bespoke-silicon-group/bsg_motherboards/t_rex/README.md

This is the new T-Rex PCI-E attached ASIC motherboard. It uses a Kintex Ultrascale+ FPGA as host and uses the UW BGA Package.

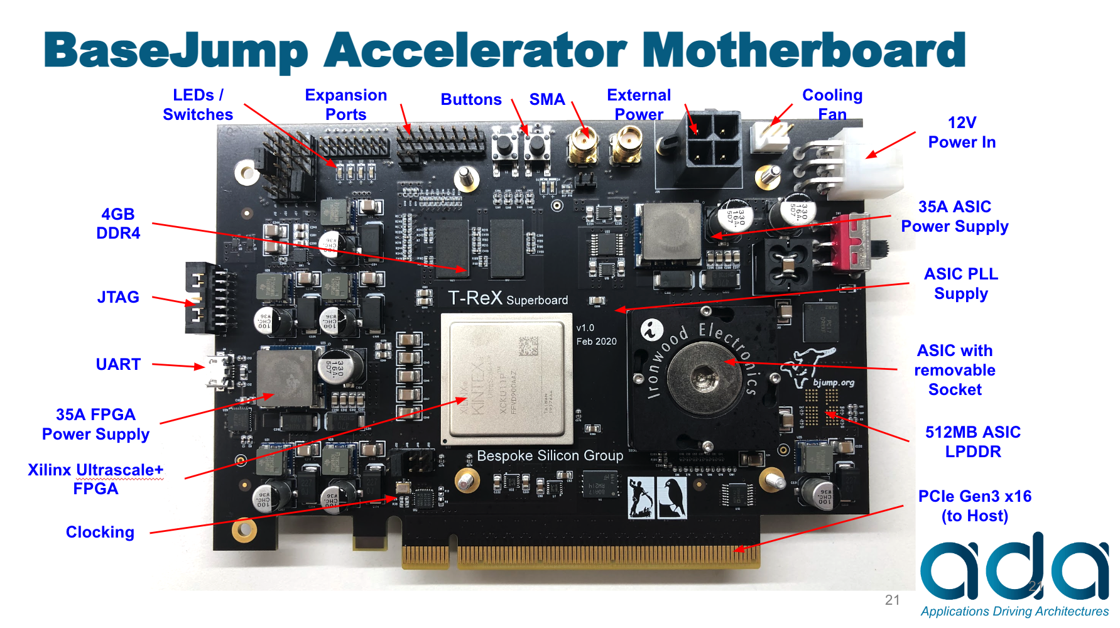
[picture p1: t_rex/t_rex_board.png]
T-Rex Board


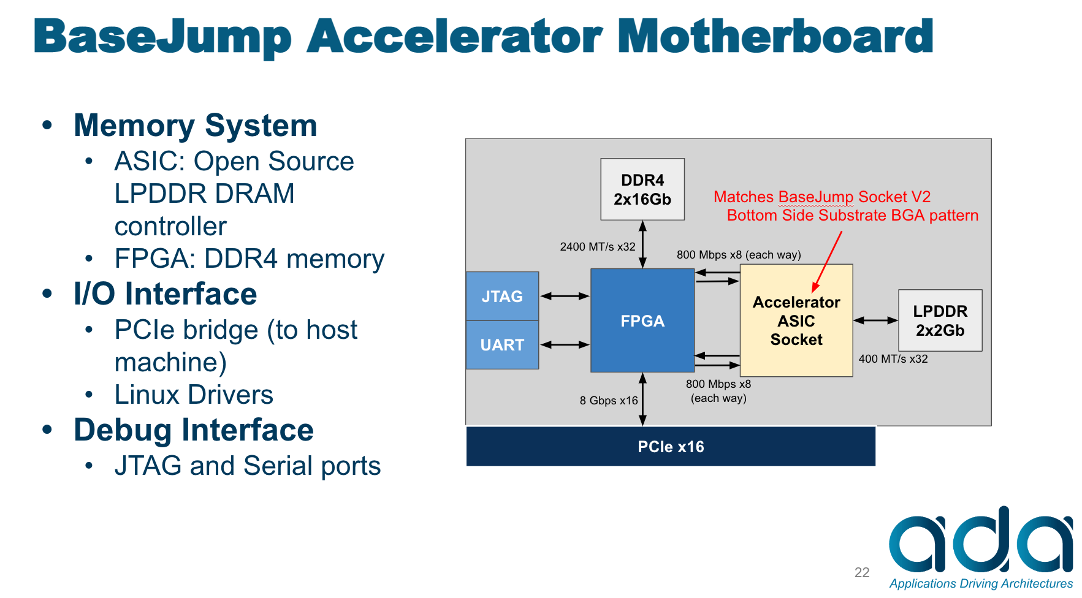
[picture p2: t_rex/t_rex_block_diagram.png]
T-Rex Block Diagram
