bespoke-silicon-group/bsg_motherboards/bsg_trouble/double_trouble/README.md

DoubleTrouble is a dual FPGA board, that allows you to emulate the RealTrouble FPGA board, which has an ASIC and Gateway FPGA, which was useful for debugging the I/O logic.

See [this link](https://docs.google.com/document/d/1EbtDtNUZuRYwq27lyGmmfNojYJZf2jZowkG6wCDKnSc/edit) for the DoubleTrouble design document.

See [this link](https://docs.google.com/spreadsheets/d/1v_qp4qbDF0bKDqPtvAs_vNdXaMVtJgvdCSDbODfMDFM/edit#gid=1929442910) for the DoubleTrouble Spartan-6 ballouts.

See [this link](https://docs.google.com/document/d/1Ep6X8bA8dowjrU25qXct05PboRLQDkasHA3pl3u8kH0/edit#heading=h.3fah60838dlg) for notes on firmware design.

See [this link](https://docs.google.com/document/d/1RrP9torYVqvp9zgF8nX2fYvYWnBSqGglMHzzH0_2e-s/edit#heading=h.7lagbxxd2hqg) for notes on bootstrapping the first board.

Two versions of the DoubleTrouble board were done. The first version used a 10-layer PCB and had some power integrity based limits on performance. The second version used a 14-layer PCB and optimized capacitor placement and had an improved stackup.

See [this link](https://github.com/bespoke-silicon-group/basejump_stl/issues/430) for some recent user's observations of making this board.
