bespoke-silicon-group/bsg_motherboards/bsg_trouble/super_trouble/pics/README.md

This is a picture of SuperTrouble V1, which implements Socket 352 that is mapped onto the DARPA CRAFT 600+ pin FC-BGA (flip chip BGA) package.
SuperTrouble V2 is a revision of V1, with a 30A power supply.
