bespoke-silicon-group/bsg_motherboards/t_rex/v1/misc_docs/README

1. The solder ball size information in PDF file is outdated, please refer to "New Ball Size.PNG" for the most up-to-date info. (Different IC-Frame is needed for new solder ball size)
2. The torque information in PDF file is outdated, please refer to "New Torque.png" for updated torque info.
