bespoke-silicon-group/bsg_motherboards/bsg_trouble/real_trouble/misc_docs/352_bga_pins_top_down_flat_Paul_Gao_updated.pdf

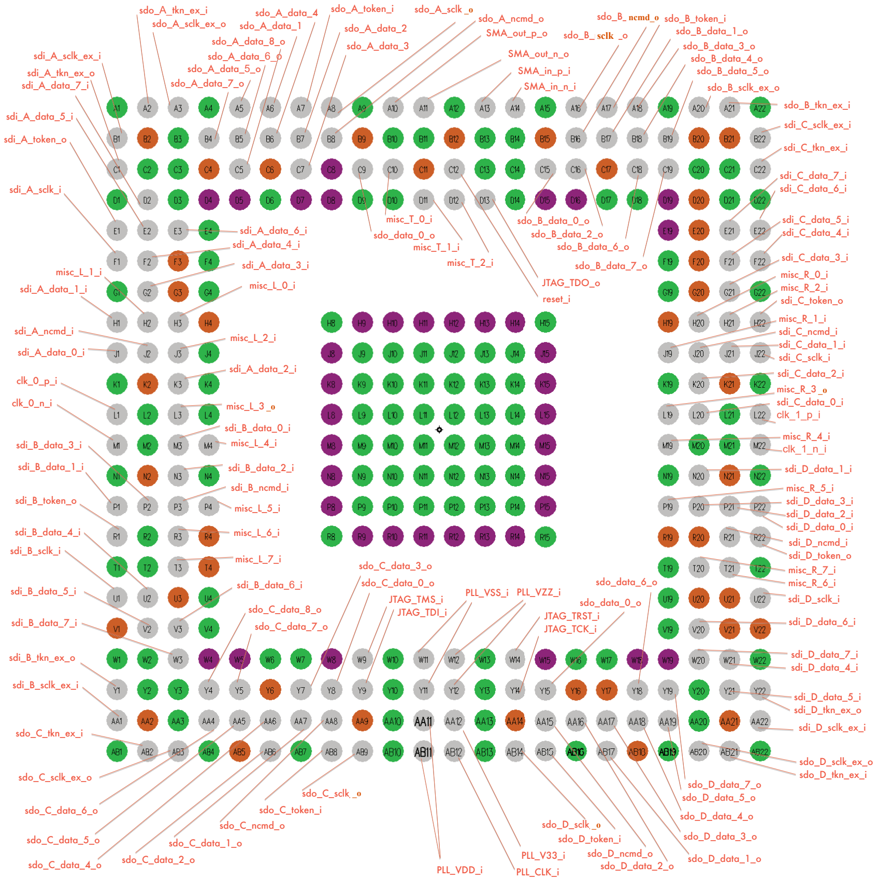
[picture p3: page 1]

sdo_B_tkn_ex_i
sdi_C_sclk_ex_i

sdi_C_tkn_ex_i

sdi_C_data_7_i
sdi_C_data_6_i

sdi_C_data_5_i
sdi_C_data_4_i

sdi_C_data_3_i
misc_R_0_i
misc_R_2_i
sdi_C_token_o
misc_R_1_i
sdi_C_ncmd_i
sdi_C_data_1_i
sdi_C_sclk_i
sdi_C_data_2_i
misc_R_3_i
sdi_C_data_0_i
clk_1_p_i

misc_R_4_i
clk_1_n_i
sdi_D_data_1_i
misc_R_5_i
sdi_D_data_3_i
sdi_D_data_2_i
sdi_D_data_0_i
sdi_D_ncmd_i
sdi_D_token_o
misc_R_7_i
misc_R_6_i
sdi_D_sclk_i

sdi_D_data_6_i

sdi_D_data_7_i
sdi_D_data_4_i

sdi_D_data_5_i
sdi_D_tkn_ex_o
sdi_D_sclk_ex_i

sdo_D_sclk_ex_o
sdo_D_tkn_ex_i

sdo_C_data_7_o

sdo_C_data_8_o

sdo_data_6_o
sdo_data_0_o
JTAG_TRST_i
JTAG_TCK_i

PLL_VSS_i PLL_VZZ_i JTAG_TMS_i JTAG_TDI_i

sdo_C_data_0_o

sdo_C_data_3_o

sdo_D_data_7_o
sdo_D_data_5_o

sdo_B_data_7_o

sdo_B_data_6_o

sdo_B_data_2_o

sdo_B_data_0_o

sdo_B_sclk_ex_o

sdo_B_data_3_o

sdo_B_data_5_o

sdo_B_data_4_o

sdo_B_data_1_o

sdo_B_token_i
sdo_B_ncmd_o

sdo_B_sclk_i

SMA_in_n_i

SMA_in_p_i

SMA_out_n_o

SMA_out_p_o

sdo_A_sclk_i
sdo_A_ncmd_o

sdo_A_token_i
sdo_A_data_2
sdo_A_data_3

sdo_A_data_4
sdo_A_data_1

sdo_A_data_6_o

sdo_A_data_8_o

sdo_A_data_5_o
sdo_A_data_7_o

sdo_A_sclk_ex_o

sdo_A_tkn_ex_i

JTAG_TDO_o
reset_i

misc_T_2_i

misc_T_1_i

misc_T_0_i
sdo_data_0_o

sdi_A_sclk_ex_i
sdi_A_tkn_ex_o
sdi_A_data_7_i

sdi_A_data_5_i

sdi_A_token_o

sdi_A_data_6_i
sdi_A_data_4_i

sdi_A_sclk_i

sdi_A_data_3_i

sdi_A_data_1_i

misc_L_1_i
misc_L_0_i

misc_L_2_i sdi_A_ncmd_i
sdi_A_data_0_i
sdi_A_data_2_i
clk_0_p_i
clk_0_n_i | misc_L_3_i
| misc_L_4_i

sdi_B_data_0_i

sdi_B_data_2_i

sdi_B_data_3_i

sdi_B_data_1_i
sdi_B_ncmd_i
misc_L_5_i sdi_B_token_o

misc_L_6_i
misc_L_7_i sdi_B_sclk_i

sdi_B_data_4_i

sdi_B_data_5_i | sdi_B_data_6_i

sdi_B_data_7_i

sdi_B_tkn_ex_o

sdi_B_sclk_ex_i

sdo_C_tkn_ex_i

sdo_C_sclk_ex_o

sdo_C_data_6_o

sdo_C_data_5_o
sdo_C_data_4_o sdo_C_data_2_o sdo_C_data_1_o

sdo_C_ncmd_o

sdo_C_token_i

sdo_C_sclk_i

sdo_D_data_4_o
sdo_D_data_3_o

sdo_D_data_1_o sdo_D_data_2_o

sdo_D_ncmd_o

sdo_D_token_i

sdo_D_sclk_i

PLL_CLK_i

PLL_V33_i
PLL_VDD_i
