bespoke-silicon-group/bsg_motherboards/bsg_trouble/double_trouble/pics/DoubleTroubleV1.2_crop.jpg

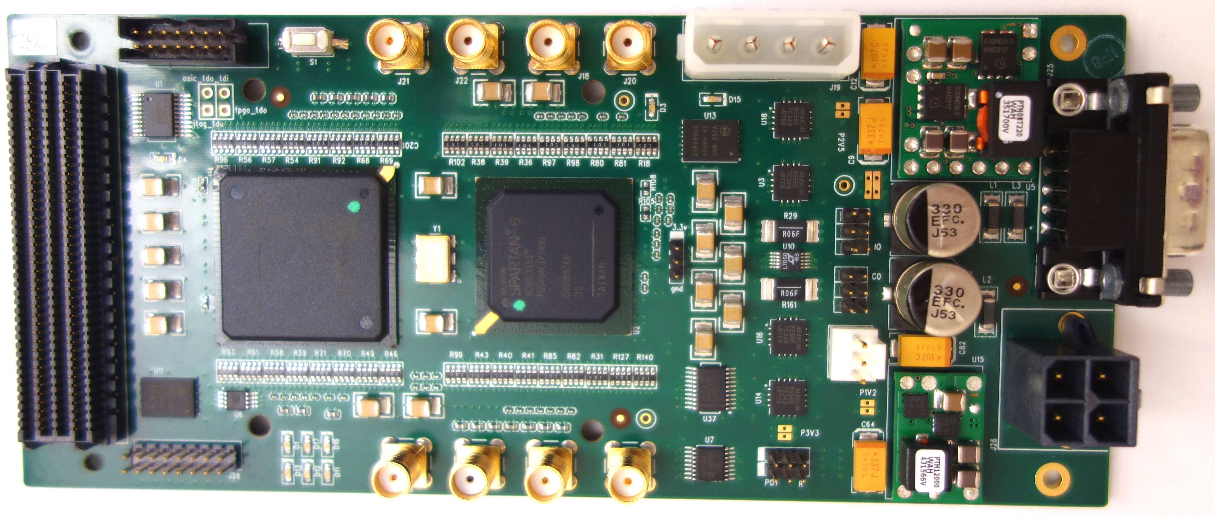
bsg_trouble/double_trouble/pics/DoubleTroubleV1.2_crop.jpg
