bespoke-silicon-group/bsg_motherboards/bsg_trouble/double_trouble/pics/IMG_20151016_153808970_HDR.jpg

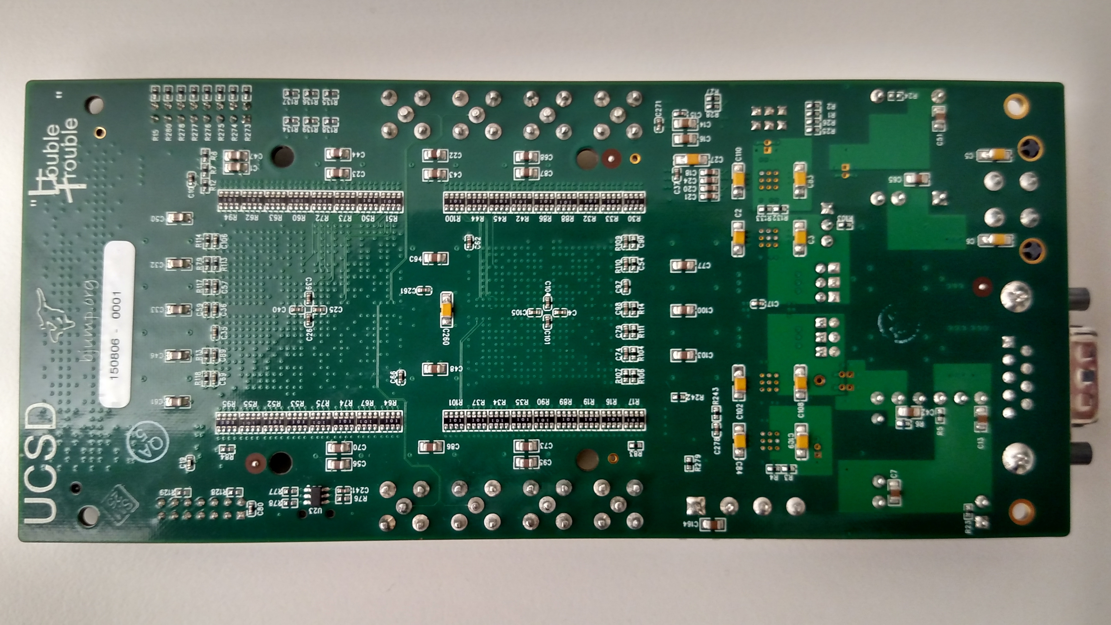
bsg_trouble/double_trouble/pics/IMG_20151016_153808970_HDR.jpg
