bespoke-silicon-group/bsg_motherboards/bsg_trouble/real_trouble/pics/real_trouble_board.jpg

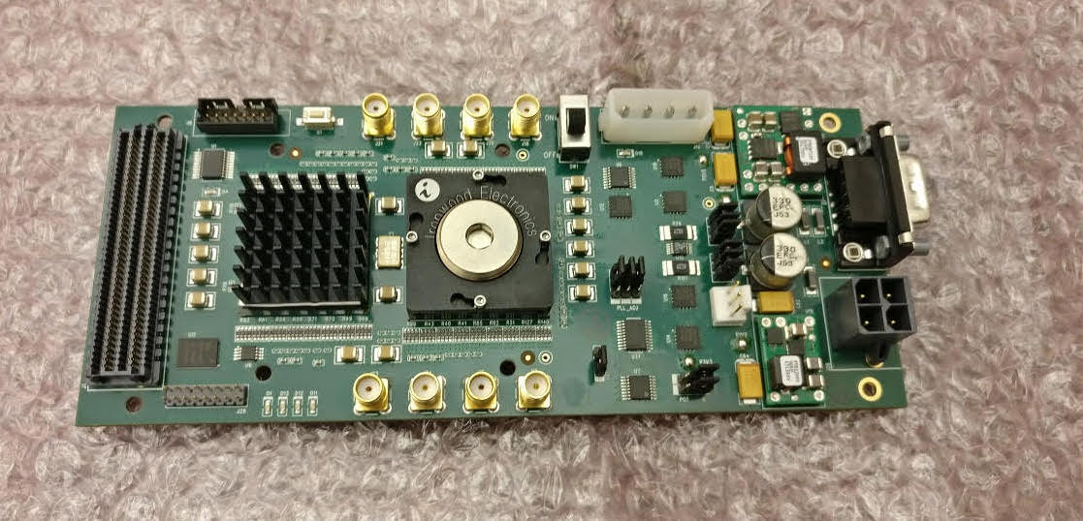
bsg_trouble/real_trouble/pics/real_trouble_board.jpg
