bespoke-silicon-group/bsg_motherboards/bsg_trouble/super_trouble/pics/IMG_20180105_175012.jpg

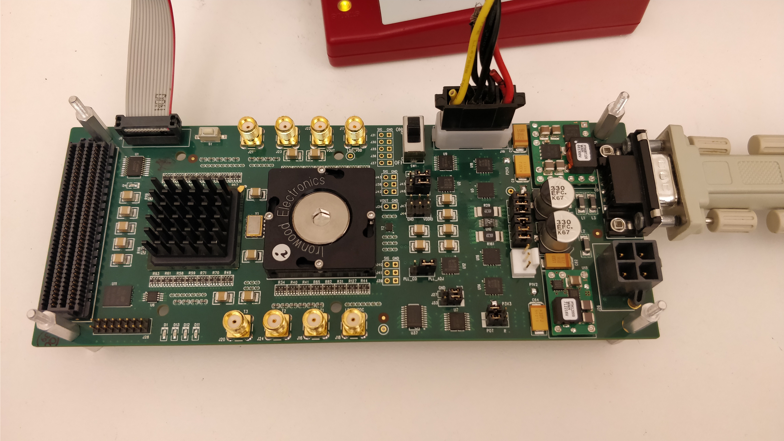
bsg_trouble/super_trouble/pics/IMG_20180105_175012.jpg
