bespoke-silicon-group/bsg_motherboards/t_rex/v1/misc_docs/New Ball Size.PNG

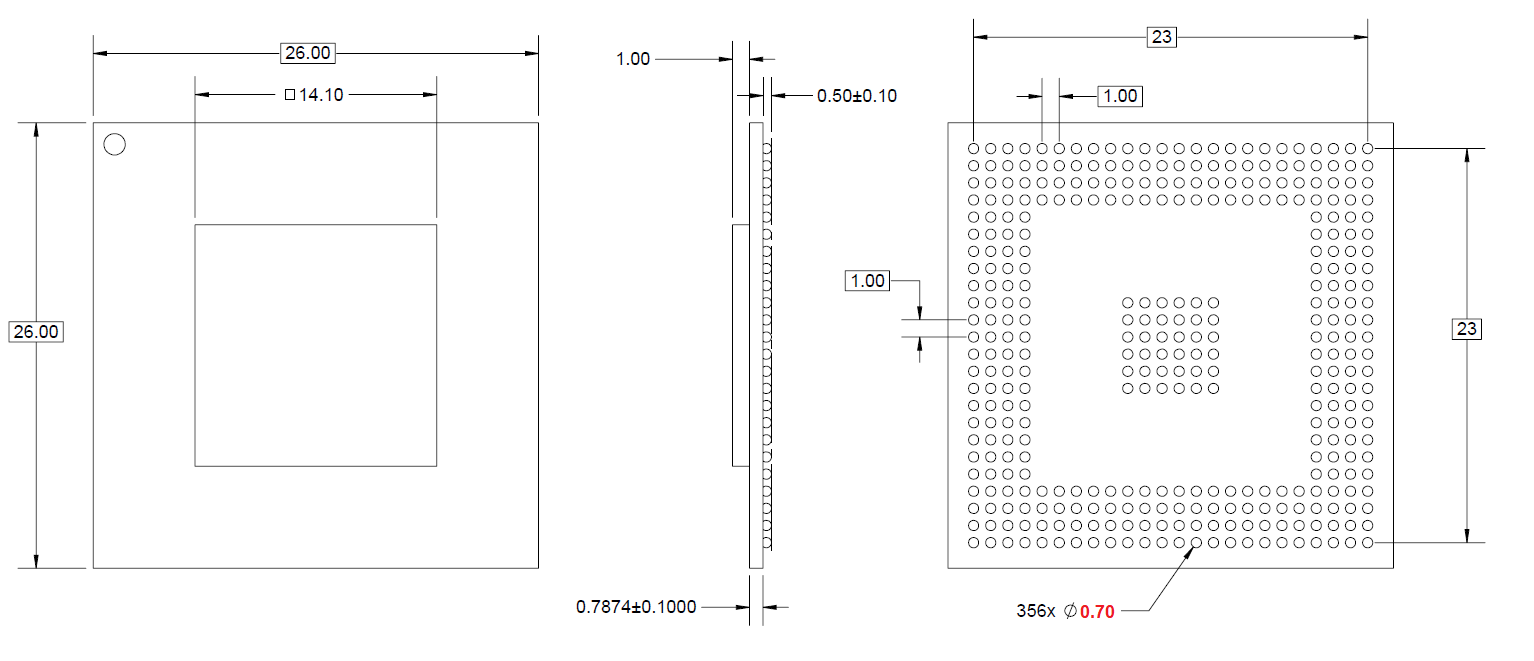
t_rex/v1/misc_docs/New Ball Size.PNG
