bespoke-silicon-group/bsg_motherboards/t_rex/v1/misc_docs/New Torque.png

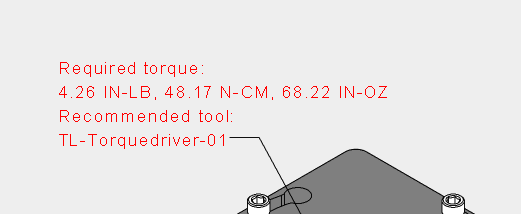
t_rex/v1/misc_docs/New Torque.png
