bespoke-silicon-group/bsg_motherboards/t_rex/v1/pcb_development/pcb_fabrication/pcie finger mechanical.PNG

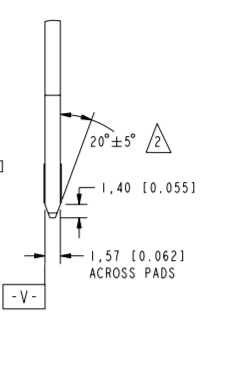
t_rex/v1/pcb_development/pcb_fabrication/pcie finger mechanical.PNG
