bespoke-silicon-group/bsg_motherboards/t_rex/v1/pcb_development/pcb_fabrication/IMPEDANCE.xlsx

Layer Name | Ref Layer Name | Diff or single-ended | Trace Width (mil) | Number of Single Traces | Number of Diff Pairs | Target Value (ohm +-10%) | Single-ended clearance (mil) | Diff Spacing (mil)
Layer 1 (top) | Layer 2 (GND) | diff (Gold Finger) | 4.94 |  | 16 | 85 |  | 7
Layer 3 | Layer 2 and Layer 4 (GND and GND) | single | 3.97 | 44 |  | 50 | 6
 |  |  | 5.97 | 25 |  | 39 | 8
 |  |  | 6.47 | 8 |  | 36 | 9
 |  | diff | 3.94 |  | 17 | 86 |  | 4
 |  |  | 4.94 |  | 17 | 85 |  | 7
 |  |  | 5.94 |  | 0 | 76 |  | 6
Layer 5 | Layer 4 and Layer 6 (GND and GND) | single | 3.97 | 46 |  | 50 | 6
 |  |  | 5.97 | 16 |  | 39 | 8
 |  |  | 6.47 | 7 |  | 36 | 9
 |  | diff | 3.94 |  | 2 | 100 |  | 6
 |  |  | 3.94 |  | 0 | 86 |  | 4
 |  |  | 4.94 |  | 0 | 85 |  | 7
 |  |  | 5.94 |  | 1 | 76 |  | 6
Layer 10 | Layer 9 and Layer 11 (GND and GND) | single | 3.97 | 59 |  | 50 | 6
 |  |  | 5.97 | 16 |  | 39 | 8
 |  |  | 6.47 | 7 |  | 36 | 9
 |  | diff | 3.94 |  | 21 | 86 |  | 4
 |  |  | 4.94 |  | 16 | 85 |  | 7
 |  |  | 5.94 |  | 2 | 76 |  | 6
Layer 12 | Layer 11 and Layer 13 (GND and GND) | single | 3.97 | 44 |  | 50 | 6
 |  |  | 5.97 | 5 |  | 39 | 8
 |  |  | 6.47 | 6 |  | 36 | 9
 |  | diff | 3.94 |  | 1 | 100 |  | 6
 |  |  | 3.94 |  | 2 | 86 |  | 4
 |  |  | 4.94 |  | 0 | 85 |  | 7
 |  |  | 5.94 |  | 3 | 76 |  | 6
Layer 14 (bot) | Layer 13 (GND) | diff (Gold Finger) | 4.94 |  | 17 | 85 |  | 7
Single Ended Traces |  |  | Total Single | 283
3.97 mil | 50 ohm +-10% |  | Total 50 ohm | 193
5.97 mil | 39 ohm +-10% |  | Total 39 ohm | 62
6.47 mil | 36 ohm +-10% |  | Total 36 ohm | 28
Differential Pairs |  |  | Total Diff Pairs |  | 115
3.94/6/3.94 | 100 ohm +-10% |  | Total 100 ohm |  | 3
3.94/4/3.94 | 86 ohm +-10% |  | Total 86 ohm |  | 40
4.94 mil | 85 ohm +-10% |  | Total 85 ohm |  | 66
5.94 mil | 76 ohm +-10% |  | Total 76 ohm |  | 6
