bespoke-silicon-group/bsg_motherboards/(threads)

Thread 1 (2021-07-12):

Logic/Schematics files for Altium

yunusdawji, 2021-07-12:
Hi,

I am trying to import the schematics for double trouble. I was able to import ASC file in altium but I cannot import the schematic. Would you be able to share the schematic file form mentor pads with us?

Thanks

gaozihou, 2021-07-12:
Does this work for Altium import? https://github.com/bespoke-silicon-group/bsg_motherboards/blob/master/bsg_trouble/double_trouble/pcb_development/pcb_design/DaughterBoards_2016.sch

yunusdawji, 2021-07-12:
Hi Paul,

Thanks for reply. I am trying to import it to Altium and it only accepts .txt logic file for mentor pads. Is there a different way to export logical files in Mentor graphics pads?

Yunus

gaozihou, 2021-07-13:
Thanks Yunus! Interesting that Altium only accepts txt format..

I added the txt here: https://github.com/bespoke-silicon-group/bsg_motherboards/blob/master/bsg_trouble/double_trouble/pcb_development/pcb_design/DaughterBoards_2016.txt

Closed 2021-07-13.

Thread 2 (2021-08-06):

RealTrouble U8 not listed in BOM (Ironwood Socket for ASIC), flash chip, and C27 Q.

cmcjames, 2021-08-06:
Hello,

**Question 1-**
We are basing our design on RealTrouble and while socket U8 is shown in the schematic page 2 of 18, bottom right, I do not see it in the Bill of Materials.  Our die and package is based on BSG_332.

What is the Ironwood part number for the socket?
Do we need any special permission from BaseJump to have Ironwood manufacture the socket for us?

**I see this picture for the ASIC pins, a 22x22 array**:
_https://github.com/bespoke-silicon-group/bsg_packaging/blob/master/ucsd_bga_332/pcb/352_bga_pins_top_down_flat.pdf_
and I can’t find the Ironwood socket to match. **I only see this Ironwood SG-BGA676 socket, which is 26x26pins**.
_https://raw.githubusercontent.com/bespoke-silicon-group/bsg_motherboards/master/bsg_trouble/super_trouble_v2/misc_docs/C17099%20Dwg.pdf_

I assume the 26x26 pin socket is not for the 22x22 pin ASIC array.

Question 2-
We need to substitute the flash chip. The original chip is: M25P128-VME6TGB and thank you for recommending to my colleague for the DT board MT25QL128ABA1EW9-0SIT.  The first is obsolete and the second is now out of stock. I’ve asked Micron, but they haven’t returned my request for a replacement part number.
Assuming I require the following characteristics: _NOR-Flash, 128Mb as 16Mx8, SPI interface, 2.7-3.6V, surface mount, in-stock, ROHS, (original F=54MHz, original write cycle time: 15ms, 5ms)_, it seems there aren’t any Micron parts. There are parts from  _Macronix_, I do not know if their parts are fully compatible. We can handle a footprint change at this time, but we are hoping we won’t need to change the gateway FPGA code. The Macronix parts in stock that fit the bill are: MX25L12835FM2I-10G, MX25L12835FMI-10G, MX25L12835FZNI-10G and links to each of those come up in [this digikey search](https://www.digikey.ca/en/products/filter/memory/774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). _Would you recommend any one of those?_

Question 3 (out of curiosity)-
C27 is a 10UF tantalum capacitor in parallel with C37 a 0.1UF capacitor by the serial port’s MAX322EEUP. The MAX322 datasheet requires the 0.1UF capacitor and nothing more.  What is the reason the team decided to include a large tantalum capacitor as well?

Question 4: What is the proper way to acknowledge the BSG group?  (sorry, I don't see a group for this topic!)

taylor-bsg, 2021-08-07:
Ironwood:

https://github.com/bespoke-silicon-group/bsg_packaging/tree/master/ucsd_bga_332/pcb/for_socket_maker_ironwood
part number is C16459

taylor-bsg, 2021-08-07:
@gaozihou may be able to answer #2 and #3

#4: "Our system employs the BaseJump Socket 332, BaseJump RealTrouble motherboard, and firmware, designed by the UW Bespoke Silicon Group, available at http://bjump.org."

gaozihou, 2021-08-08:
Hi @cmcjames,

Q1. More information can be found here: https://github.com/bespoke-silicon-group/bsg_motherboards/blob/master/bsg_trouble/real_trouble/misc_docs/C16459_PCB%20Layout.PDF

Q2. The real question is "which NOR flash devices can be indirectly programmed by the iMPACT tool through a Spartan-6 device". You could refer to the Xilinx Q&A: https://www.xilinx.com/support/answers/70681.html (also mentioned here: https://github.com/bespoke-silicon-group/basejump_stl/issues/430). From my understanding, Macronix would work but it does not have as much software support (iMPACT tool) as Micron devices. In general I would suggest continue using Micron chips to make flash programming process simpler.

I understand it is hard to find chips in stock due to the global chip shortage.. I found this on digikey which should be a proper replacement: https://www.digikey.com/en/products/detail/micron-technology-inc/N25Q128A13EF840E/13167381

Q3. I guess it is just a conservative design to ensure VDD is clean.

cmcjames, 2021-08-09:
Thank you very much everyone for your timely response!  It's much appreciated!
I'll have to place our Ironwood and Digikey orders soon.
Regarding Q2: Macronix got back to me with some replacement parts. They do mention challenges with respect to programming with the Xilinx iMPACT tools and they have provided some suggestions to make things work.  The link provided didn't work for me, but a search on a subset of the part number did, it seems a Digikey marketplace reseller, _Flip Electronics_, has that particular replacement in stock so thank you very much!

Closed 2021-08-09.

Thread 5 (2022-02-22):

Real Trouble Through-Hole Plating

abeyene, 2022-02-22:
Hi,

I've received a query from my PCB manufacturer about whether a particular through-hole on Real Trouble is plated or not. A copper pad exists in the copper layer but a table description for the symbol describes the hole as non-plated (see the below photo). Which is correct? Thanks.

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

taylor-bsg, 2022-02-23:
@gaozihou

gaozihou, 2022-02-23:
@abeyene Thanks for your question!
This should be a **plated** through hole (PTH), so the **table is incorrect**..
Sorry for the inconvenience caused!

cmcjames, 2022-02-23:
Paul-

  Isn’t that the FMC connector’s keying hole?

    The SAMTEC datasheet’s recommended PCB layout section for an FMC connector shows the keying hole as 50 [1.27] NPTH.
    In the VITA 57.1 standard “Rule 3.25: All keying holes shall remain electrically isolated from the mezzanine module’s circuit ground.”

  I assume it doesn’t matter as the key is likely some kind of plastic.

  What is the reasoning for it being a PTH?  Am I missing something?

-james

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

gaozihou, 2022-02-23:
Thanks @cmcjames!

Yes you are right, Samtec datasheet suggests 1.27 NPTH for those keying holes, so it is totally fine to go with NPTH.

I suggested PTH because

gaozihou, 2022-02-23:
Thanks @cmcjames!

Yes you are right, Samtec datasheet suggests 1.27 NPTH for those keying holes, so it is totally fine to go with NPTH.

I suggested PTH because
- We used PTH in last fabrication and it worked..
- It matches the plated keying hole on the other side of the FMC..
- For most manufactures the 1.27 diameter is finished size, so the FMC key will fit in the plated hole

Again sorry for the confusions caused!

cmcjames, 2022-02-23:
Thank you.  No worries!

-james.

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

abeyene, 2022-02-24:
Thanks for the clarification @gaozihou @taylor-bsg

Closed 2023-02-21.

Thread 7 (2022-03-03):

Real Trouble Connector J1

abeyene, 2022-03-03:
Hi @gaozihou @taylor-bsg,

I received an inquiry from Sierra today about connector J1. It seems like there are
two parts listed for it in the BOM:

i) Under description you list ASP-134488-01 (400 positions)
ii) Under Part Number and Digikey Part Number you list ASP-134604-01 (160 positions)

There are 400 pads in the gerber so I assume the first (ASP-134488-01) is the correct part. But
after looking at the [picture](https://github.com/bespoke-silicon-group/bsg_motherboards/blob/master/bsg_trouble/real_trouble/pics/real_trouble_board.jpg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) that's posted, I'm not 100% sure.

Could you clarify?

Thanks,

Abel

gaozihou, 2022-03-03:
@abeyene,

Both ASP-134488-01 and ASP-134604-01 will function the same. The [schematic](https://github.com/bespoke-silicon-group/bsg_motherboards/blob/master/bsg_trouble/real_trouble/pcb_development/pcb_design/RealTrouble_2016_BW.pdf) shows that only LPC pins are used, all HPC pins are floating.

Normally we would install the LPC part to lower the cost. There is no harm to install the HPC one.

abeyene, 2022-03-03:
I see. O.k.

Thanks for the quick response.

Closed 2022-03-03.

Thread 8 (2022-04-02):

Real Trouble Firmware for 3.3 V

yunusdawji, 2022-04-02:
Hi Prof Taylor,

We have received our real trouble and packaged chips. I was wondering which firmware do I have to load for 3.3V I/Os for real trouble? We are using BGA 332 package.

Yunus

taylor-bsg, 2022-04-03:
@gaozihou

gaozihou, 2022-04-03:
Hi @yunusdawji,

Thanks for your question. Indeed I/O and CORE voltages are programmed by software, voltage values can be stored in NVMs on board so that you only need to program once. Here is the link to the example software: https://github.com/bespoke-silicon-group/bsg_motherboards/tree/master/bsg_trouble/real_trouble/software/trouble_master

I'd suggest programming the voltages without packaged chip installed, in case the output voltages are higher than expected.

yunusdawji, 2022-04-03:
Hi Paul,

Thanks for the reply. I want firmware for 3.3 V version gateway. Currently the fdc under firmware for realtrouble folder has LVCMOS18.

I want something like this firmware for gateway but that was configured to provide io and core clock from gateway.

https://bitbucket.org/taylor-bsg/bsg_fpga/src/Real_Trouble_Working/

We tried to use the firmware under https://github.com/bespoke-silicon-group/bsg_motherboards/tree/master/bsg_trouble/real_trouble/firmware/common/bsg_gateway_outerspace with this fdc https://bitbucket.org/taylor-bsg/bsg_fpga/src/Real_Trouble_Working/ip/bsg_gateway/bsg_two_real_trouble_gateway/fdc/bsg_gateway.fdc.
We did this as the firmware in github repo provides clock from gateway to asic.

But so far we have had no luck with running helloworld on our ASIC

Anytips on how we can debug? Currently our chip is consuming about 2mA for core and 350mA for IO.

Yunus

gaozihou, 2022-04-04:
Hi @yunusdawji, thanks for your detailed explanation!

Some debug tips:
1. Your core consumption is 2mA, which means the core clock not oscillating or the ASIC is not configured to use the external clock. (most likely the latter reason)
2. Your IO consumption is 350mA, which is lower than normal. There are about 88 termination resistors on board, each of them has 100+100=200 ohm. Currently each one consume 350/88=3.977mA, by Ohm's law the IO voltage is 795mV. I'd suggest double check the IO voltage (maybe also core voltage) before proceeding to the FPGA firmware.

gaozihou, 2022-04-04:
@yunusdawji In terms of the FPGA firmware:

1. In general, we need FPGA firmware that is compatible with the specific ASIC, not only LVCMOS33, but also the internal logic. For example, bsg_gateway_outerspace firmware enables 1x comm-link channels, while the fdc file you grabbed from Bitbucket assumes 4x comm-link channels, so I think it will not work. I guess the high-level question is, what kind of IO communication channels do you have on the ASIC? Did you use bsg_tag on-chip? Which version (commit) of basejump_stl library did you use on the ASIC?
2. After figuring out what we are communicating with, we could modify one of the current firmware to be compatible with the ASIC. We could slow down the IO/Core clock speed, reconfigure the IO interface, setting up bsg_tag... I guess bsg_gateway_outerspace may or may not be a good baseline, depending on the actual ASIC design.
3. If you have on-ASIC clock generator(s), the clocks are configured by the [trace file](https://github.com/bespoke-silicon-group/bsg_motherboards/blob/master/bsg_trouble/real_trouble/firmware/common/bsg_gateway_outerspace/trace/bsg_gateway_trace.txt). We could also configure it to bypass the on-chip clock and use the external clock (from gateway FPGA).
4. After all the modifications we could update the FDC constraints accordingly.

Let me know if you have more questions!

yunusdawji, 2022-04-06:
Hi Gao,

Sorry for late reply. I have been tied with my internship

Question: Your core consumption is 2mA, which means the core clock is not oscillating or the ASIC is not configured to use the external clock. (most likely the latter reason)

Answer: To give you some background, we have implement bsg bison with our bioinformatics accelerator. The clock is external only. So far from the FDC it looks like its configured properly on gateway. I think this 2mA because the reset to the core is not asserted until the bsg comm link is not calibrated. We were using the SERDES version of firmware which might not be matching the bsg comm link on chip. What do you think of this?

Question: Your IO consumption is 350mA, which is lower than normal. There are about 128 termination resistors on board, each of them has 100+100=200 ohm. Currently each one consume 350/128=2.734mA, by Ohm's law the IO voltage is 546mV. I'd suggest double check the IO voltage output (maybe also core voltage) before proceeding to the FPGA firmware.

Answer: This was the measurement from the troublemaster. The actual power consumption is about 12W (1A from 12V power supply). This is very similar to what we see in doubletrouble.

Question: In general, we need FPGA firmware that is compatible with the specific ASIC, not only LVCMOS33, but also the internal logic. For example, bsg_gateway_outerspace firmware enables 1x comm-link channels, while the fdc file you grabbed from Bitbucket assumes 4x comm-link channels, so I think it will not work. I guess the high-level question is, what kind of IO communication channels do you have on the ASIC? Did you use bsg_tag on-chip? Which version (commit) of basejump_stl library did you use on the ASIC? After figuring out what we are communicating with, we could modify one of the current firmware to be compatible with the ASIC. We could slow down the IO/Core clock speed, reconfigure the IO interface, setting up bsg_tag... I guess bsg_gateway_outerspace may or may not be a good baseline, depending on the actual ASIC design.

Answer: We have use this version of bsg_chip. I dont think it has bsg_tag but the chip is using external clock. As u can see the reset to most of the core logic comes from core_calib_done_r_lo
https://bitbucket.org/taylor-bsg/bsg_designs/src/master/toplevels/bsg_two_bison_accum/v/bsg_chip.v

Also in bsg_chip this is flipped ACBD, do you know why? Will I have to make the corresponding changes to bsg_comm_link on gateway side?
assign sdi_data_i_int_packed = {sdi_D_data_i_int, sdi_B_data_i_int, sdi_C_data_i_int, sdi_A_data_i_int};

I think bsg_two_gateway ip here will be a good match for our ASIC. Do you think it can work with bsg_bison?
https://bitbucket.org/taylor-bsg/bsg_fpga/src/Real_Trouble_Working/ip/bsg_gateway/bsg_two_gateway/

Thanks for all your help

Yunus

yunusdawji, 2022-04-16:
Hi

@gaozihou @taylor-bsg Thanks a lot for the help through out the process. Our chip works, I had to change the firmware somewhat to get it to work. Here are the pics of board and the chip
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

taylor-bsg, 2022-10-11:
Wow!!!!!! Nice job Yunus! Congratulations :-) 🎉🎊🍾

On Fri, Apr 15, 2022 at 7:29 PM Yunus Dawji ***@***.***>
wrote:

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
