bespoke-silicon-group/bsg_motherboards/t_rex/v1/pcb_development/pcb_design/bot.pdf

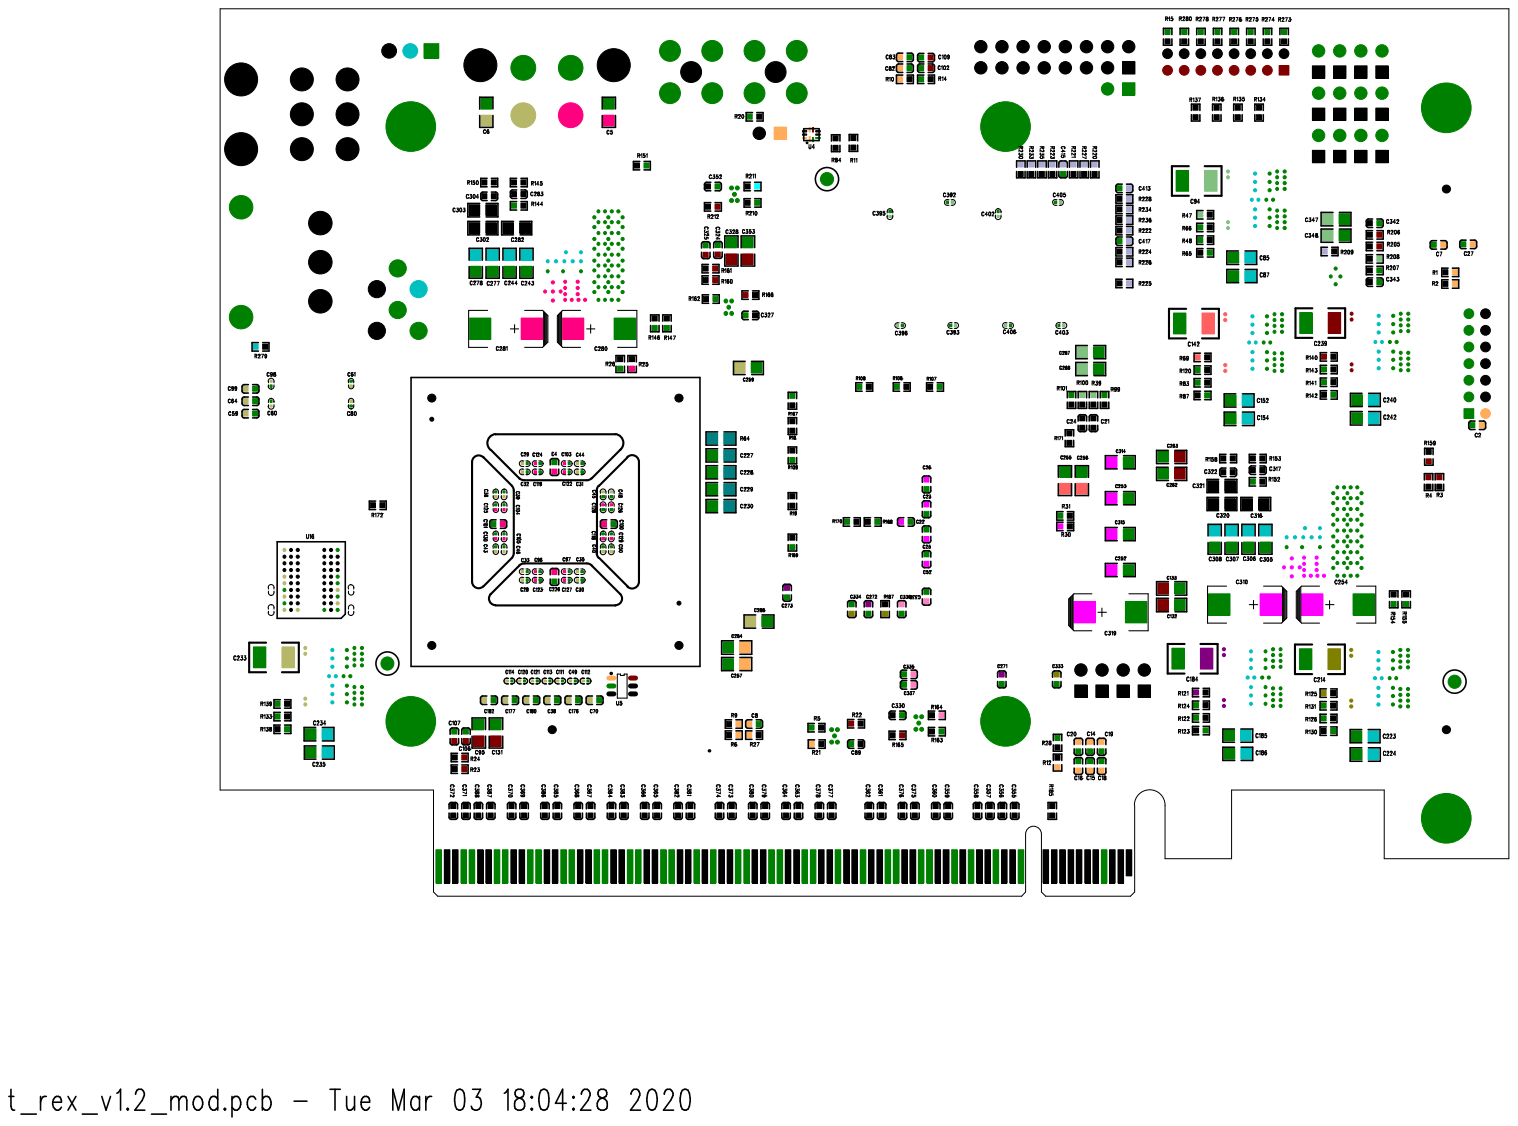
[picture p12: page 1]
