bespoke-silicon-group/bsg_motherboards/t_rex/v1/pcb_development/pcb_design/schematic_20200224.pdf

8 | 6 | 5 | 4 | 3 | 2 | 1

D

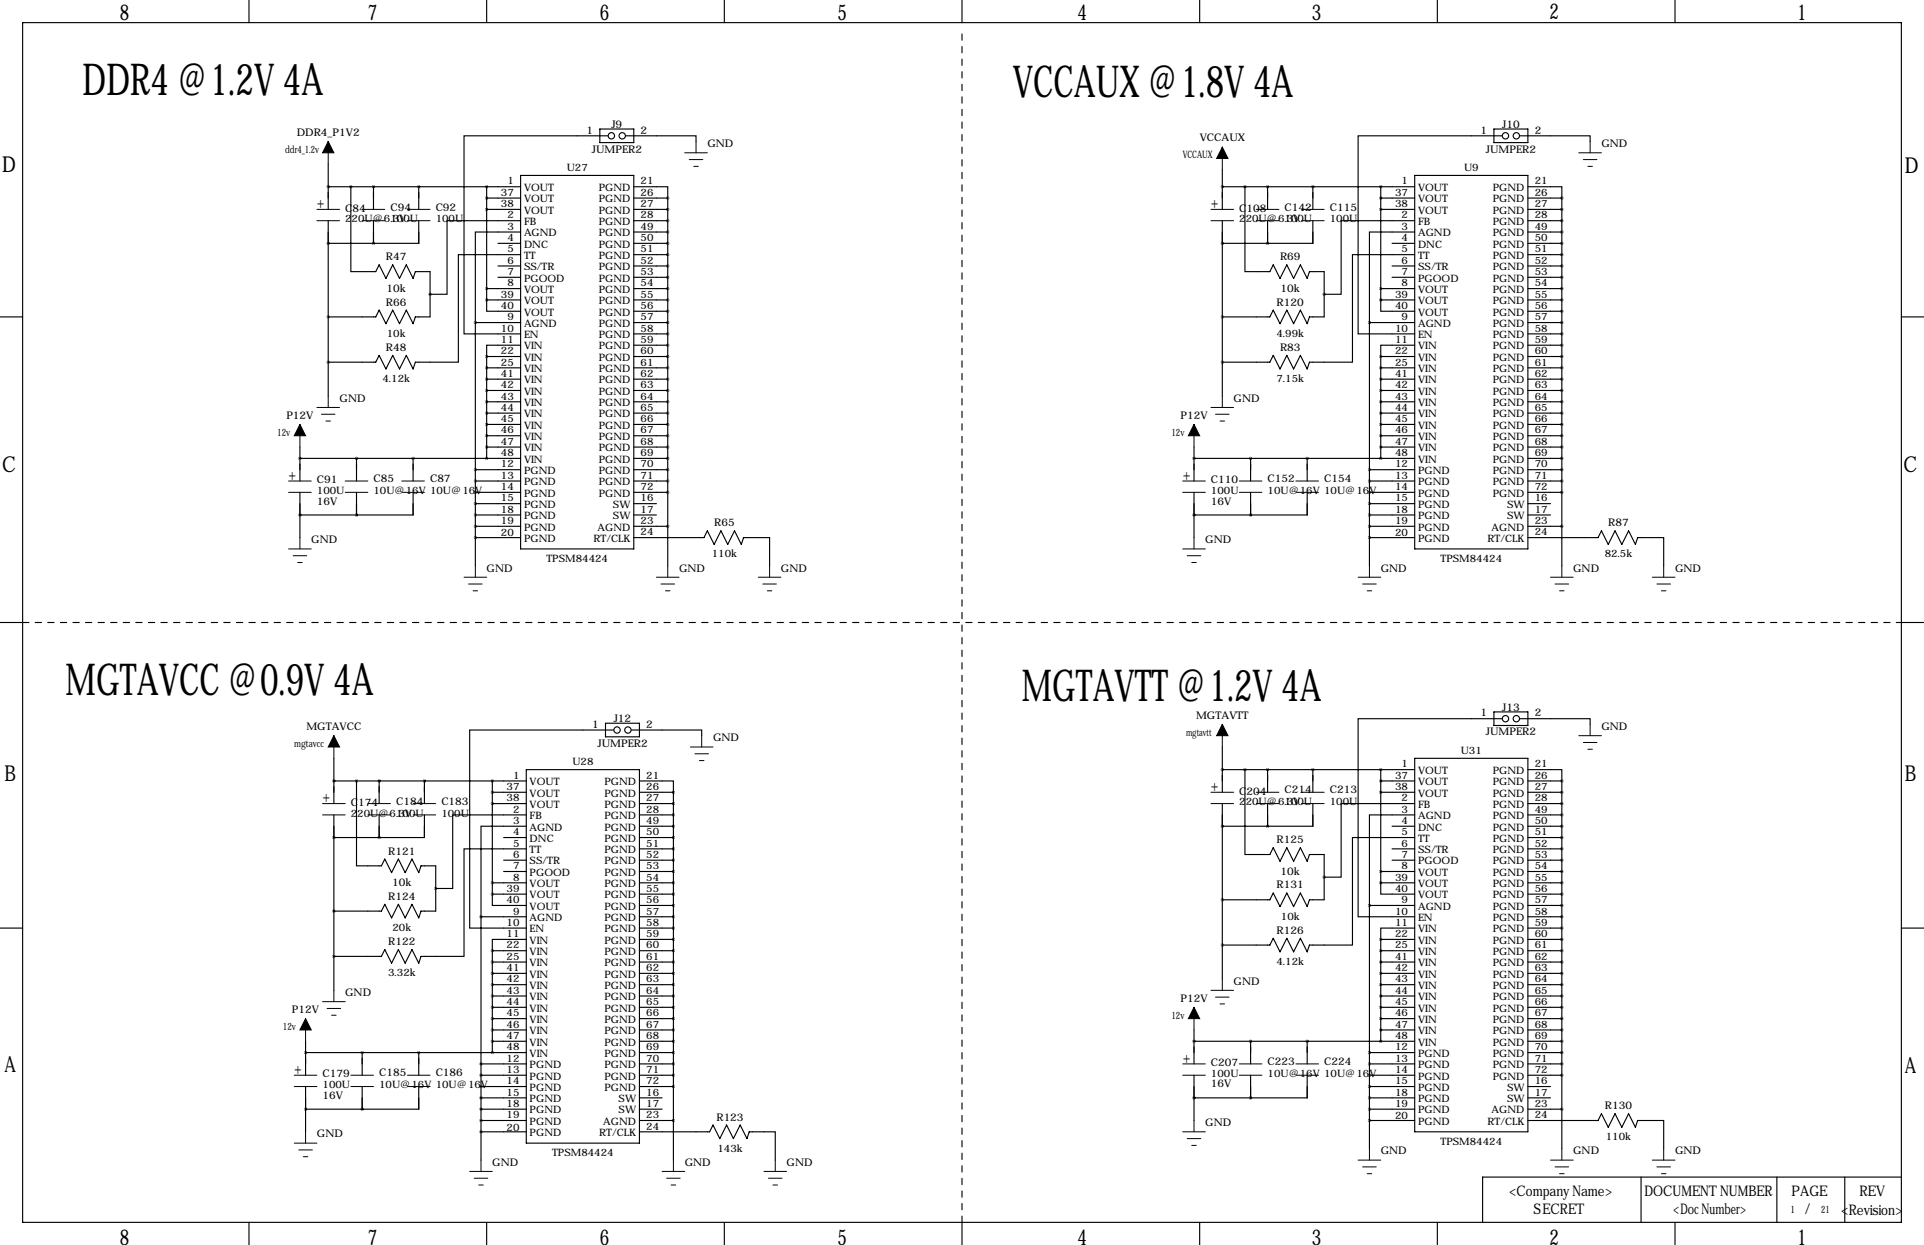
[picture p13: page 1]

D
D

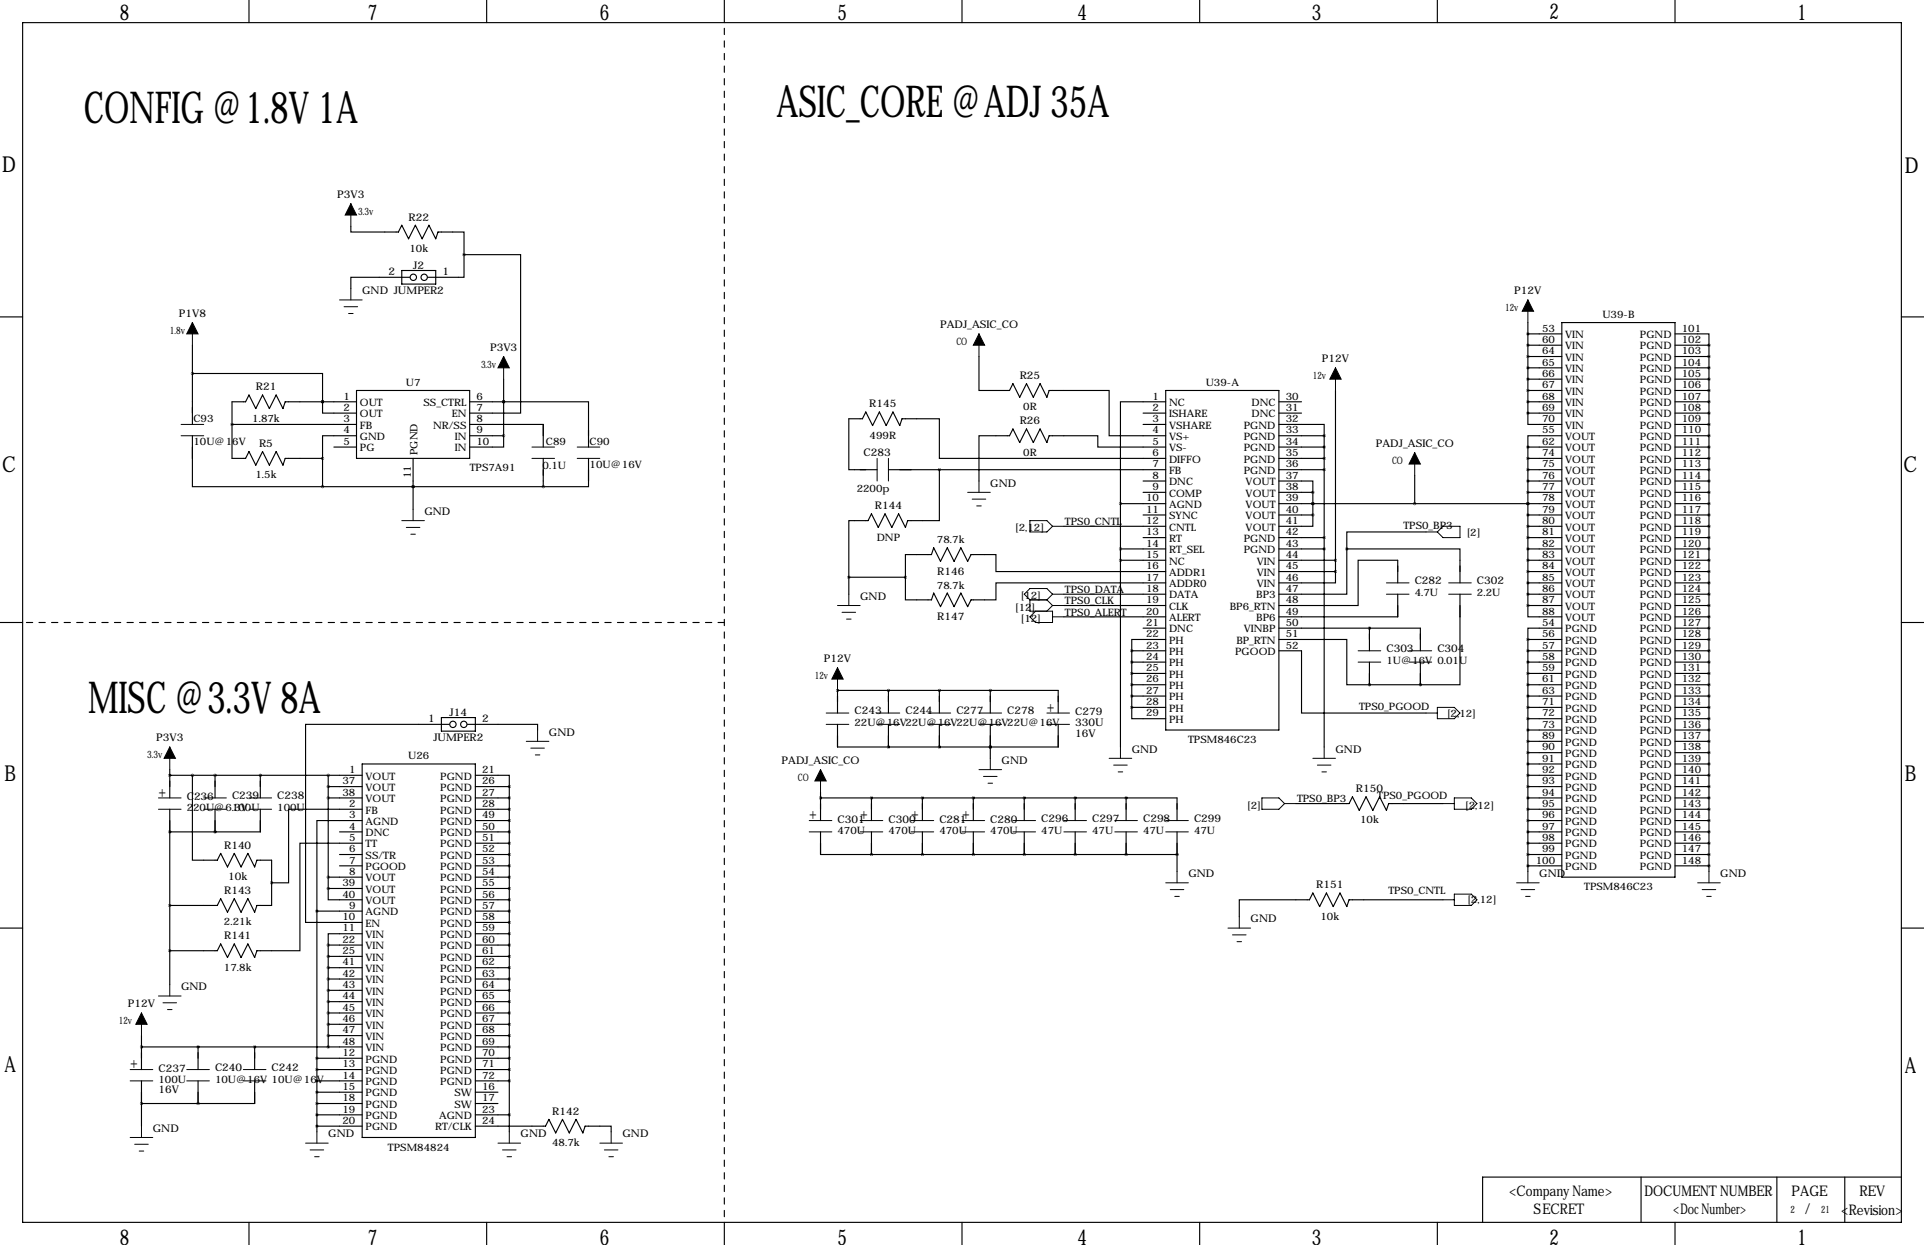
[picture p14: page 2]

D
D

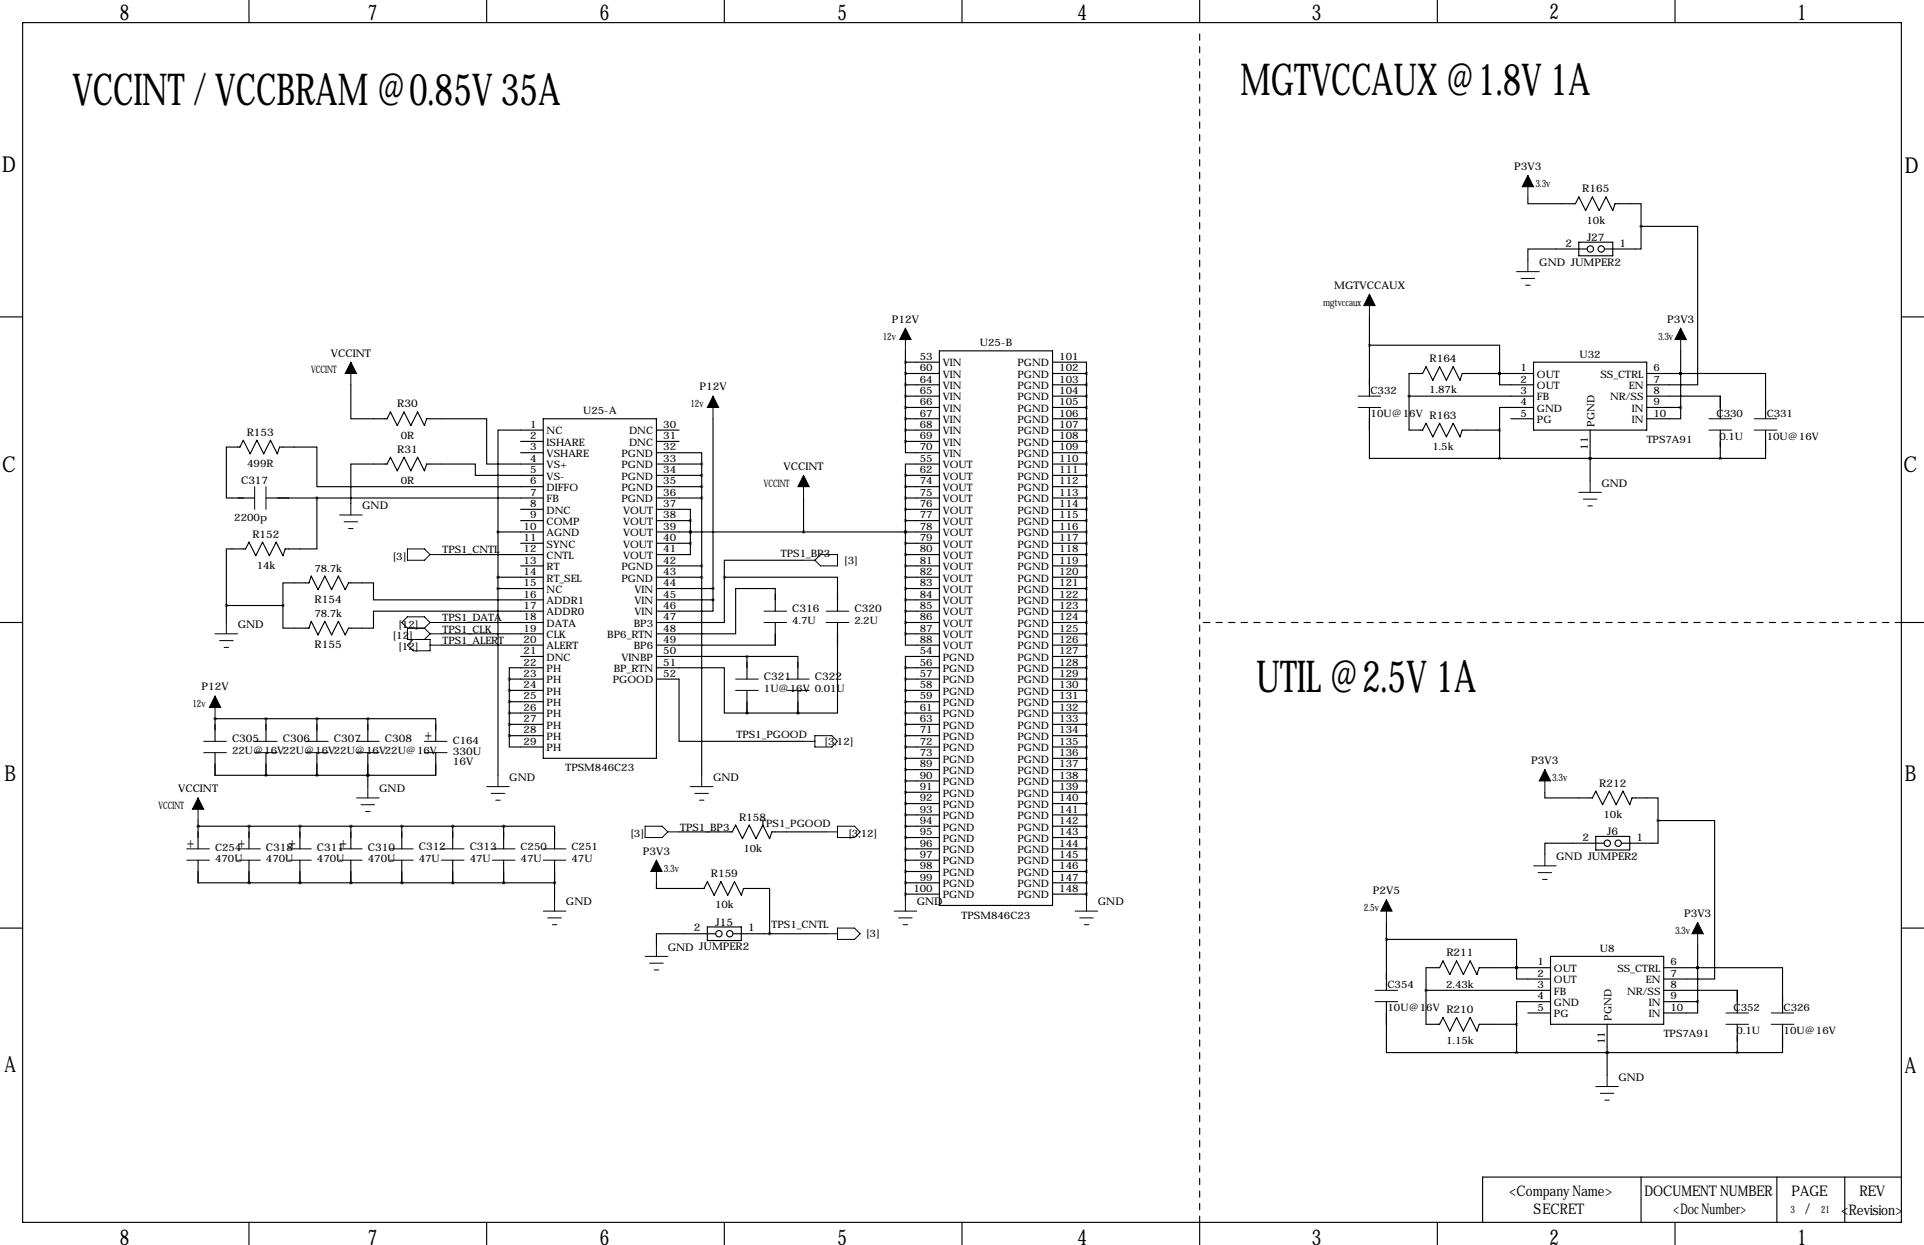
[picture p15: page 3]

D

D

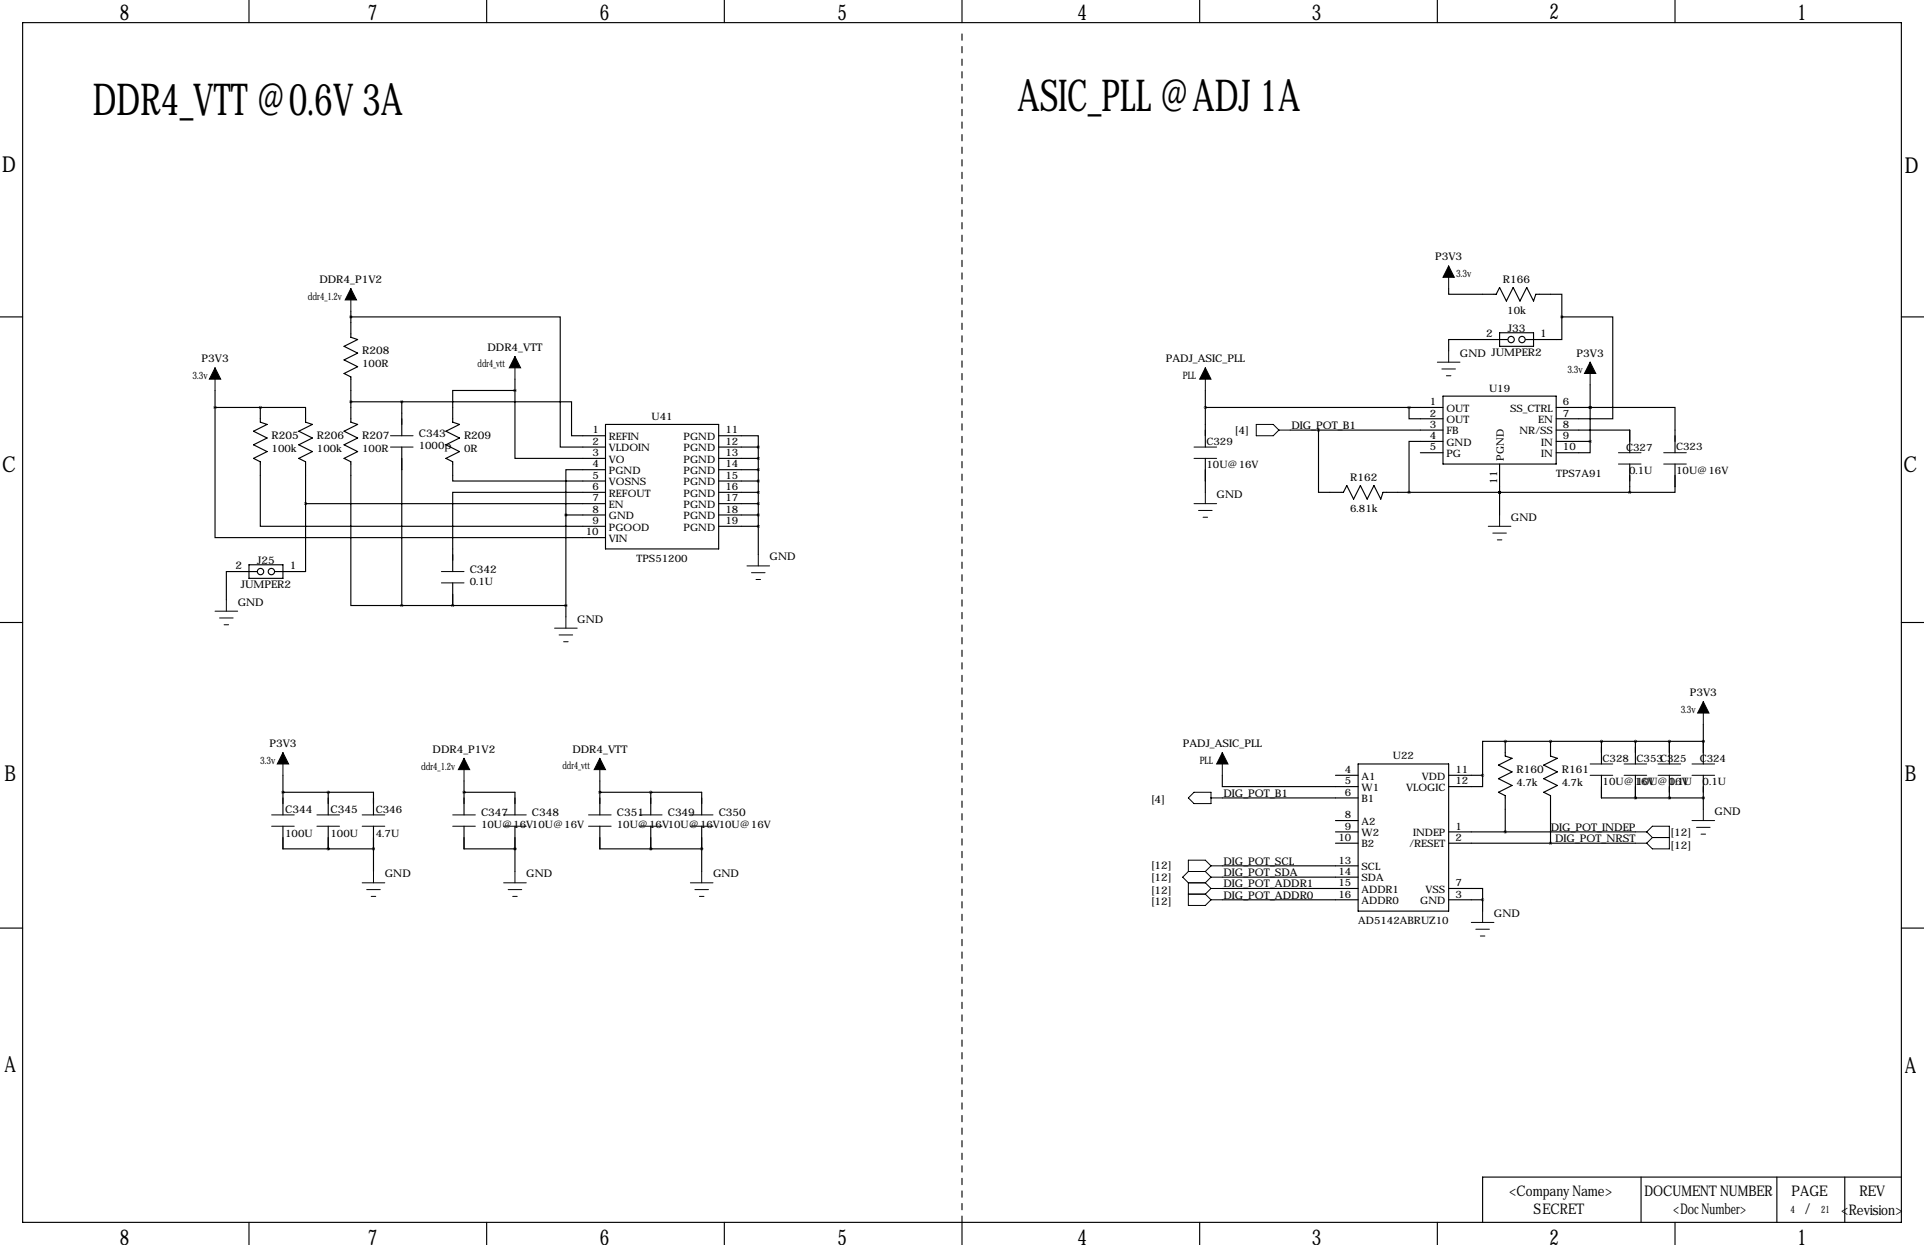
[picture p16: page 4]

REFOUT 7
EN 8

### DCBA

## ABCD

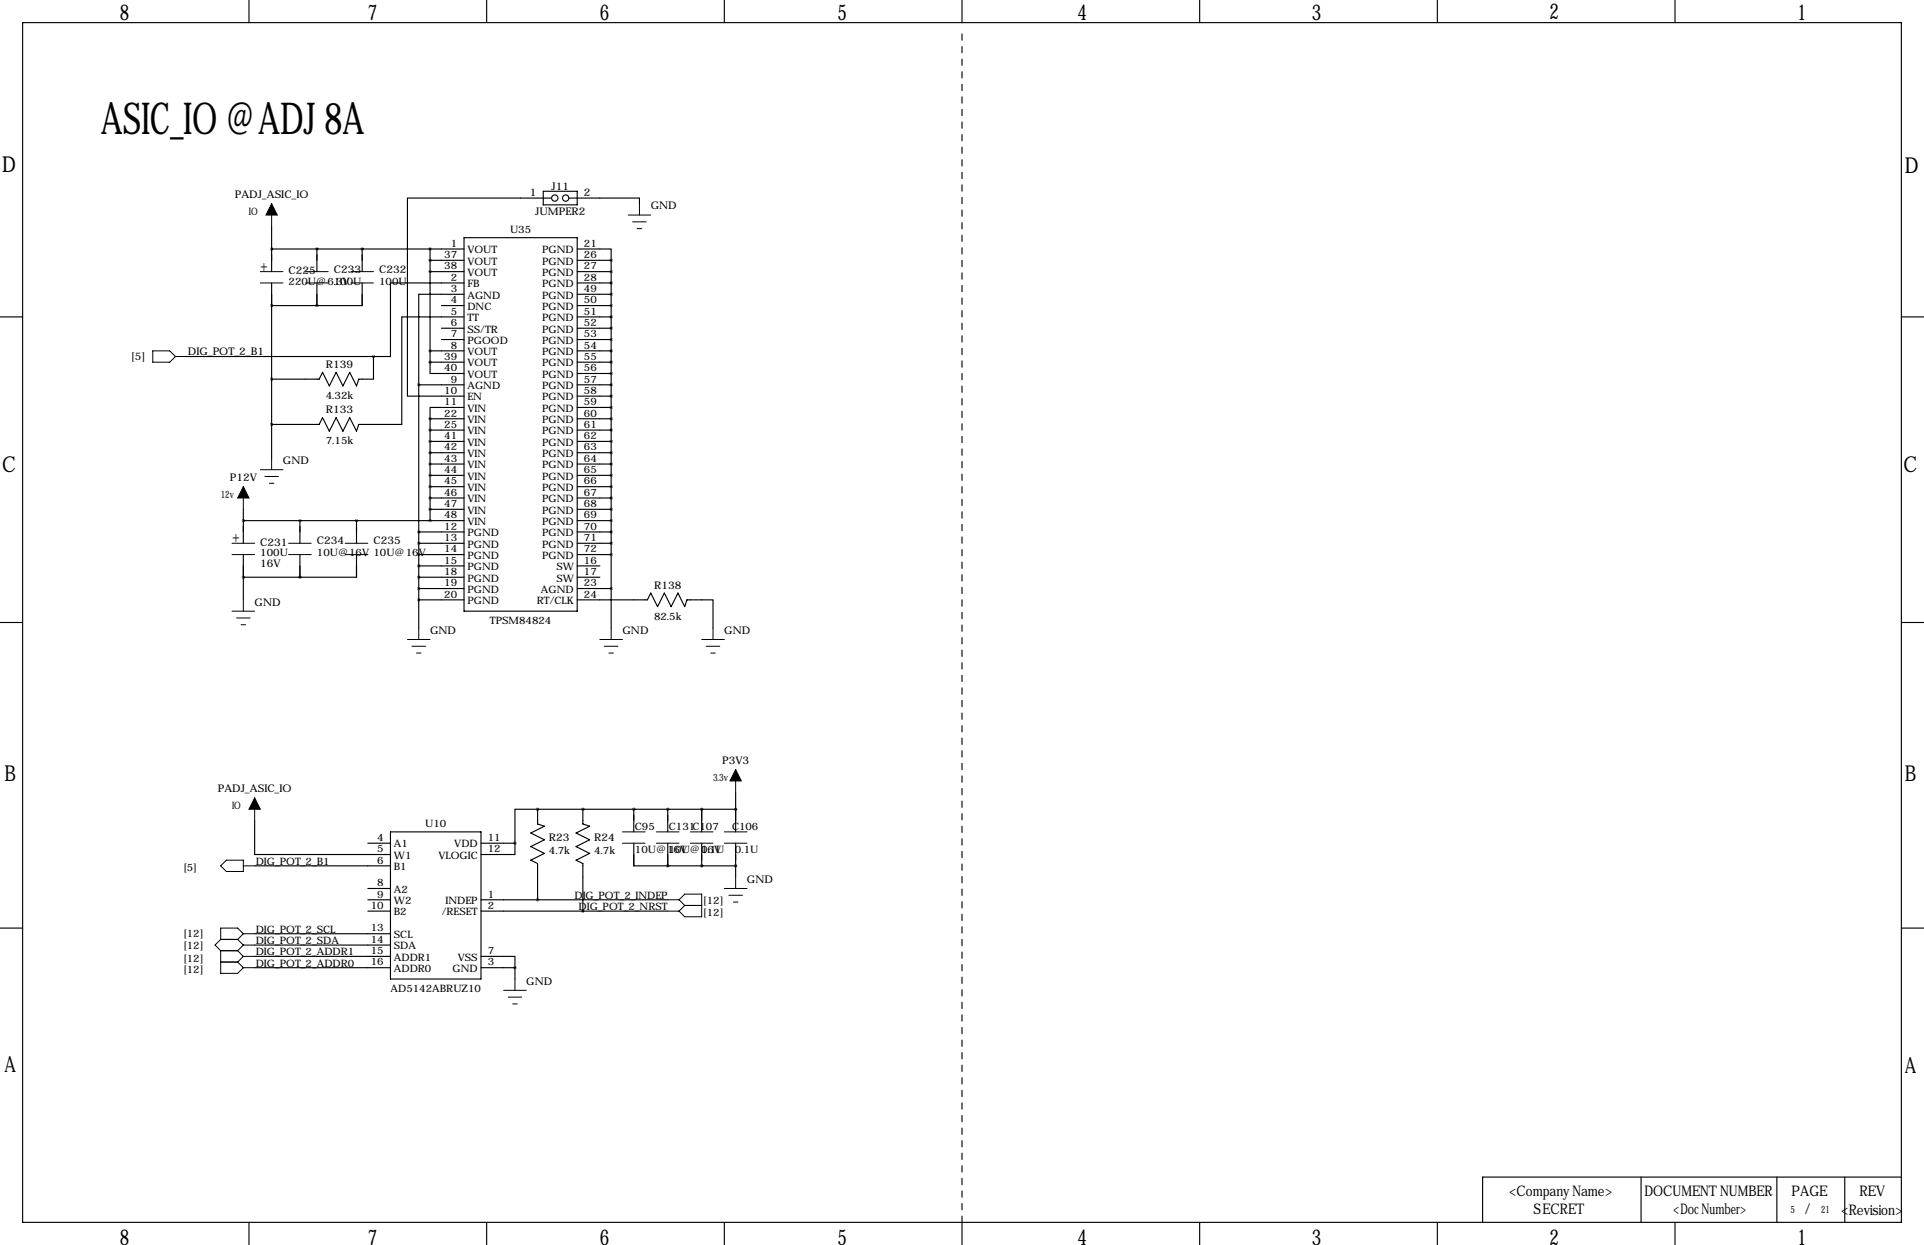
[picture p17: page 5]

VOUT 39 VOUT 40 VOUT 9 | 21 PGND 26 PGND 27 PGND 28 PGND 49 PGND 50 PGND 51 PGND 52 PGND 53 PGND 54 PGND 55 PGND 56 PGND 57 PGND 58 PGND 59 PGND 60 PGND 61 PGND 62 PGND 63 PGND 64 PGND 65 PGND 66 PGND 67 PGND 68 PGND 69 PGND 70 PGND 71 PGND 72 PGND 16 SW 17 SW 23 AGND 24 RT/CLK

4 5

D
D

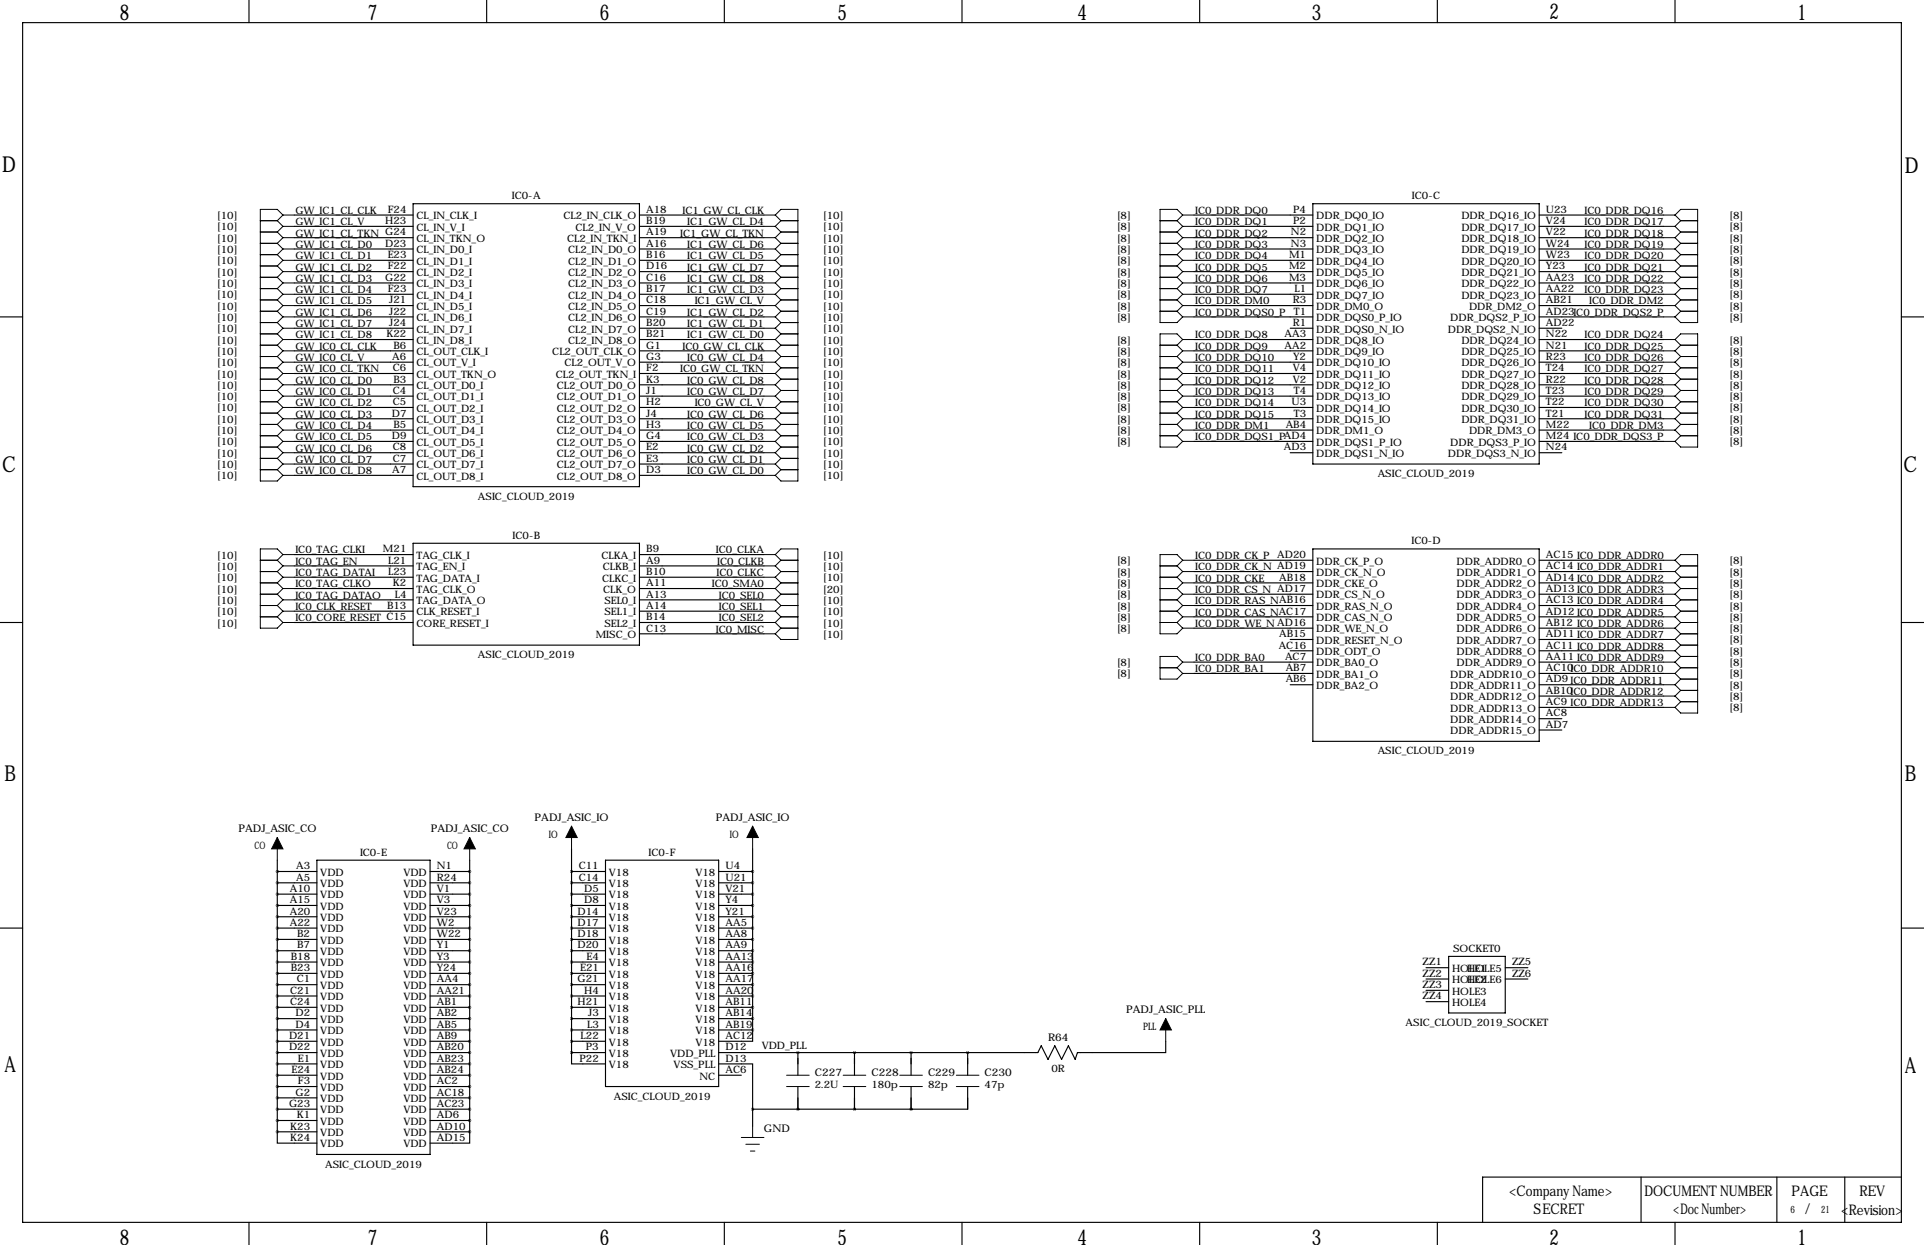
[picture p18: page 6]

D

D

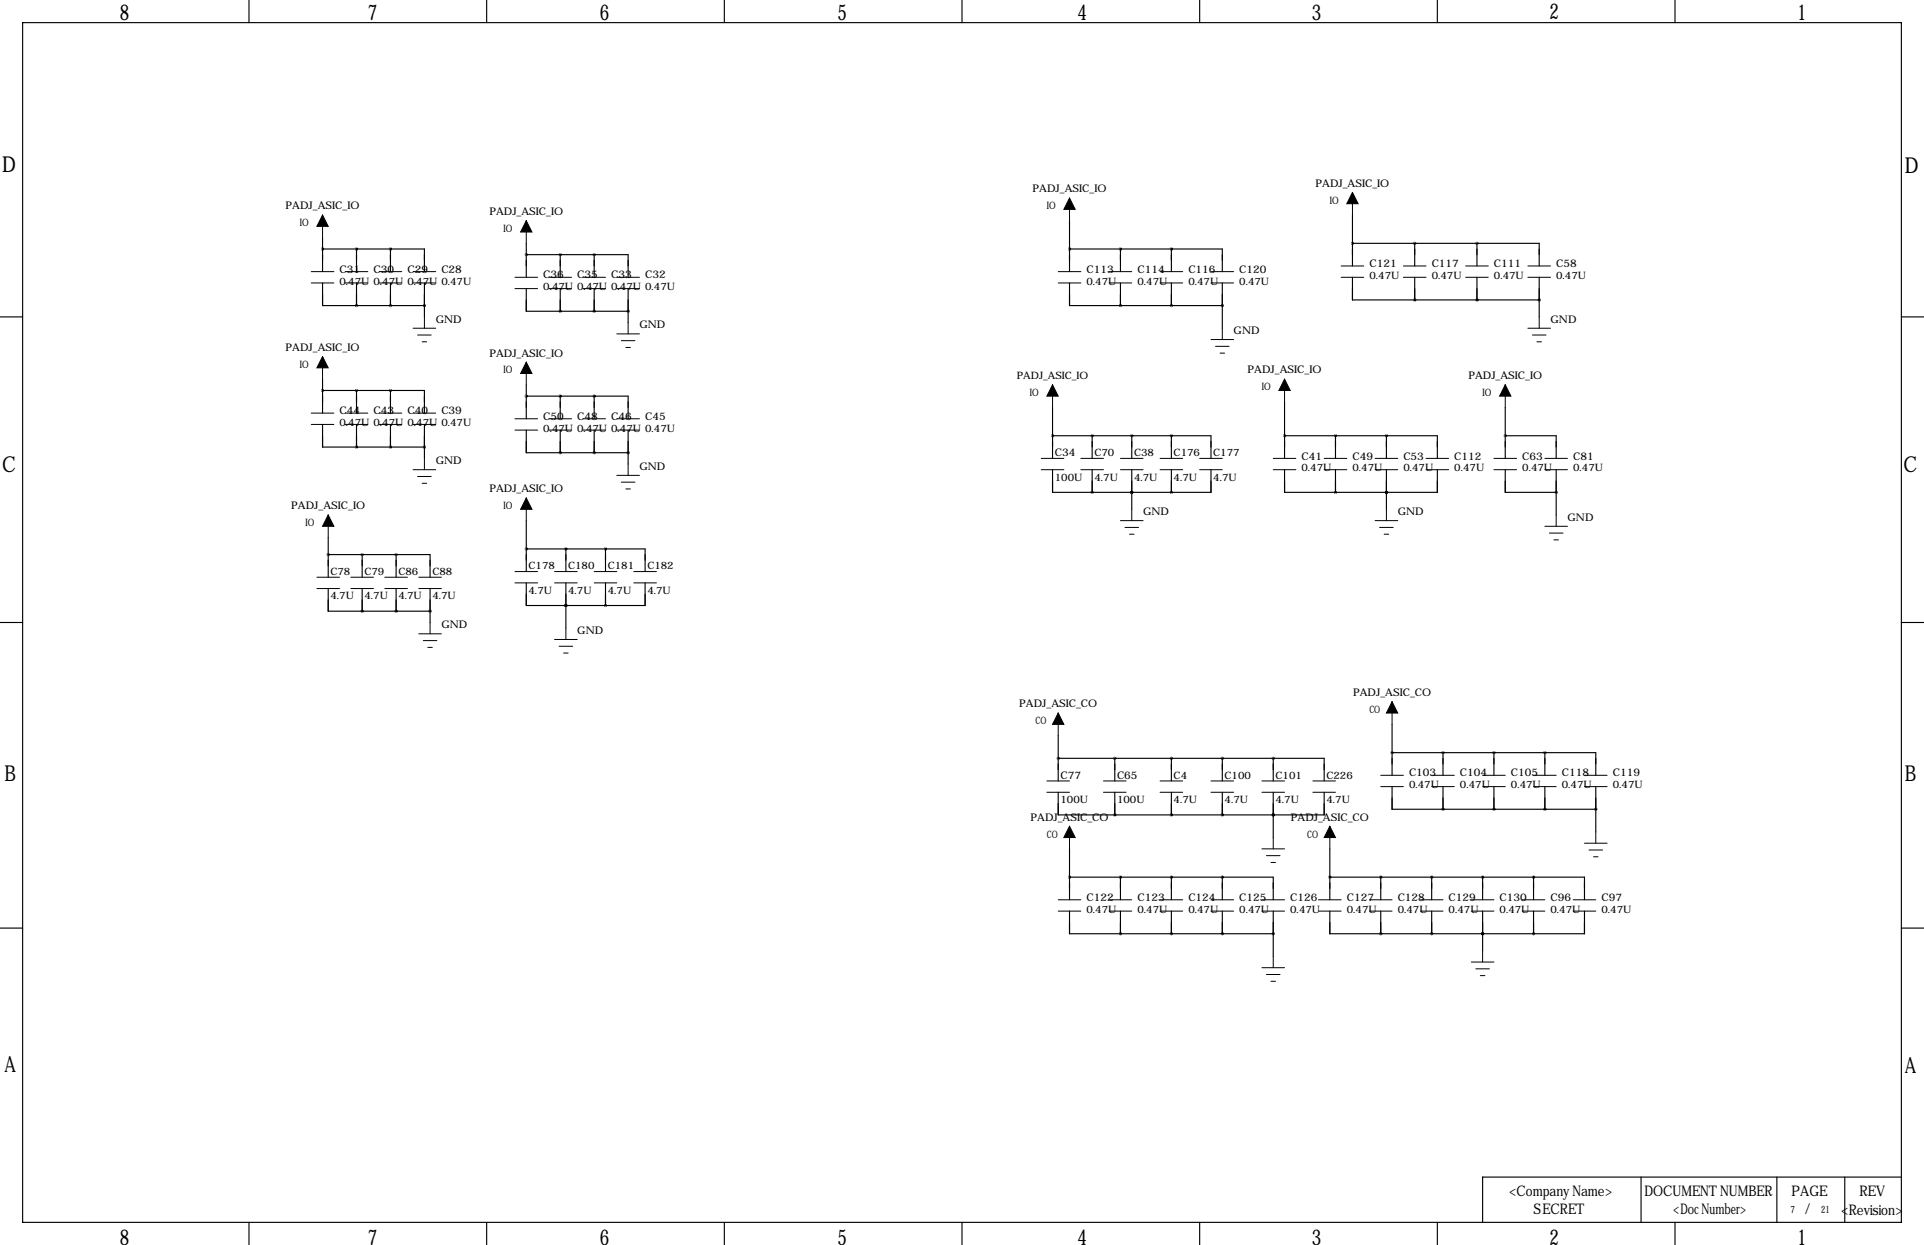
[picture p19: page 7]

D
D

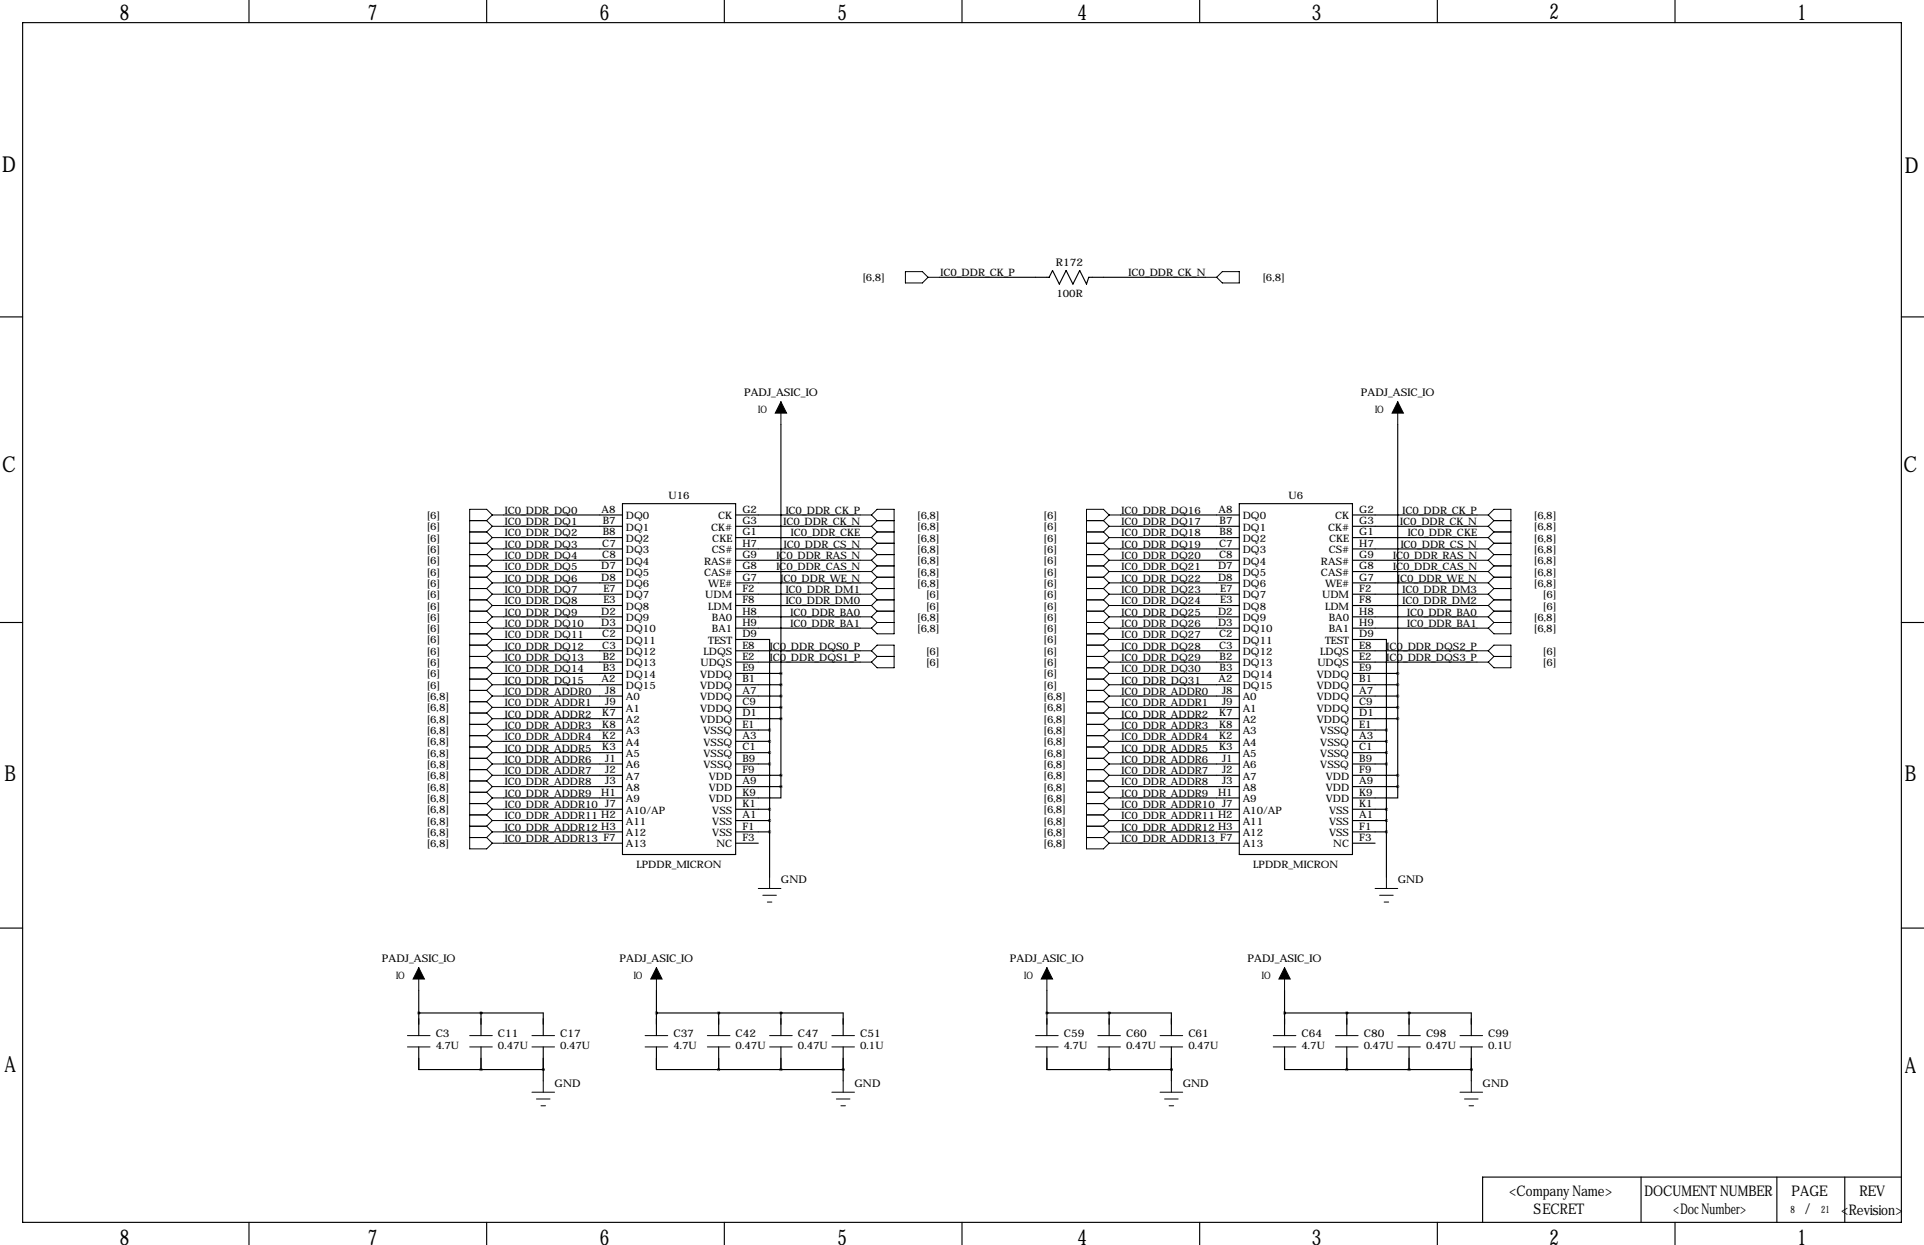
[picture p20: page 8]

# DCB

# BCD

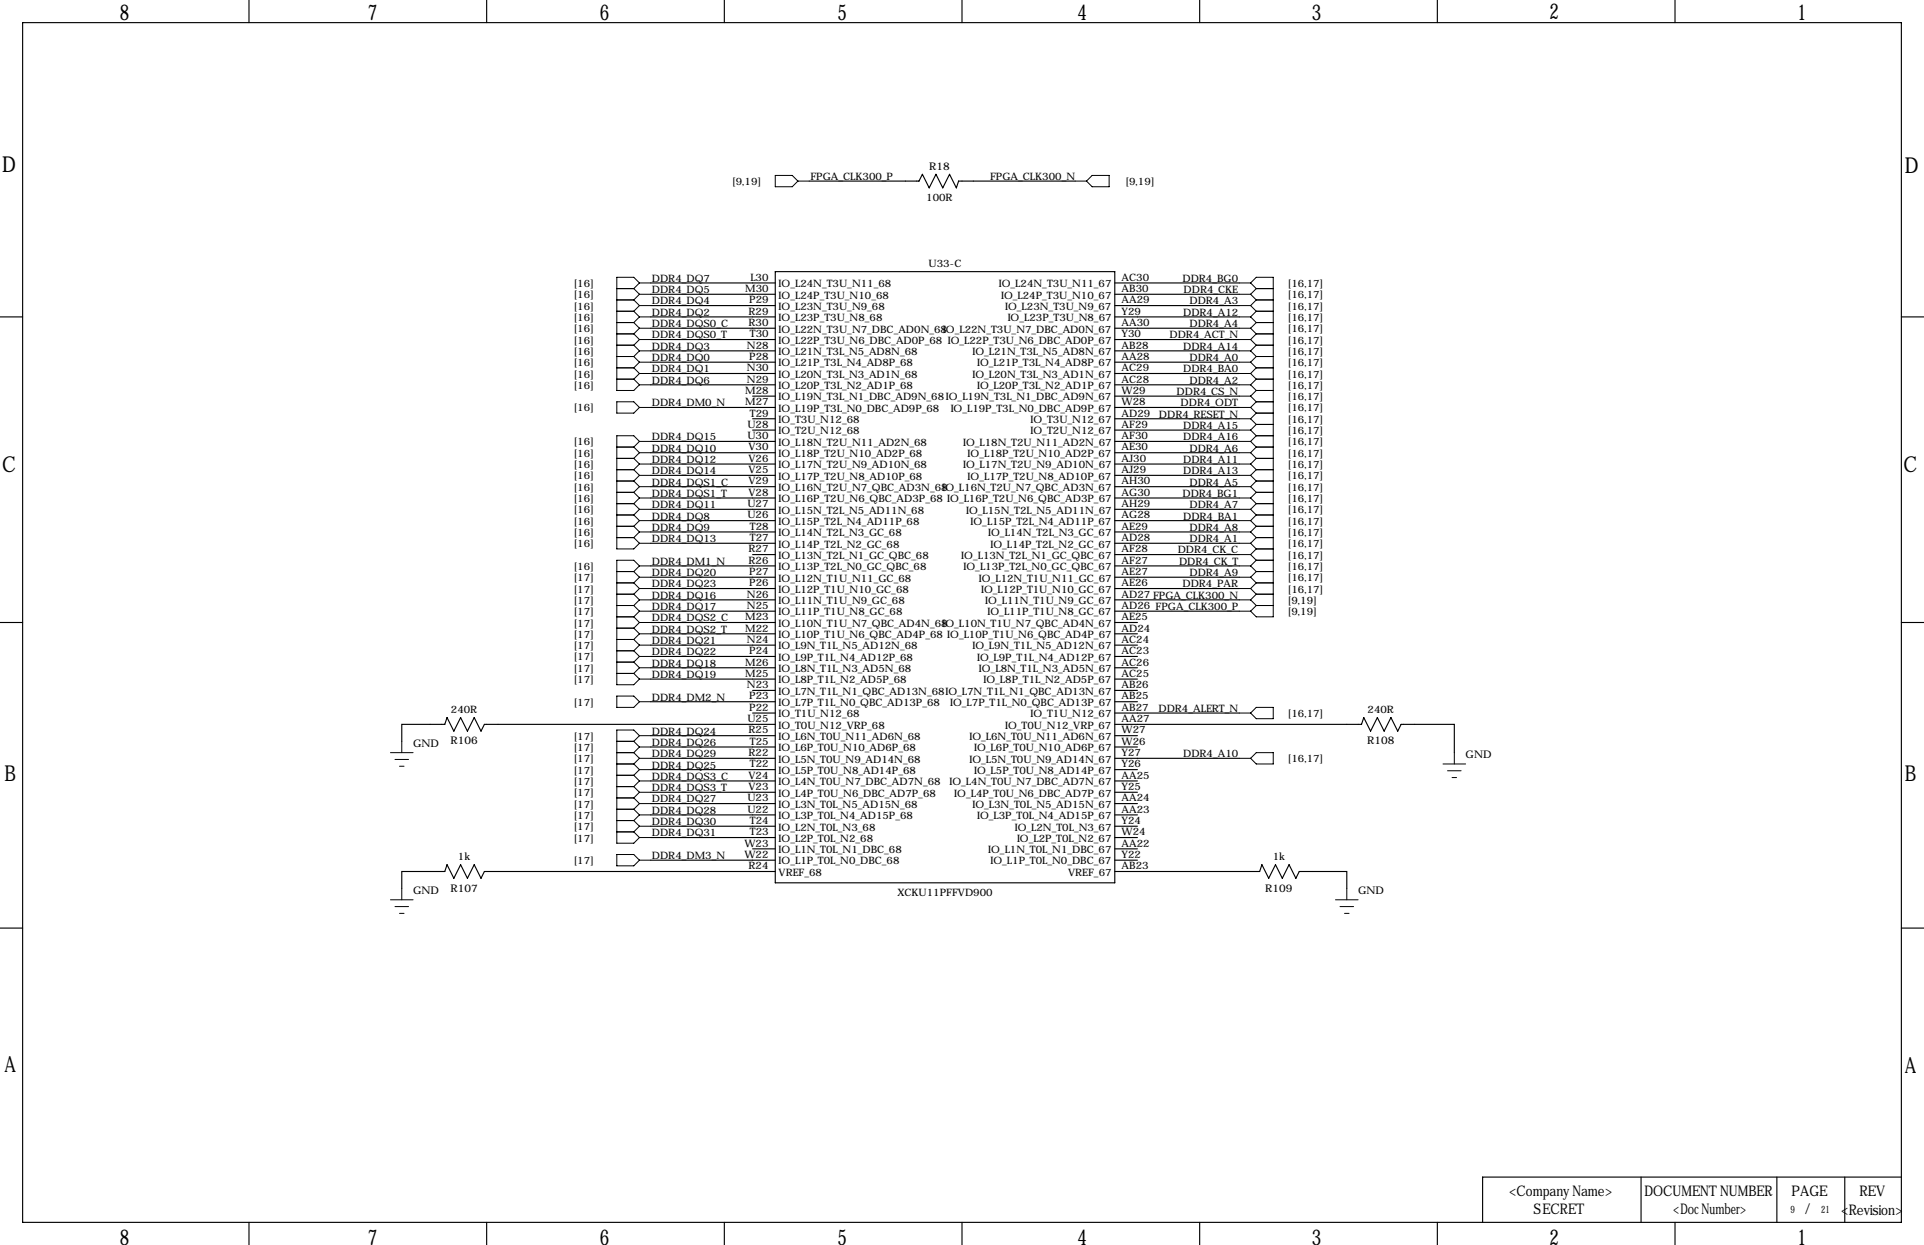
[picture p21: page 9]

D
D

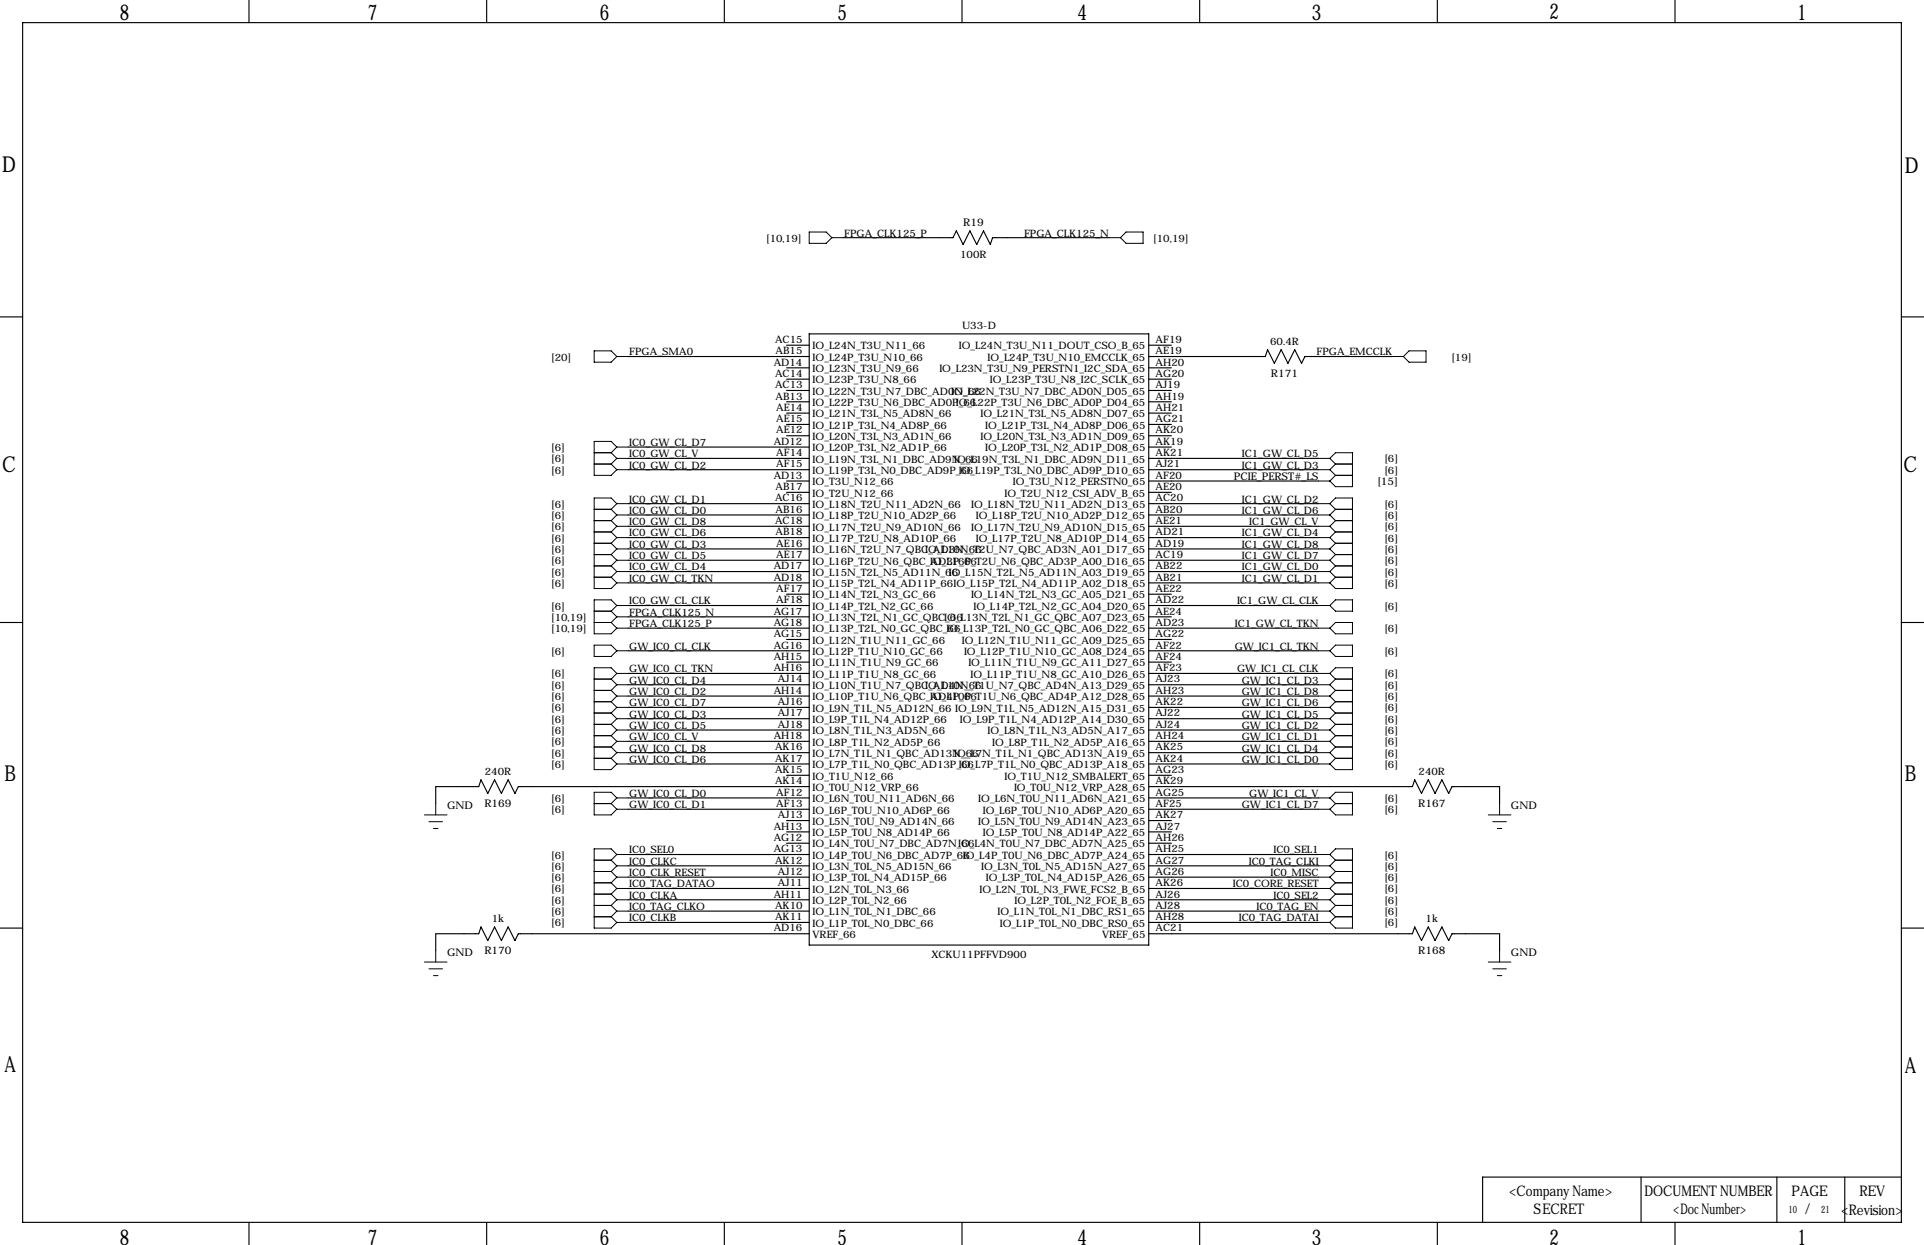
[picture p22: page 10]
IO_L22N_T3U_N7_DBC_AD0N_66 AB13; IO_L22P_T3U_N6_DBC_AD0P_66 AE14; IO_L19N_T3L_N1_DBC_AD9N_66 AF15; IO_L19P_T3L_N0_DBC_AD9P_66 AD13; IO_L16N_T2U_N7_QBC_AD3N_66 AE17; IO_L16P_T2U_N6_QBC_AD3P_66 AD17; IO_L13N_T2L_N1_GC_QBC_66 AG18; IO_L13P_T2L_N0_GC_QBC_66 AG15; IO_L10N_T1U_N7_QBC_AD4N_66 AH14; IO_L10P_T1U_N6_QBC_AD4P_66 AJ16; IO_L7N_T1L_N1_QBC_AD13N_66 AK17; IO_L7P_T1L_N0_QBC_AD13P_66 AK15; IO_T0U_N12_VRP_66 AF12; IO_L4N_T0U_N7_DBC_AD7N_66 AG13; IO_L4P_T0U_N6_DBC_AD7P_66 AK12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

D

D

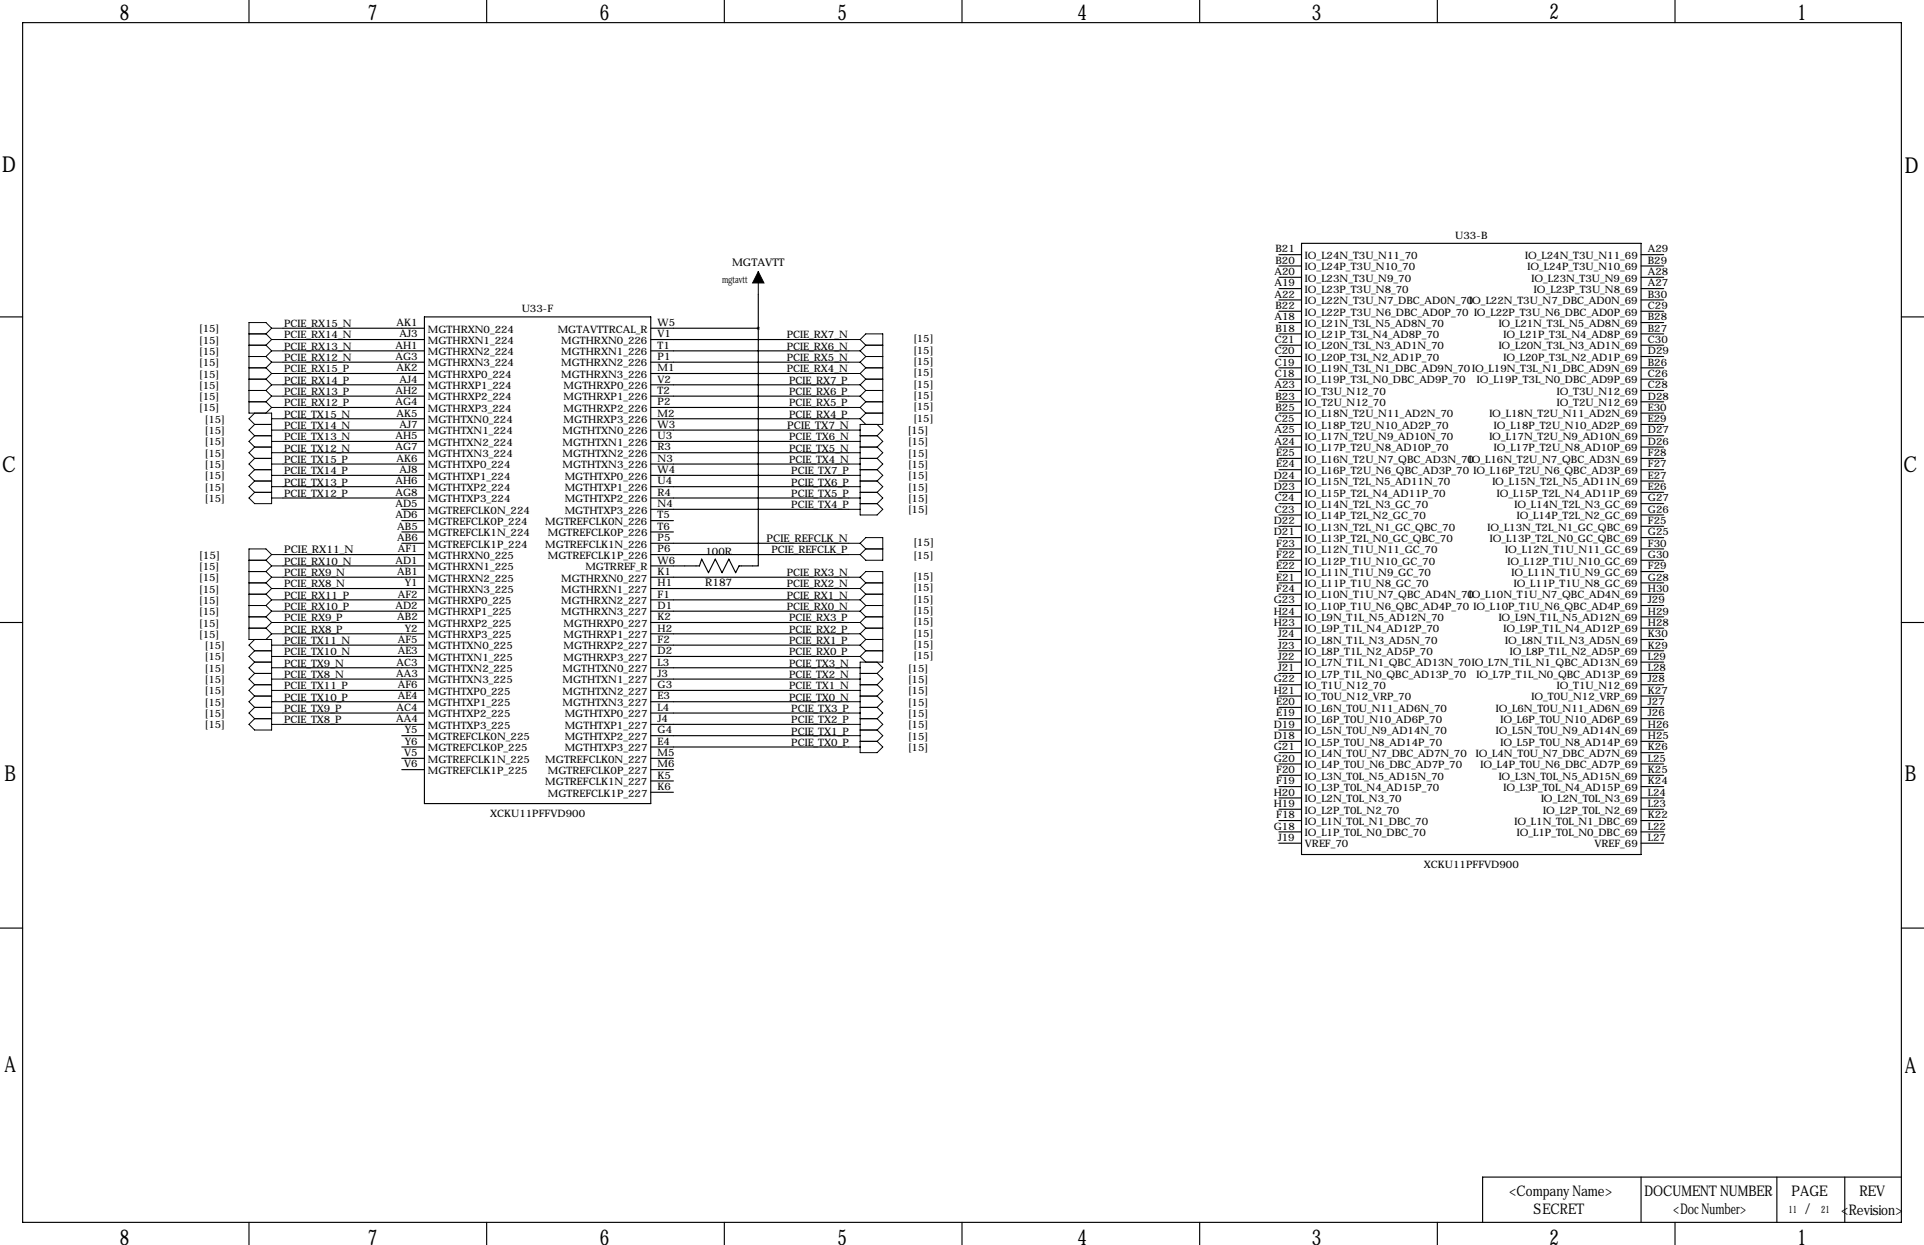
[picture p23: page 11]

D
D

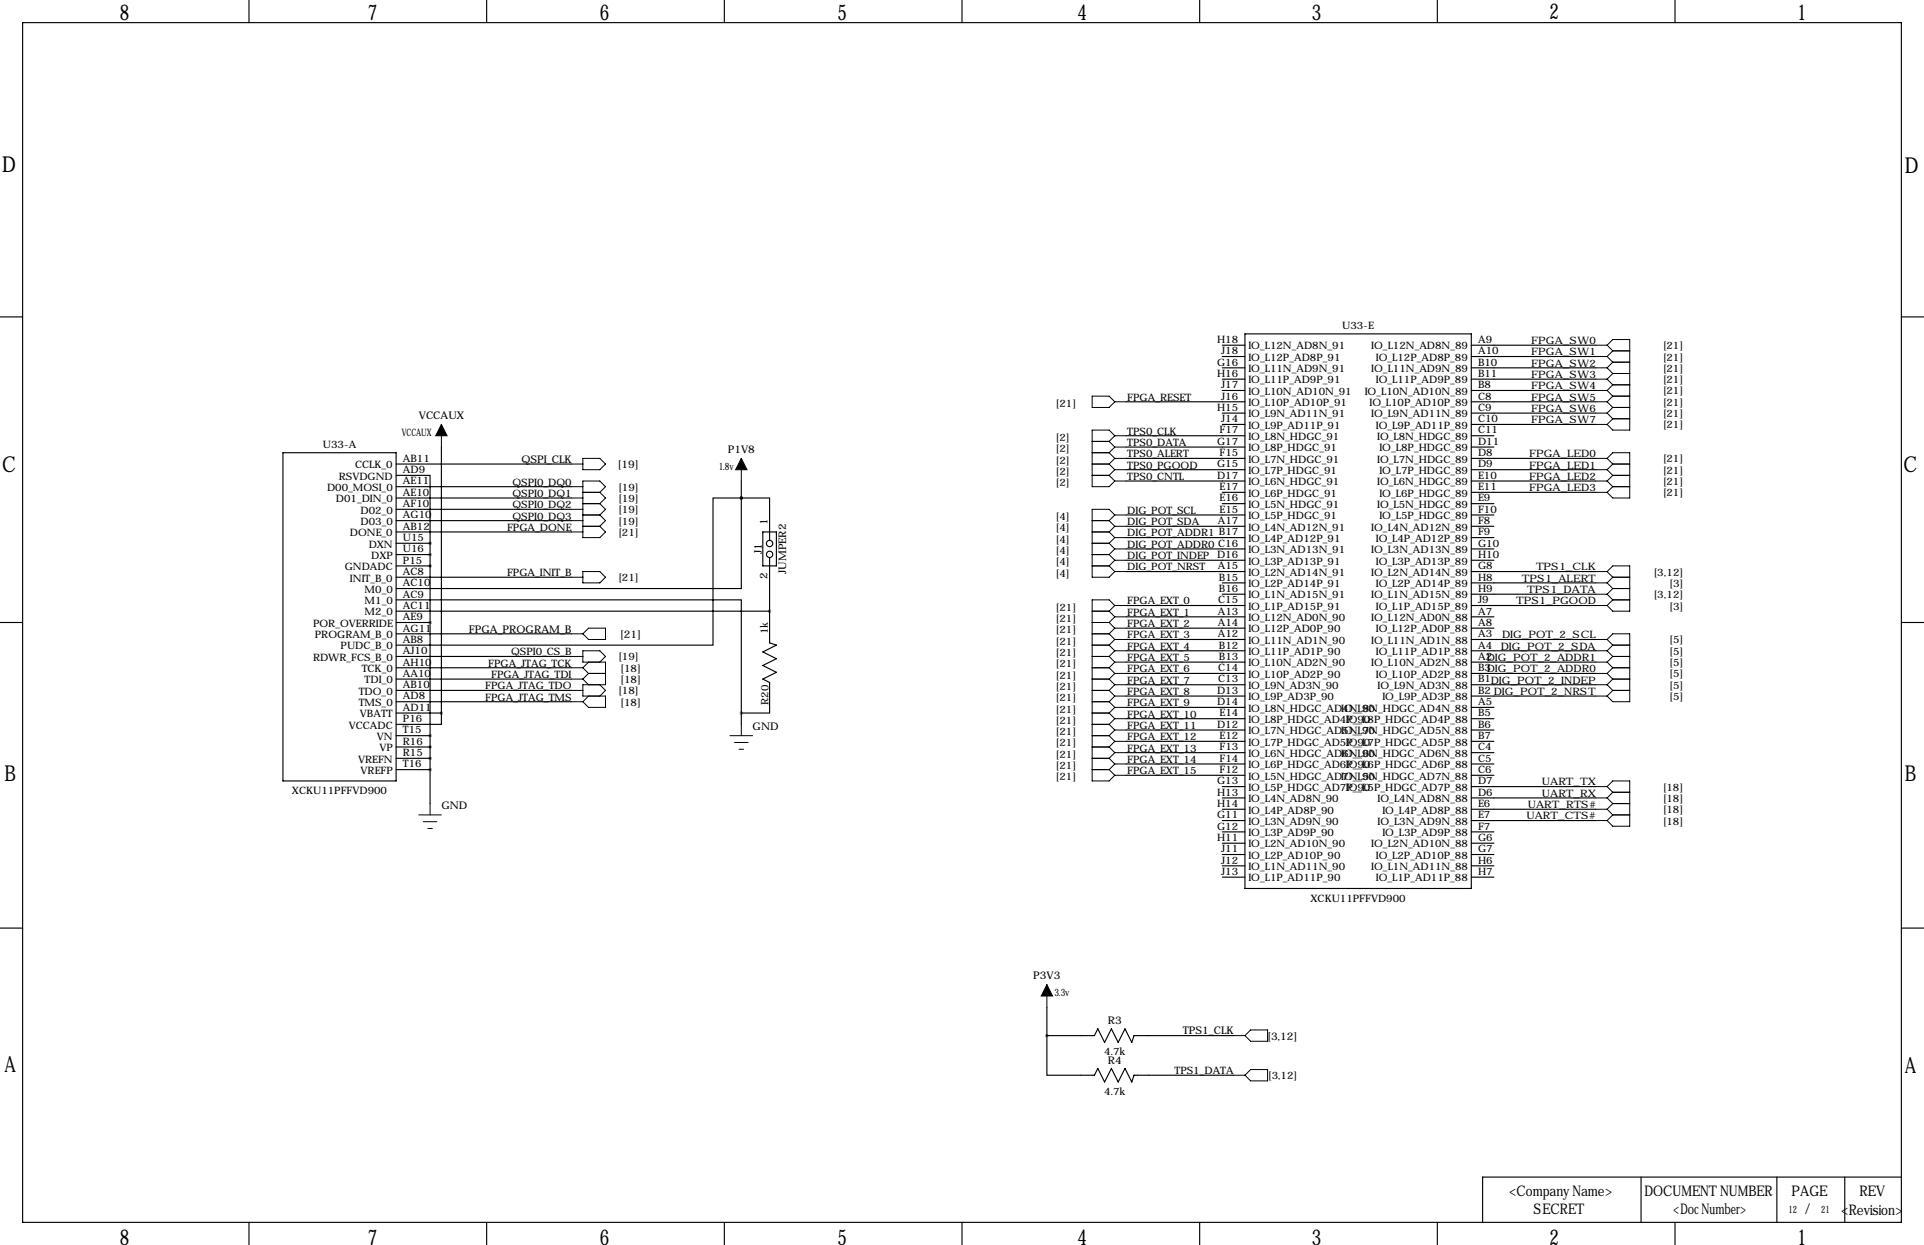
[picture p24: page 12]

### DCBA

## ABCD

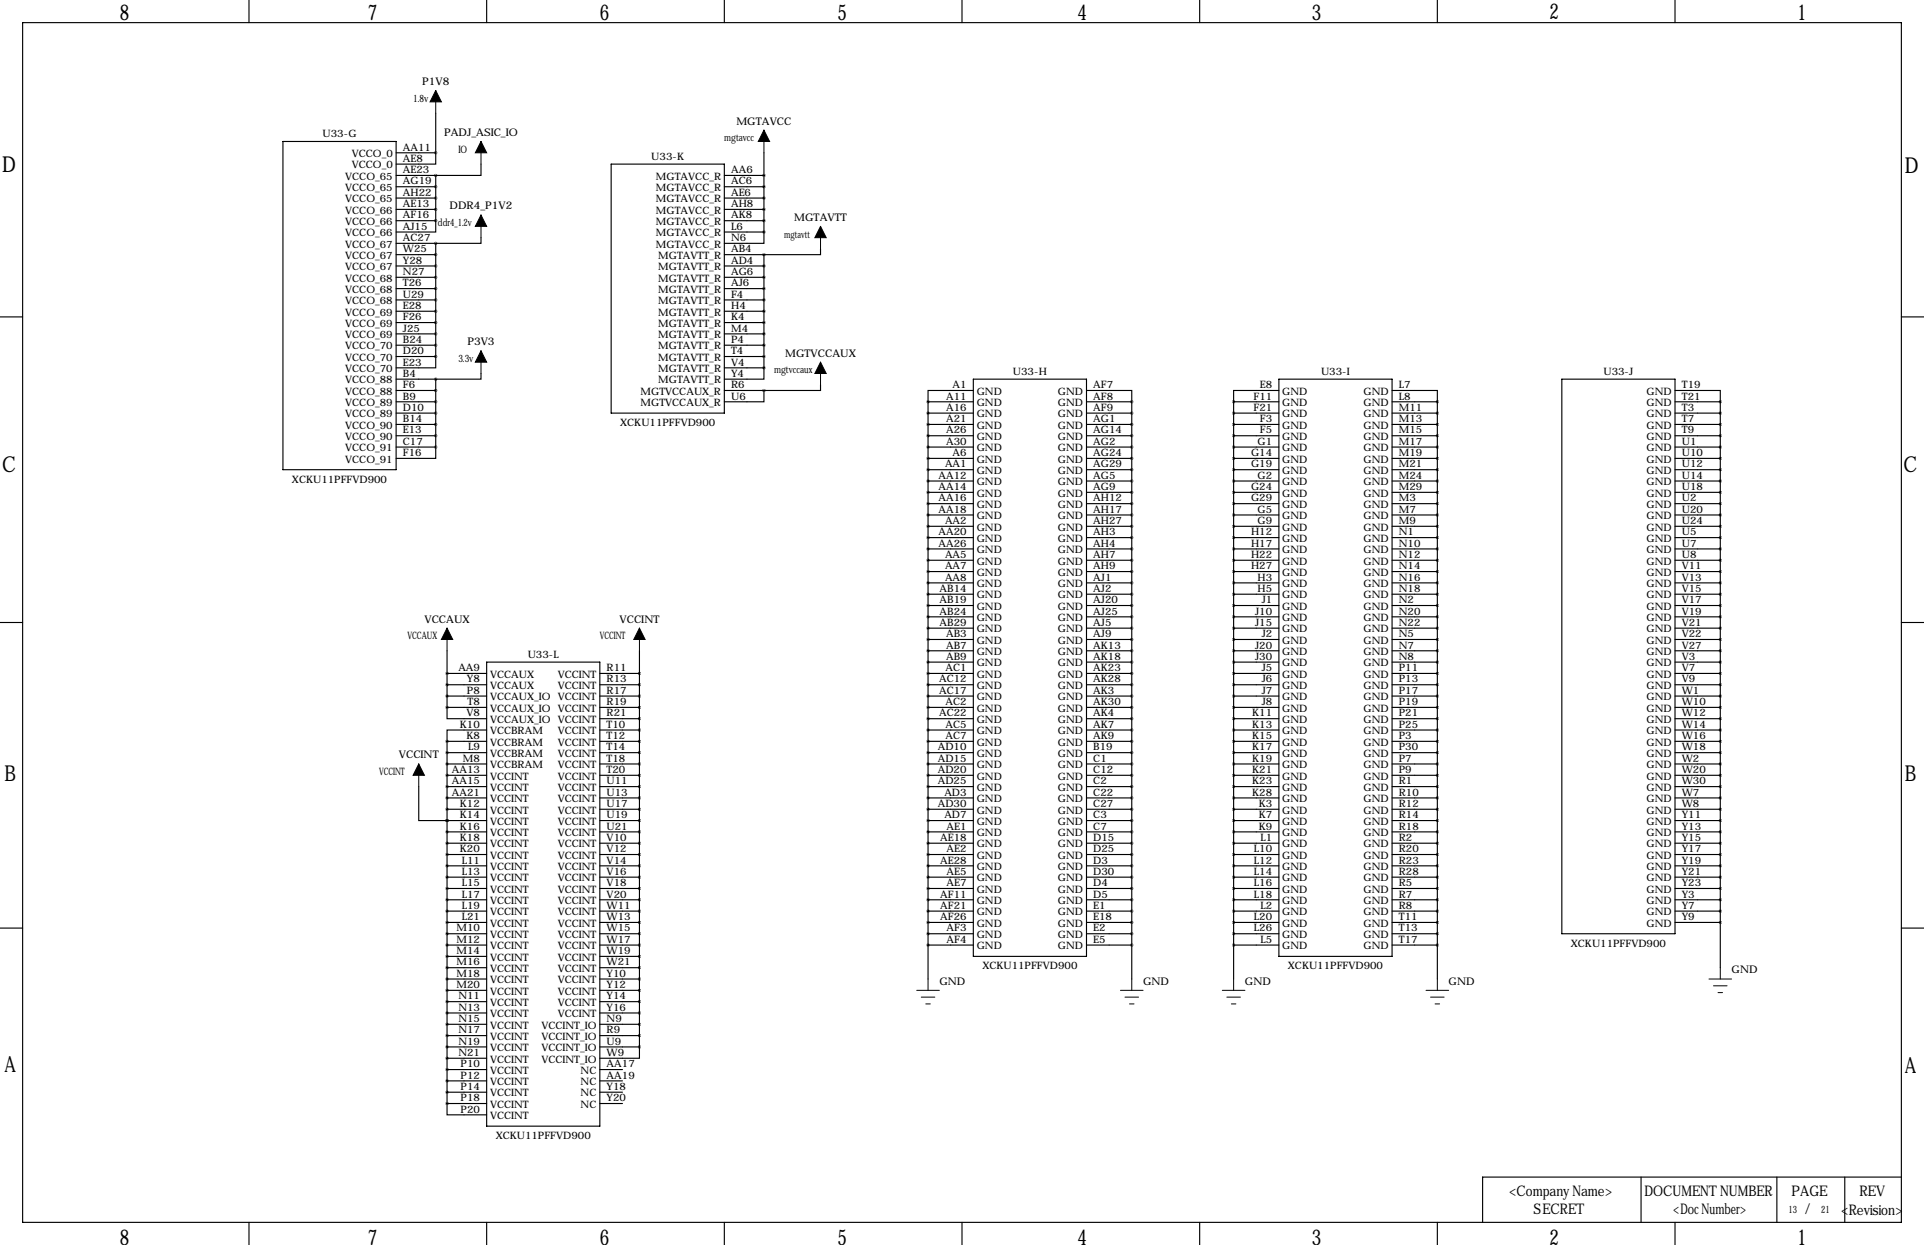
[picture p25: page 13]

D
D

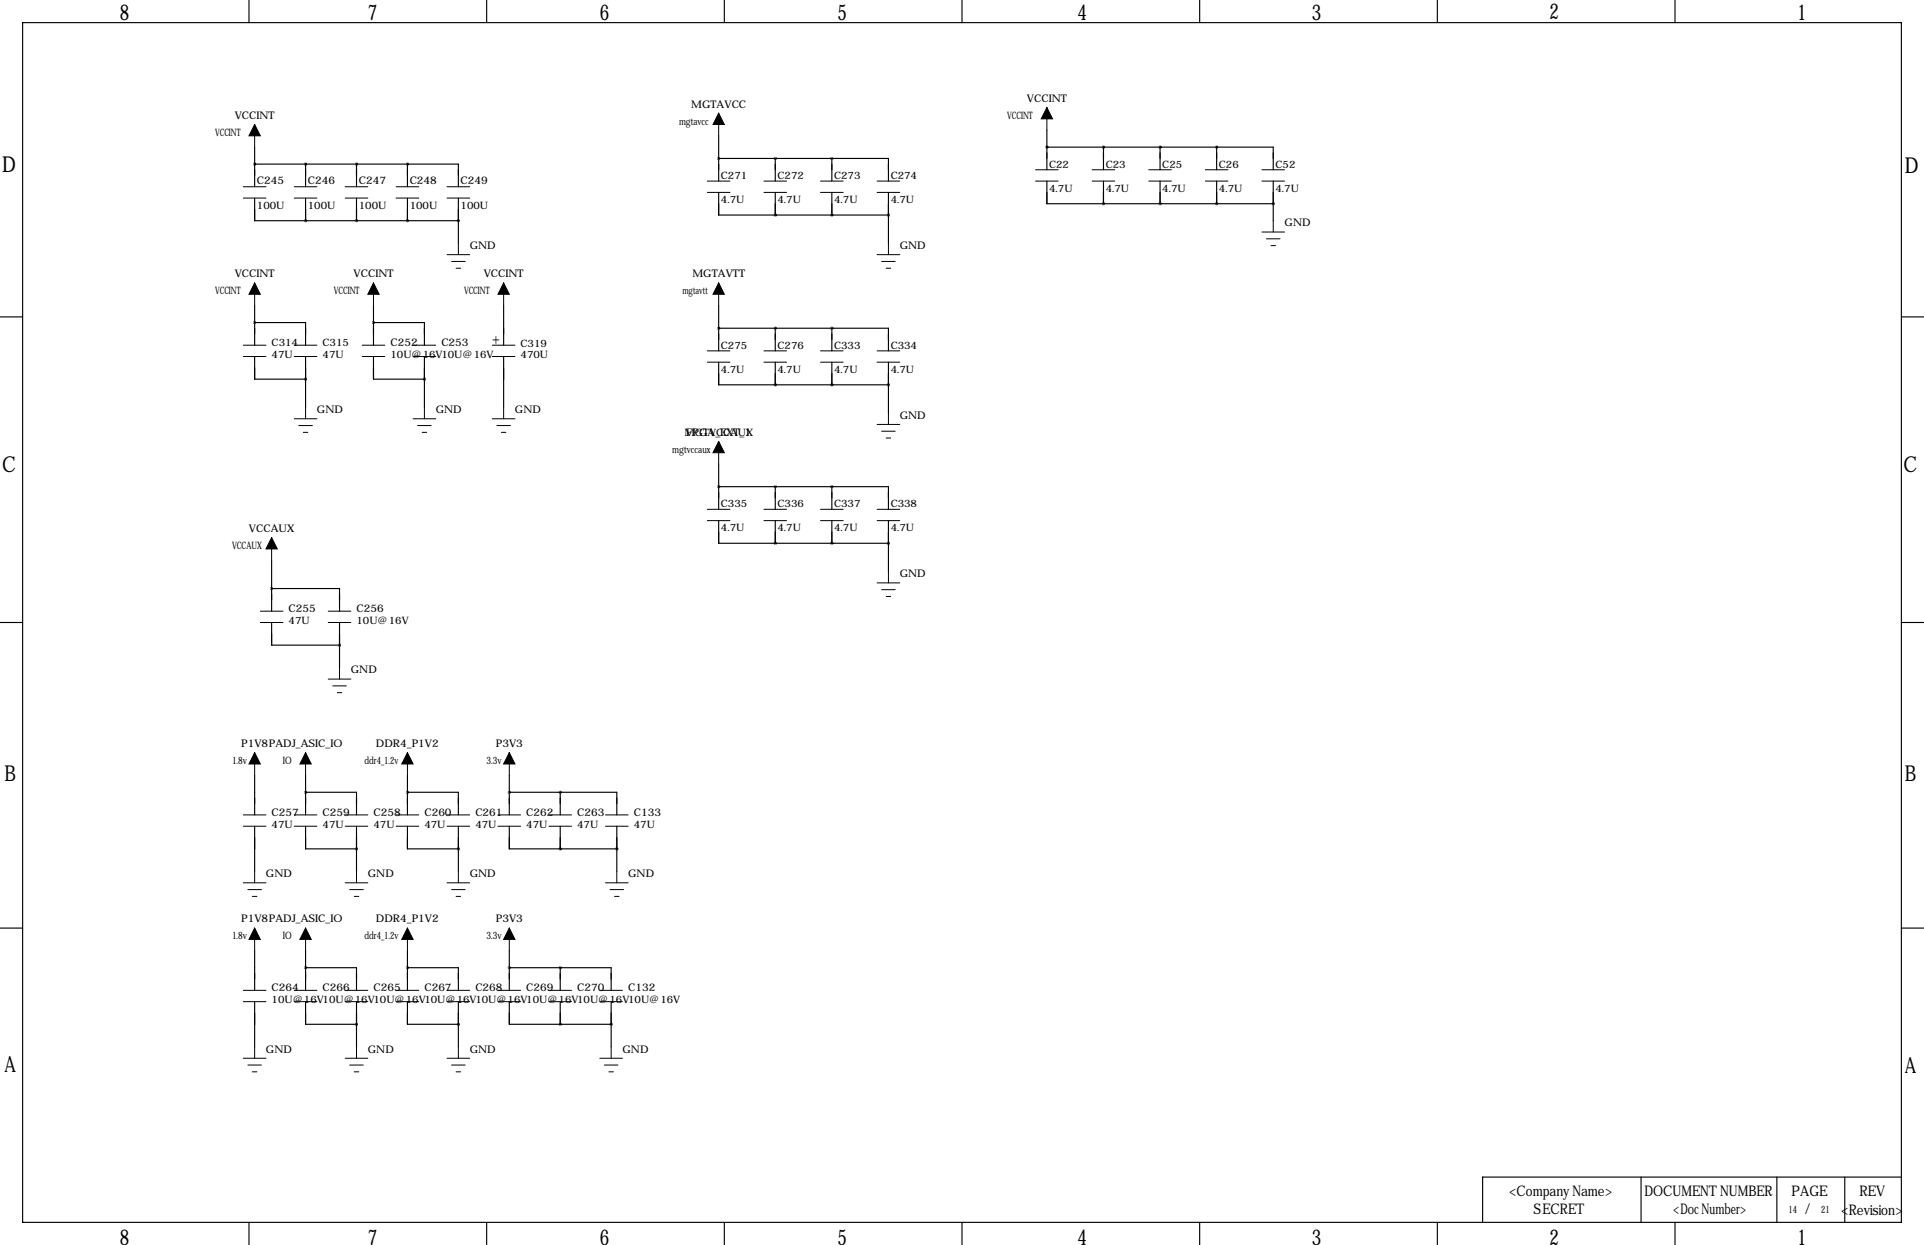
[picture p26: page 14]

### DCBA

## ABCD

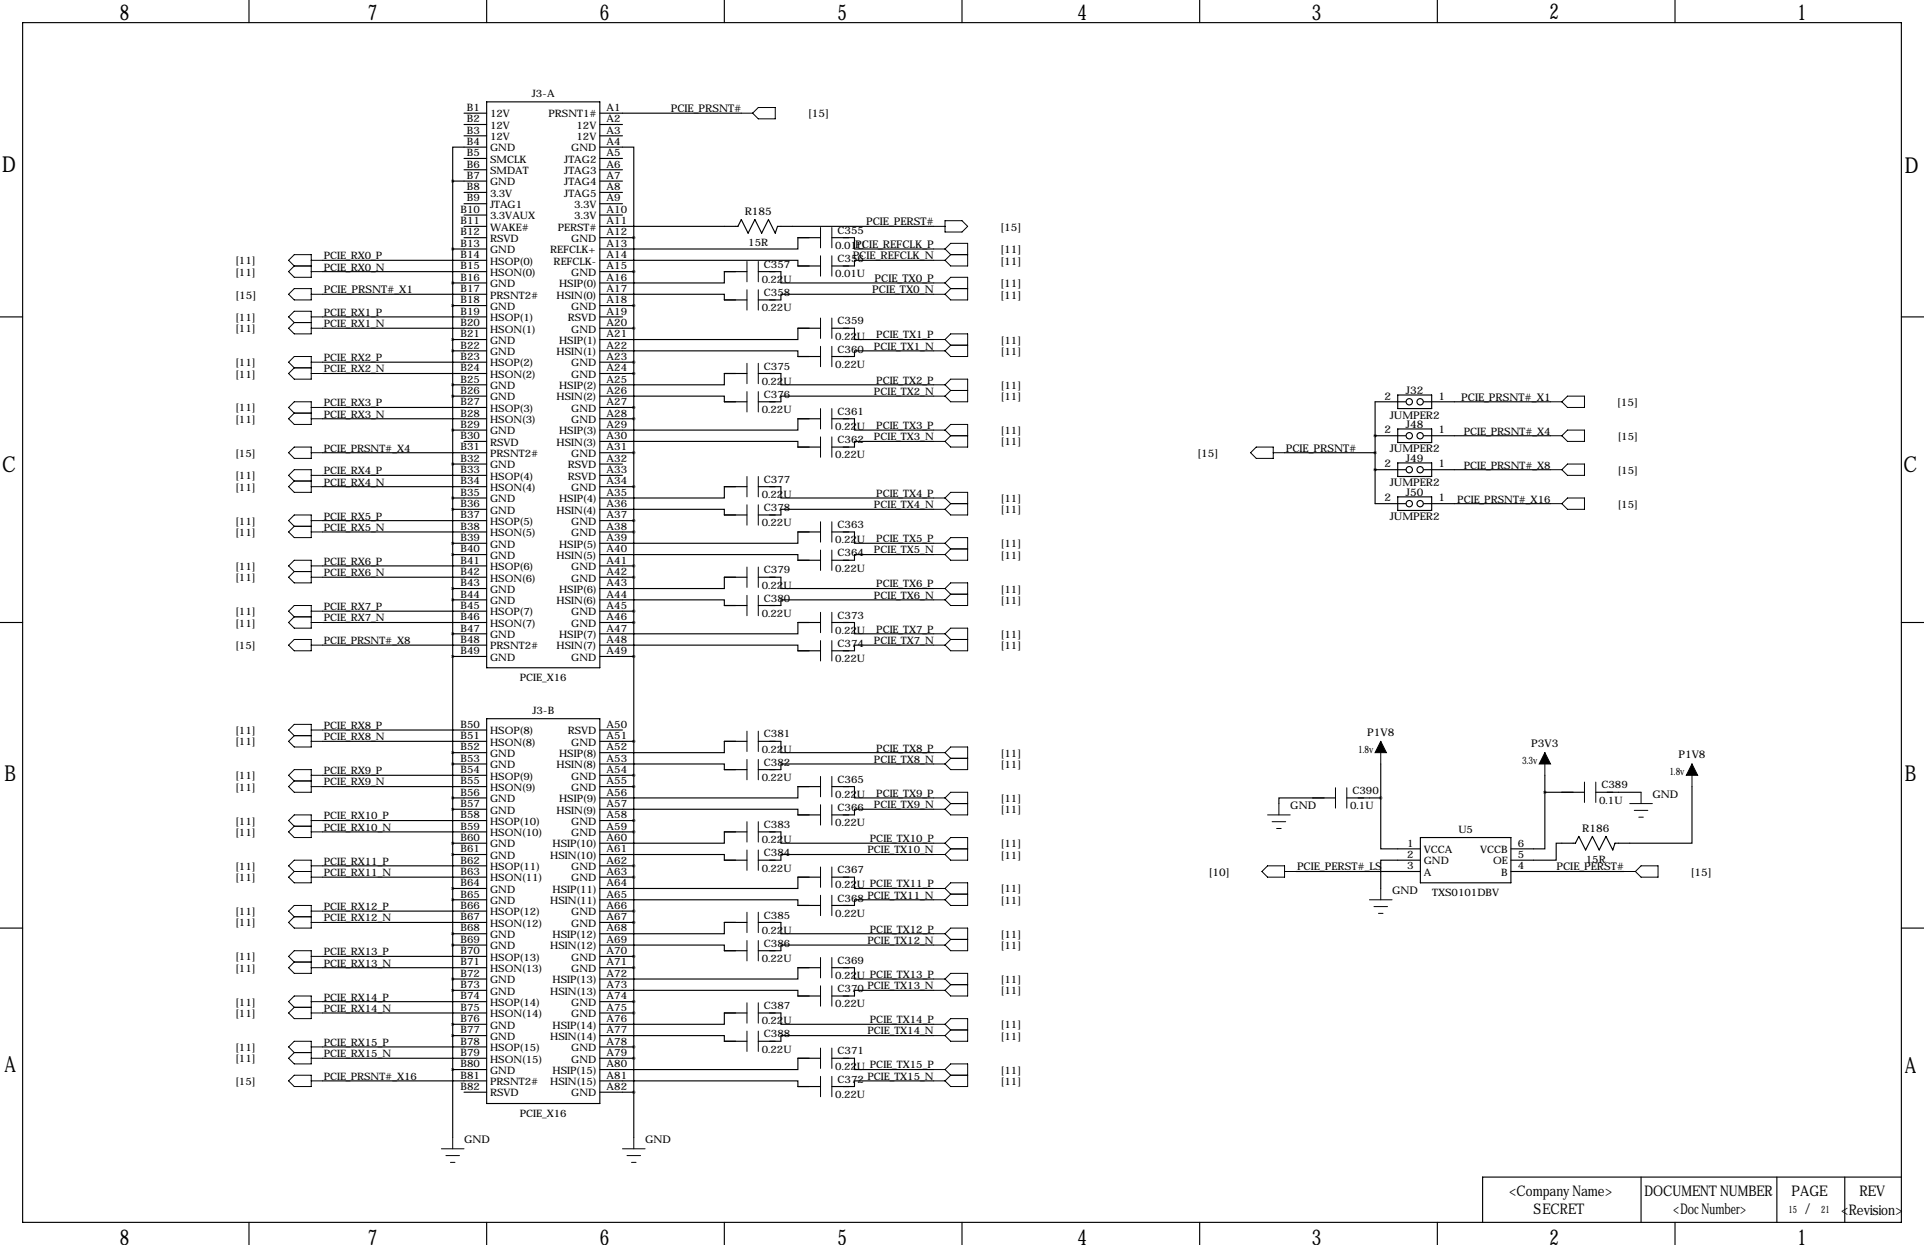
[picture p27: page 15]

D
D

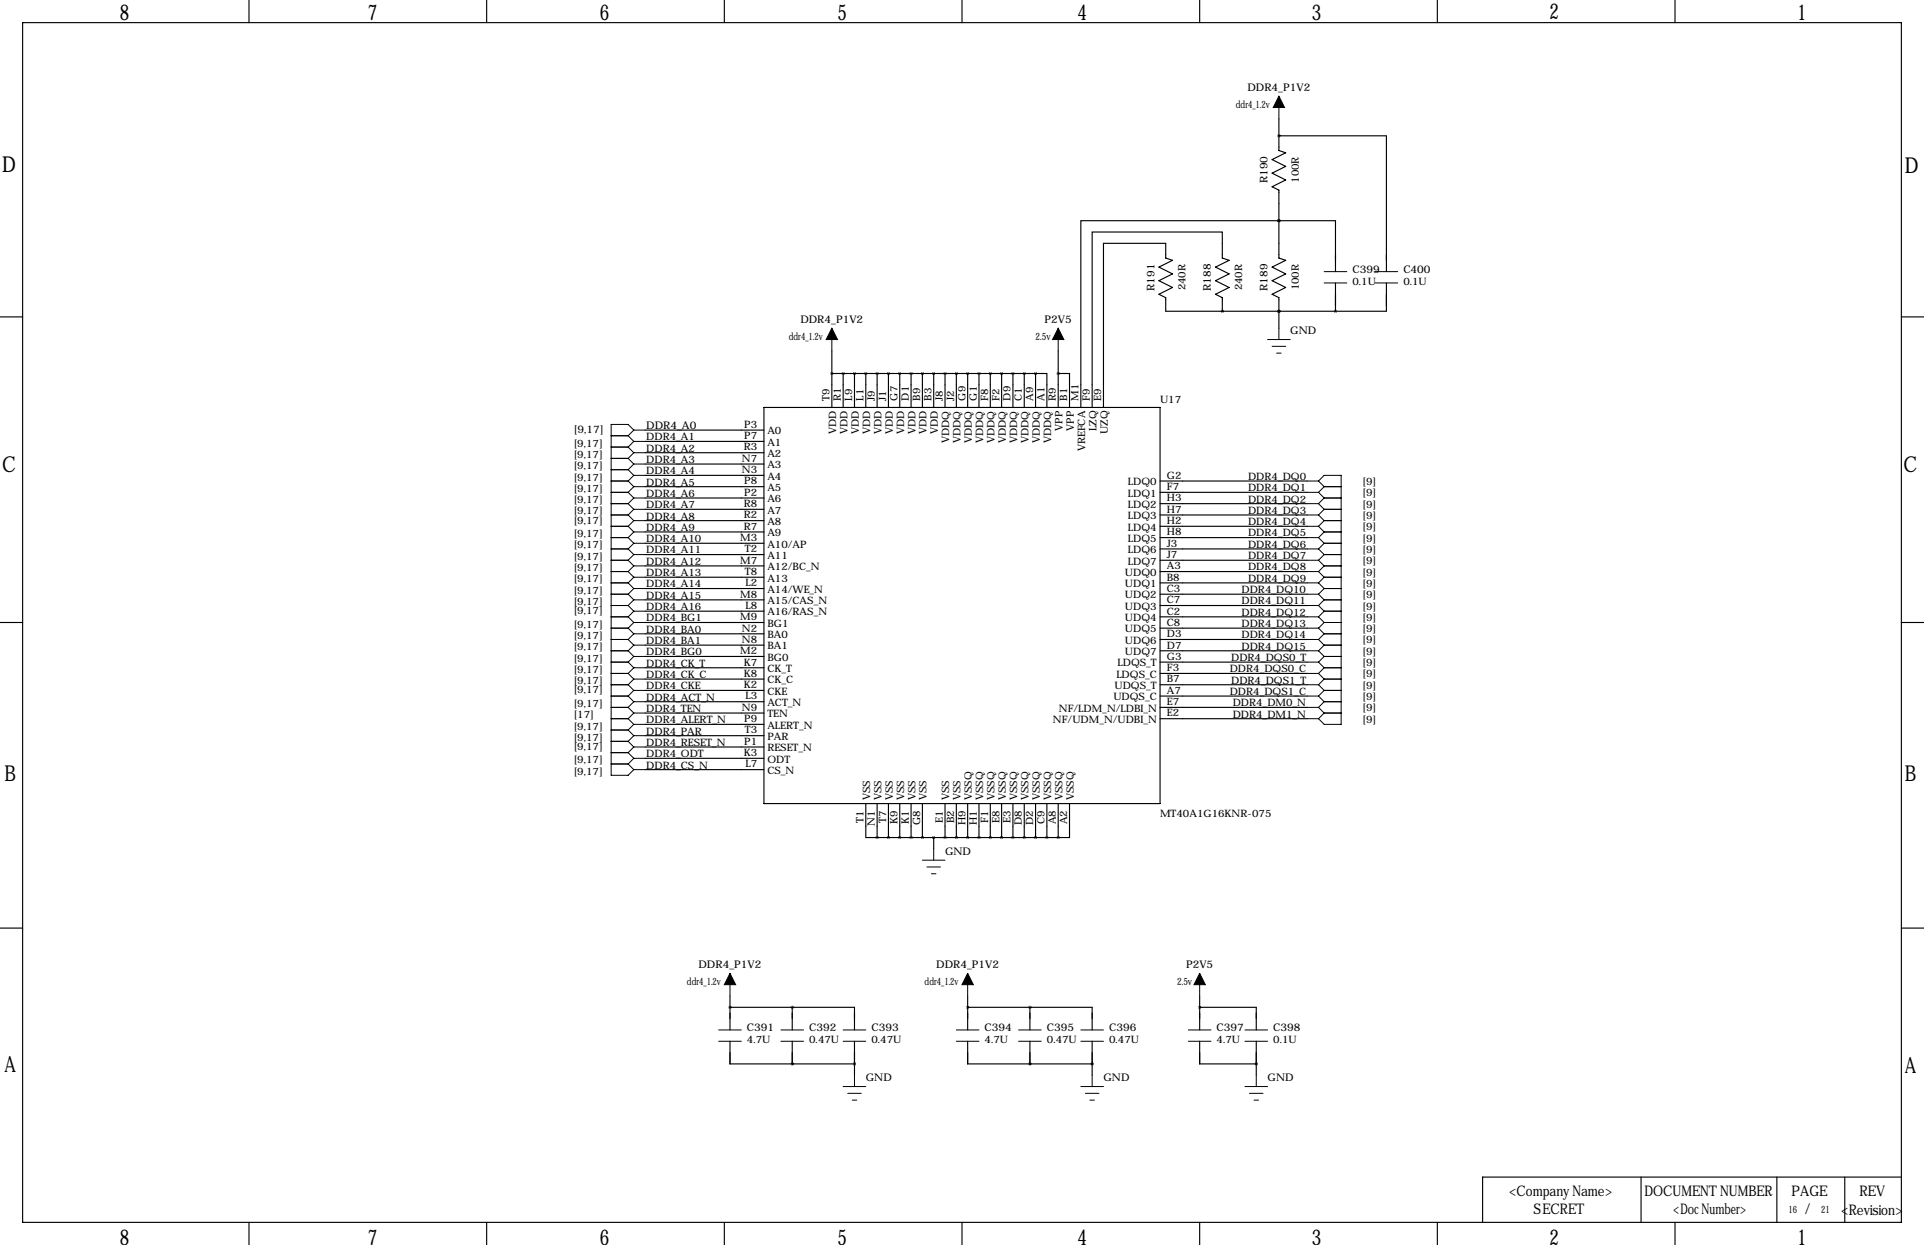
[picture p28: page 16]

D

D

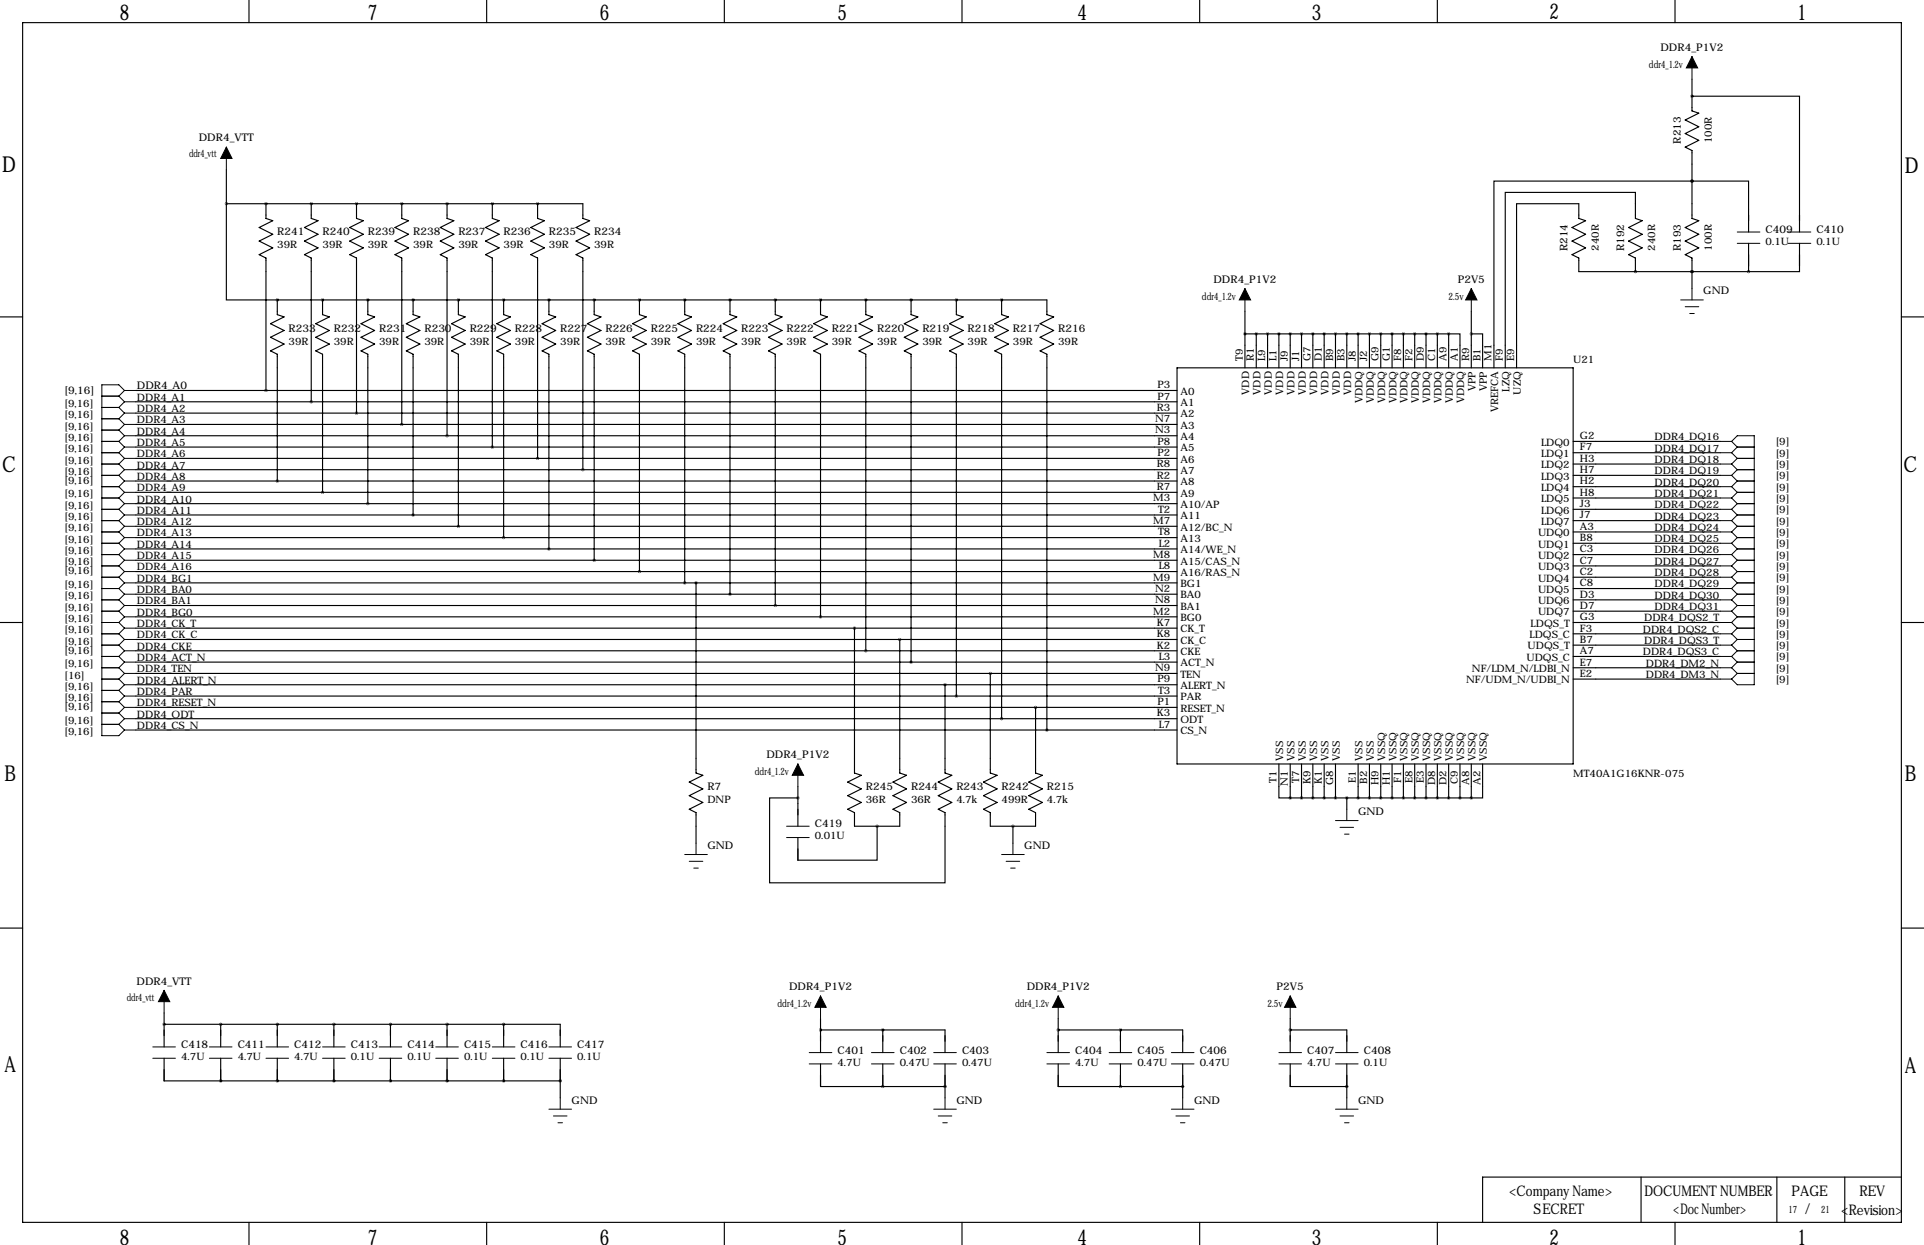
[picture p29: page 17]

D
D

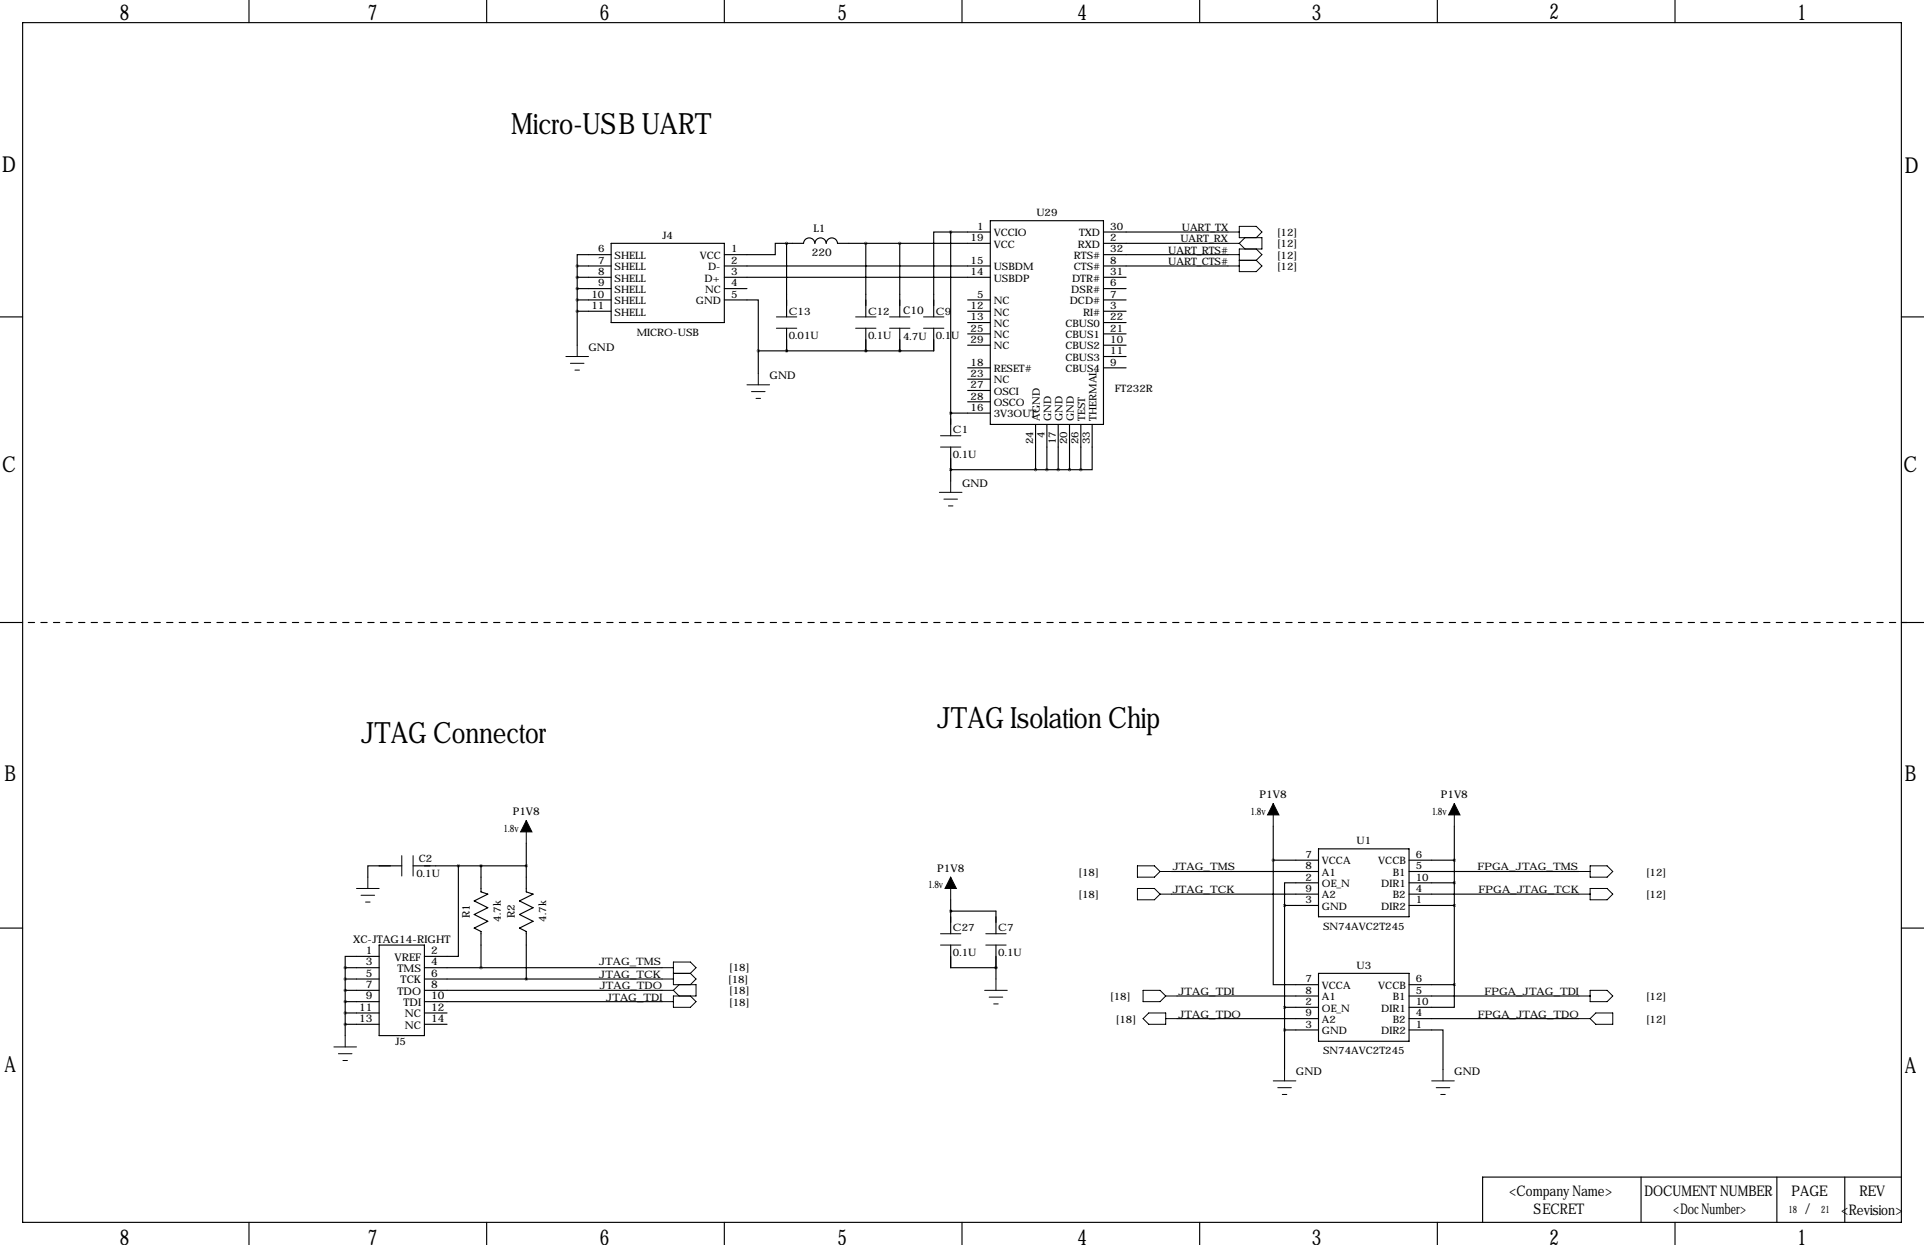
[picture p30: page 18]

D
D

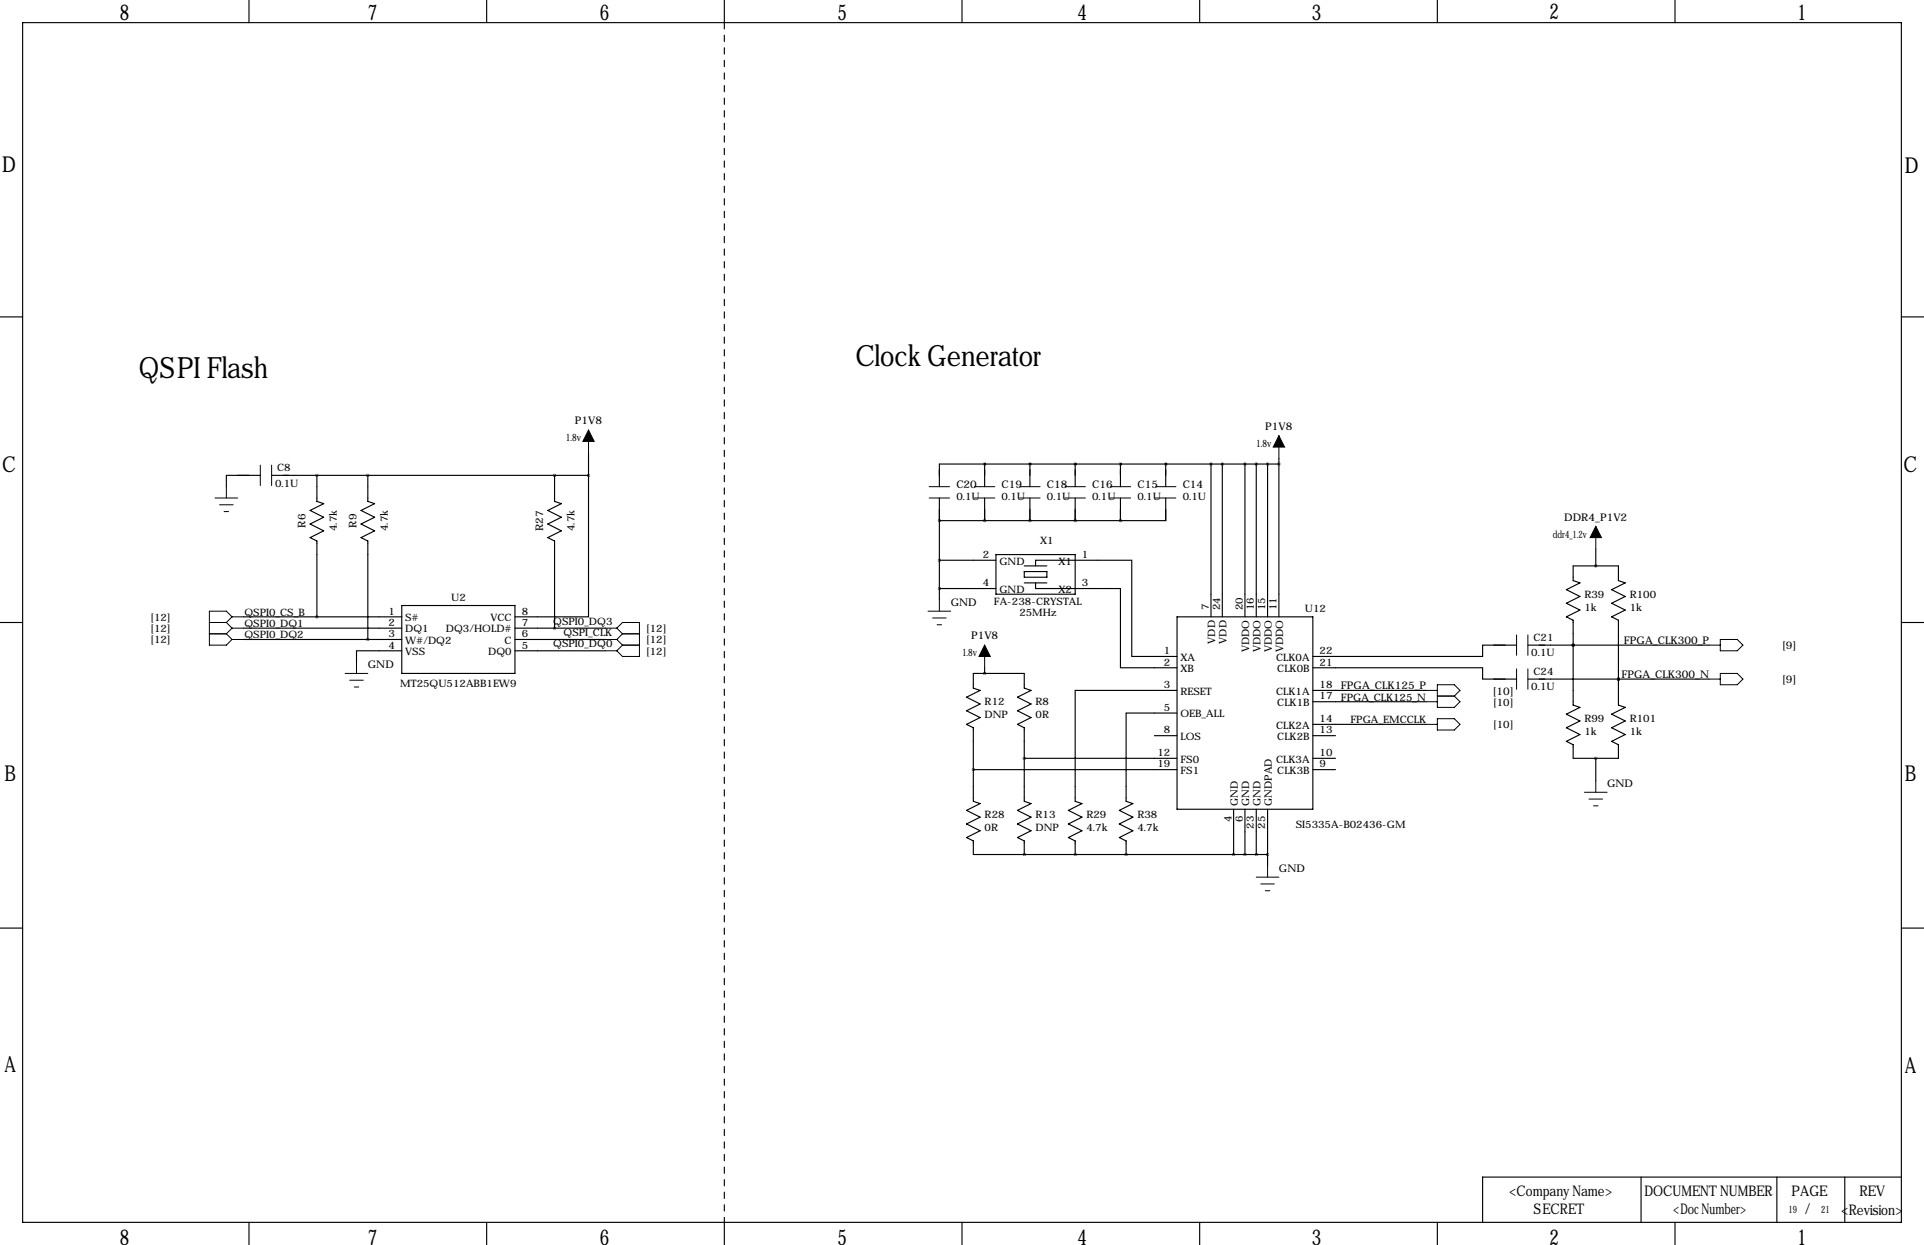
[picture p31: page 19]

Clock Generator QSPI Flash

D
D

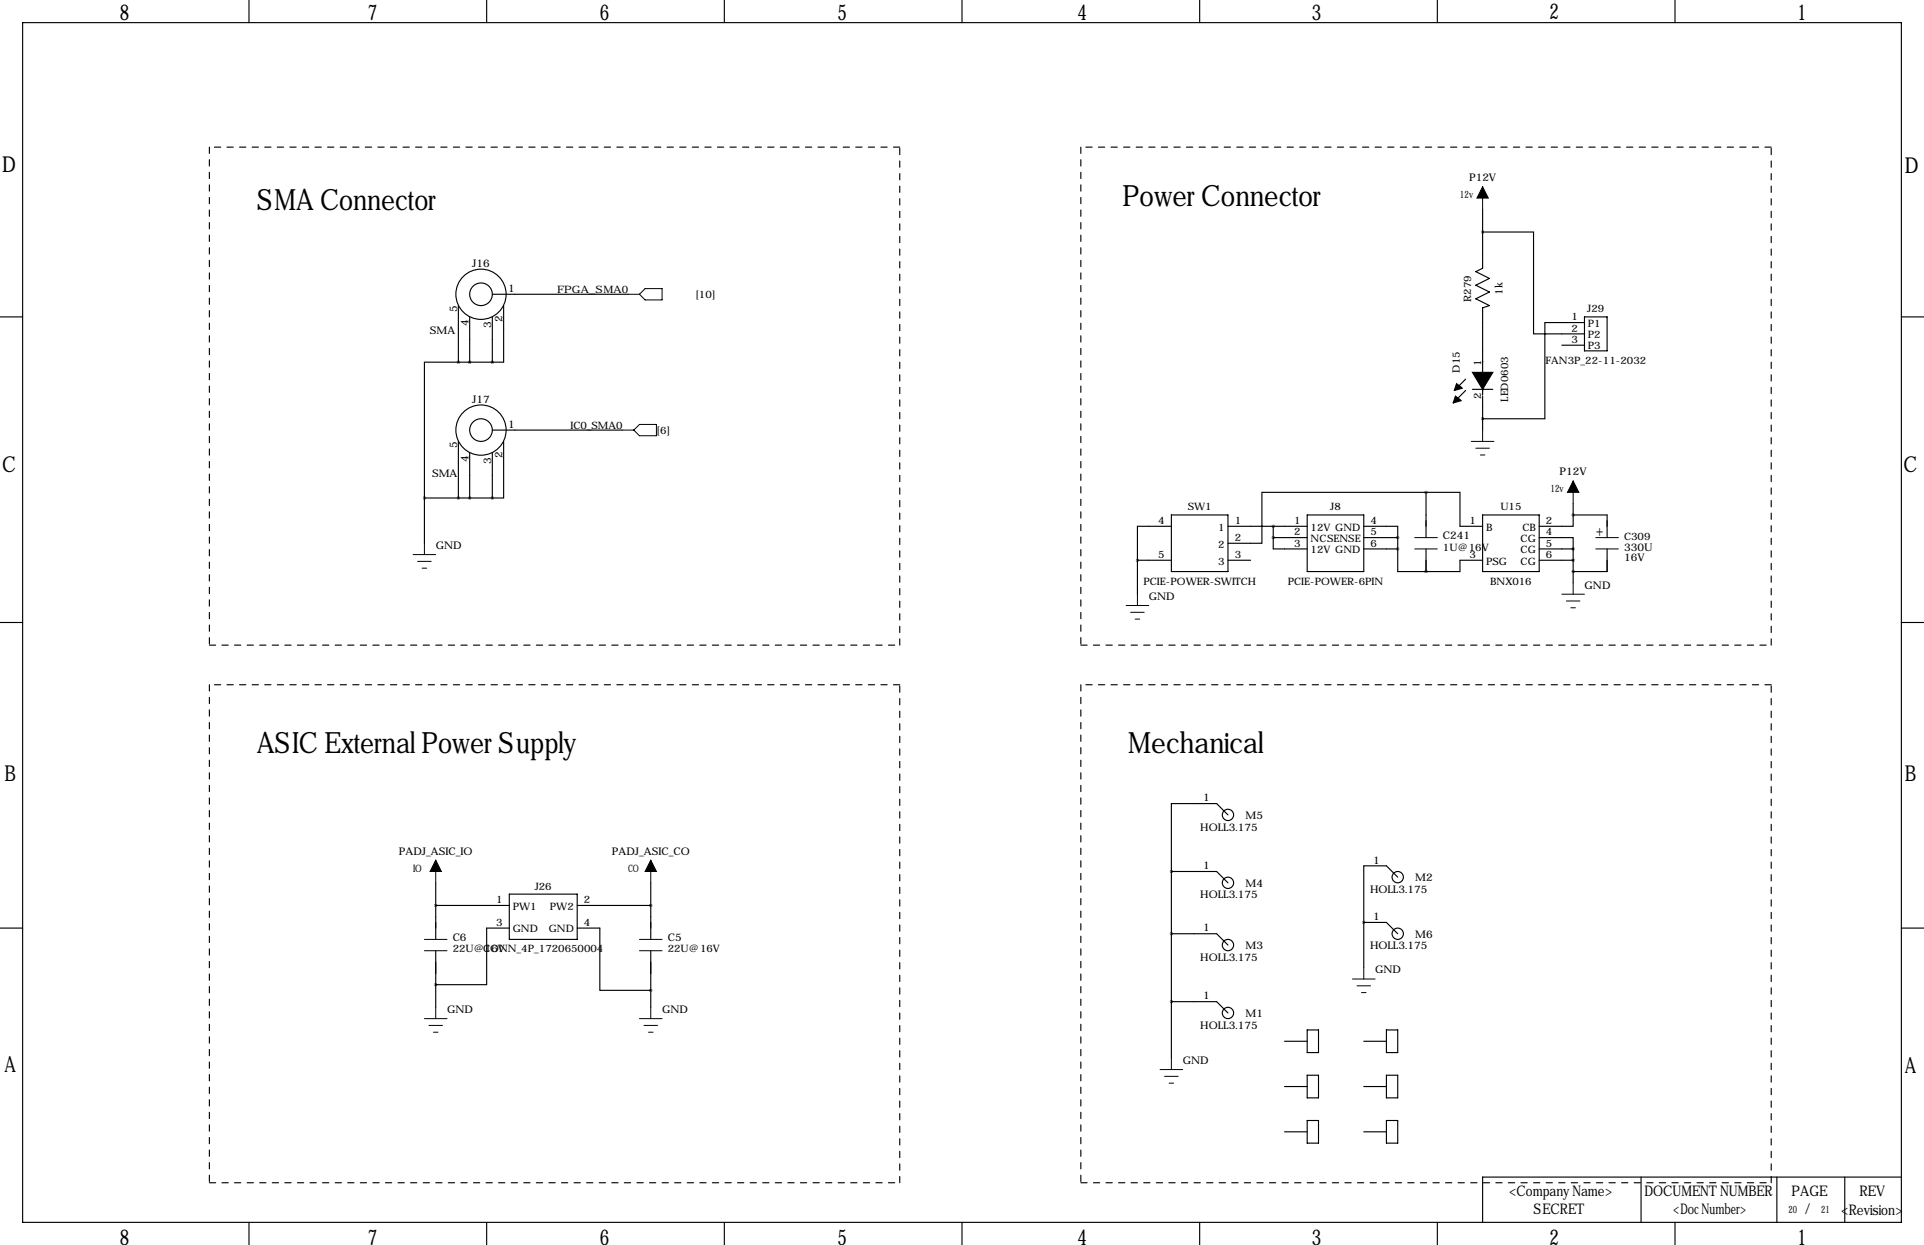
[picture p32: page 20]

ASIC External Power Supply

D
D

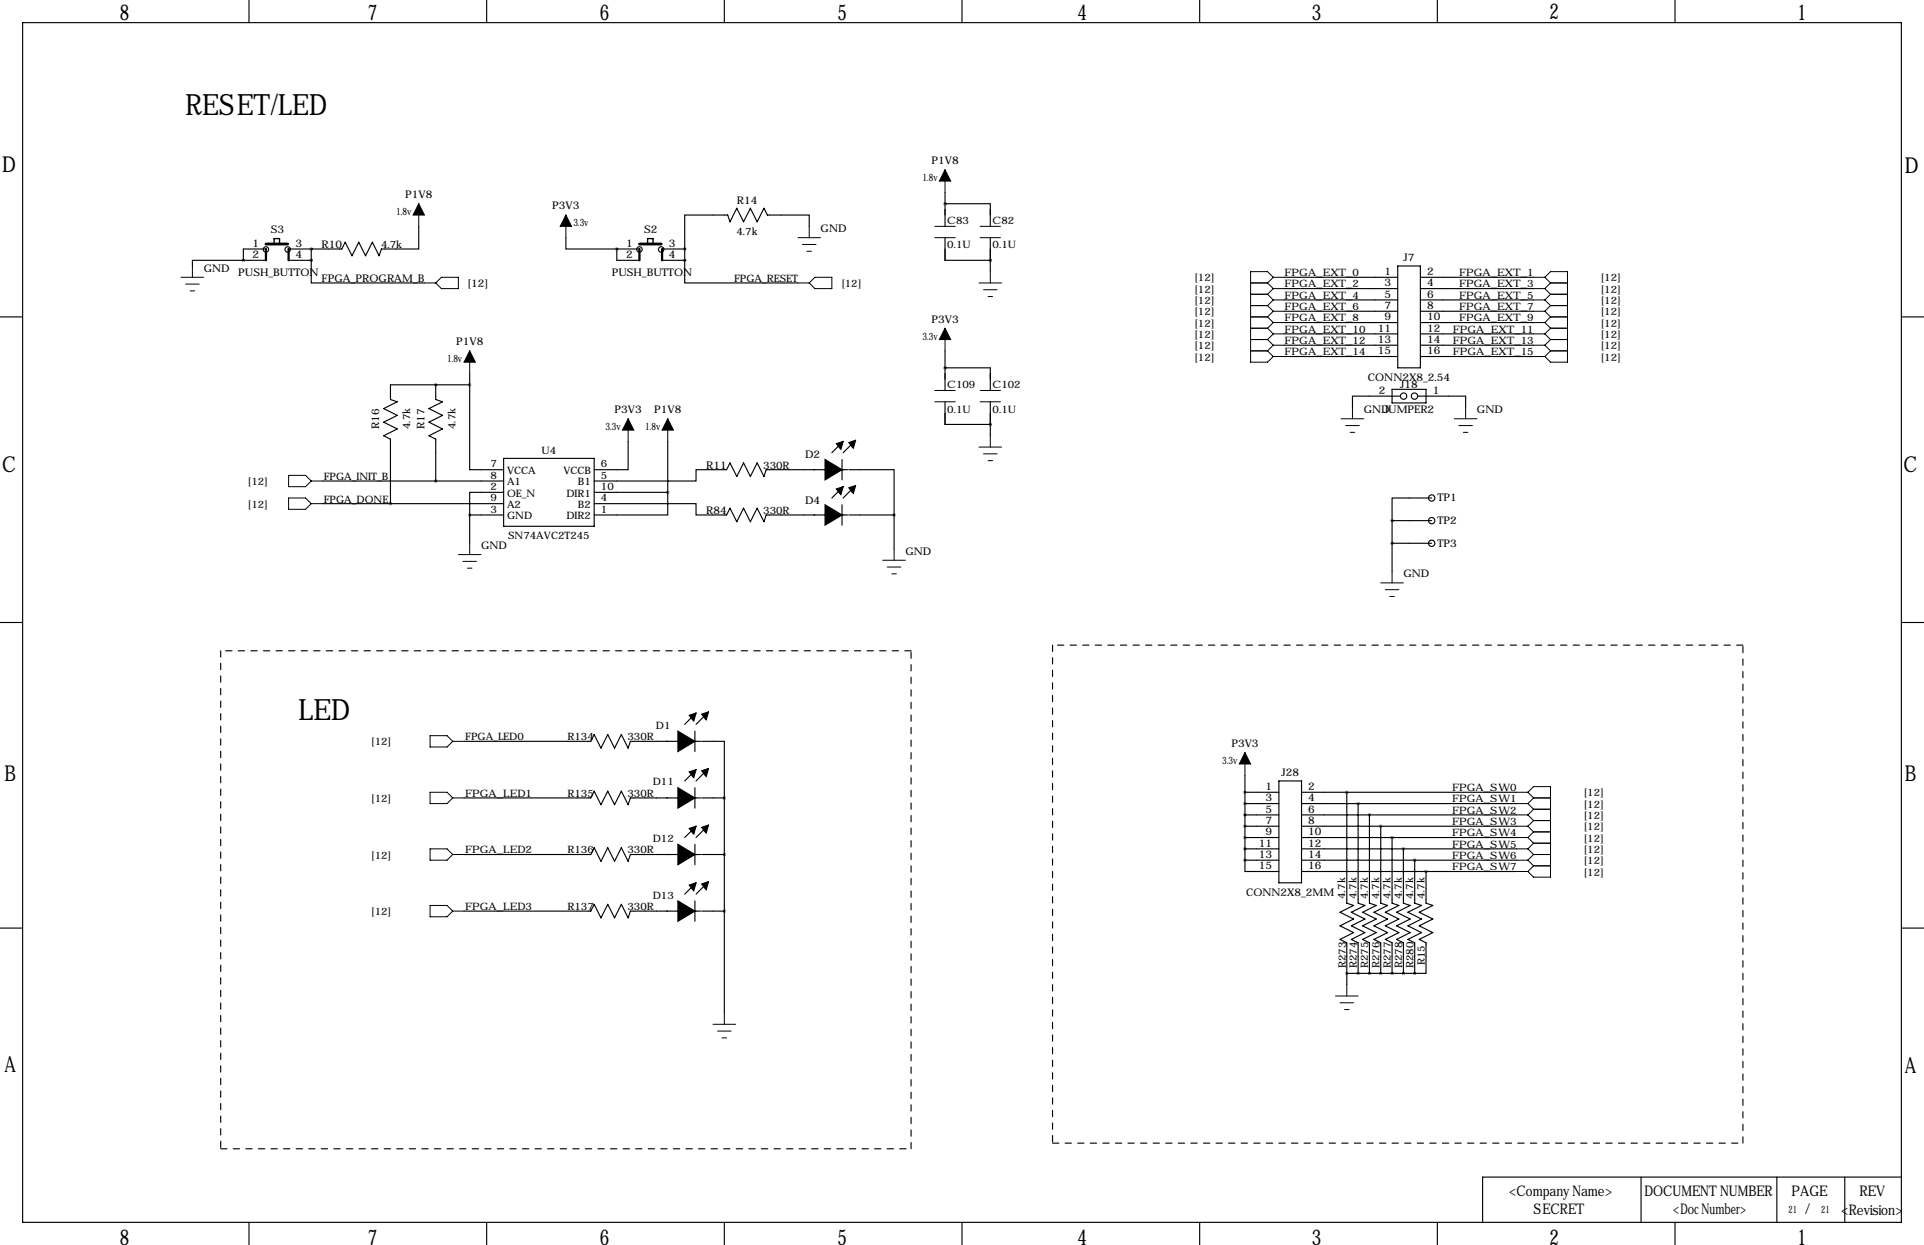
[picture p33: page 21]
