bespoke-silicon-group/bsg_motherboards/t_rex/v1/pcb_development/pcb_design/top.pdf

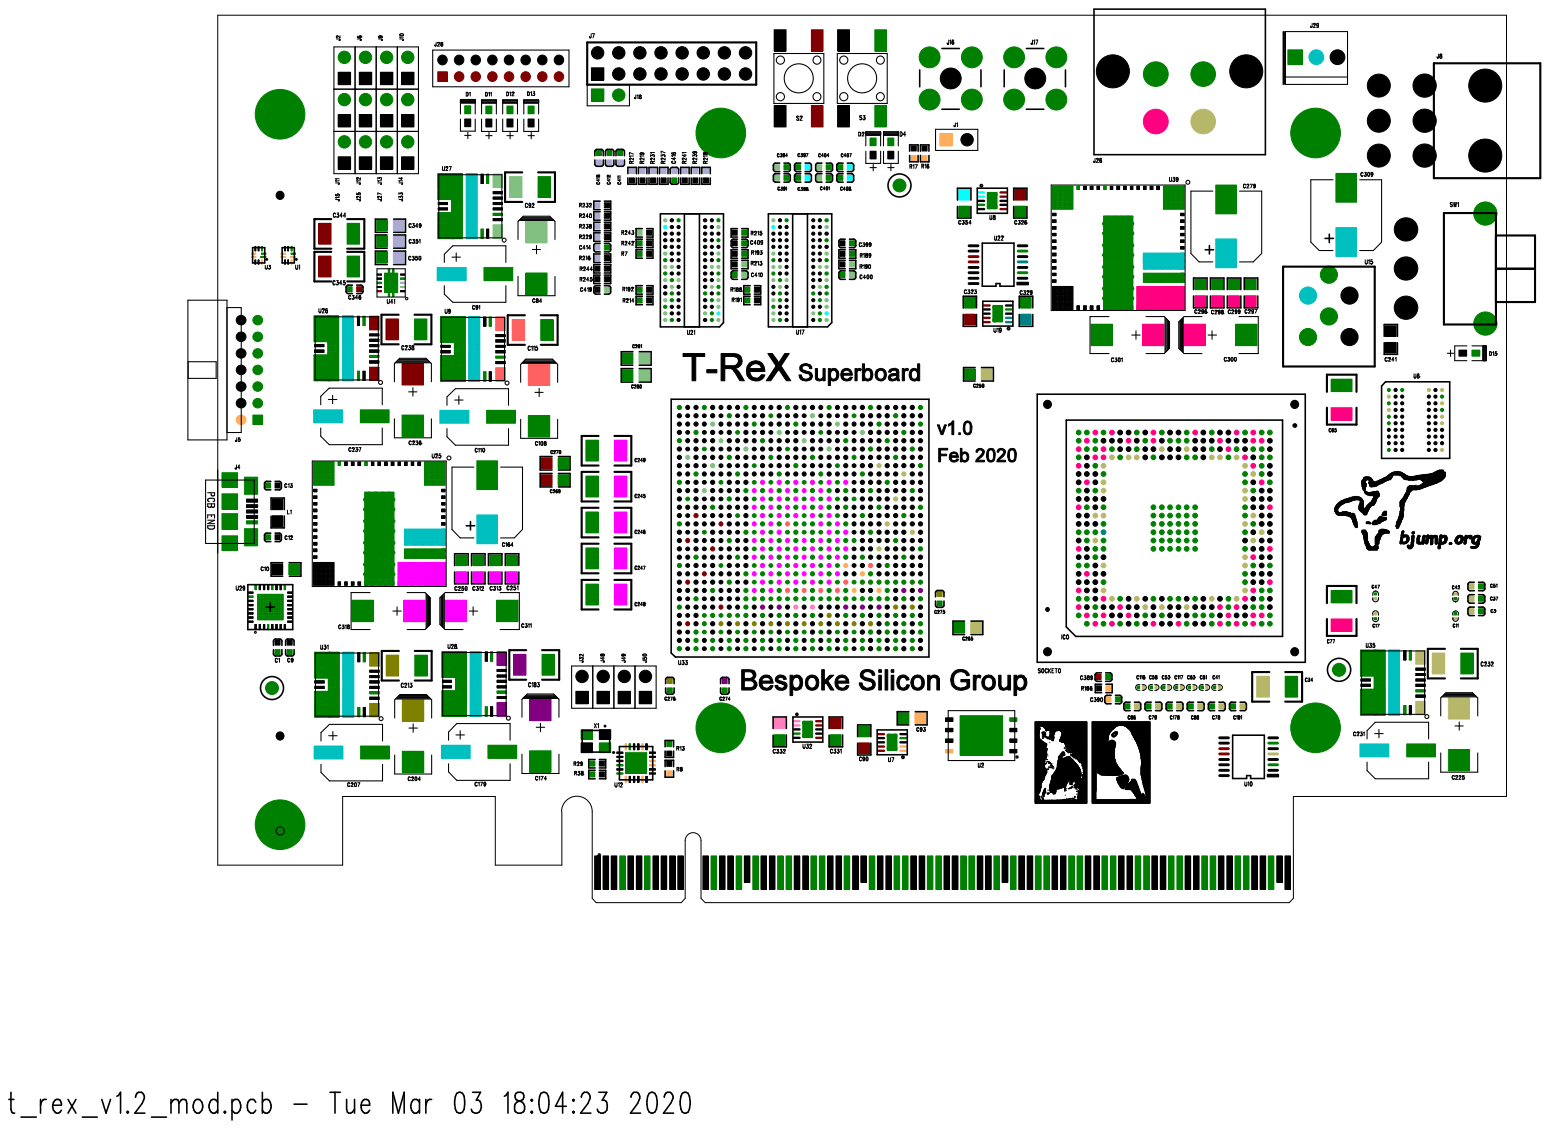
[picture p34: page 1]
