bespoke-silicon-group/bsg_motherboards/bsg_trouble/double_trouble/pcb_development/pcb_design/1.pdf

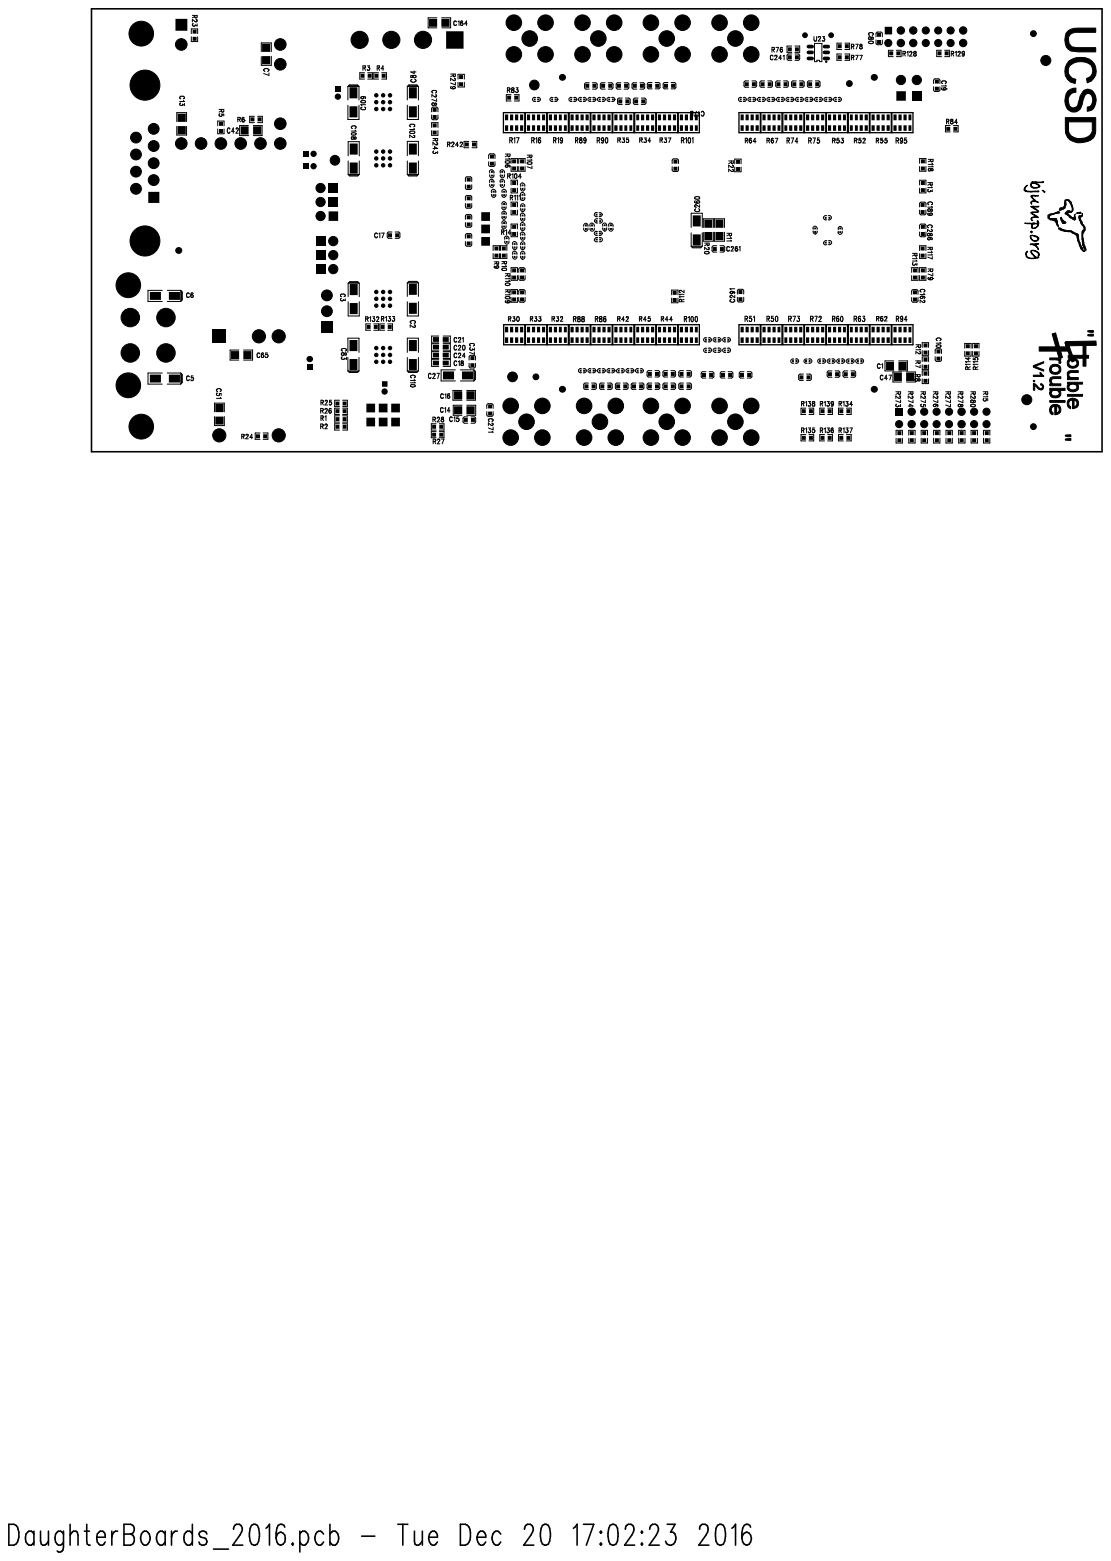
[picture p35: page 1]
