bespoke-silicon-group/bsg_motherboards/bsg_trouble/double_trouble/pcb_development/pcb_design/2.pdf

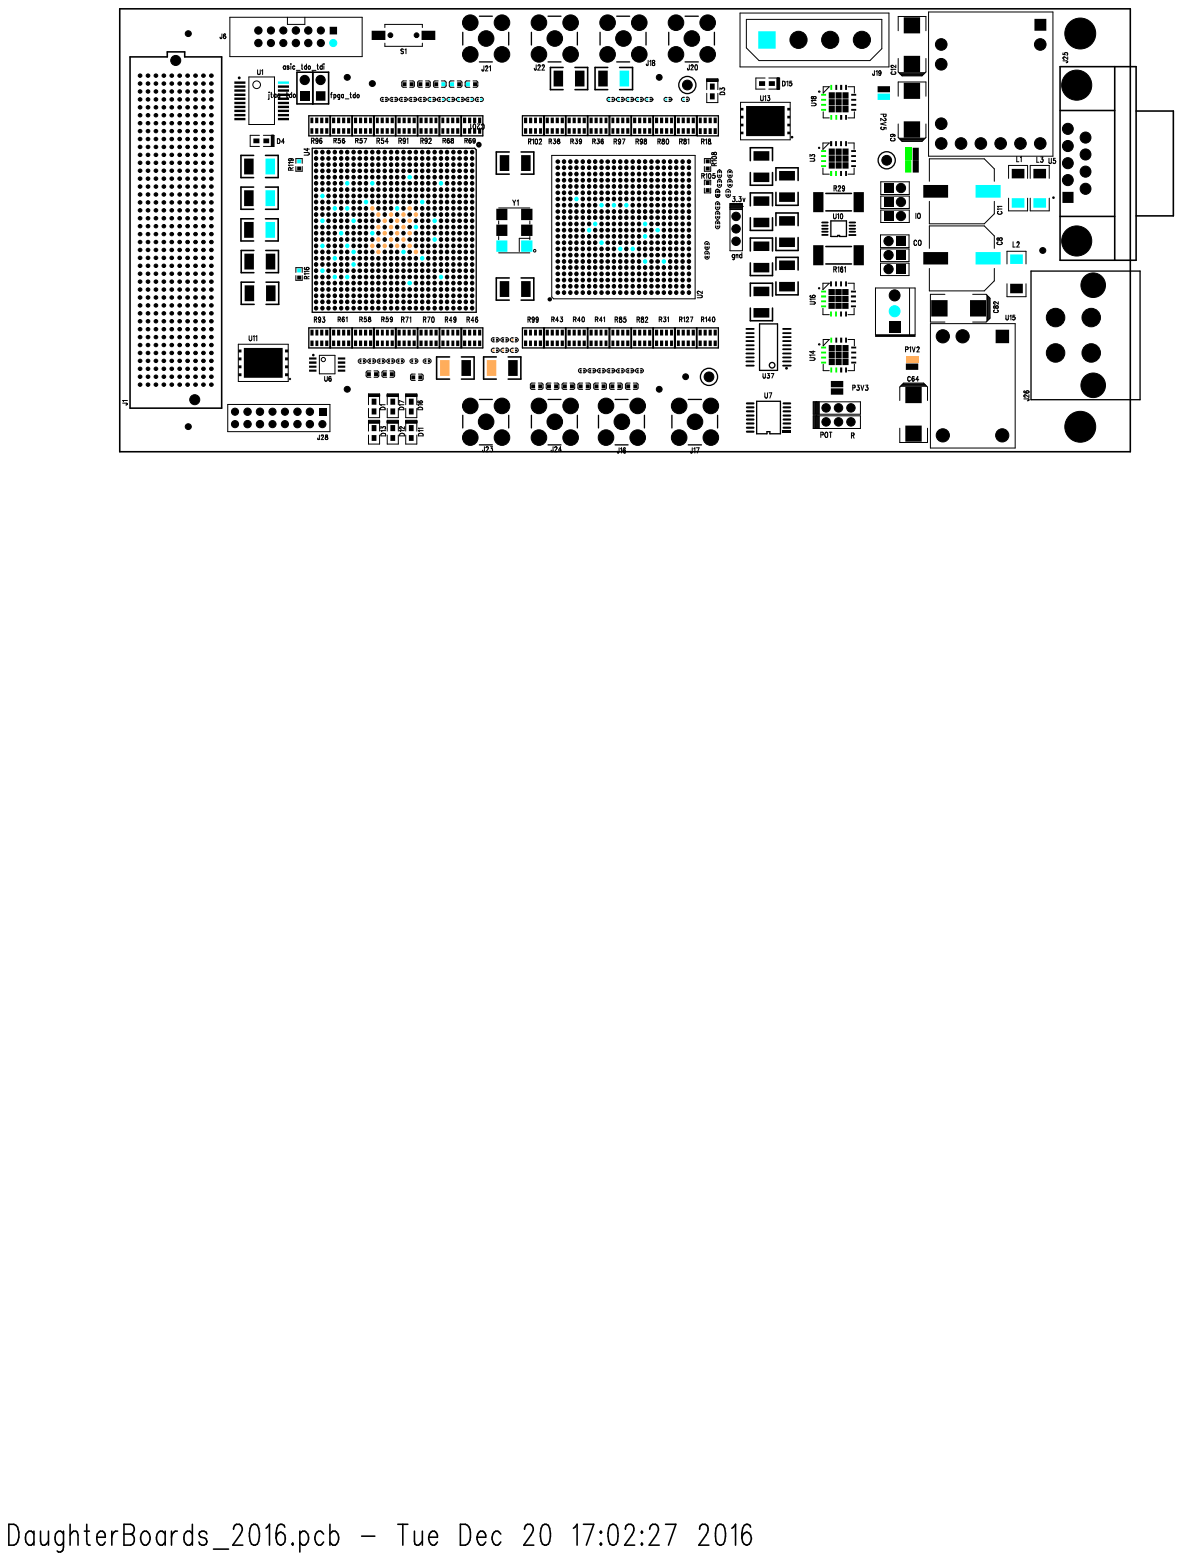
[picture p36: page 1]
