bespoke-silicon-group/bsg_motherboards/bsg_trouble/double_trouble/pcb_development/pcb_design/DaughterBoards_2016.pdf

D
D

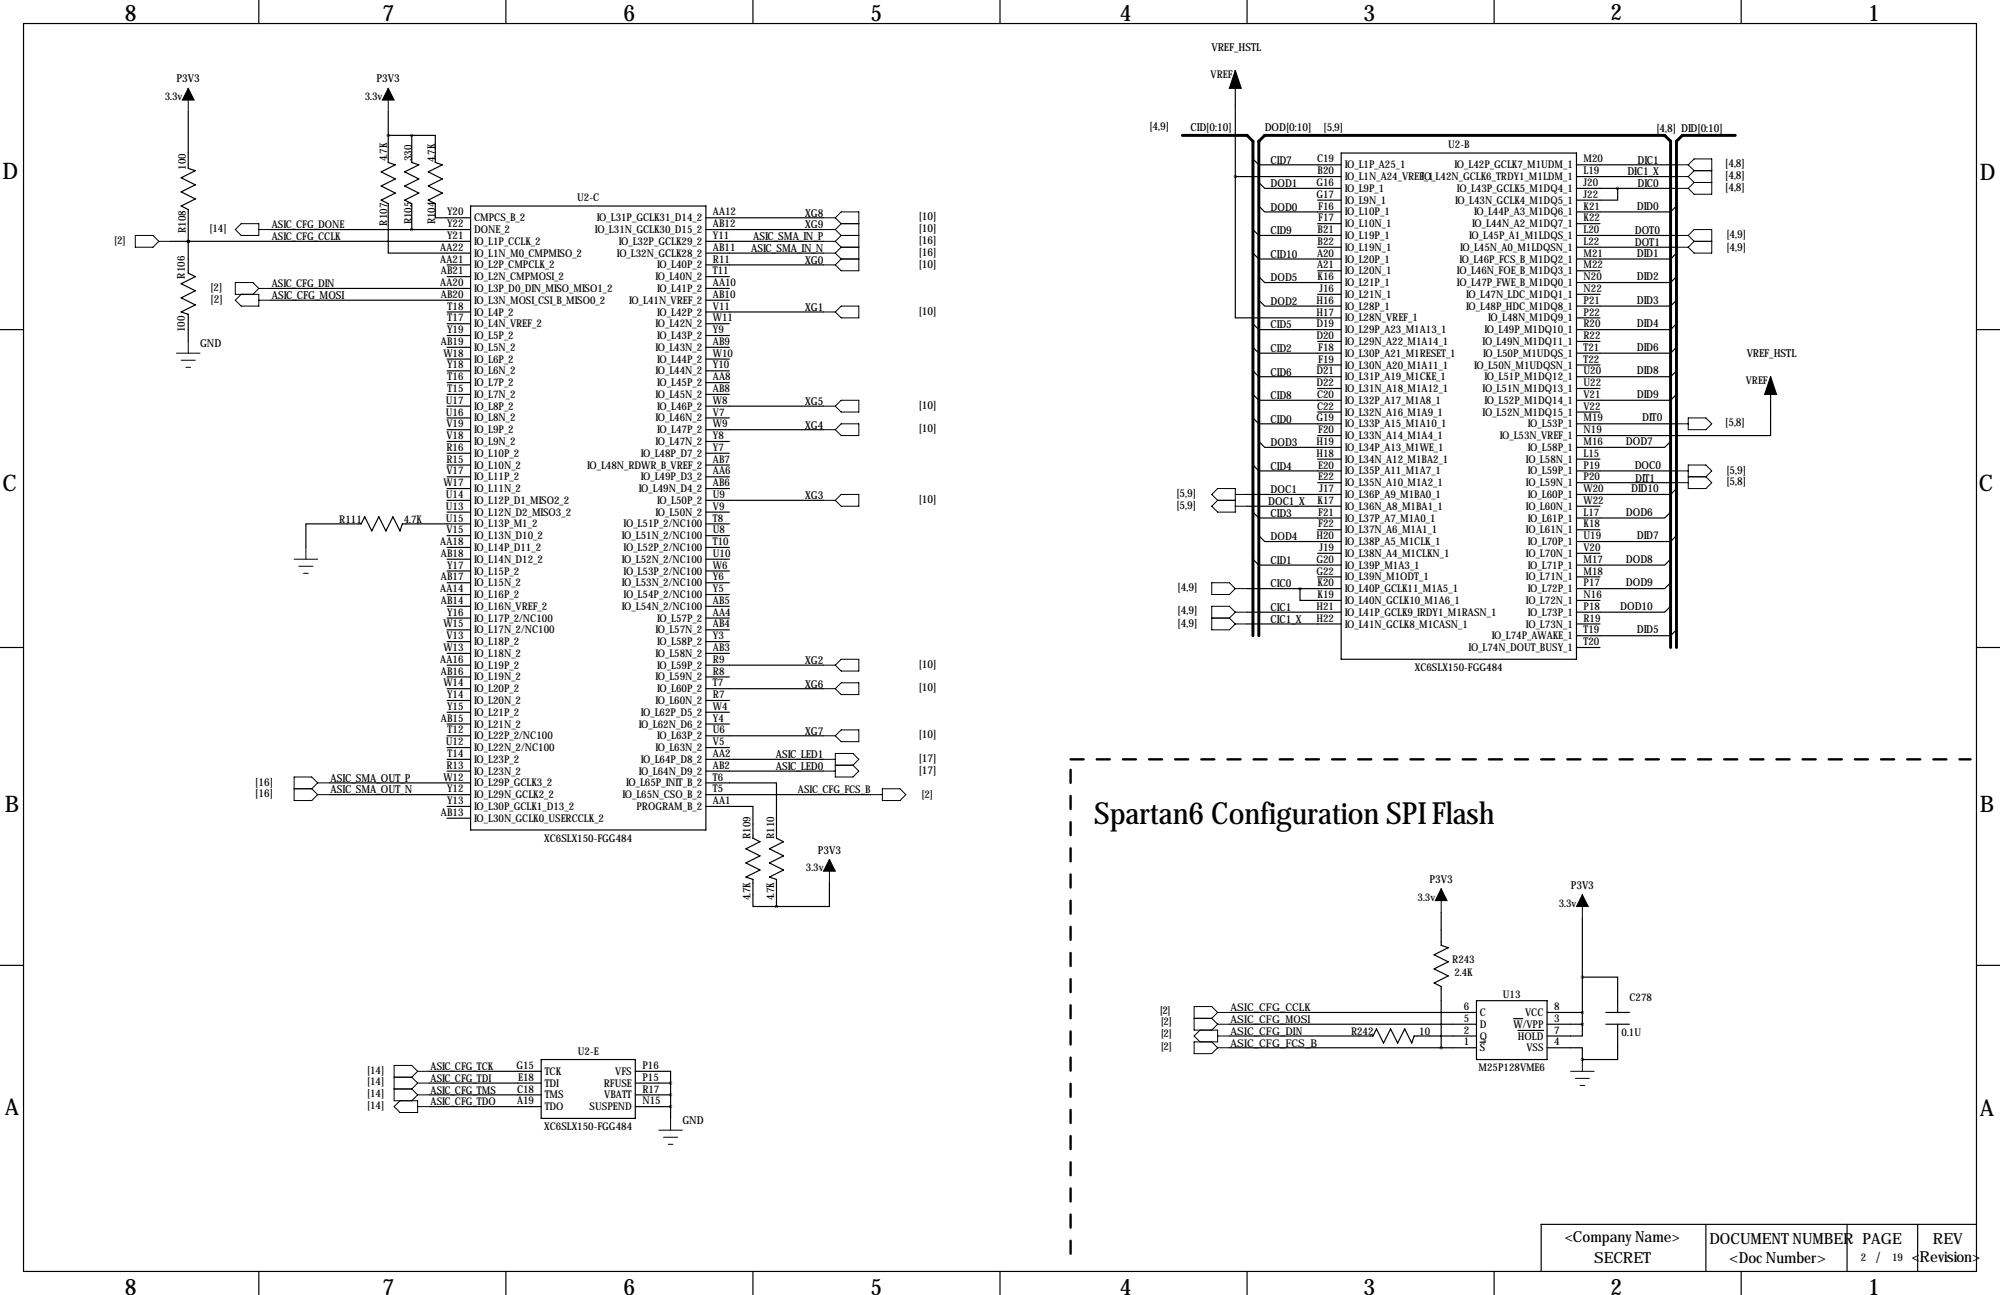
[picture p37: page 1]

# DCBA

# ABCD

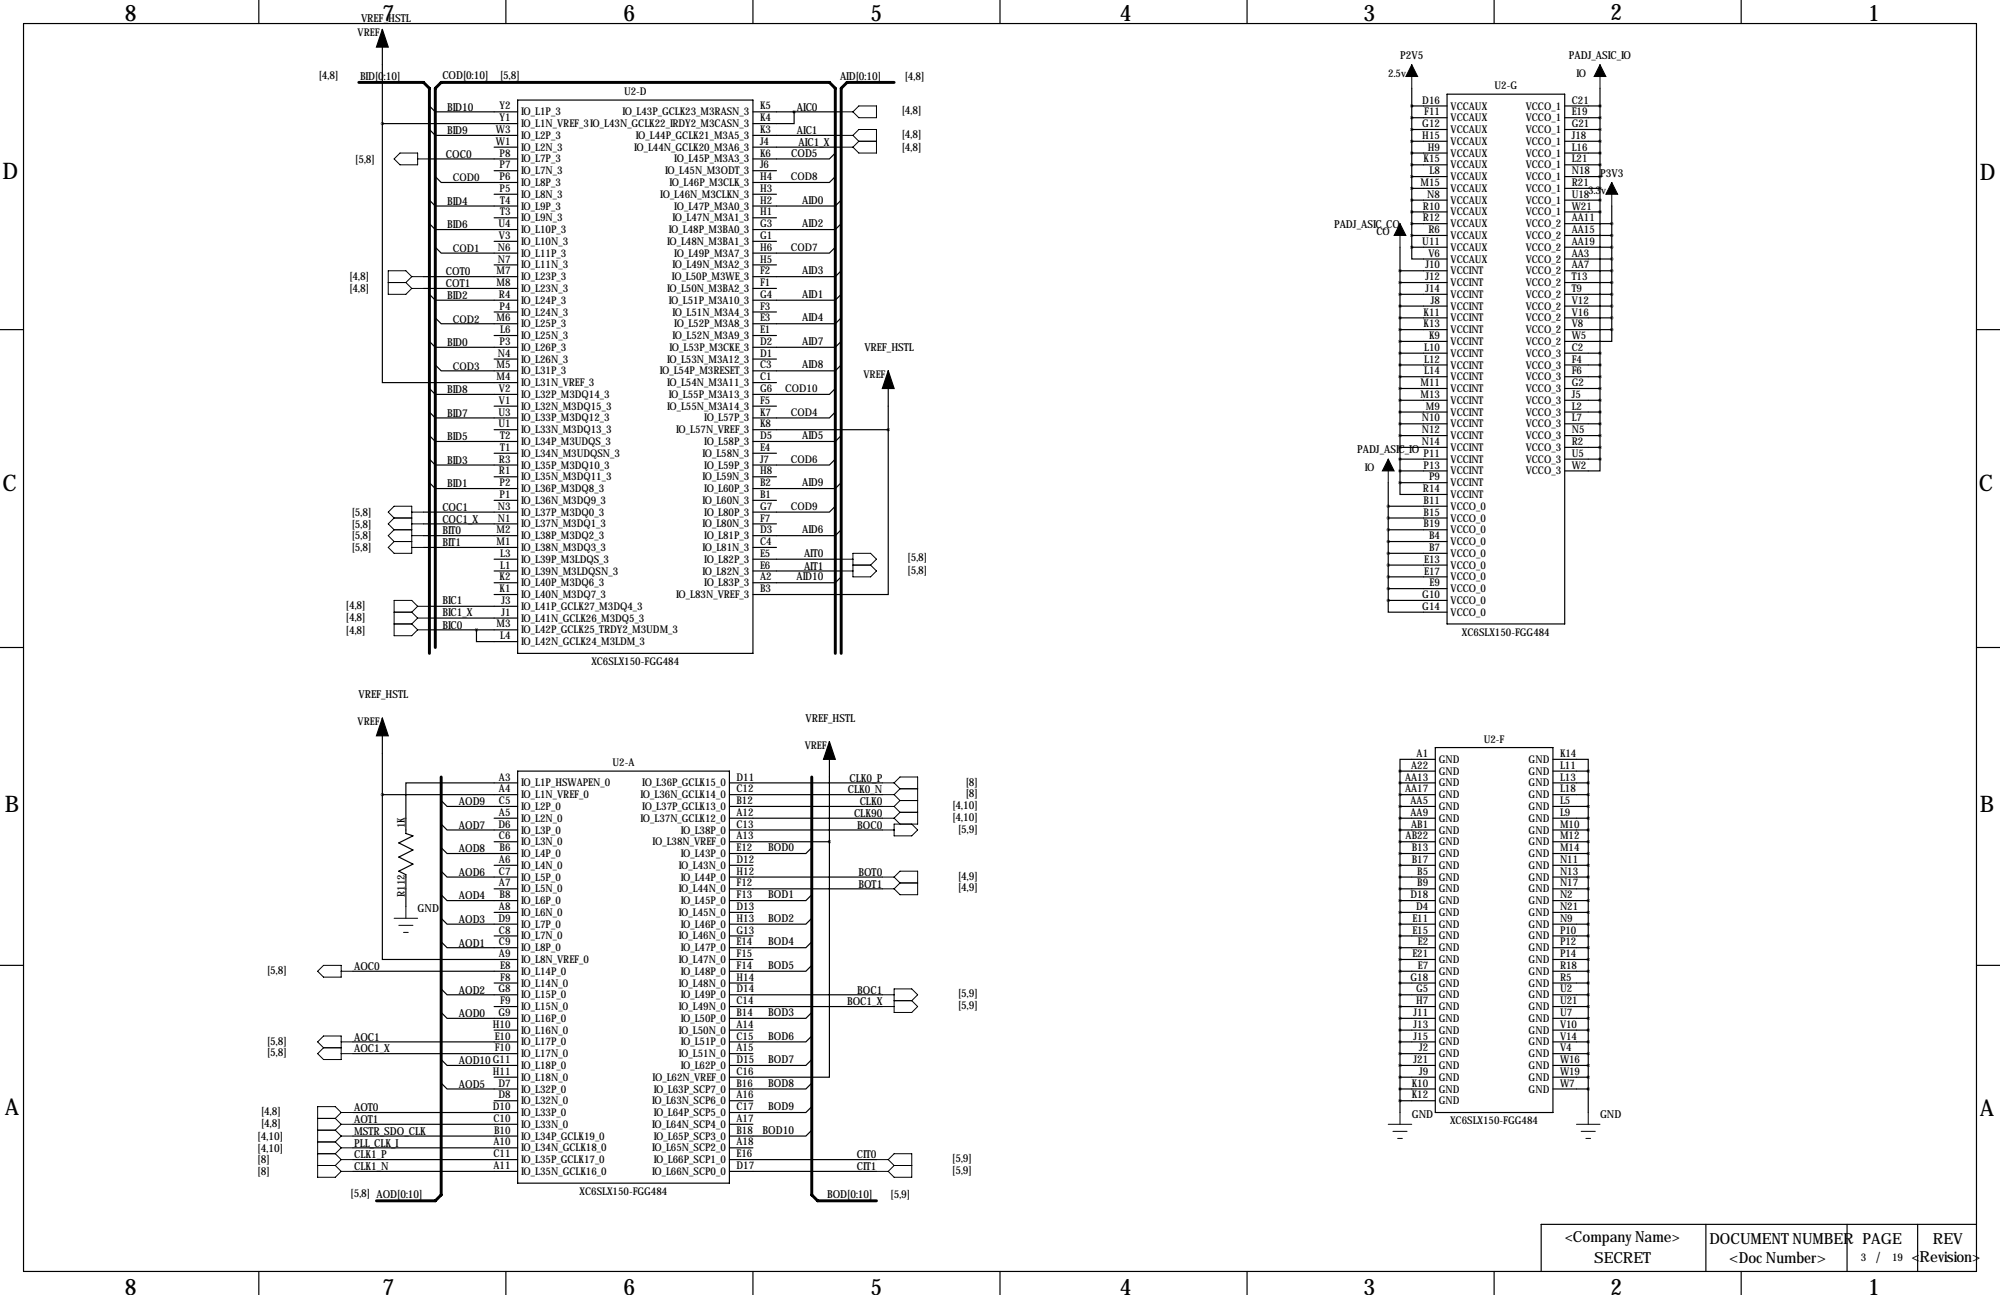
[picture p38: page 2]

D
D

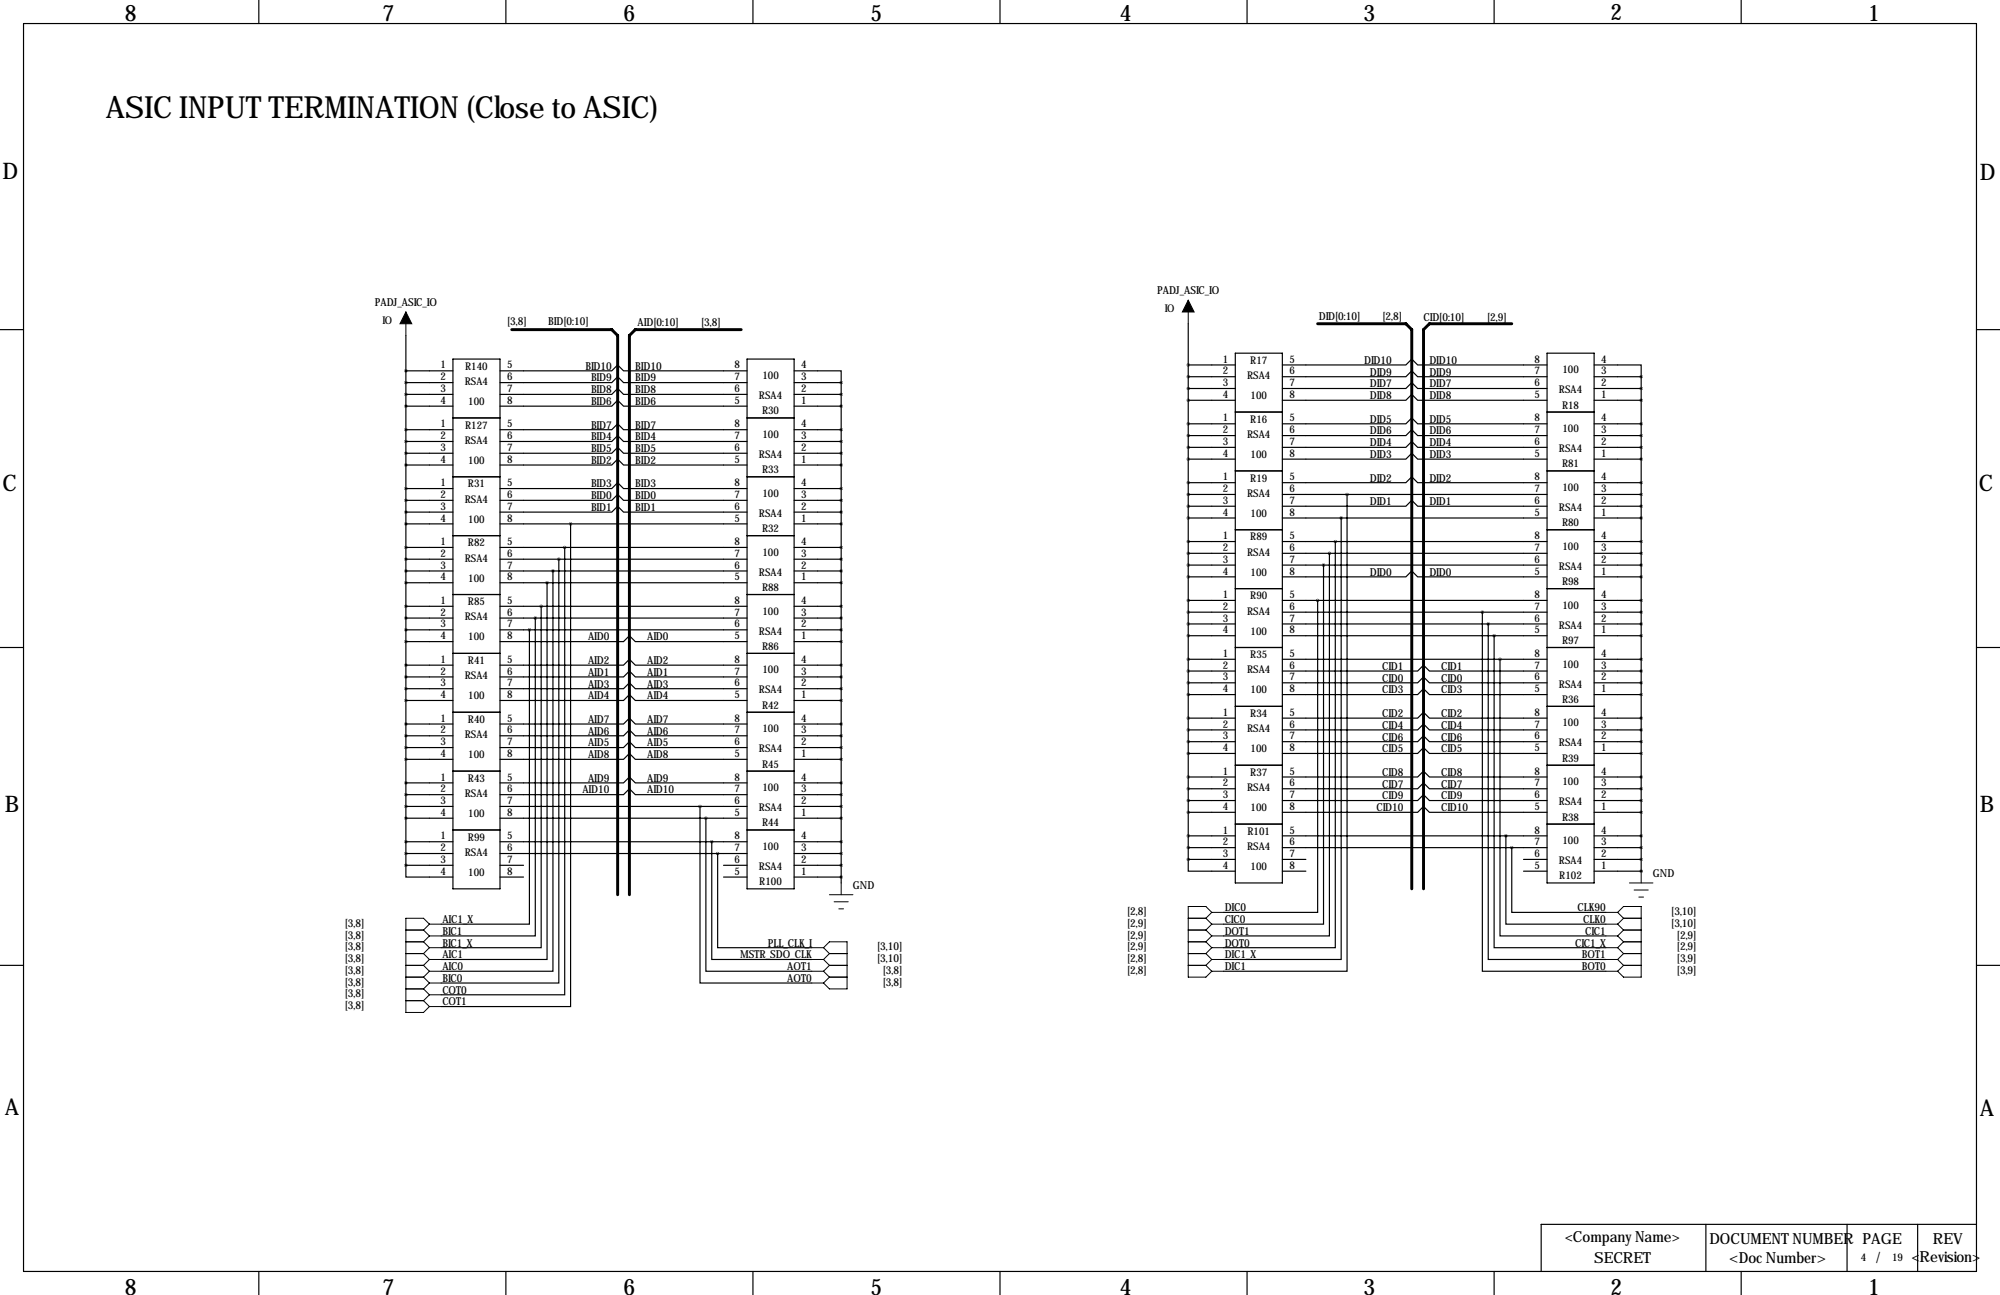
[picture p39: page 3]

ASIC INPUT TERMINATION (Close to ASIC)

D
D

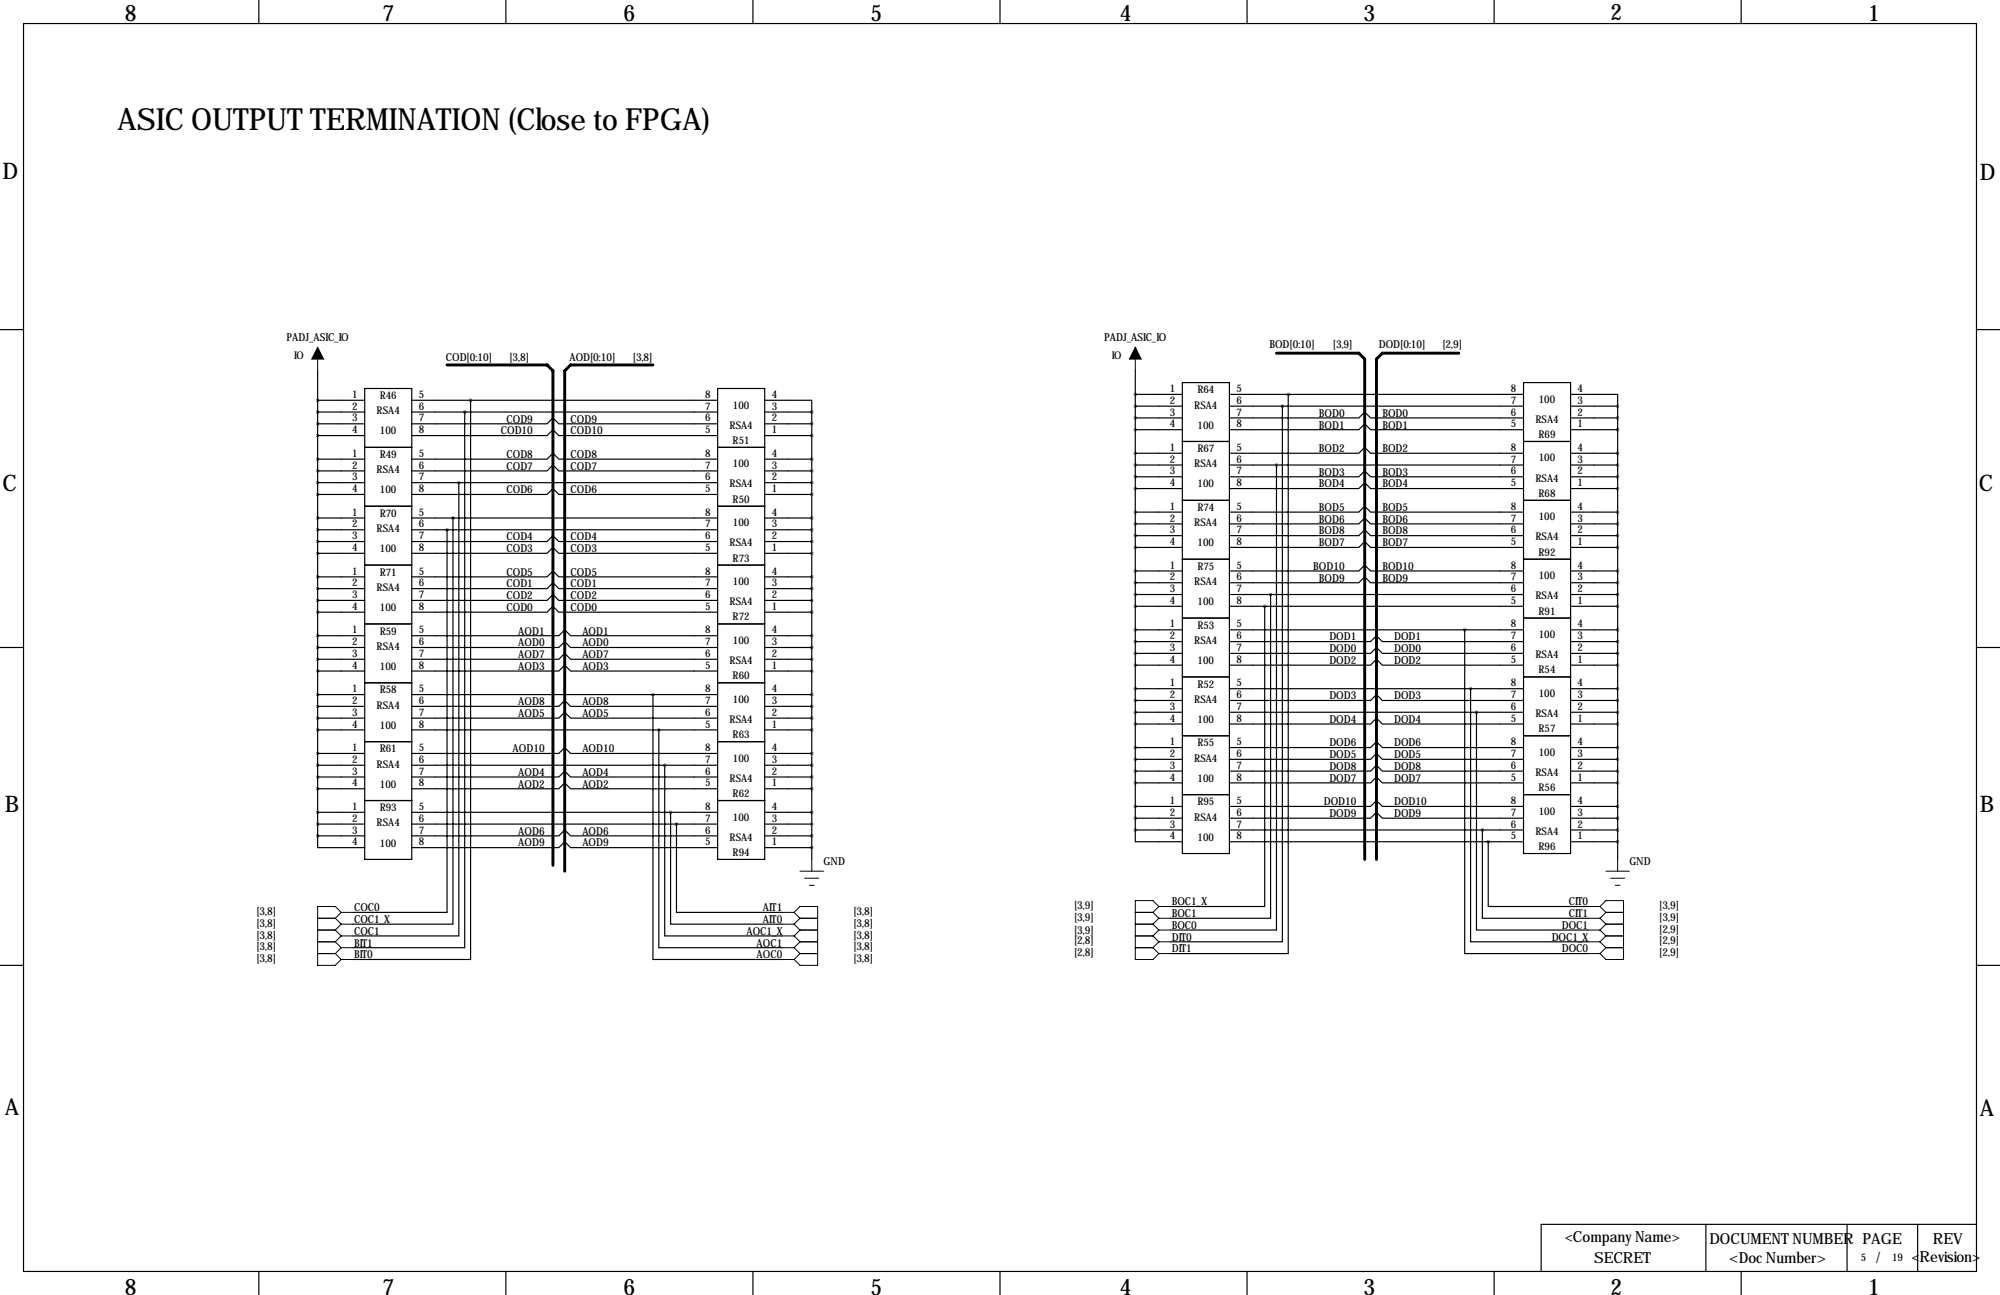
[picture p40: page 4]

ASIC OUTPUT TERMINATION (Close to FPGA)

D
D

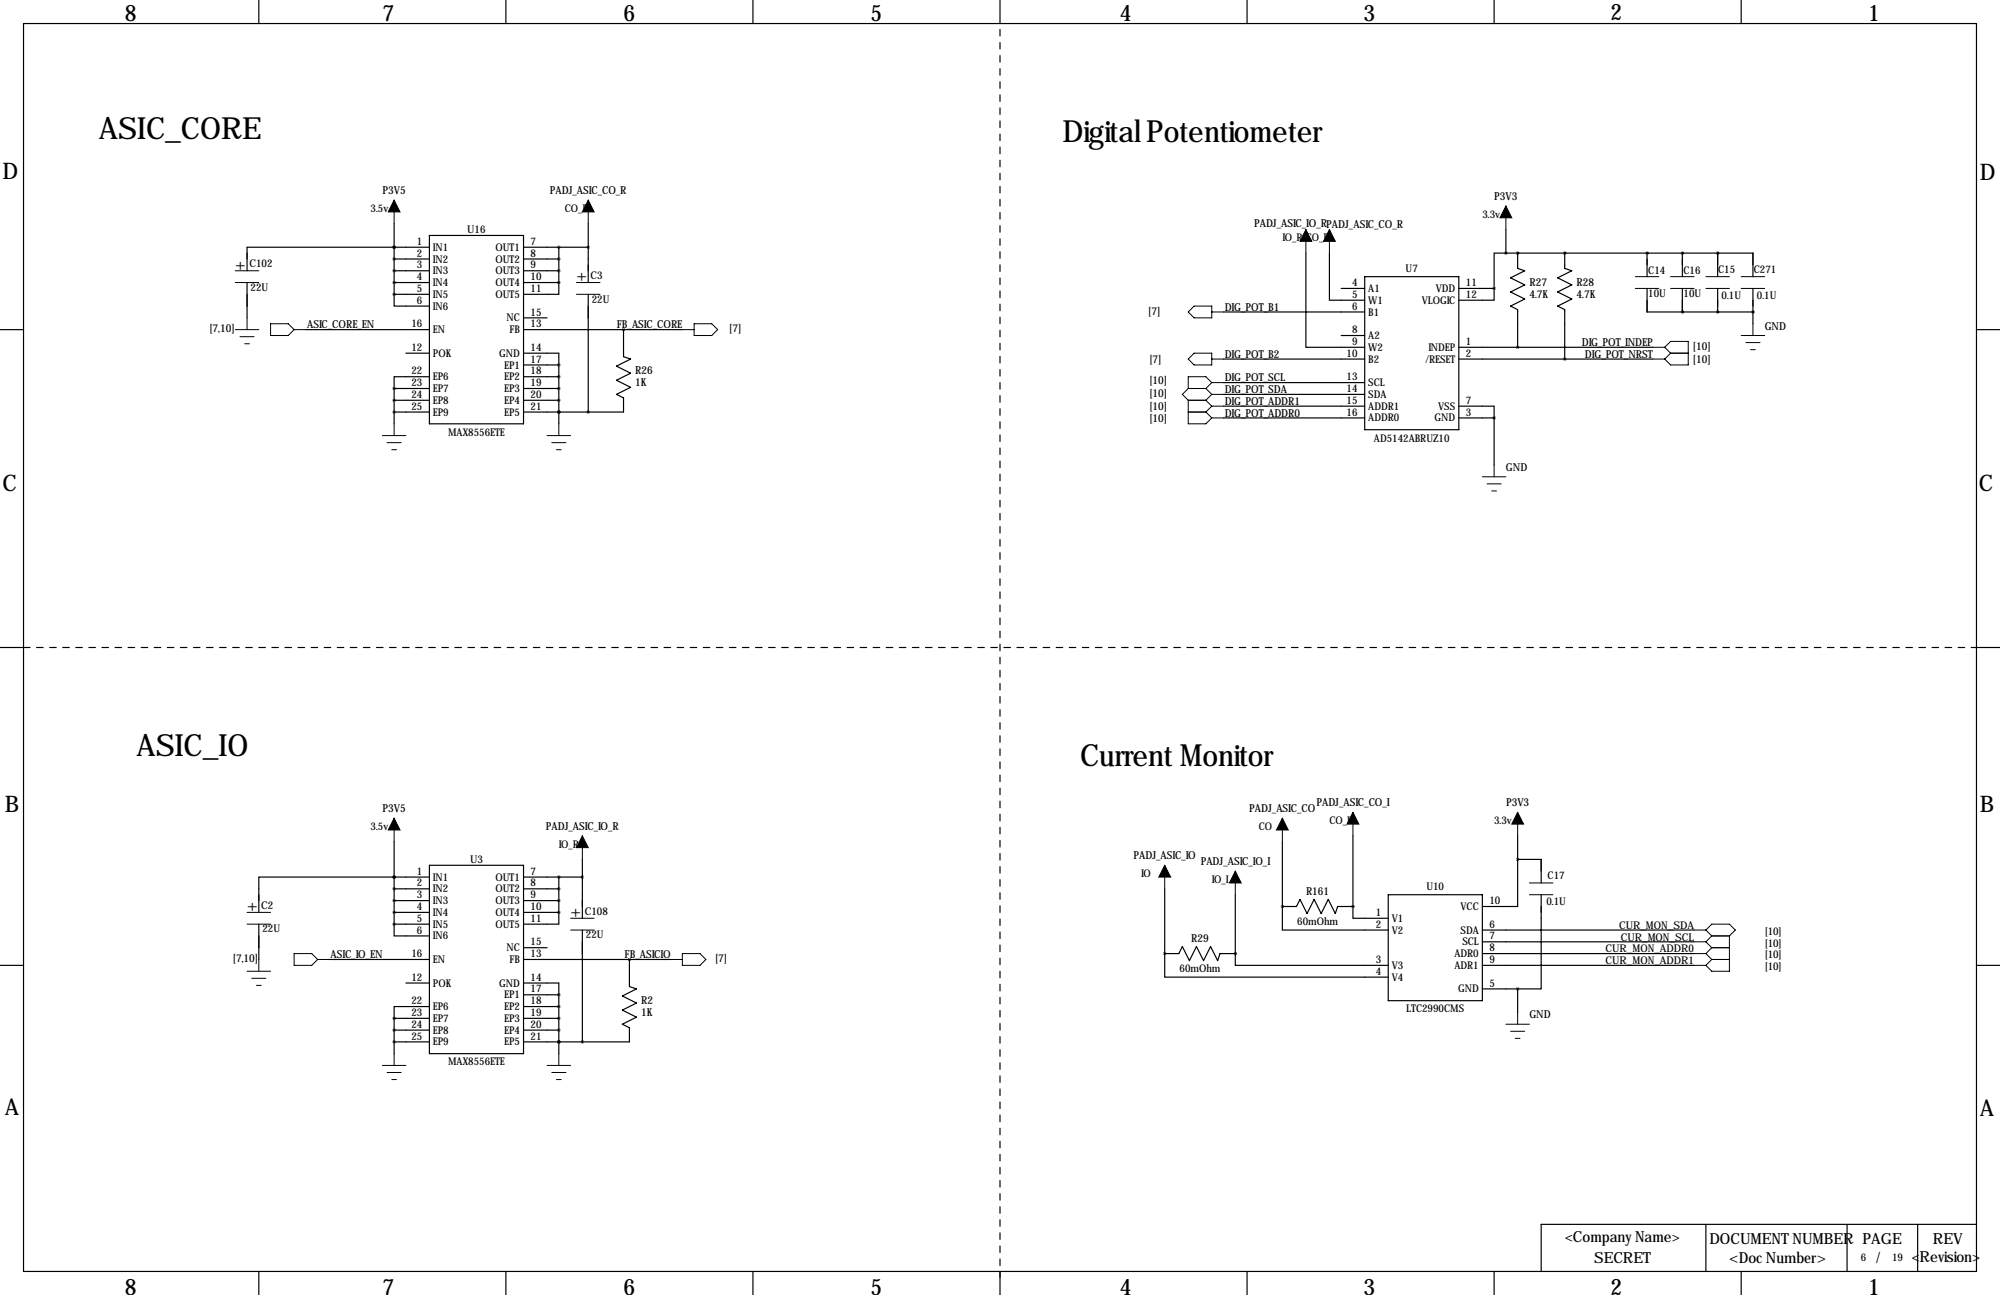
[picture p41: page 5]

D
D

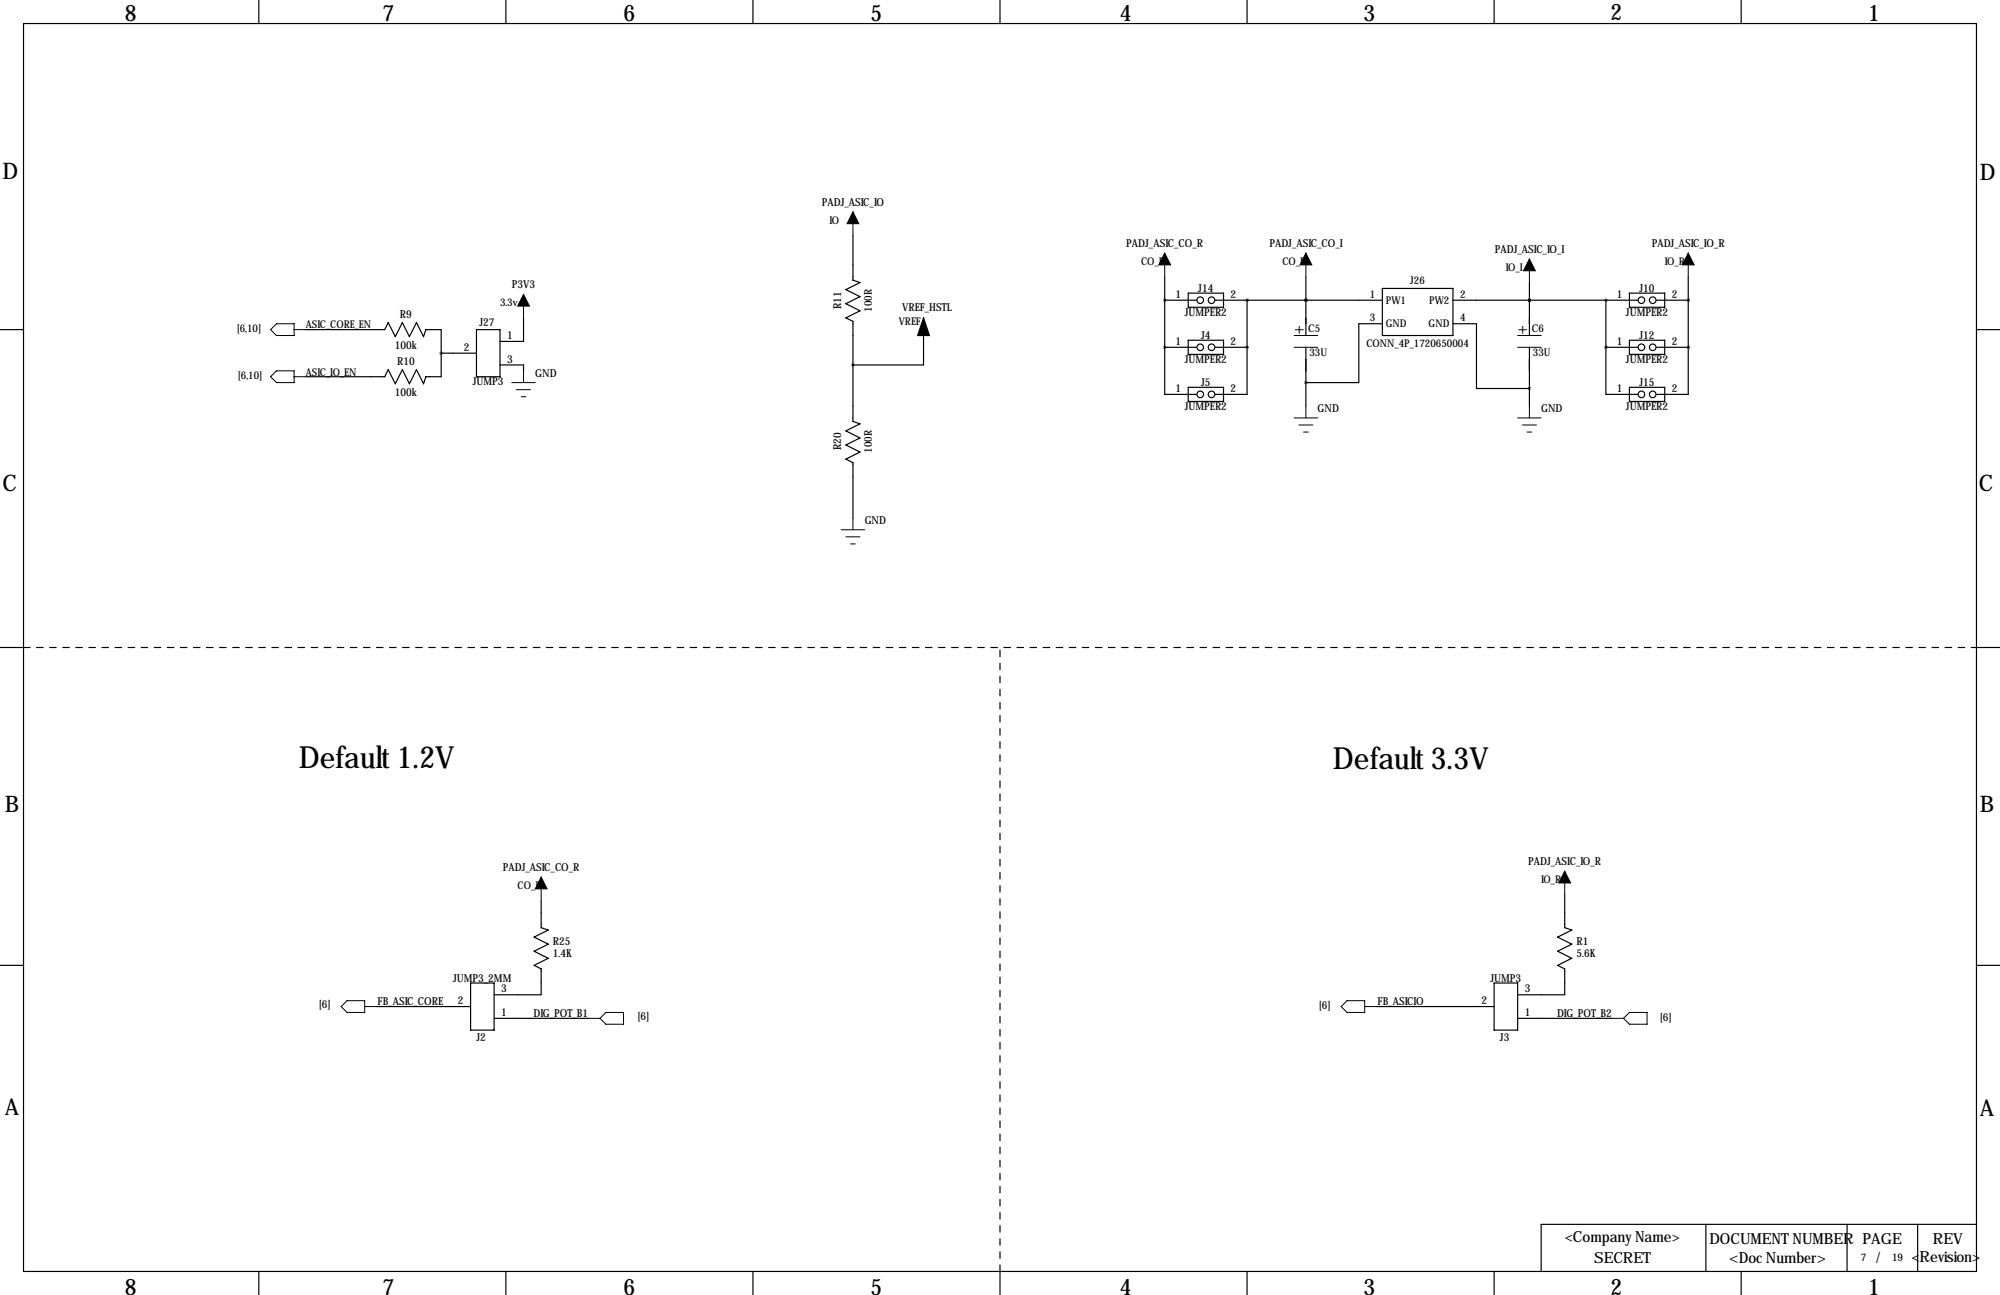
[picture p42: page 6]

D
D

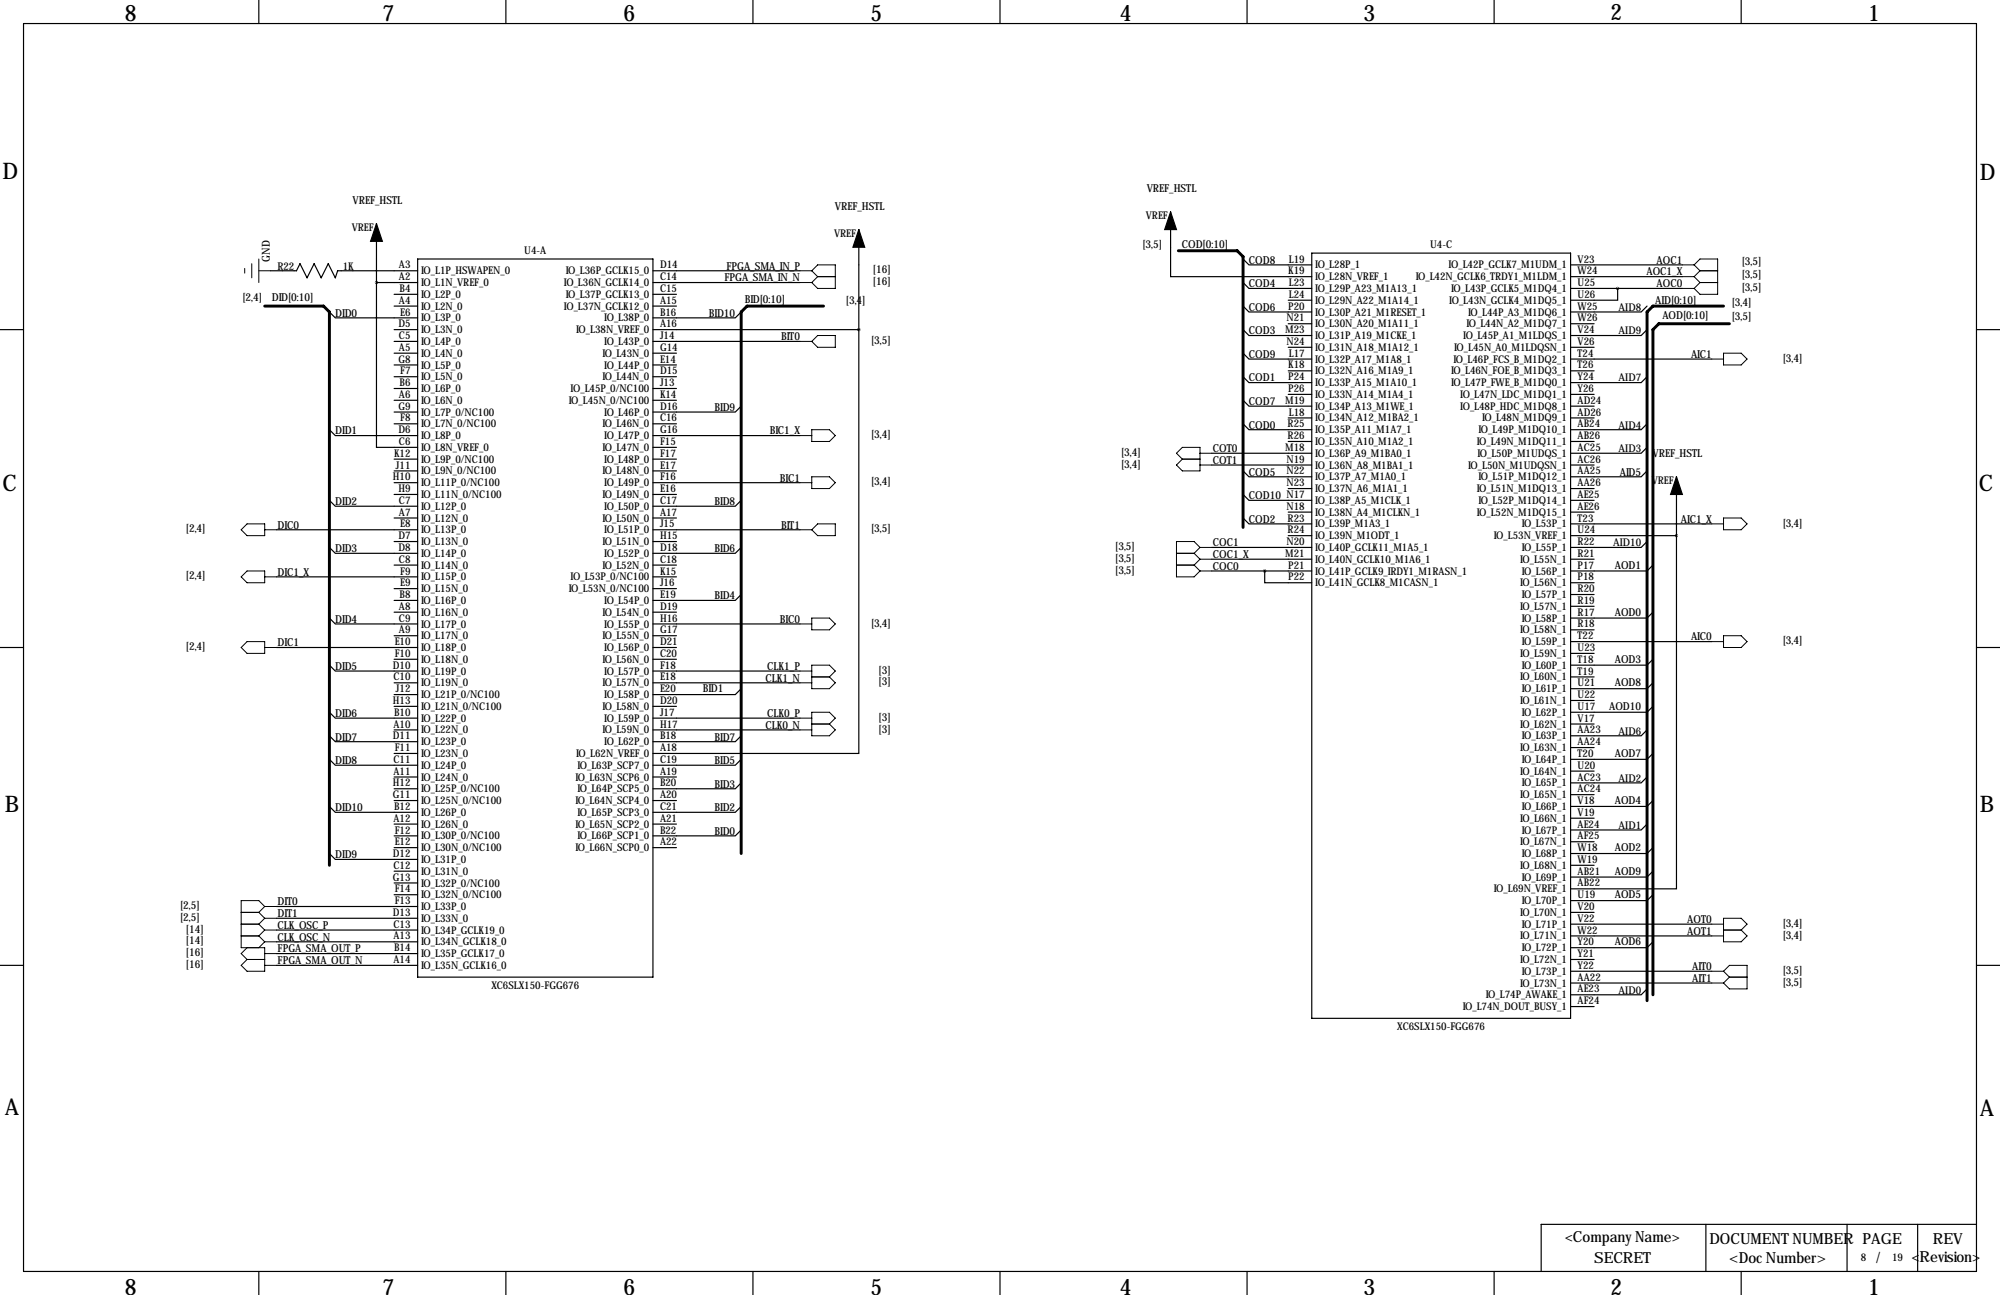
[picture p43: page 7]

D
D

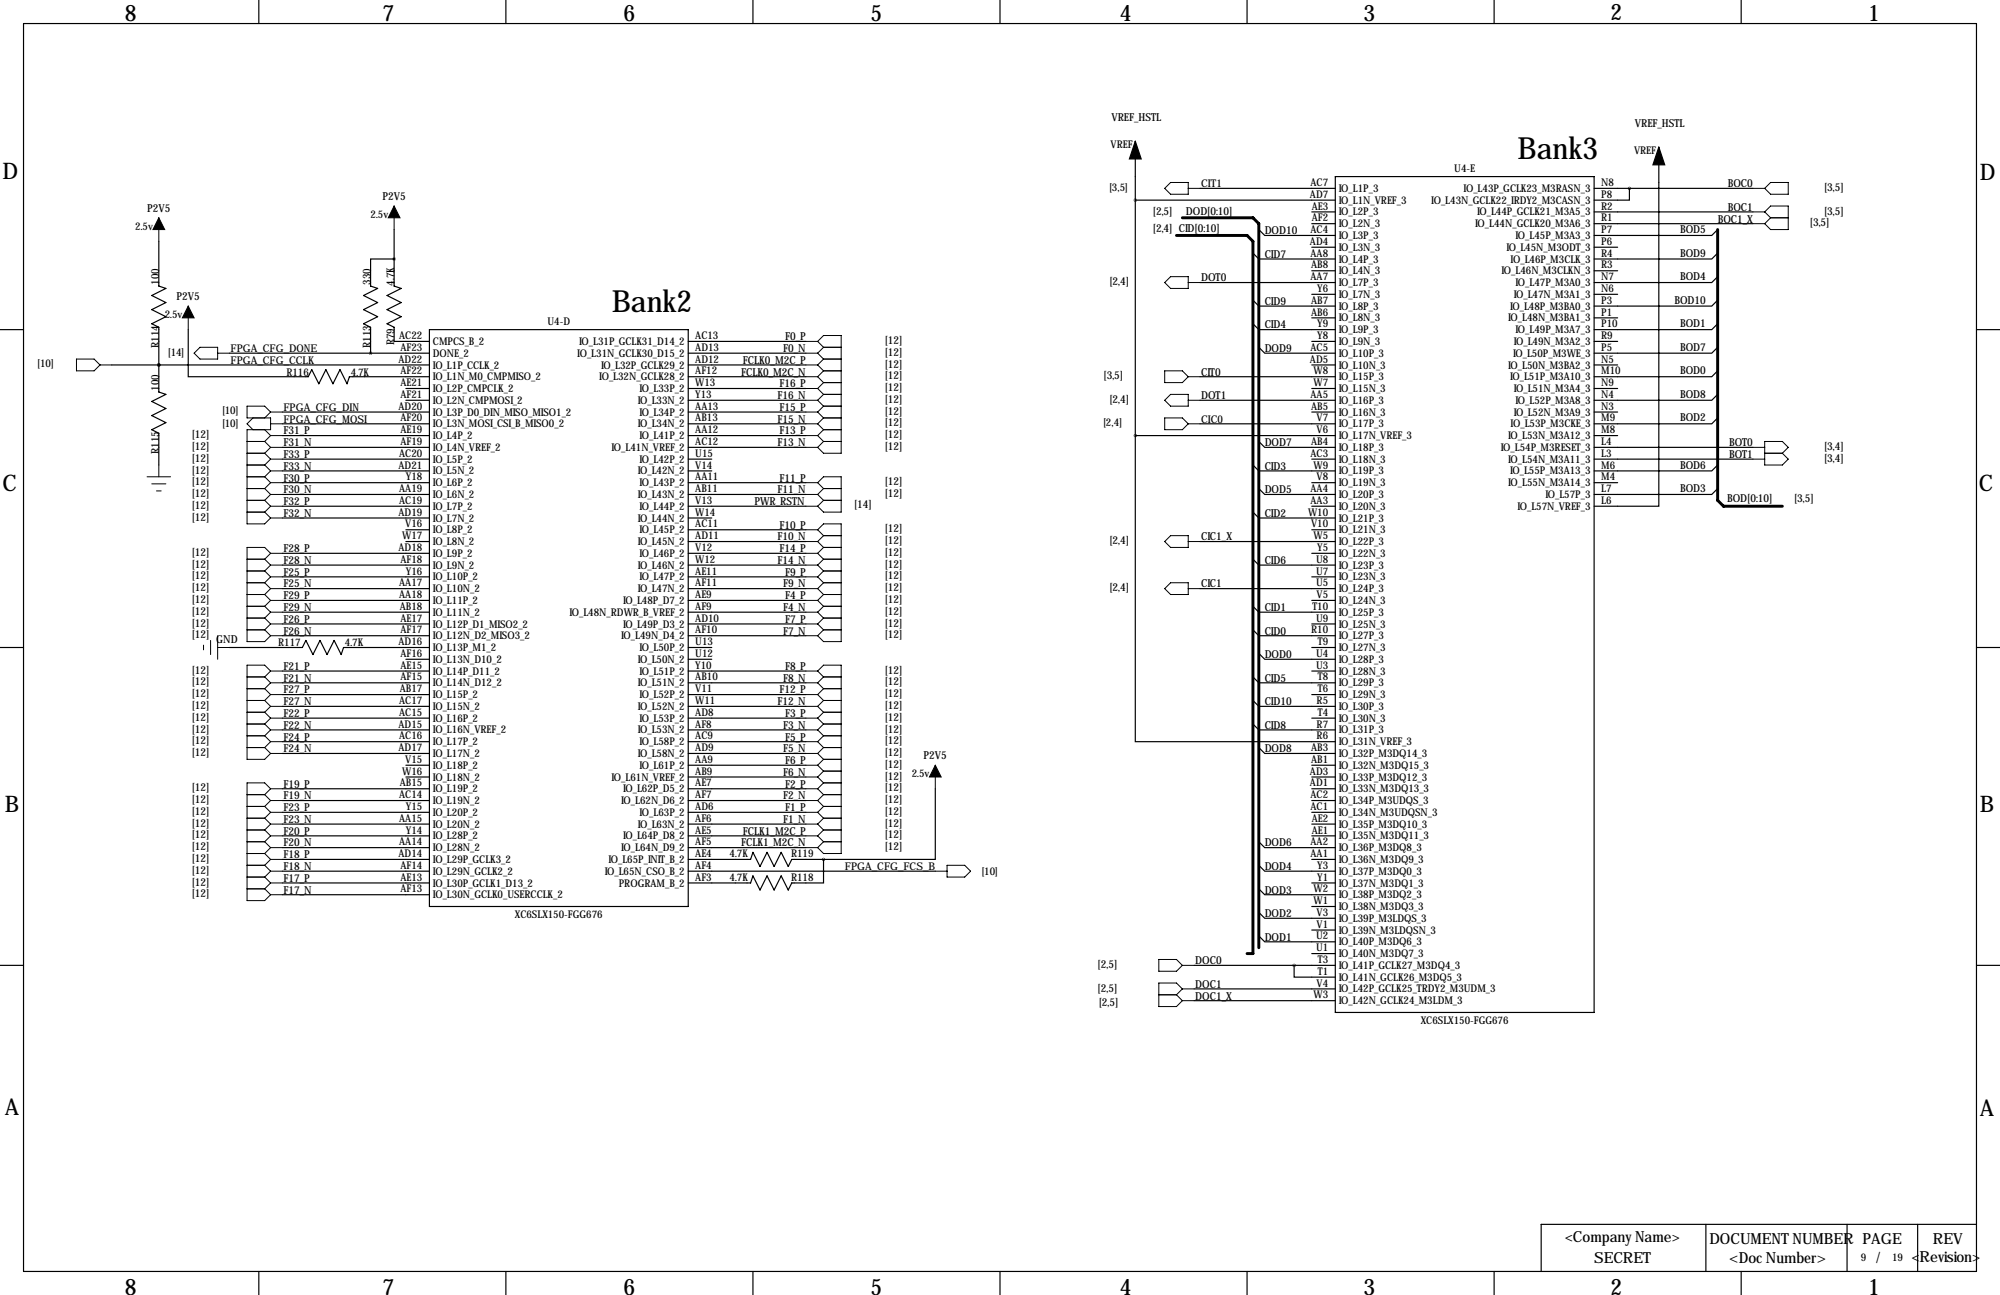
[picture p44: page 8]

# DCBA

# ABCD

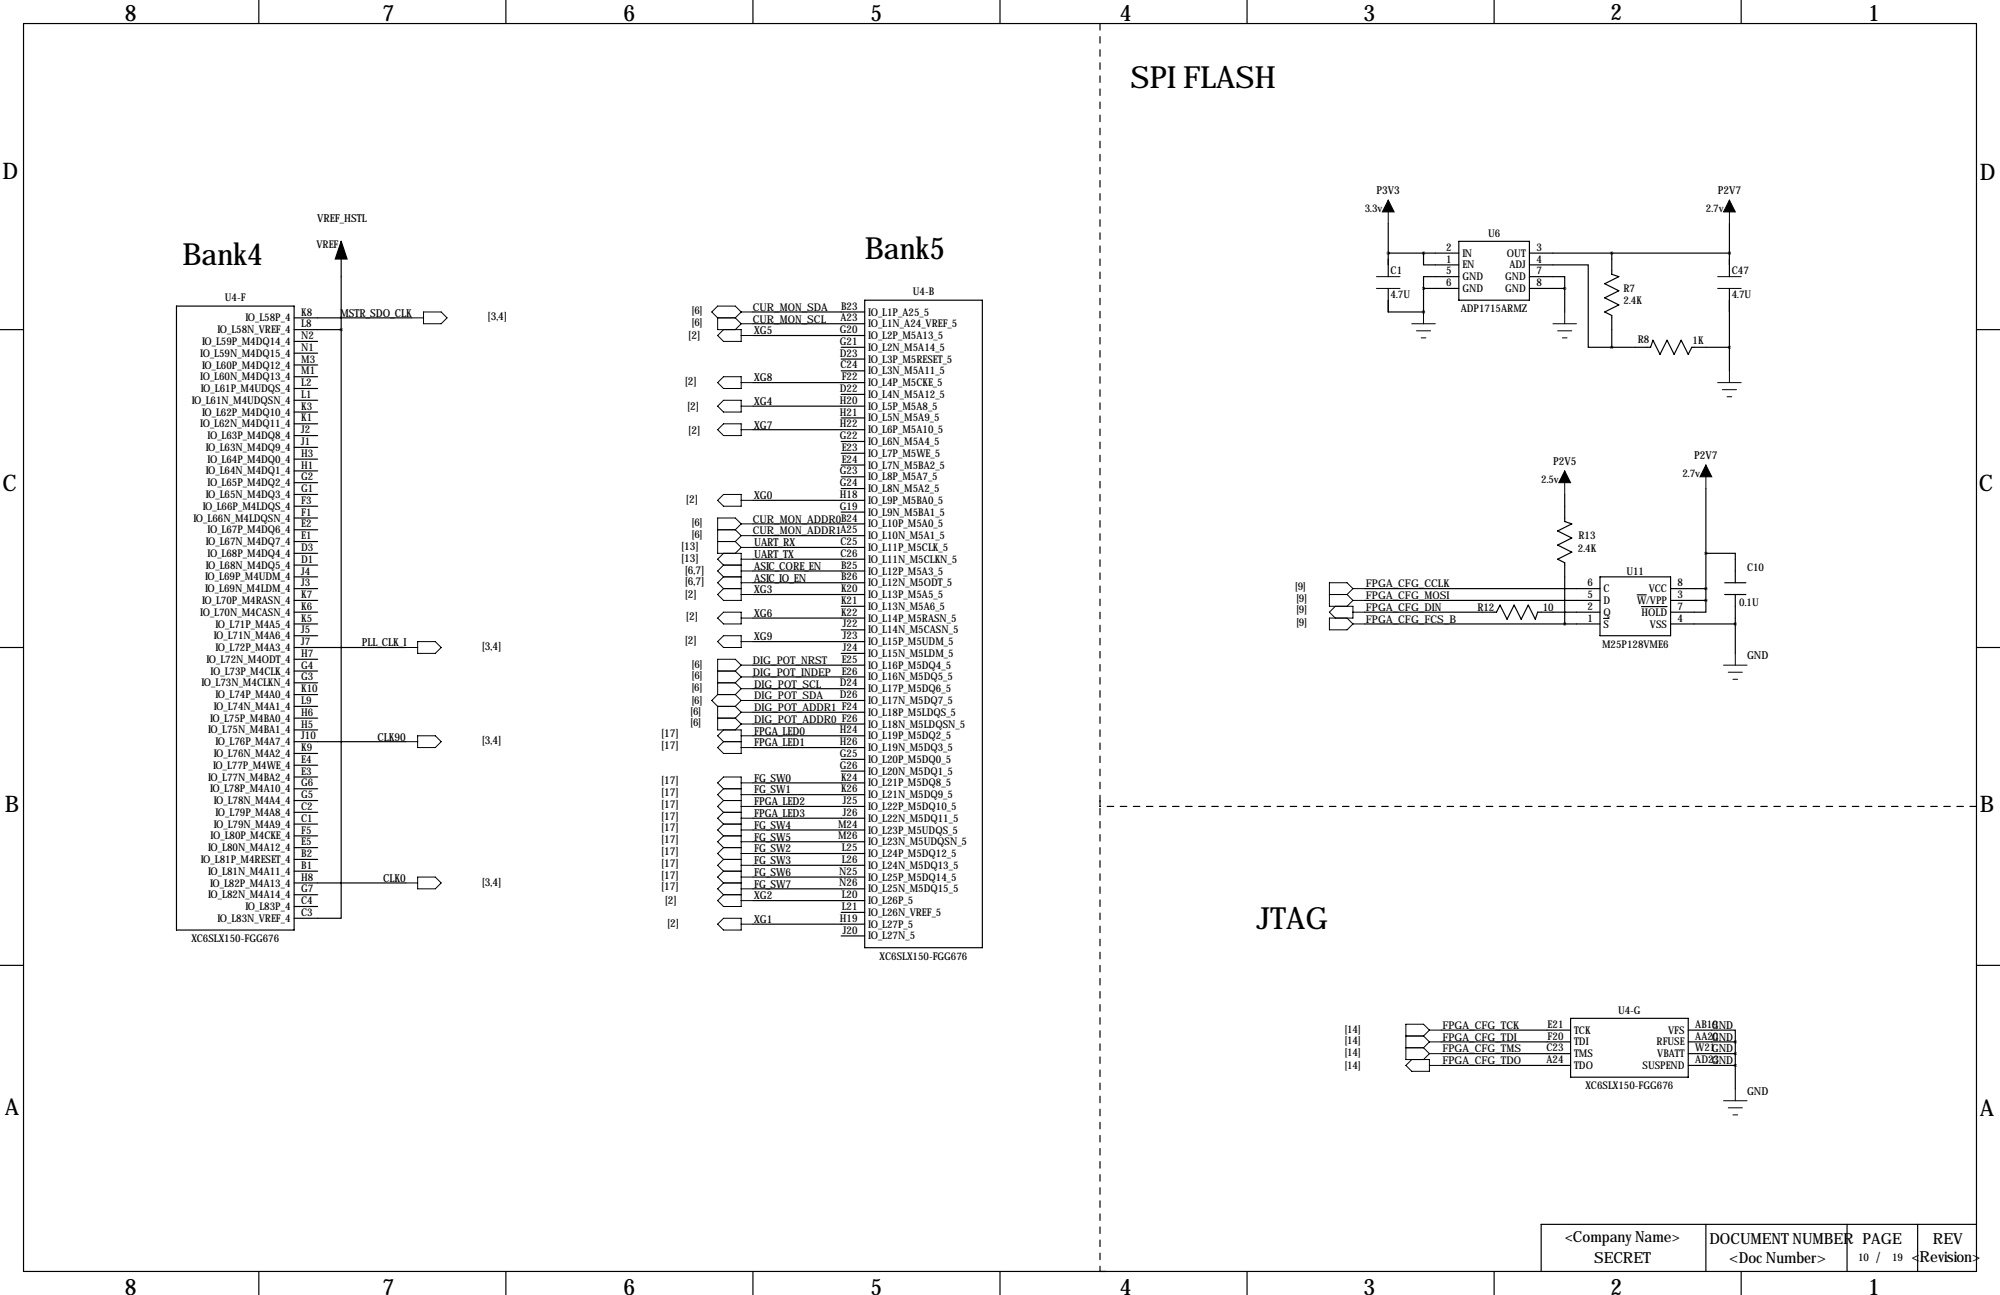
[picture p45: page 9]

# DCBA

# ABCD

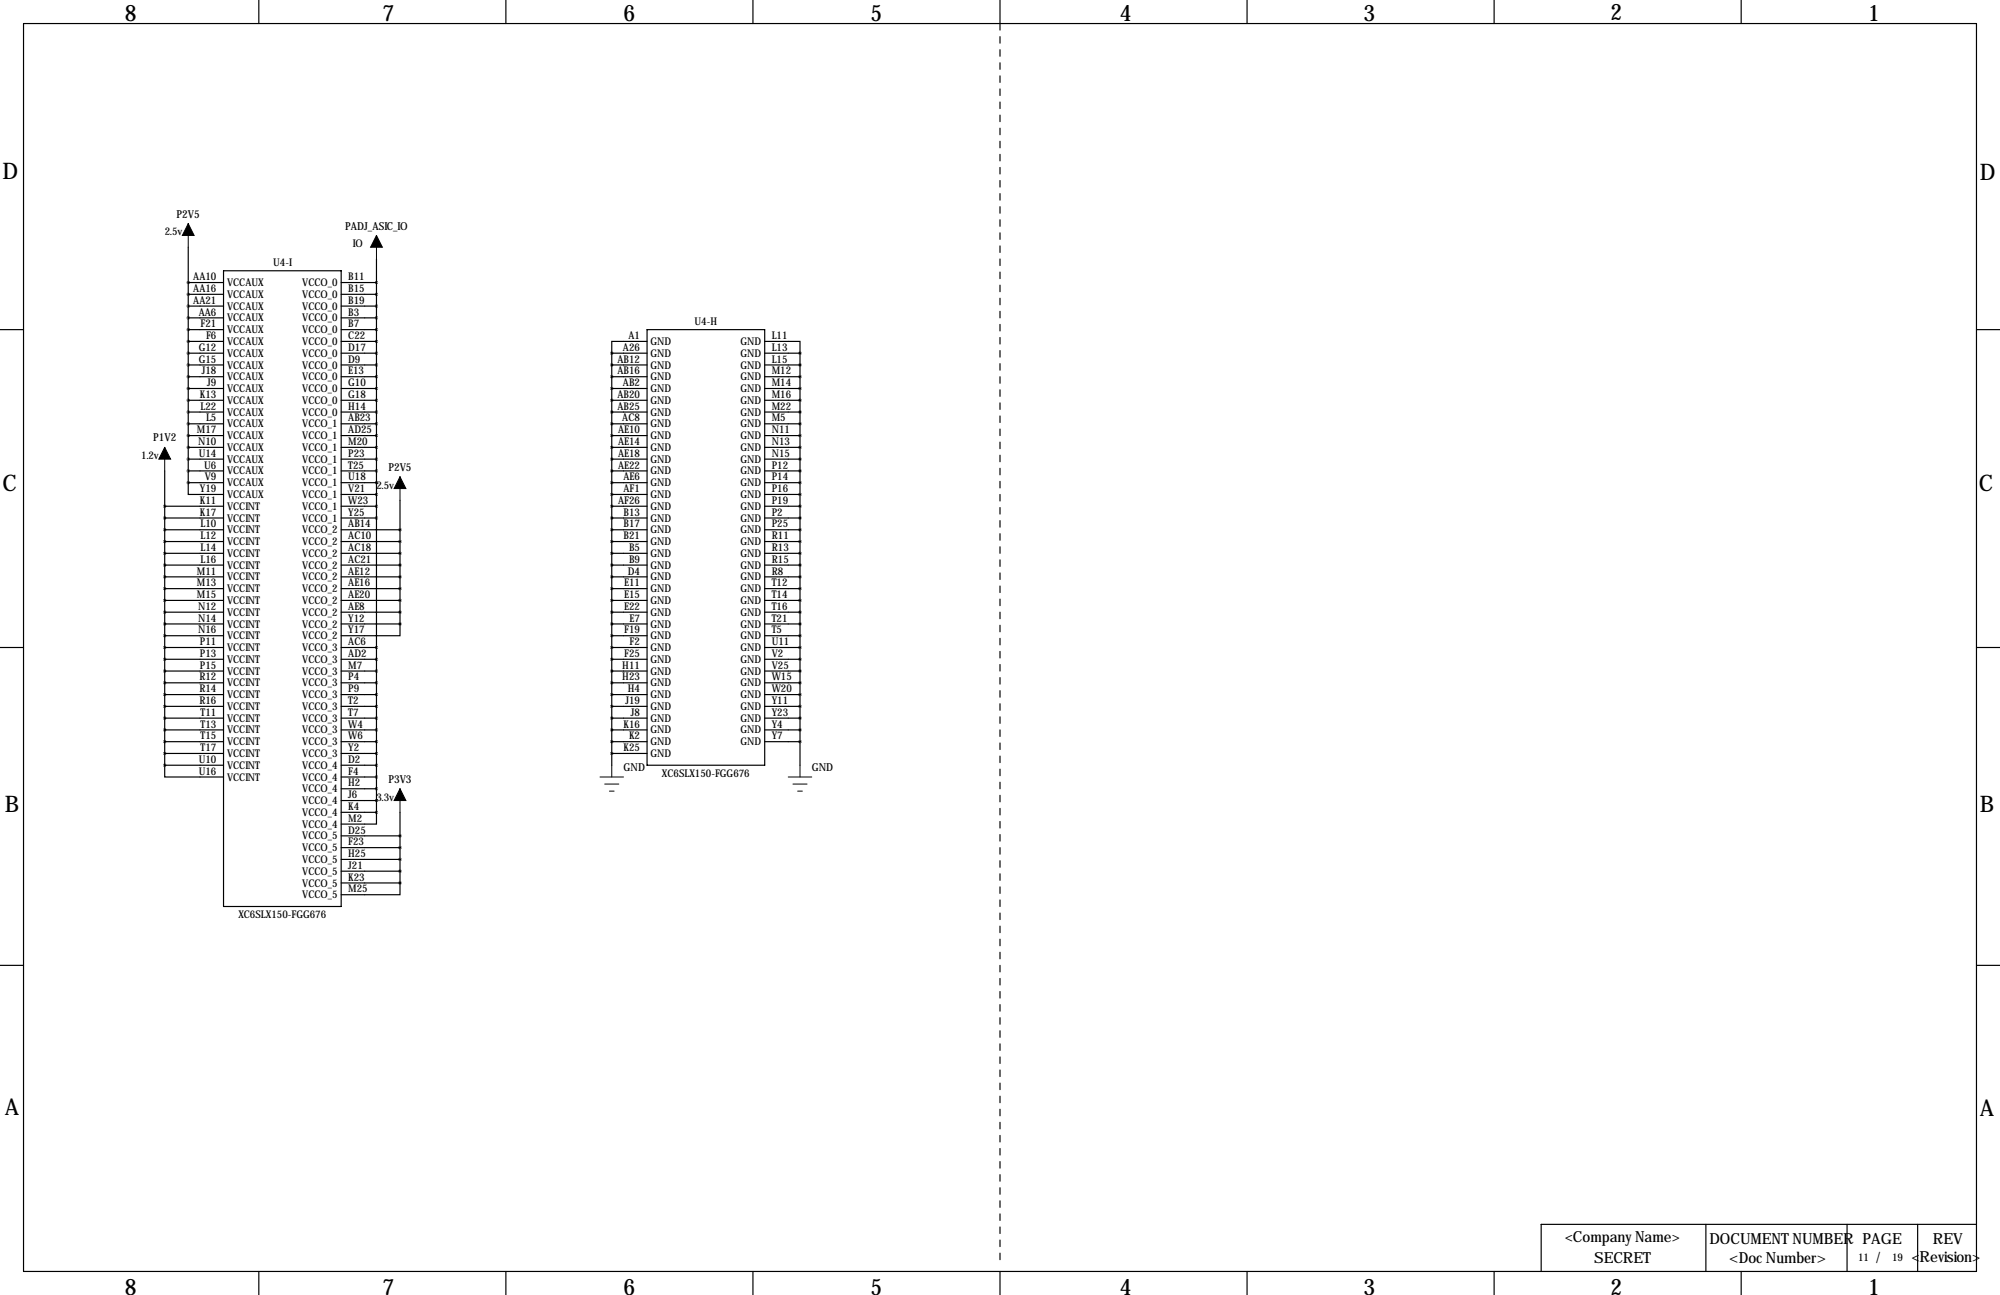
[picture p46: page 10]

# DCBA

# ABCD

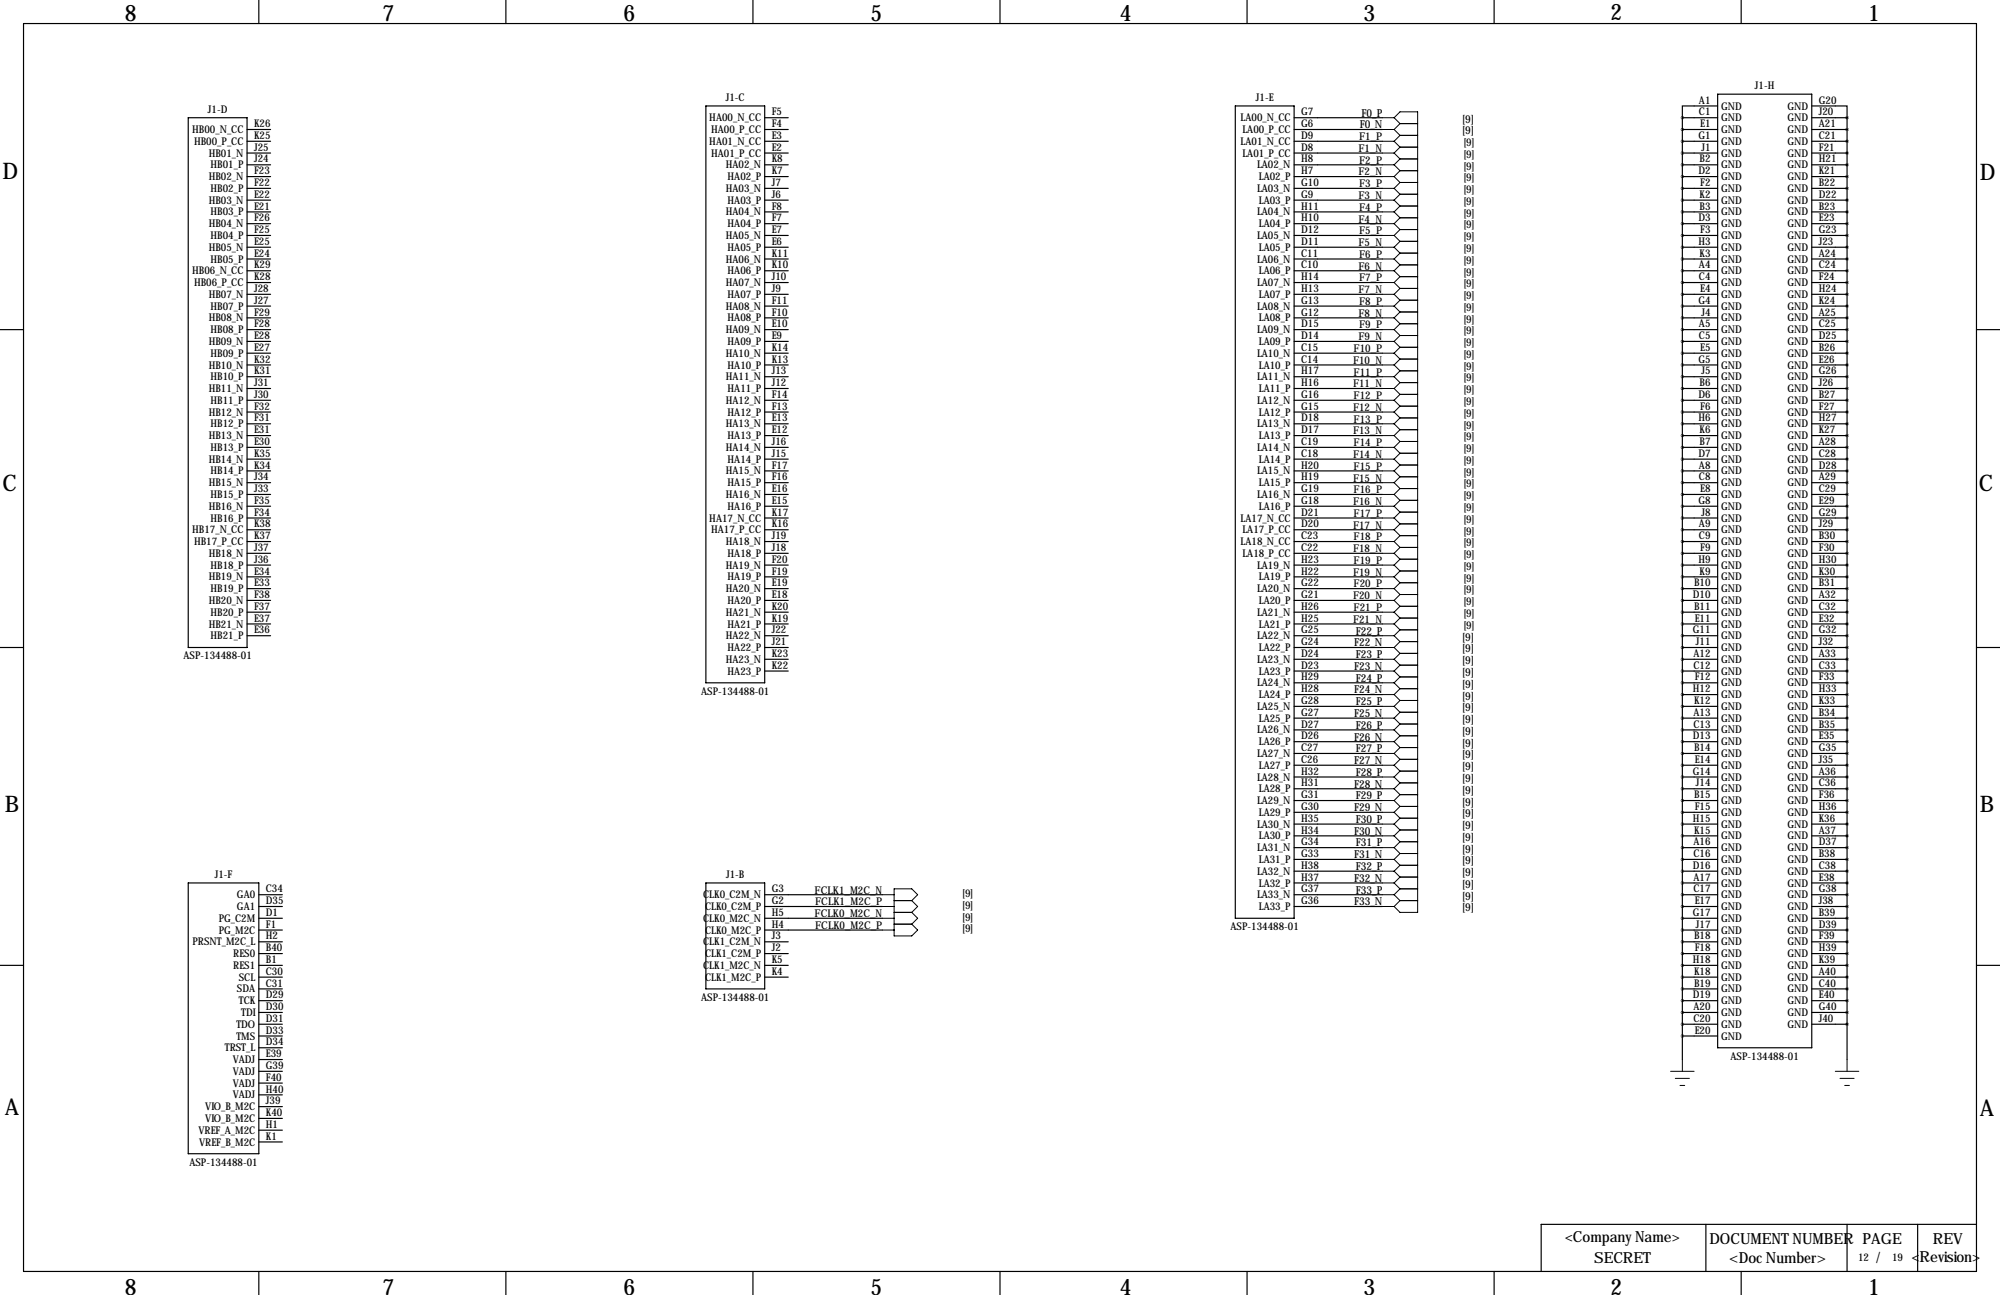
[picture p47: page 11]

D
D

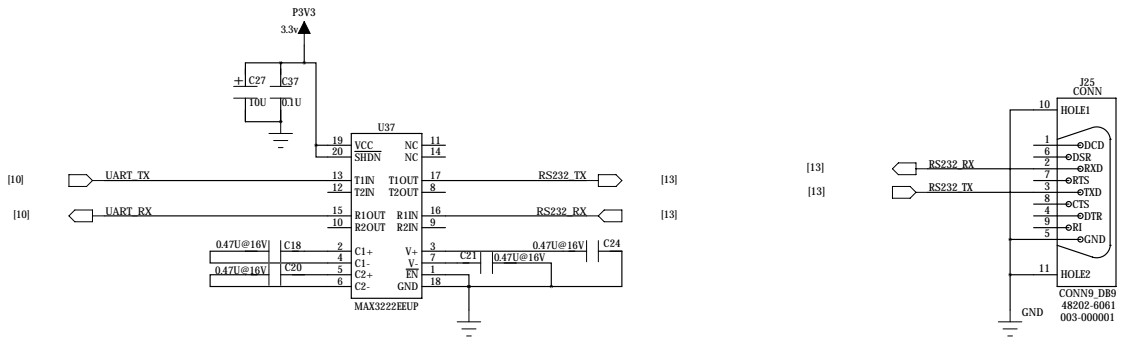
[picture p48: page 12]

D
D

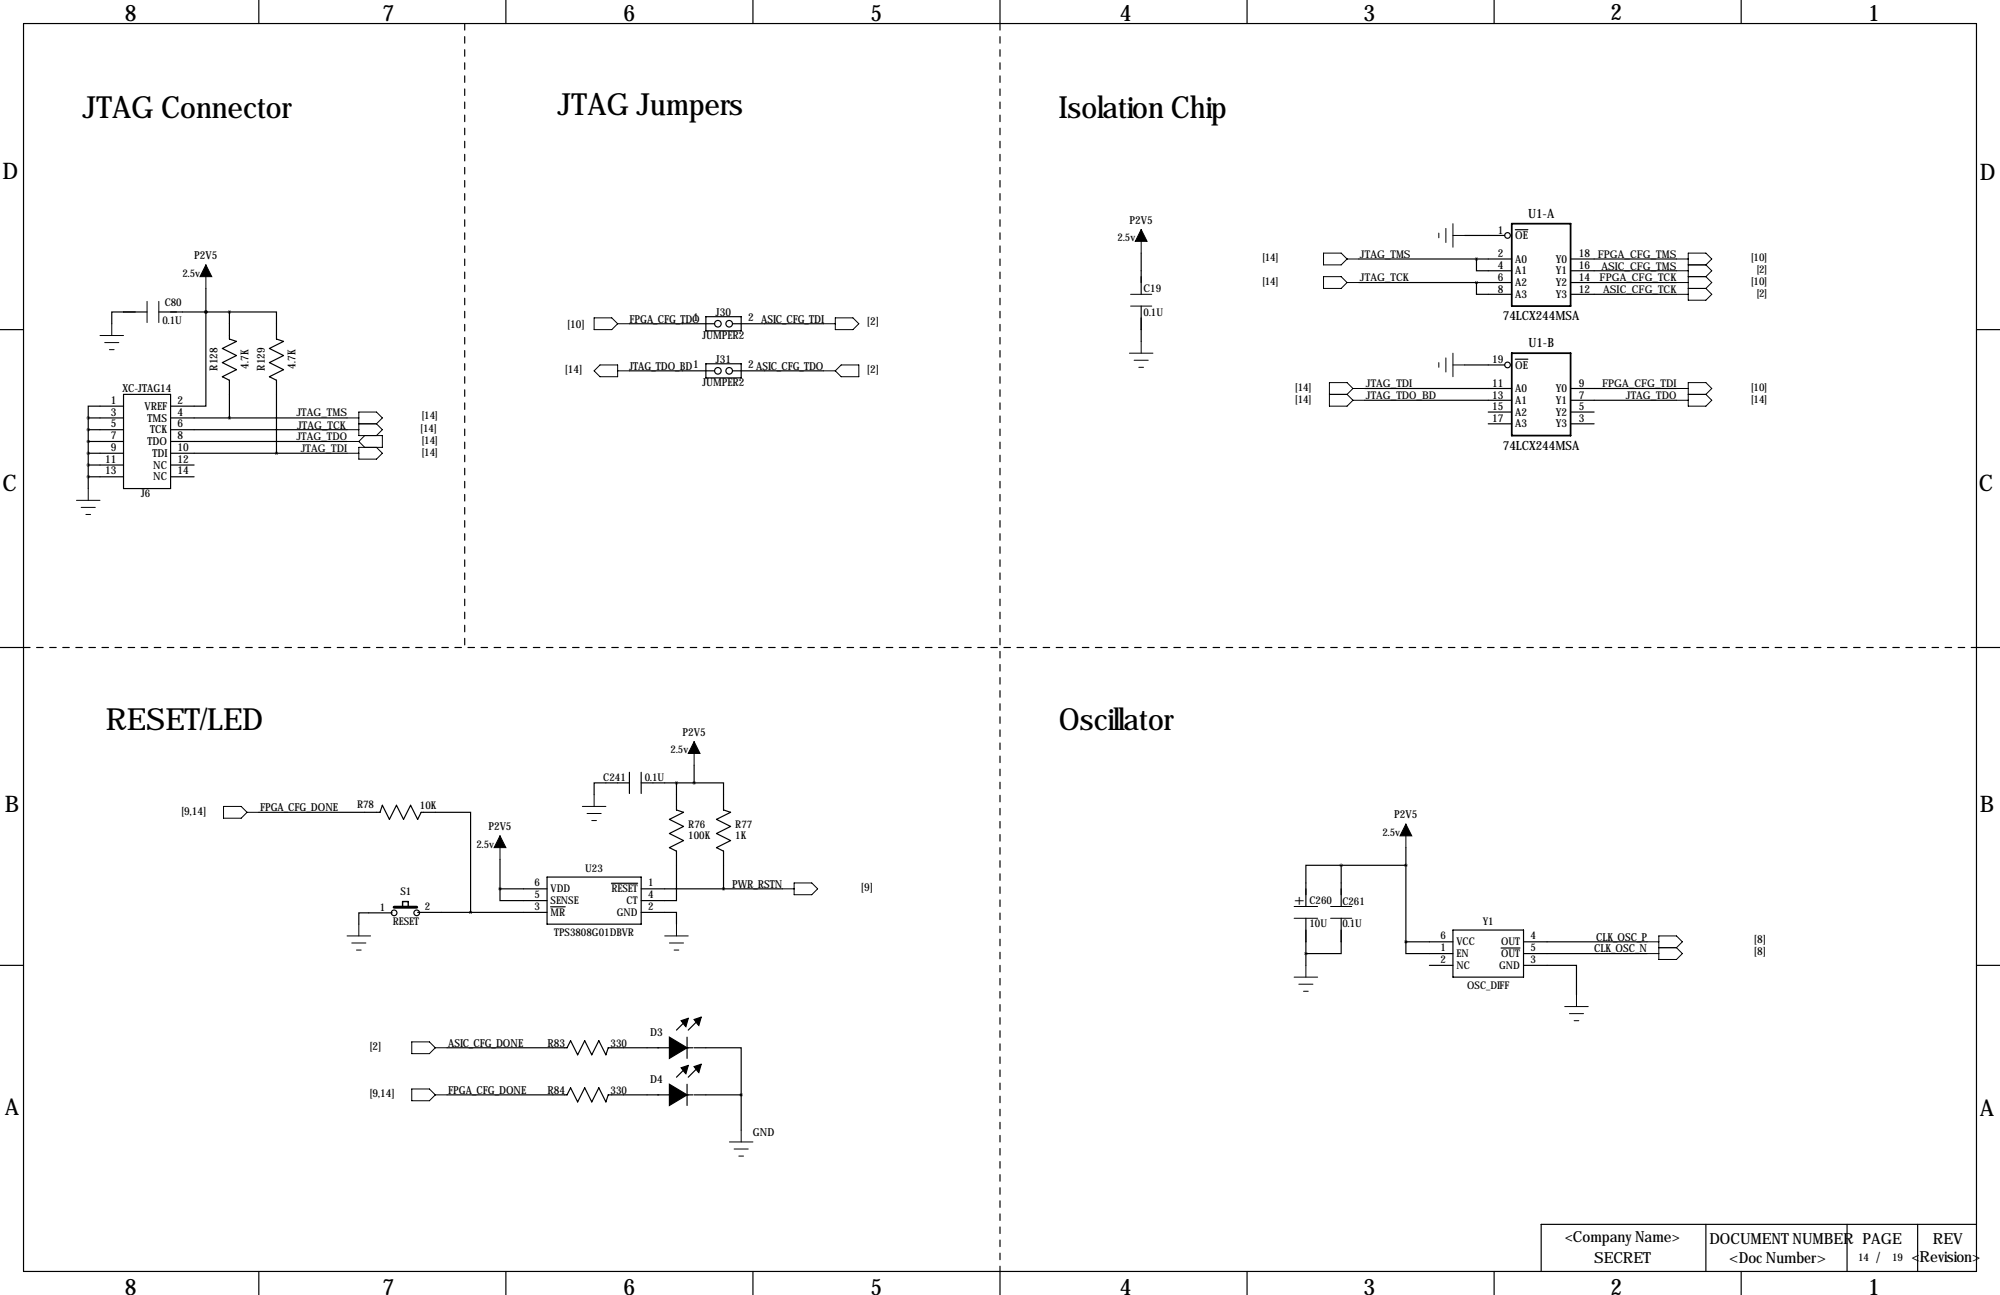
[picture p49: page 13]

D
D

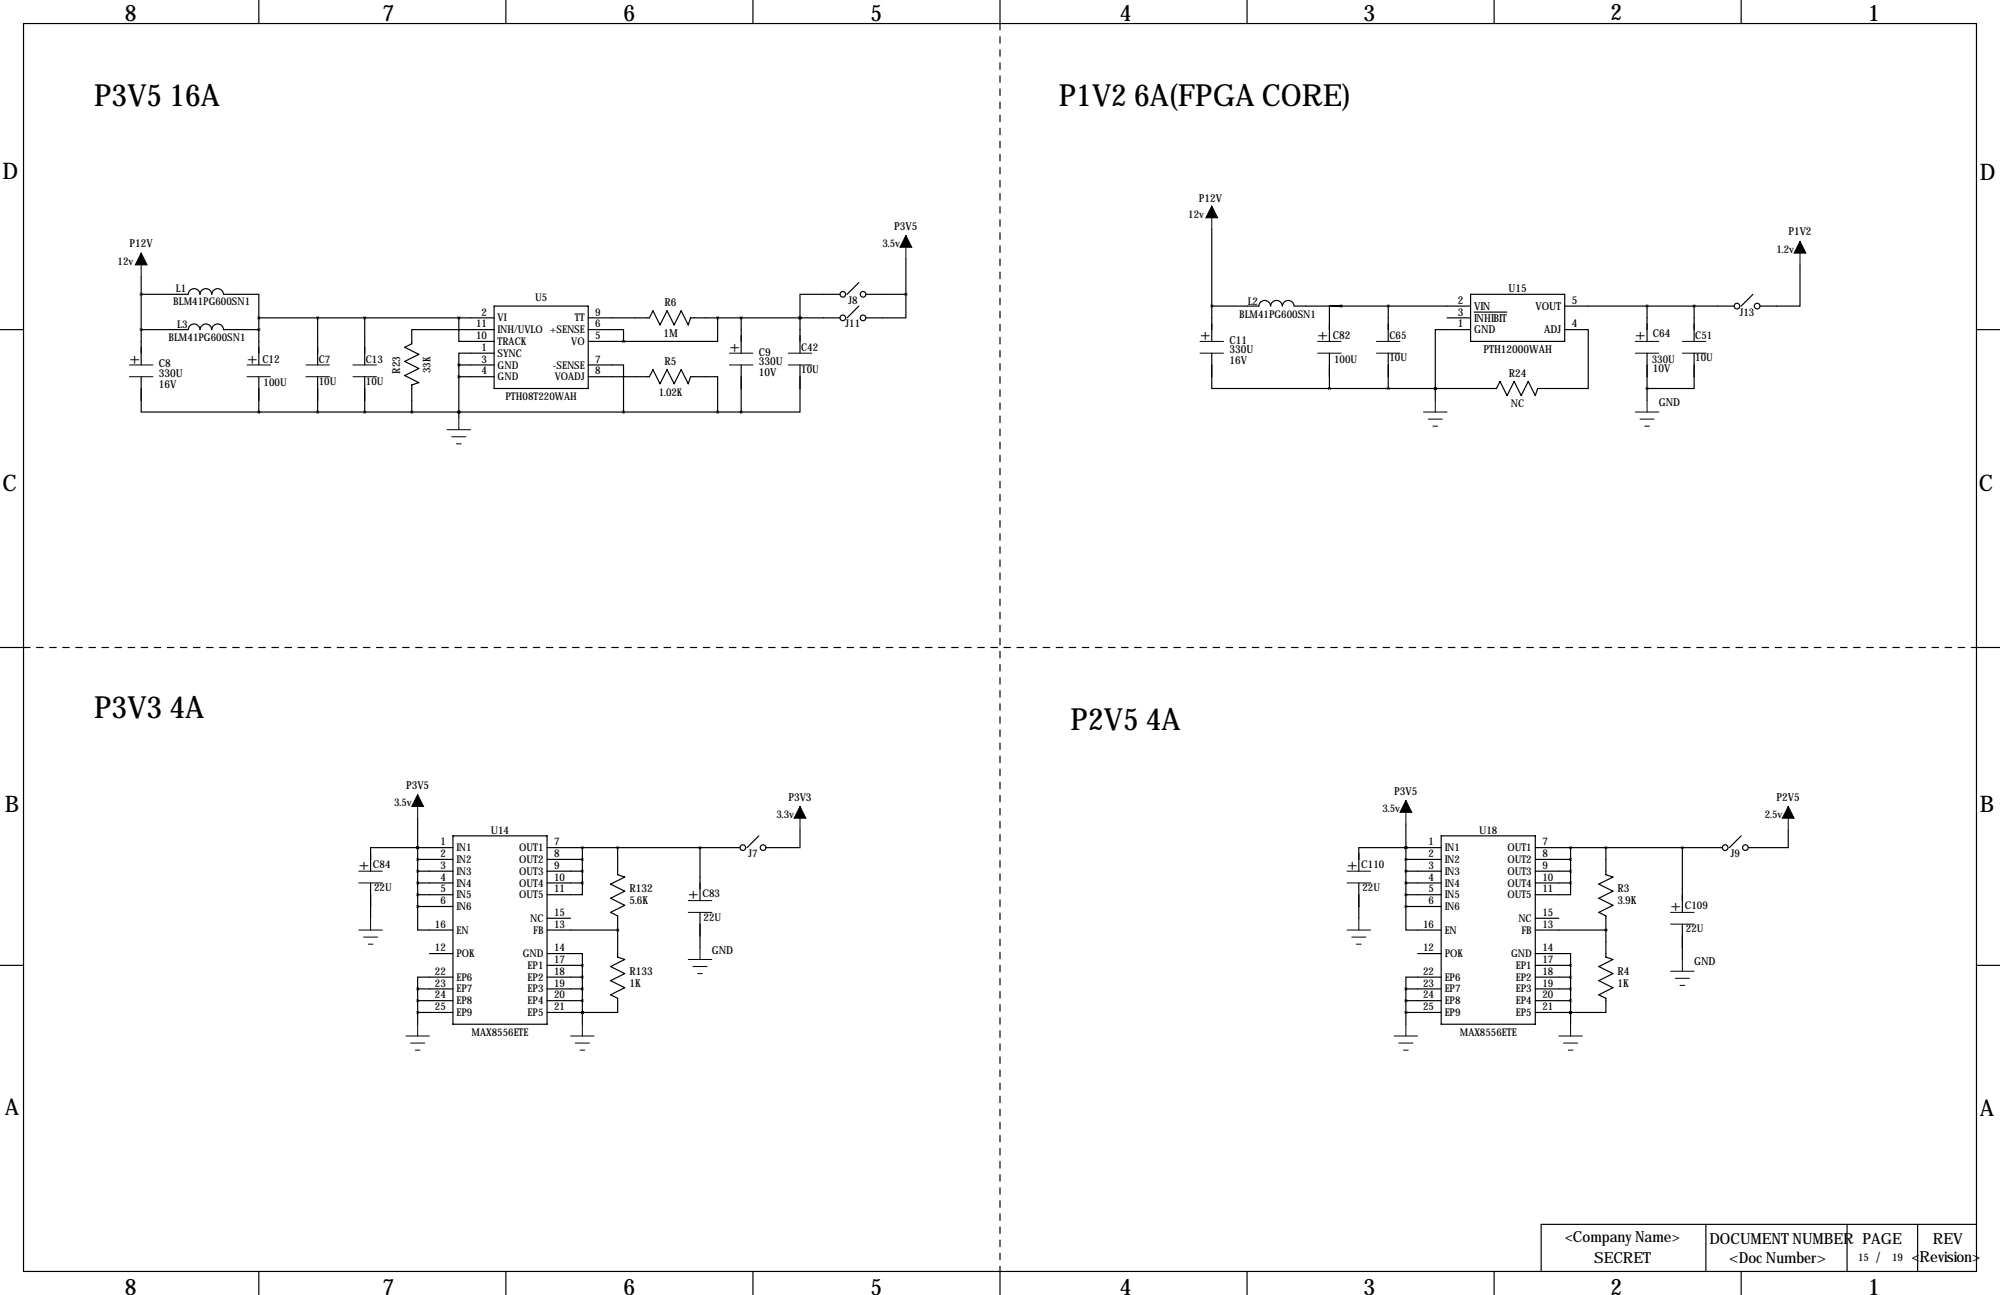
[picture p50: page 14]

D
D

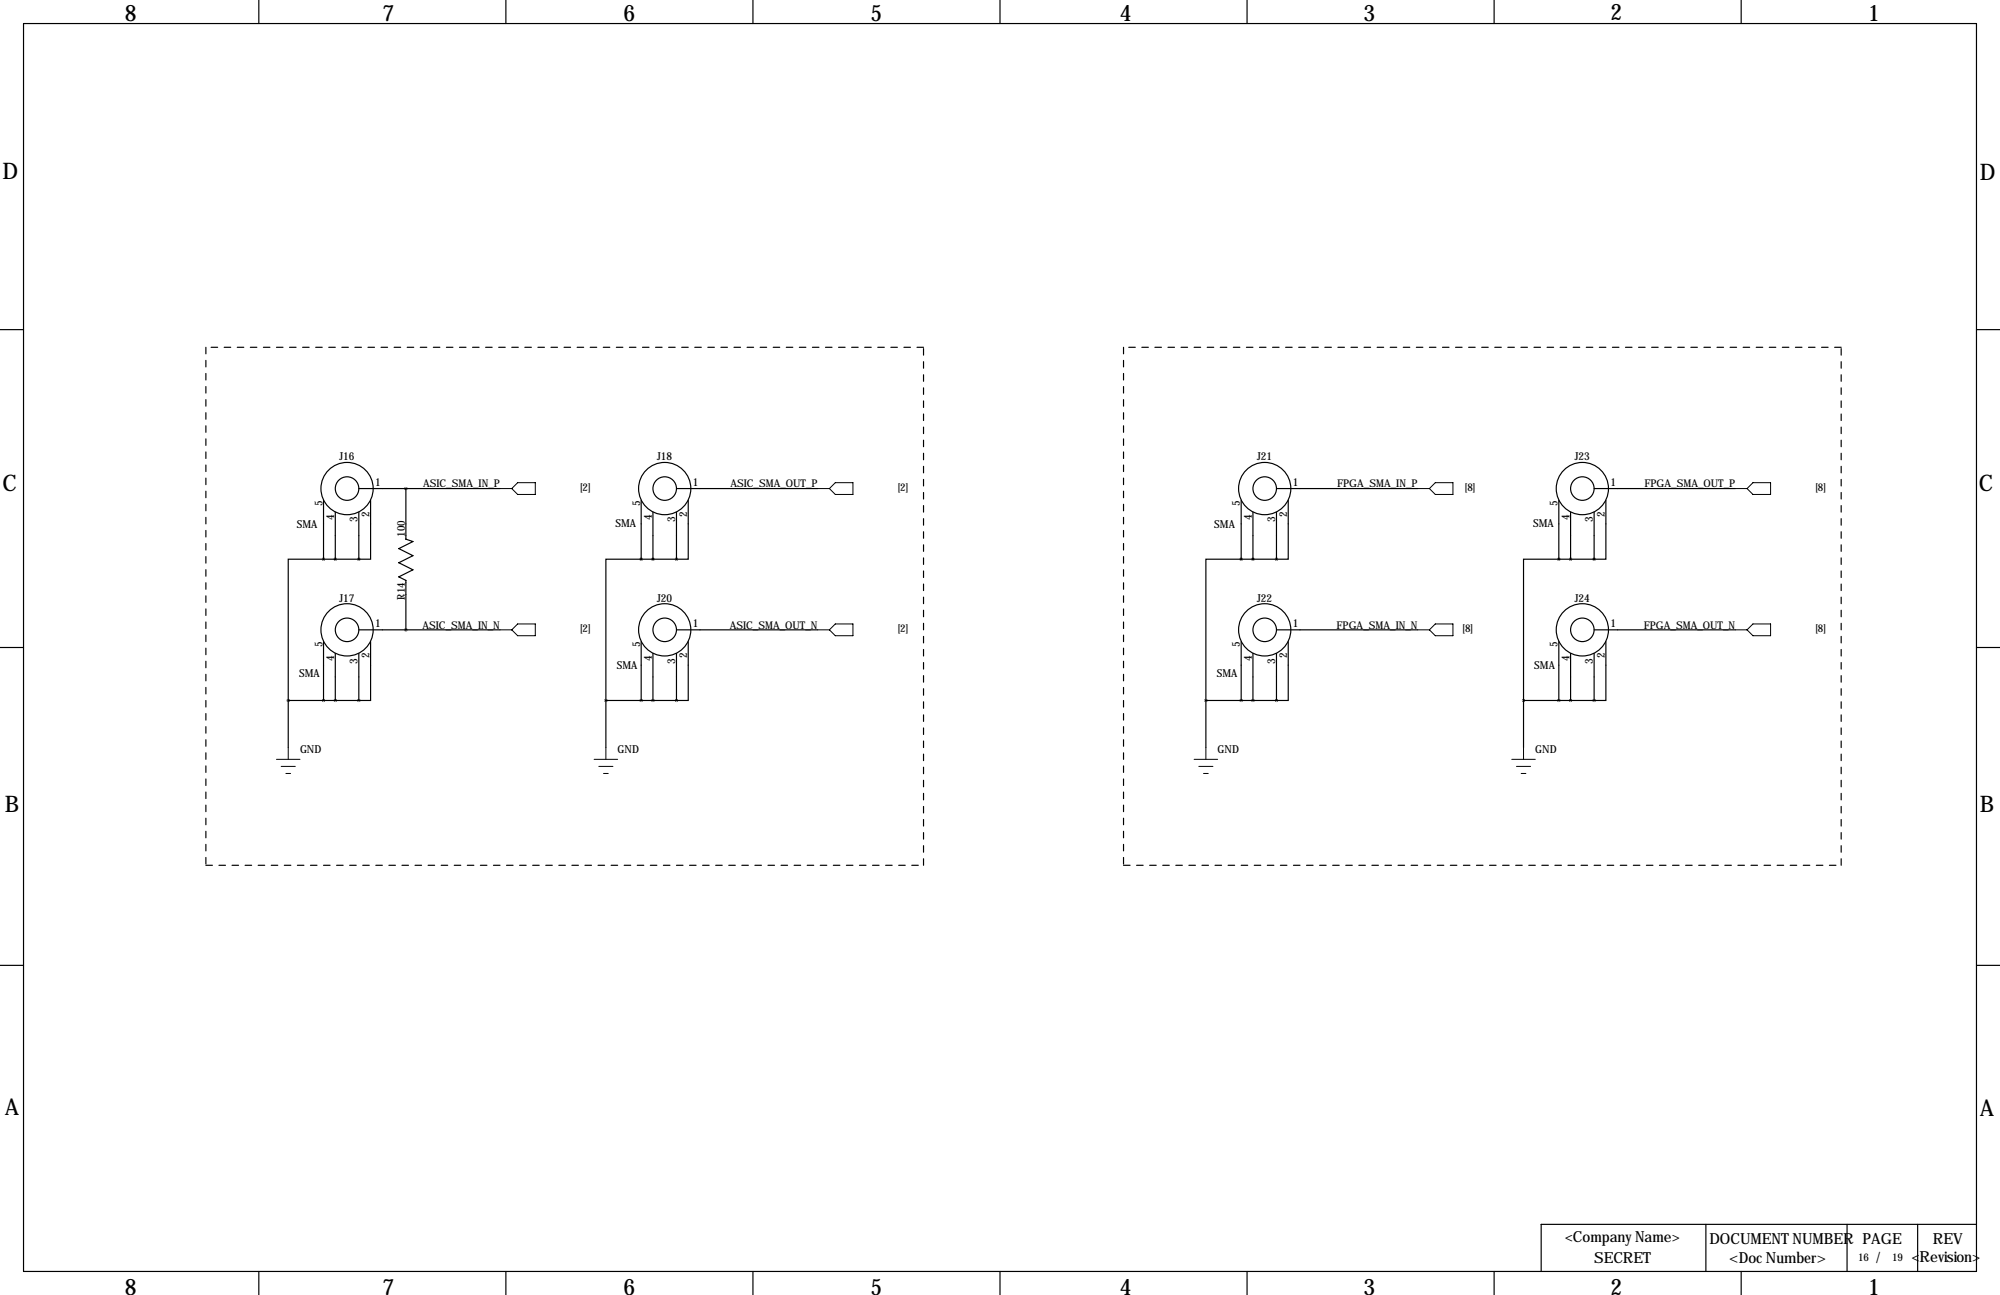
[picture p51: page 15]

D
D

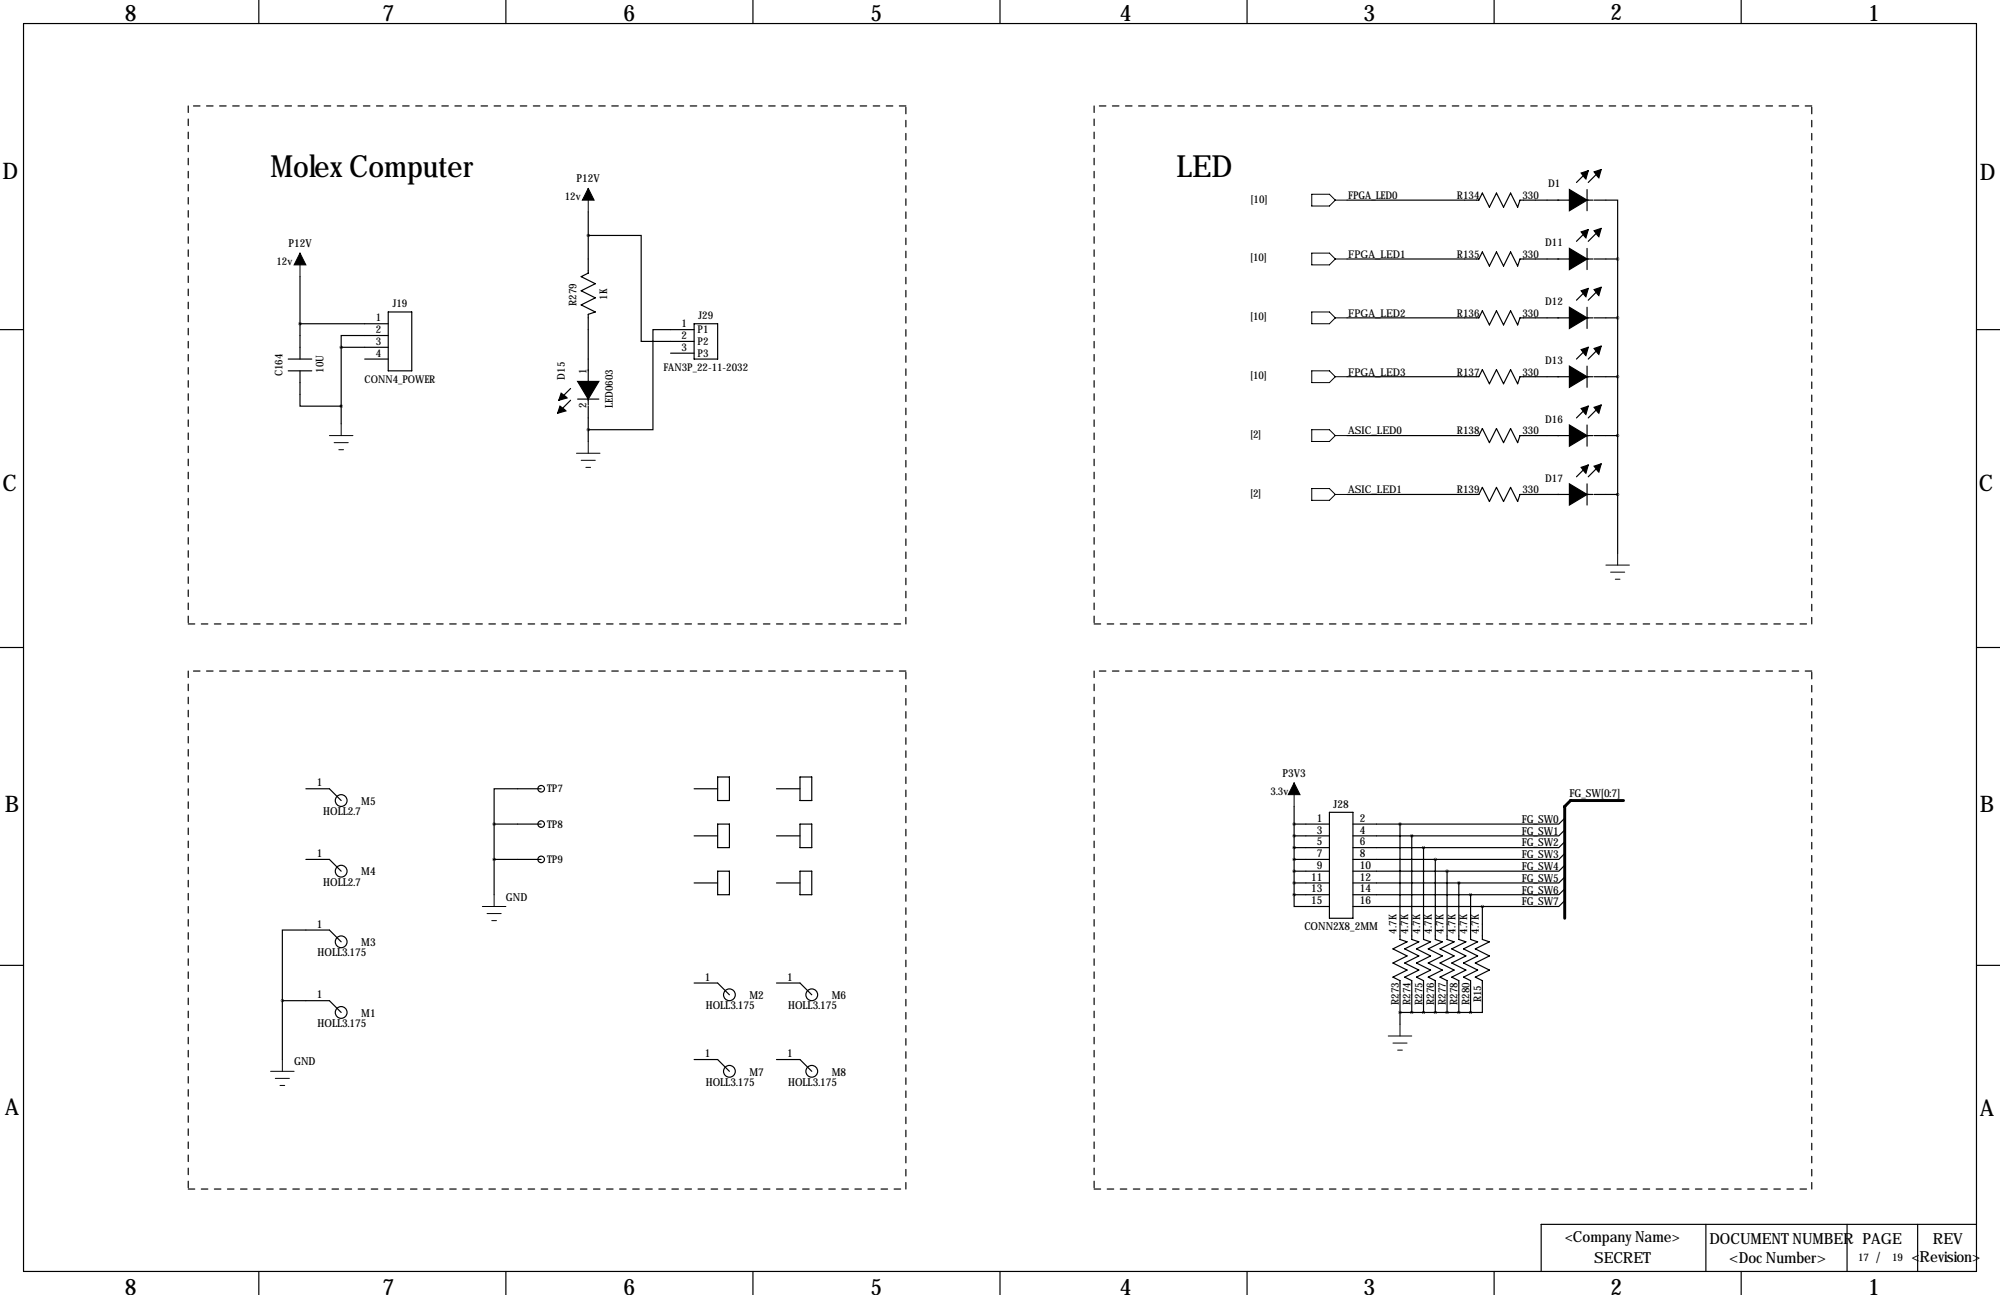
[picture p52: page 16]

D

D

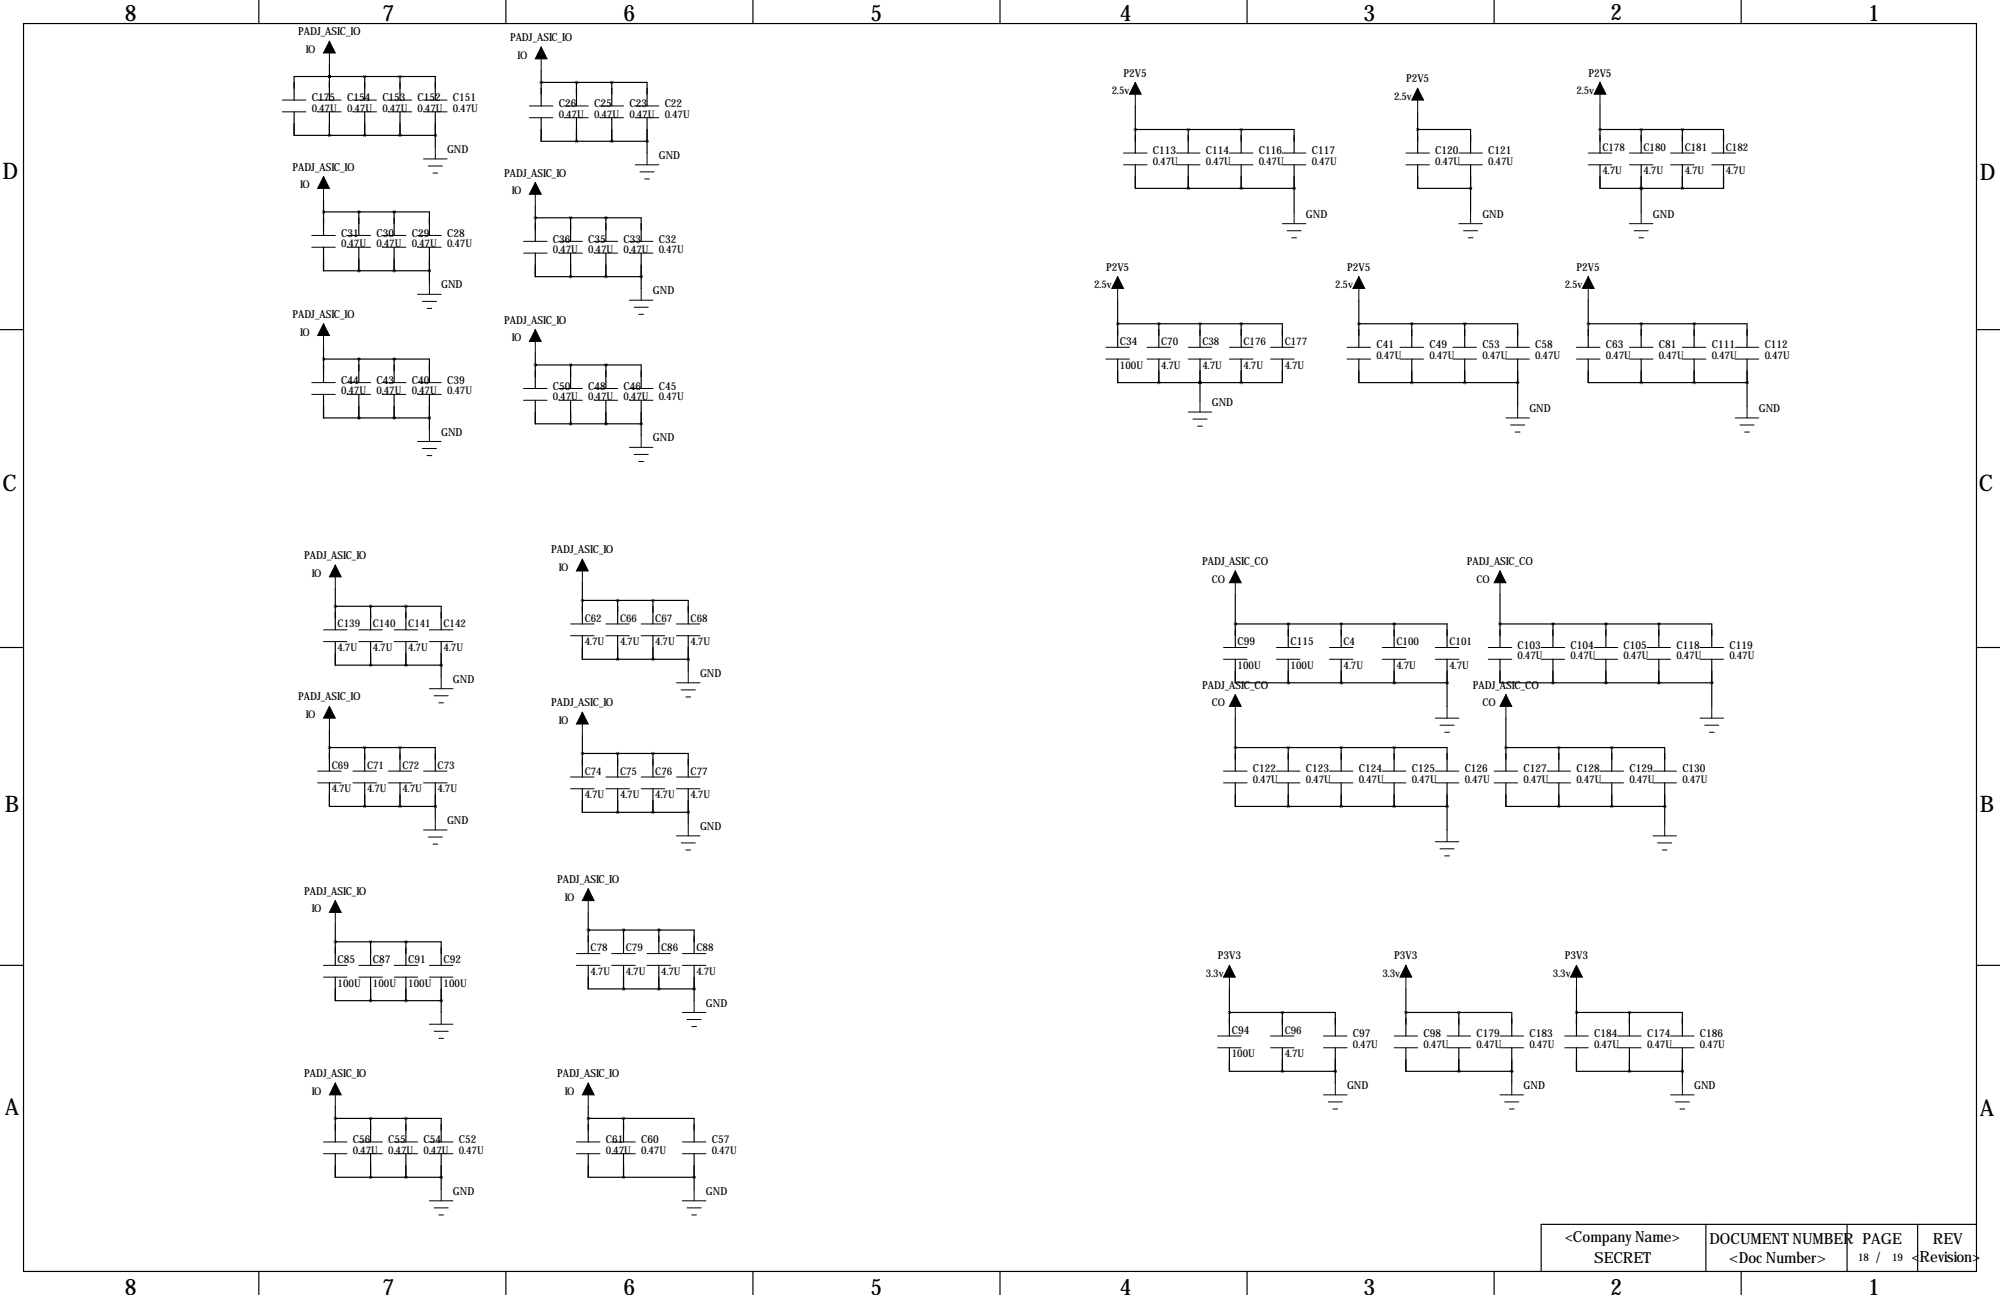
[picture p53: page 17]

D
D

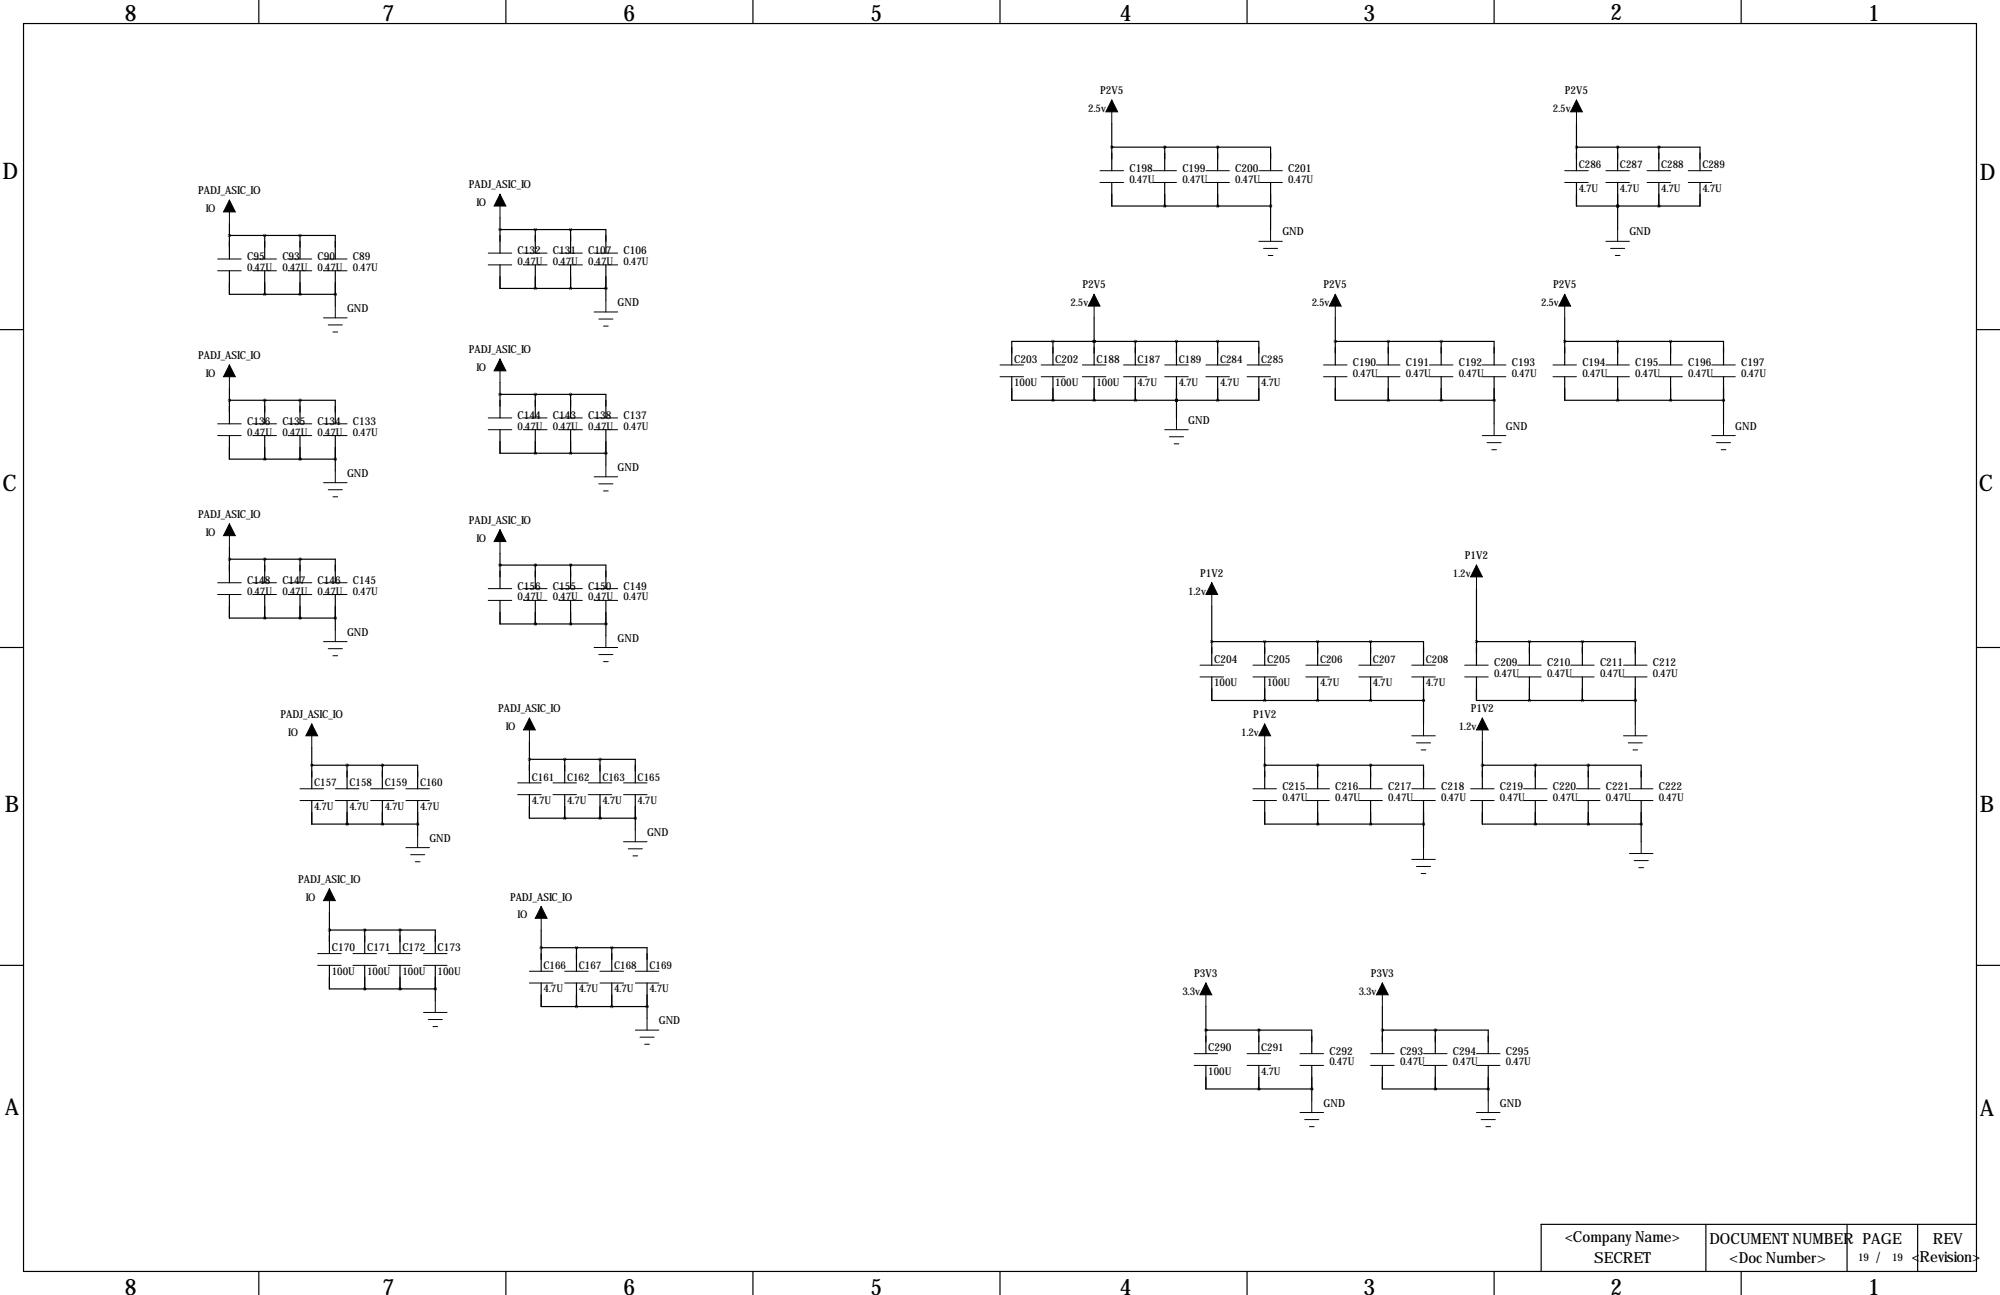
[picture p54: page 18]
