bespoke-silicon-group/bsg_motherboards/bsg_trouble/real_trouble/pcb_development/pcb_design/bottom.pdf

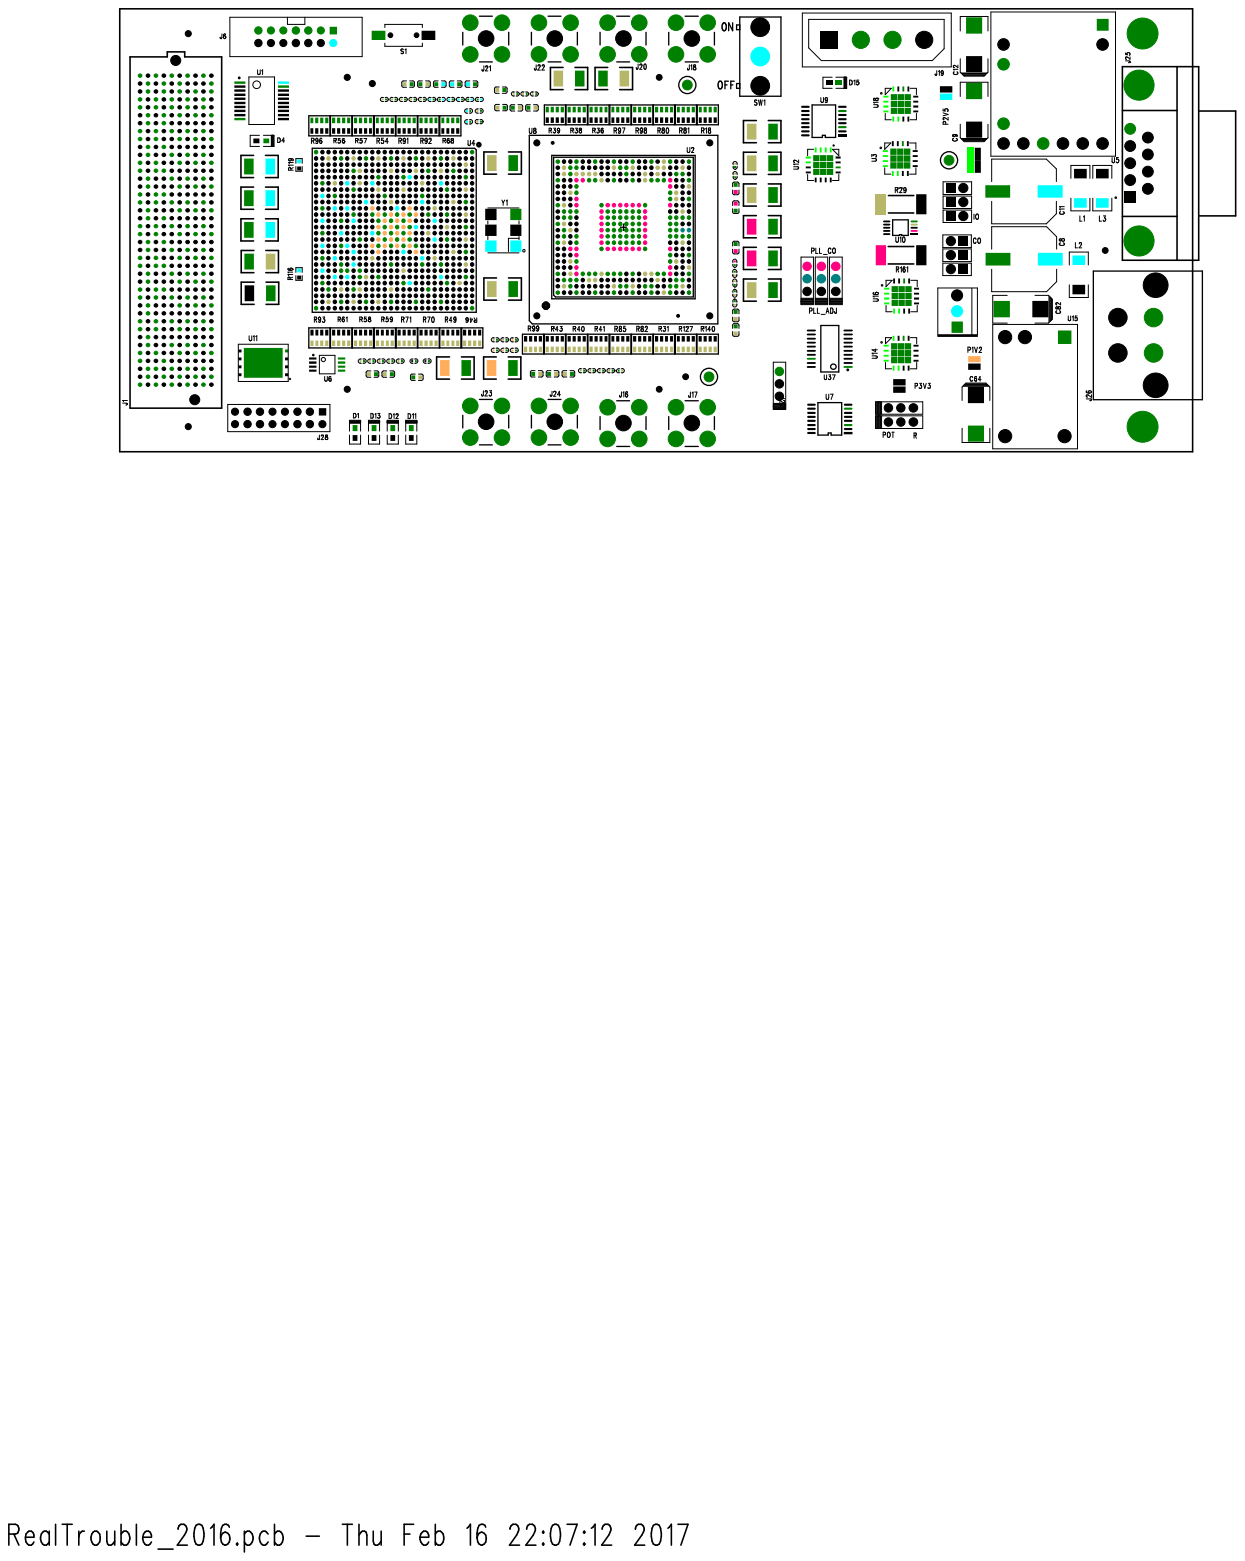
[picture p55: page 1]
