bespoke-silicon-group/bsg_motherboards/bsg_trouble/real_trouble/pcb_development/pcb_design/RealTrouble_2016_BW.pdf

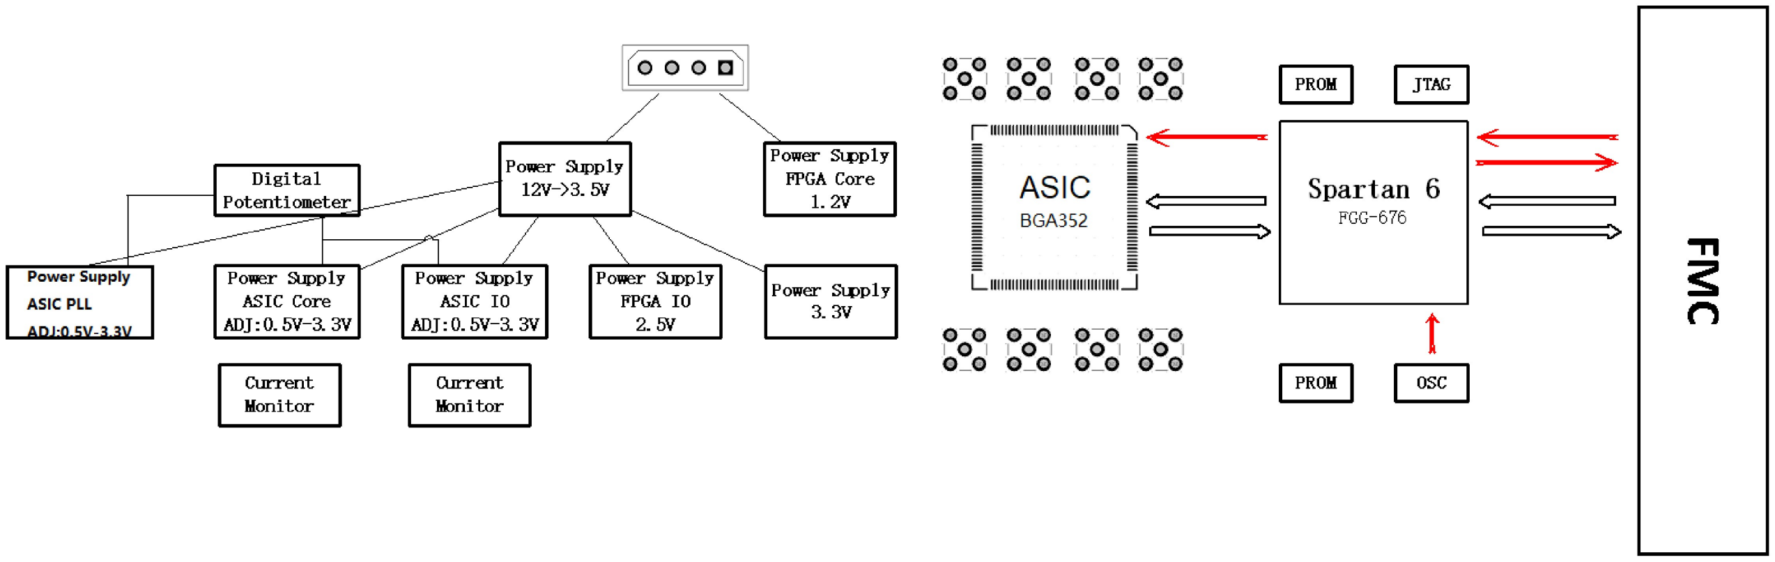
[picture p56: figure]

## 1 18 <Revision>

## <Company Name>

D

C

B

A | A

B

C

D

8 | 6 | 5 | 4 | 3 | 2 | 1
8 | 7 | 6 | 5 | 4 | 3 | 2 | 1
| | | | | | SECRET
DOCUMENT NUMBER PAGE | REV
<Doc Number> | /

# DCBA

# ABCD

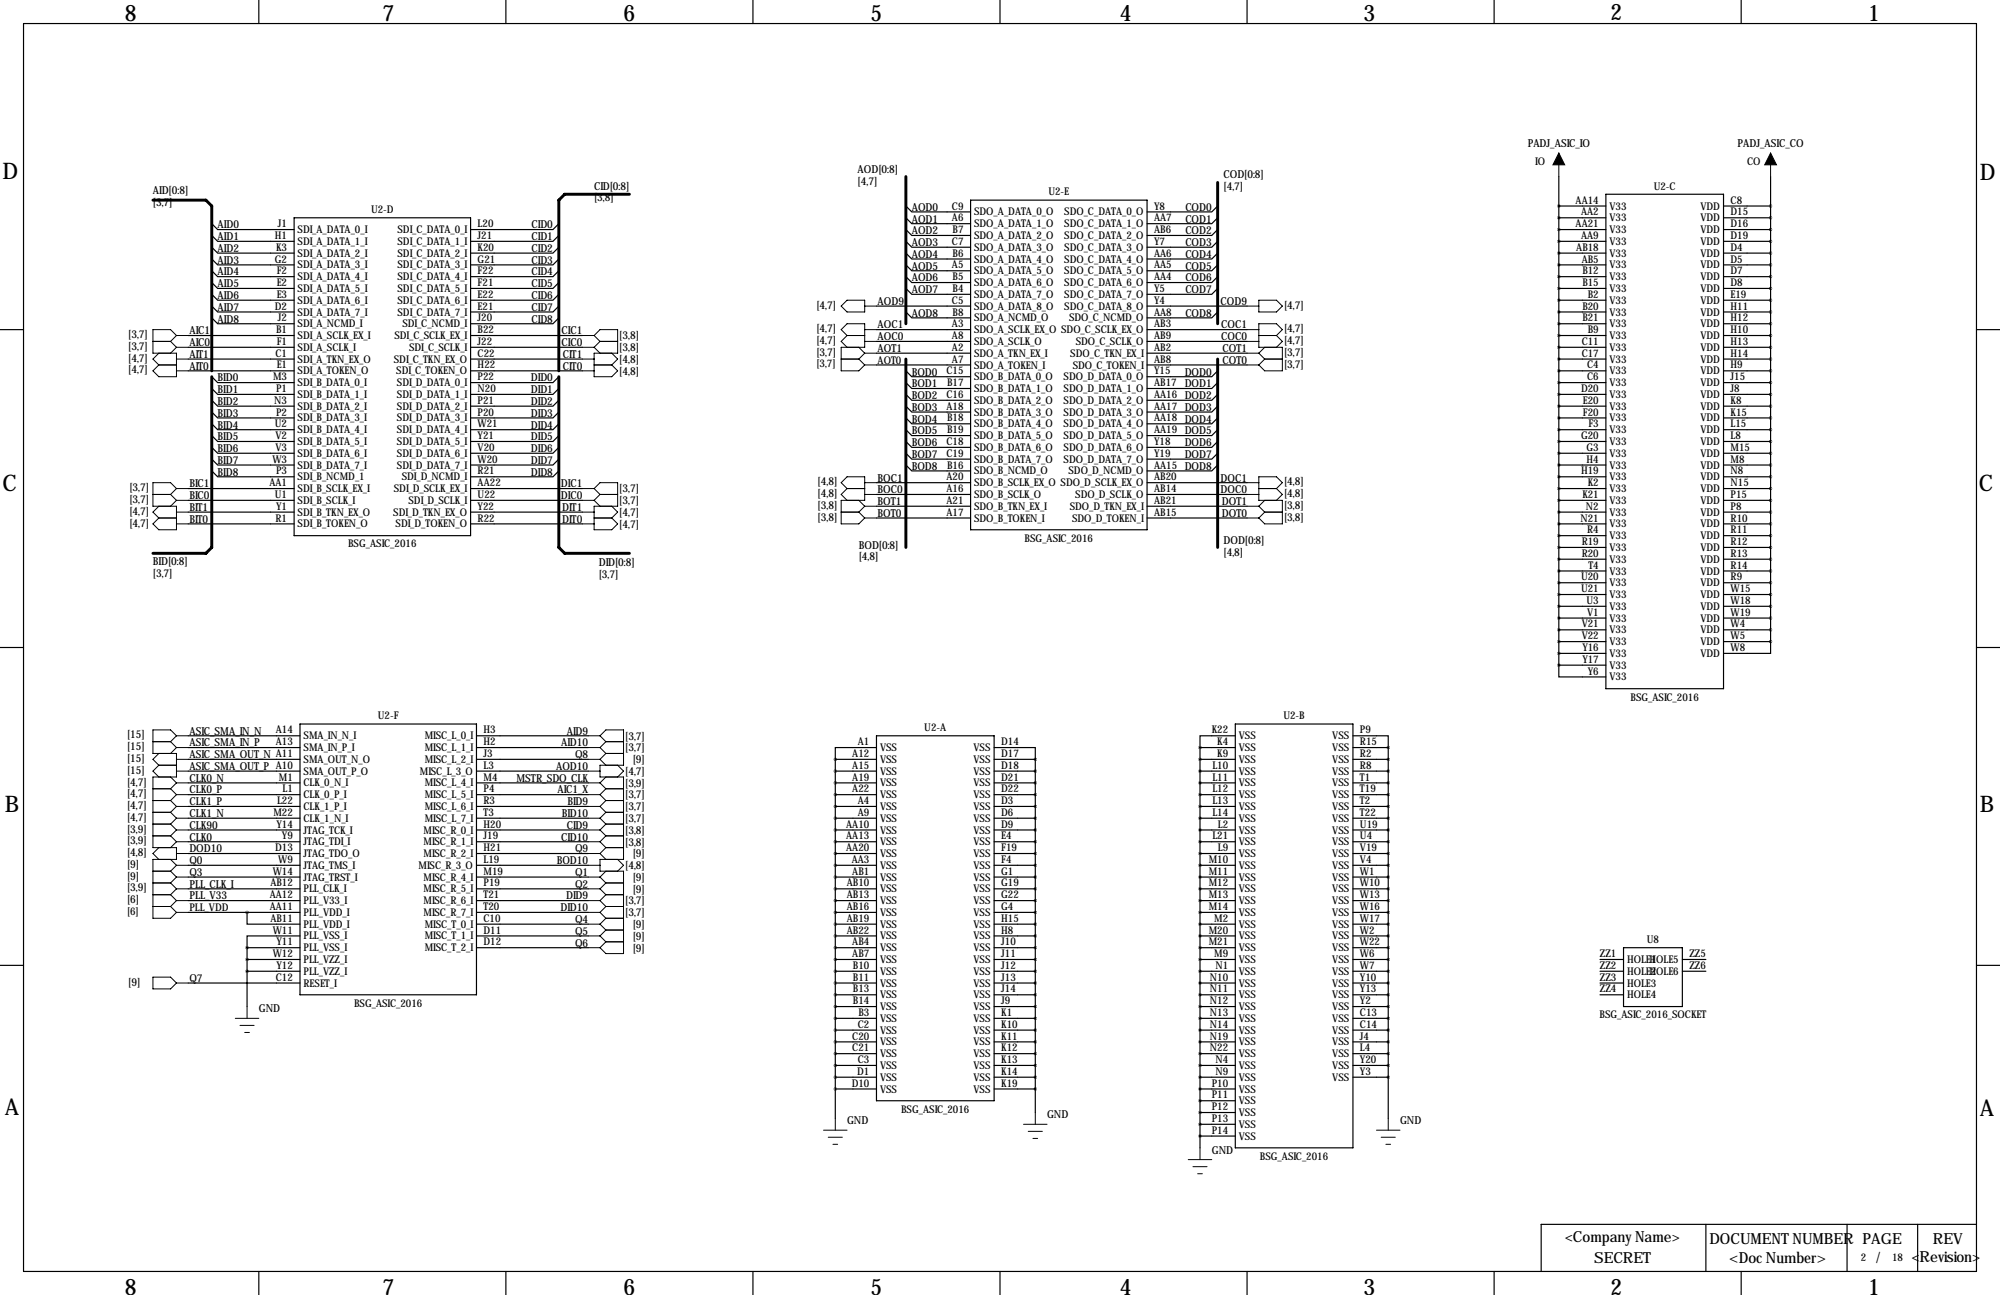
[picture p57: page 2]

D
D

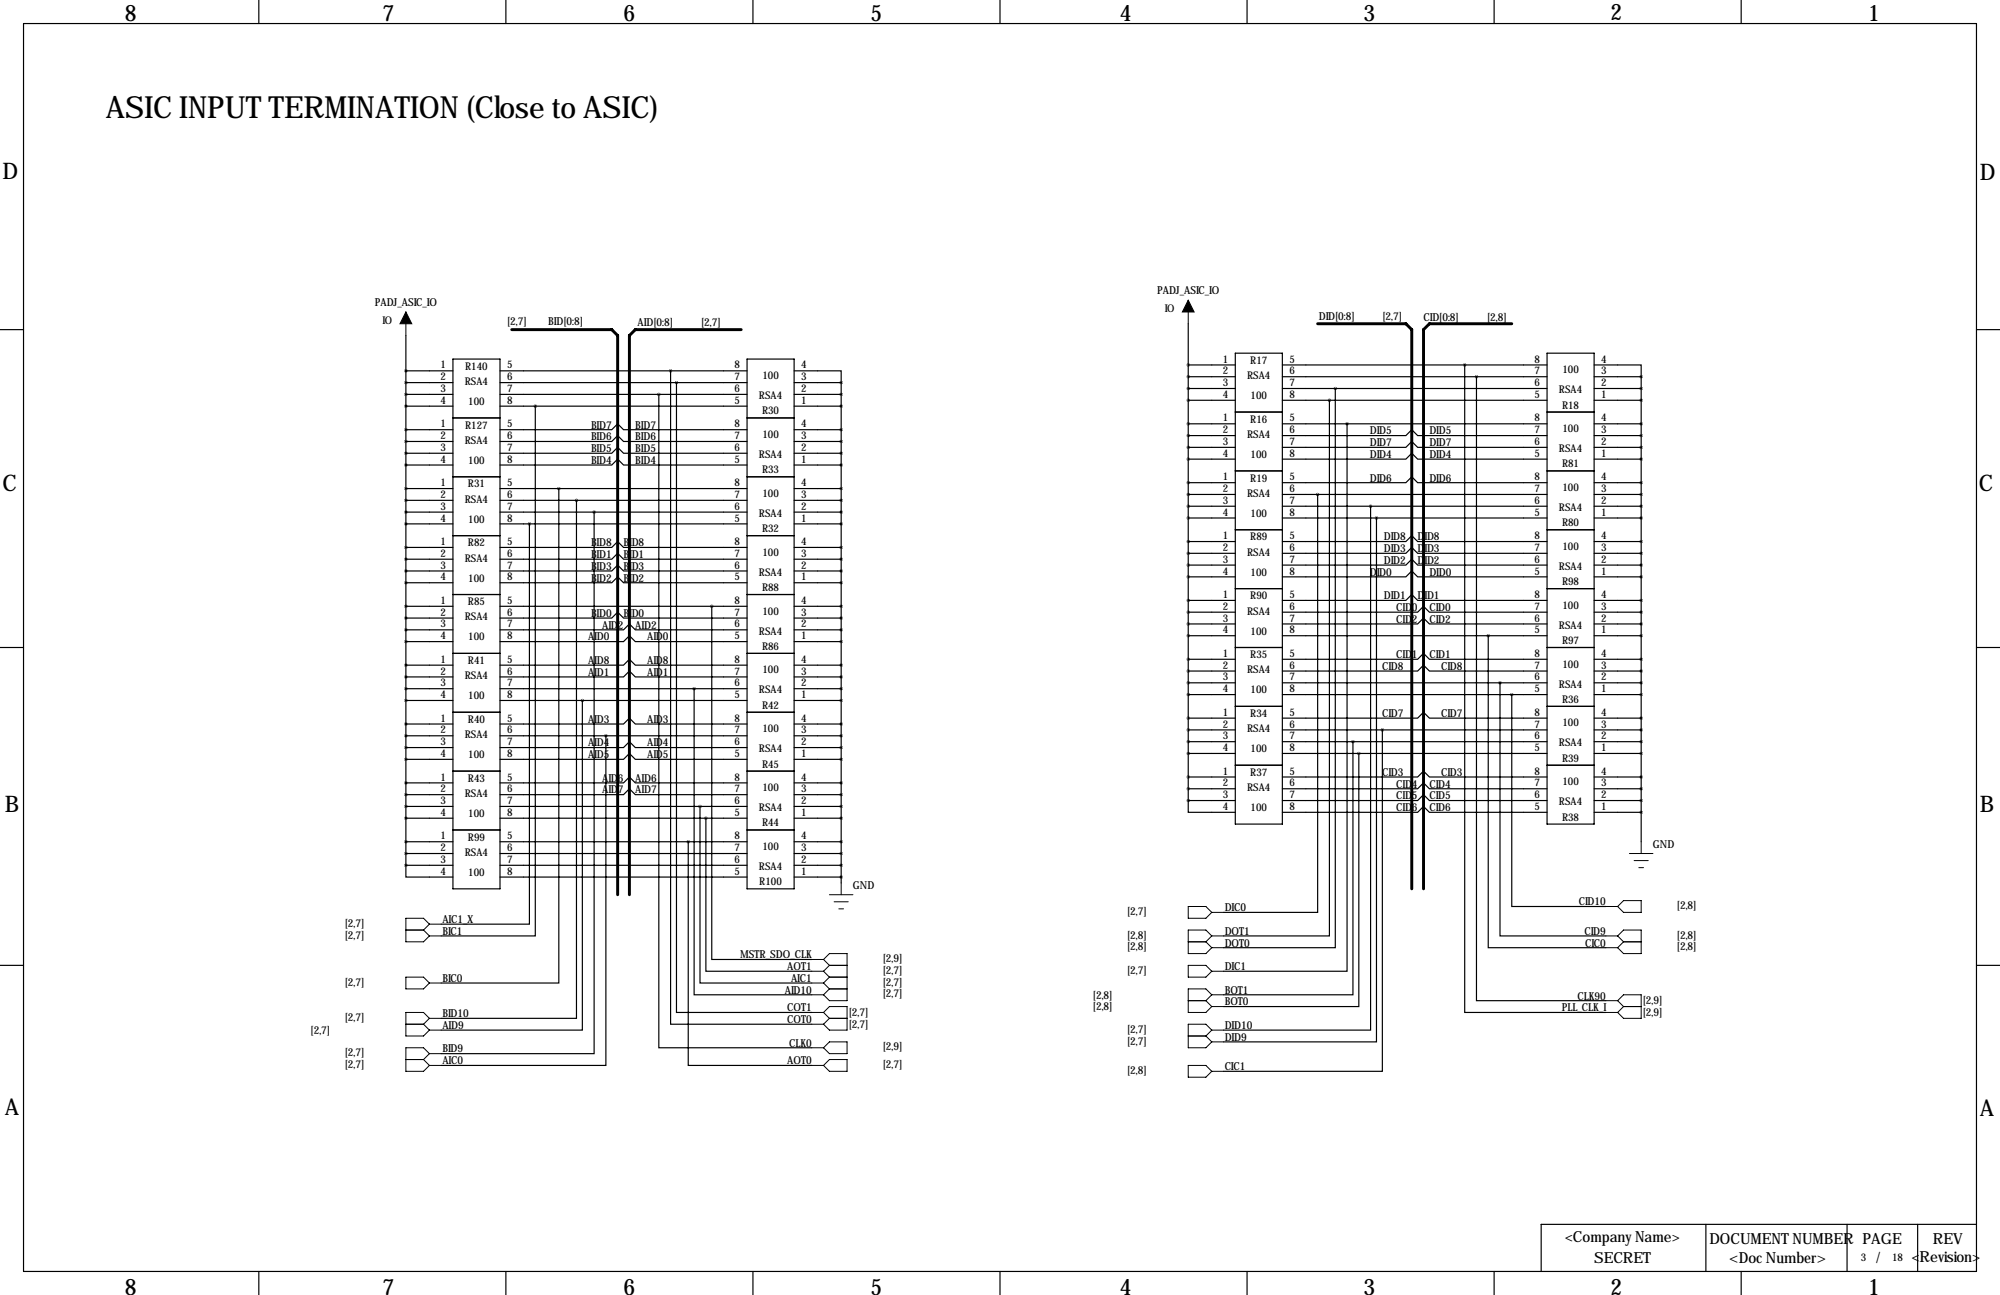
[picture p58: page 3]

ASIC INPUT TERMINATION (Close to ASIC)

D
D

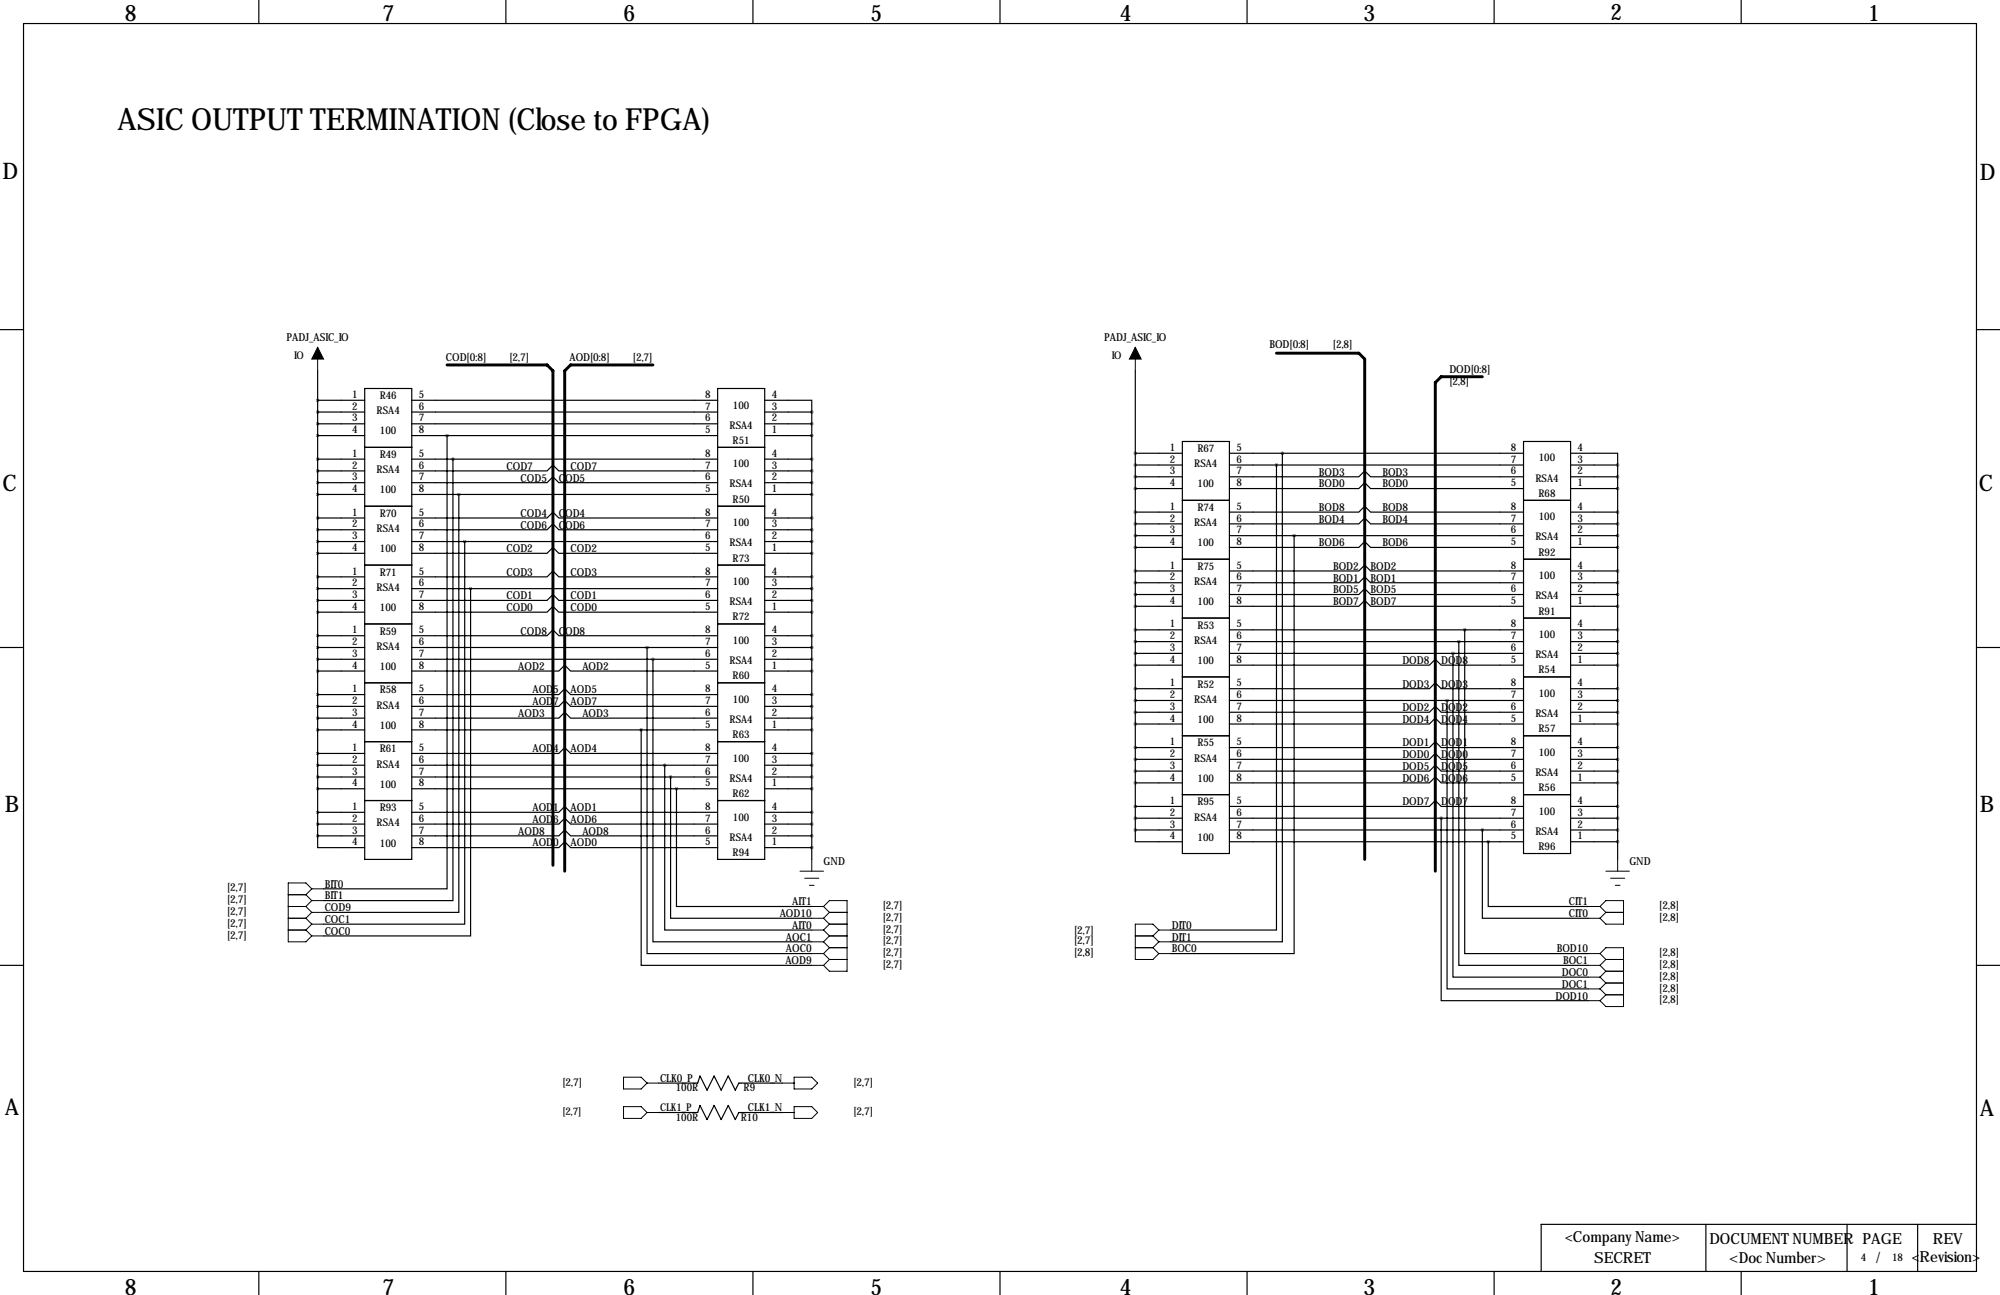
[picture p59: page 4]

ASIC OUTPUT TERMINATION (Close to FPGA)

D
D

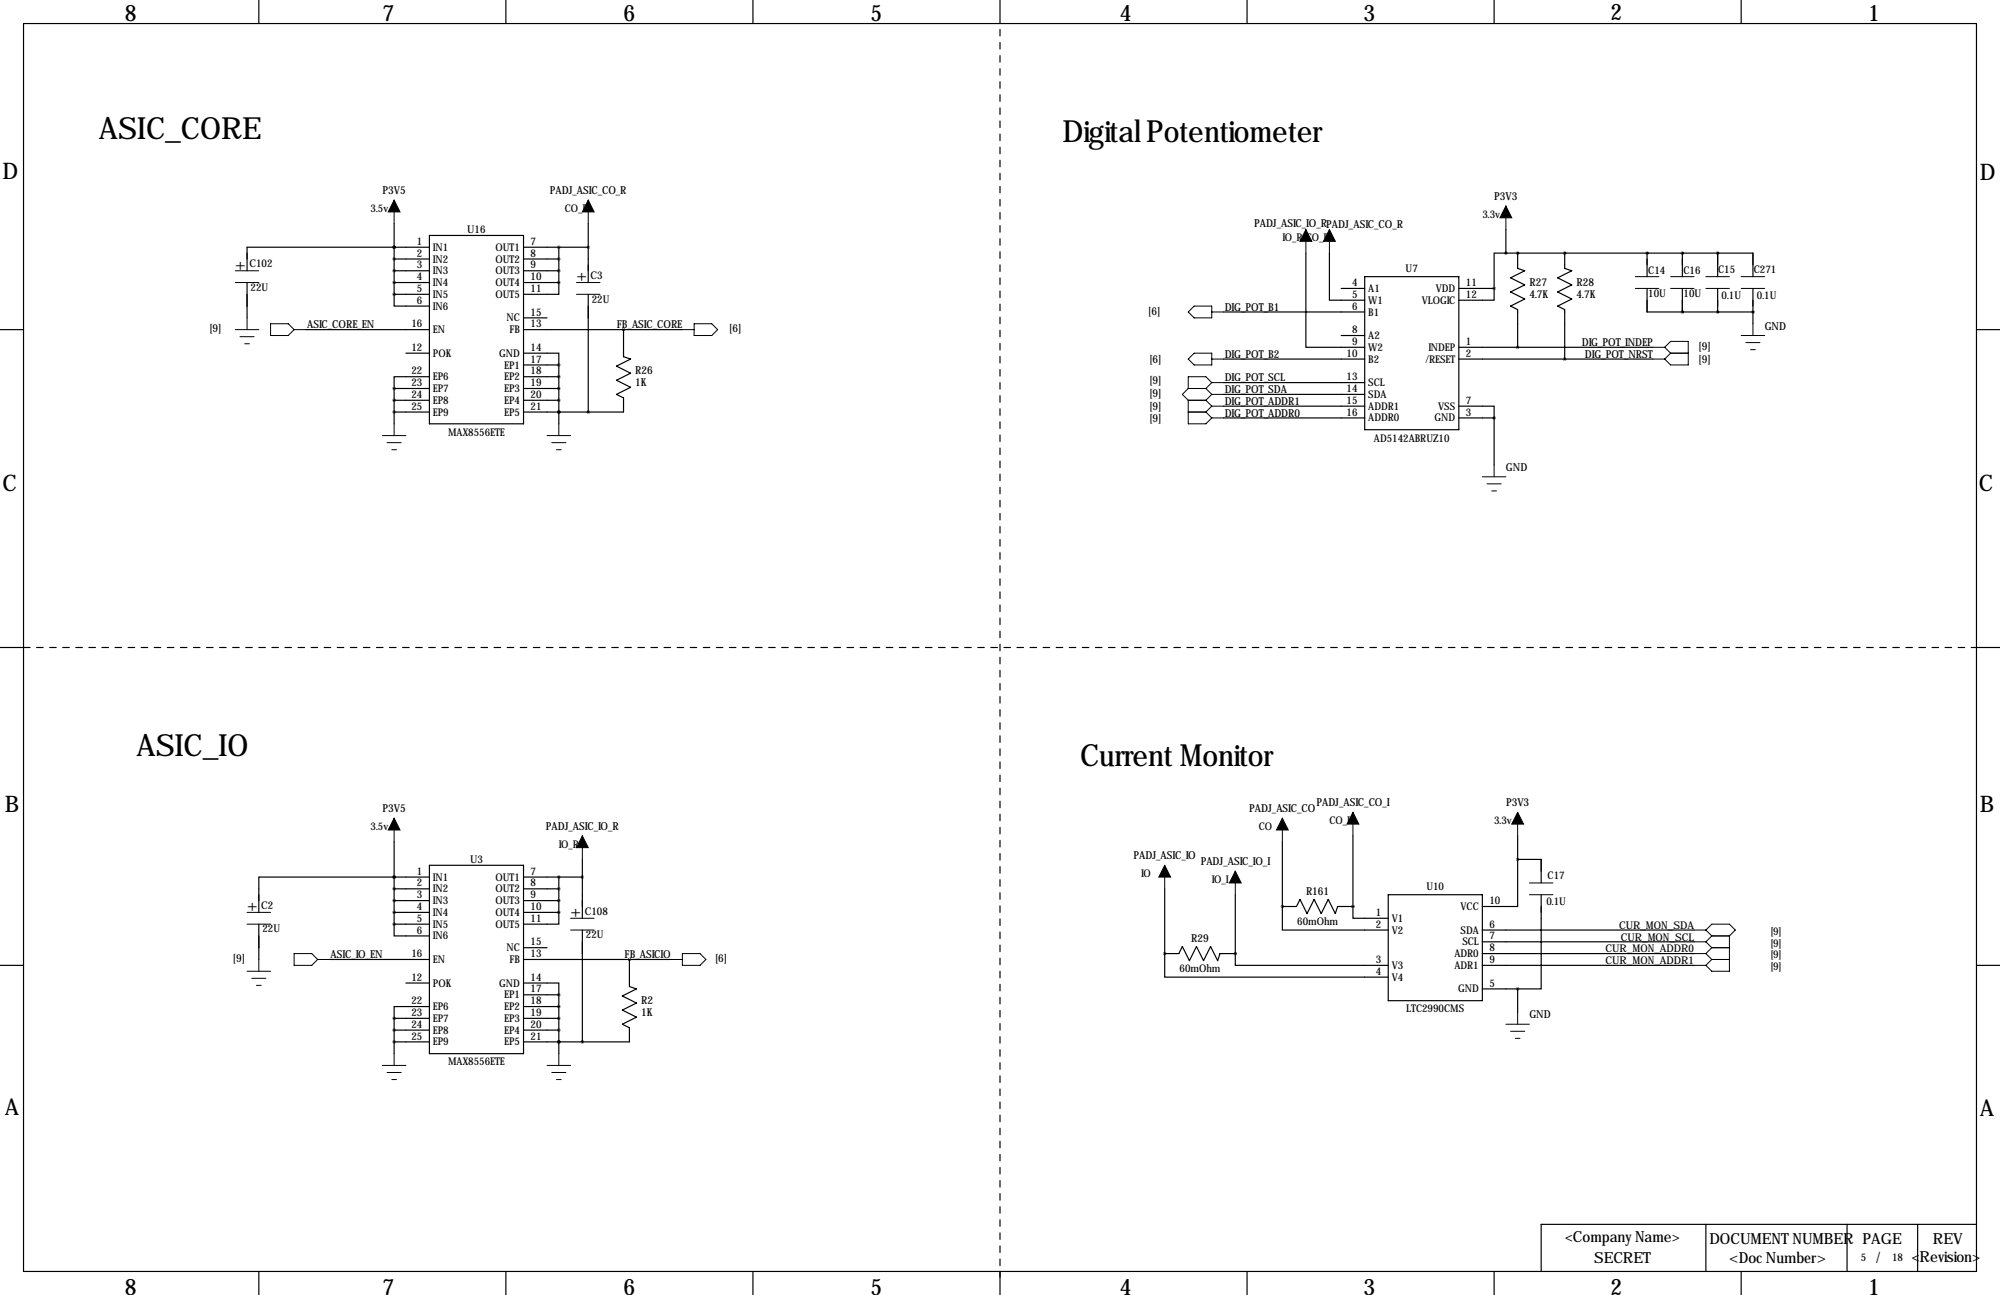
[picture p60: page 5]

D
D

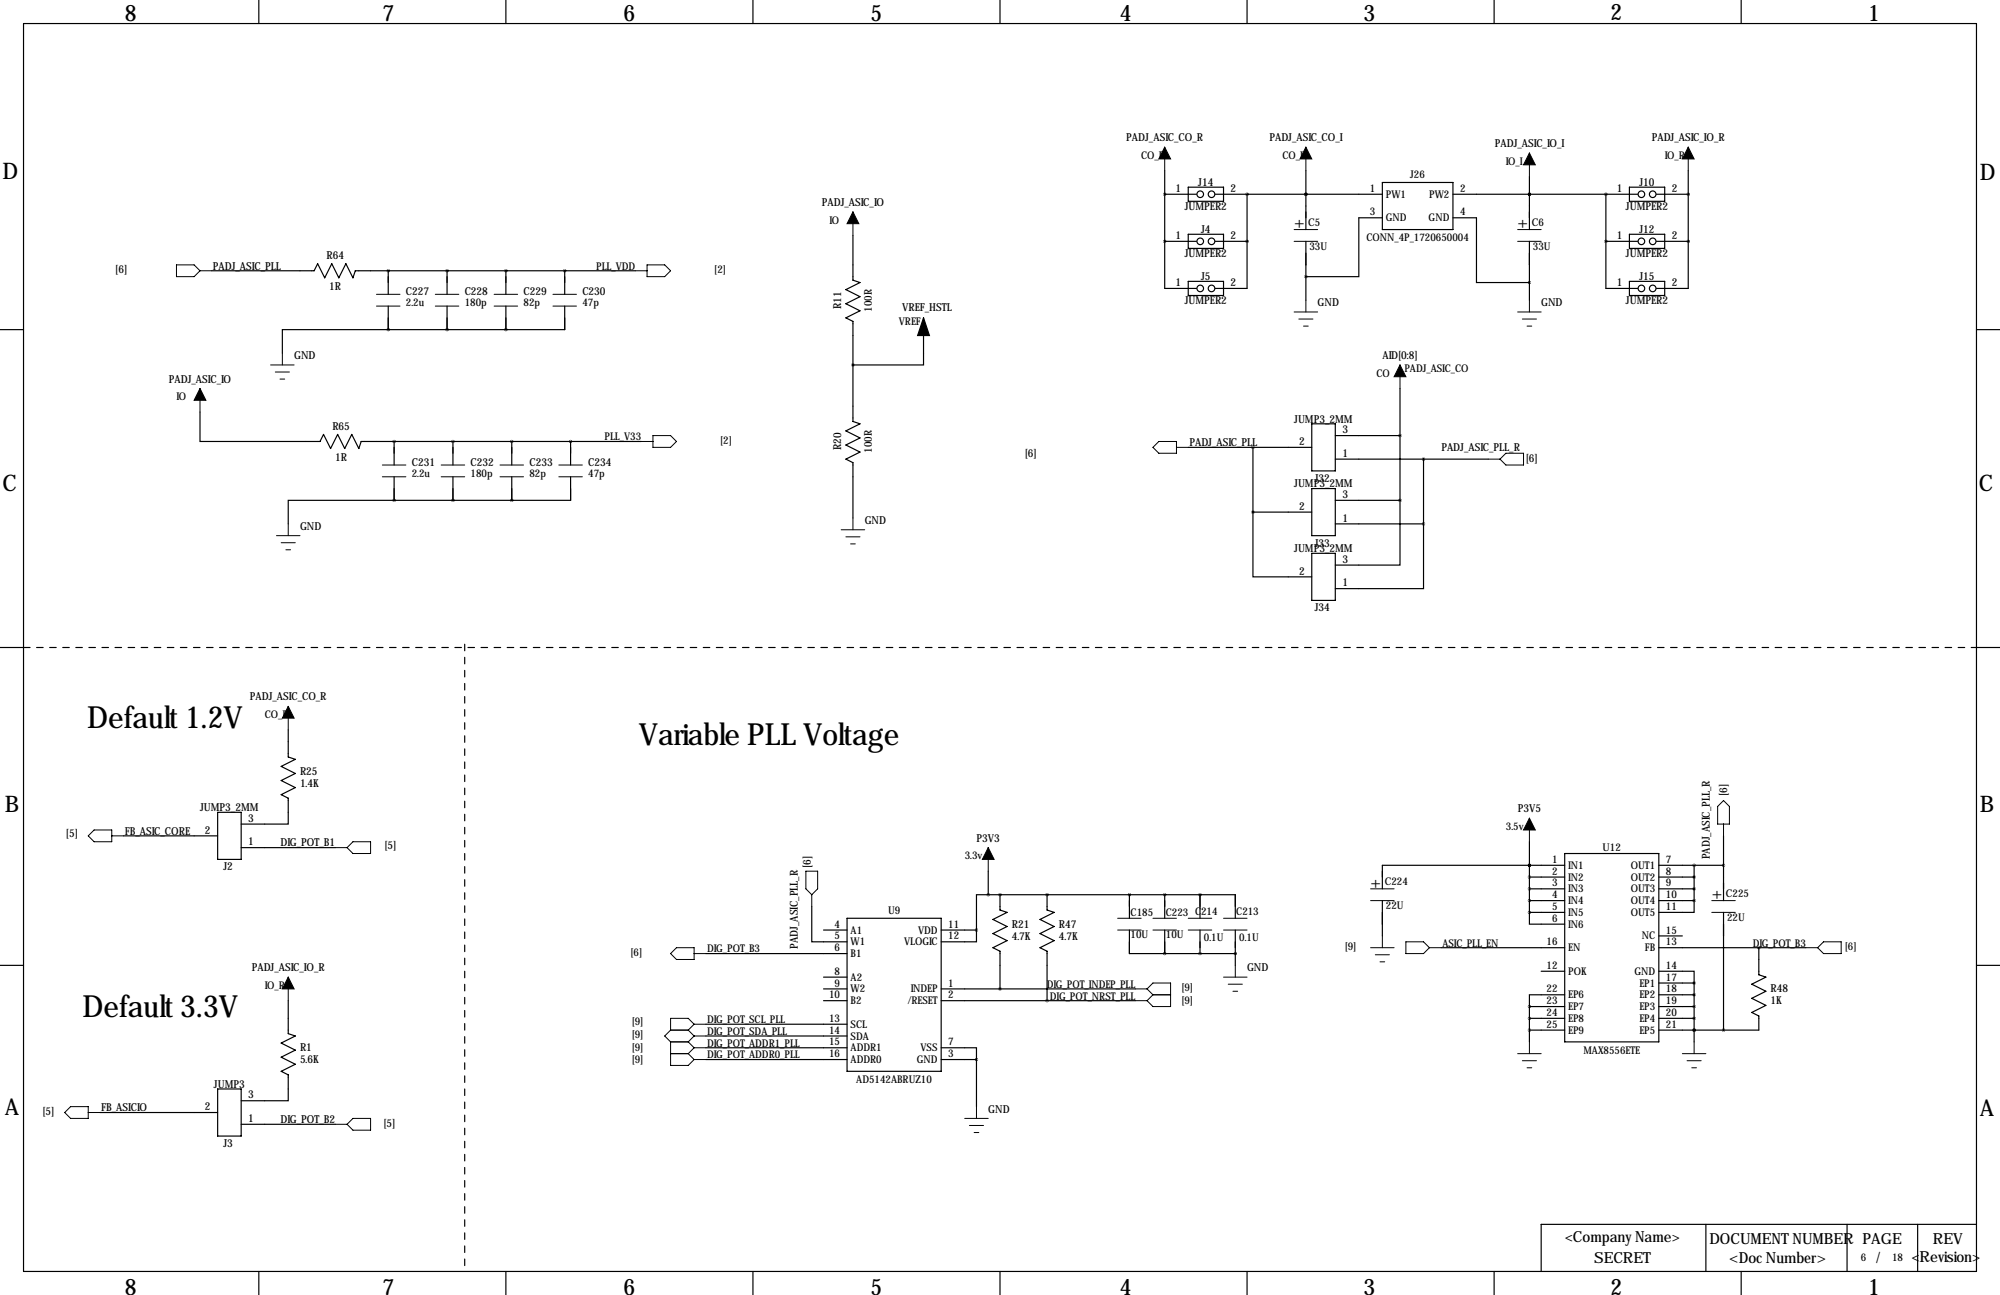
[picture p61: page 6]

D
D

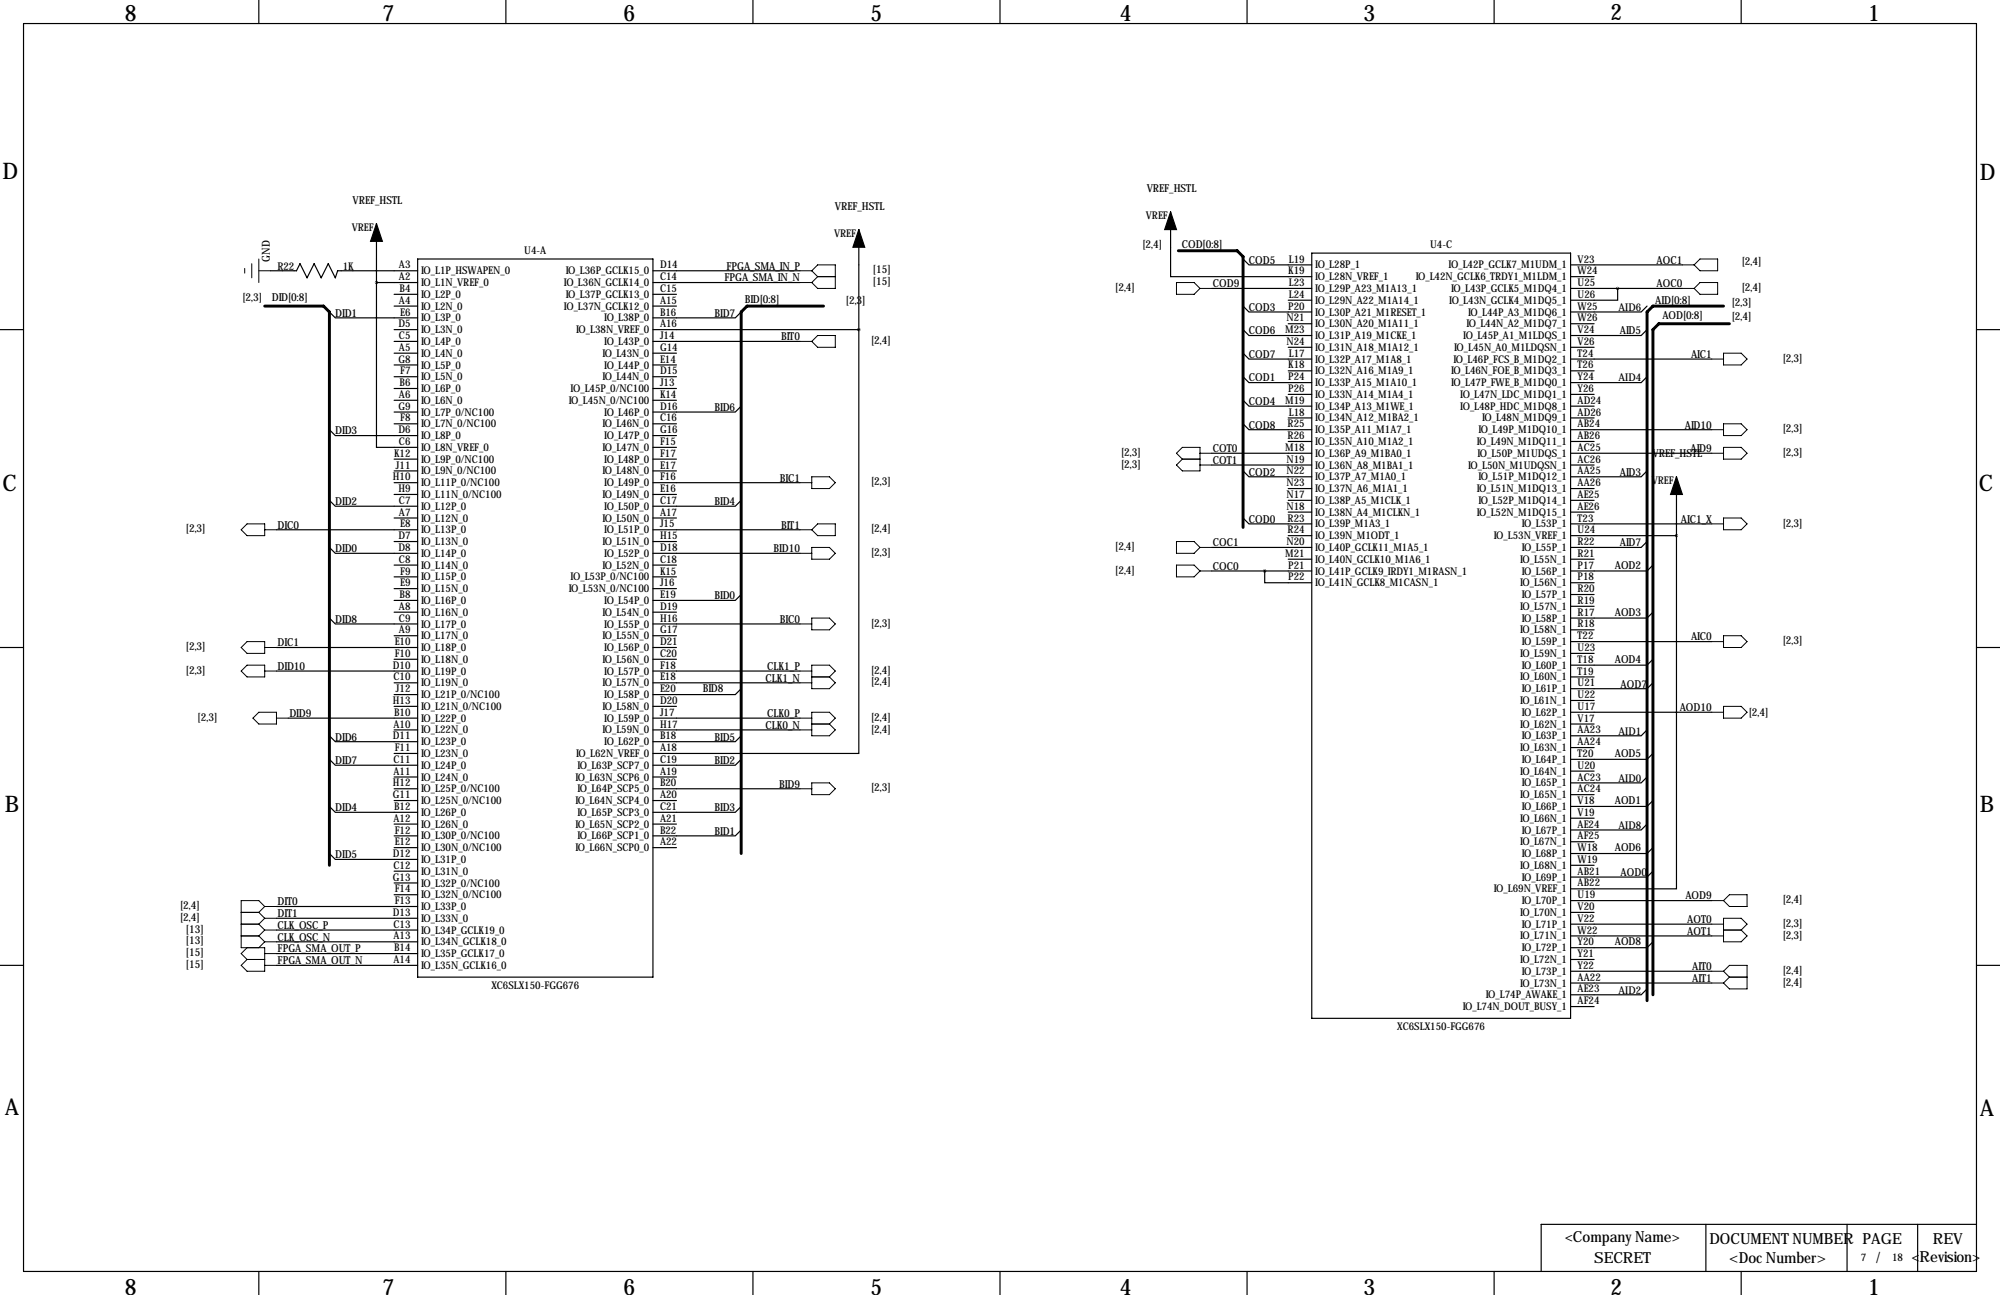
[picture p62: page 7]

D
D

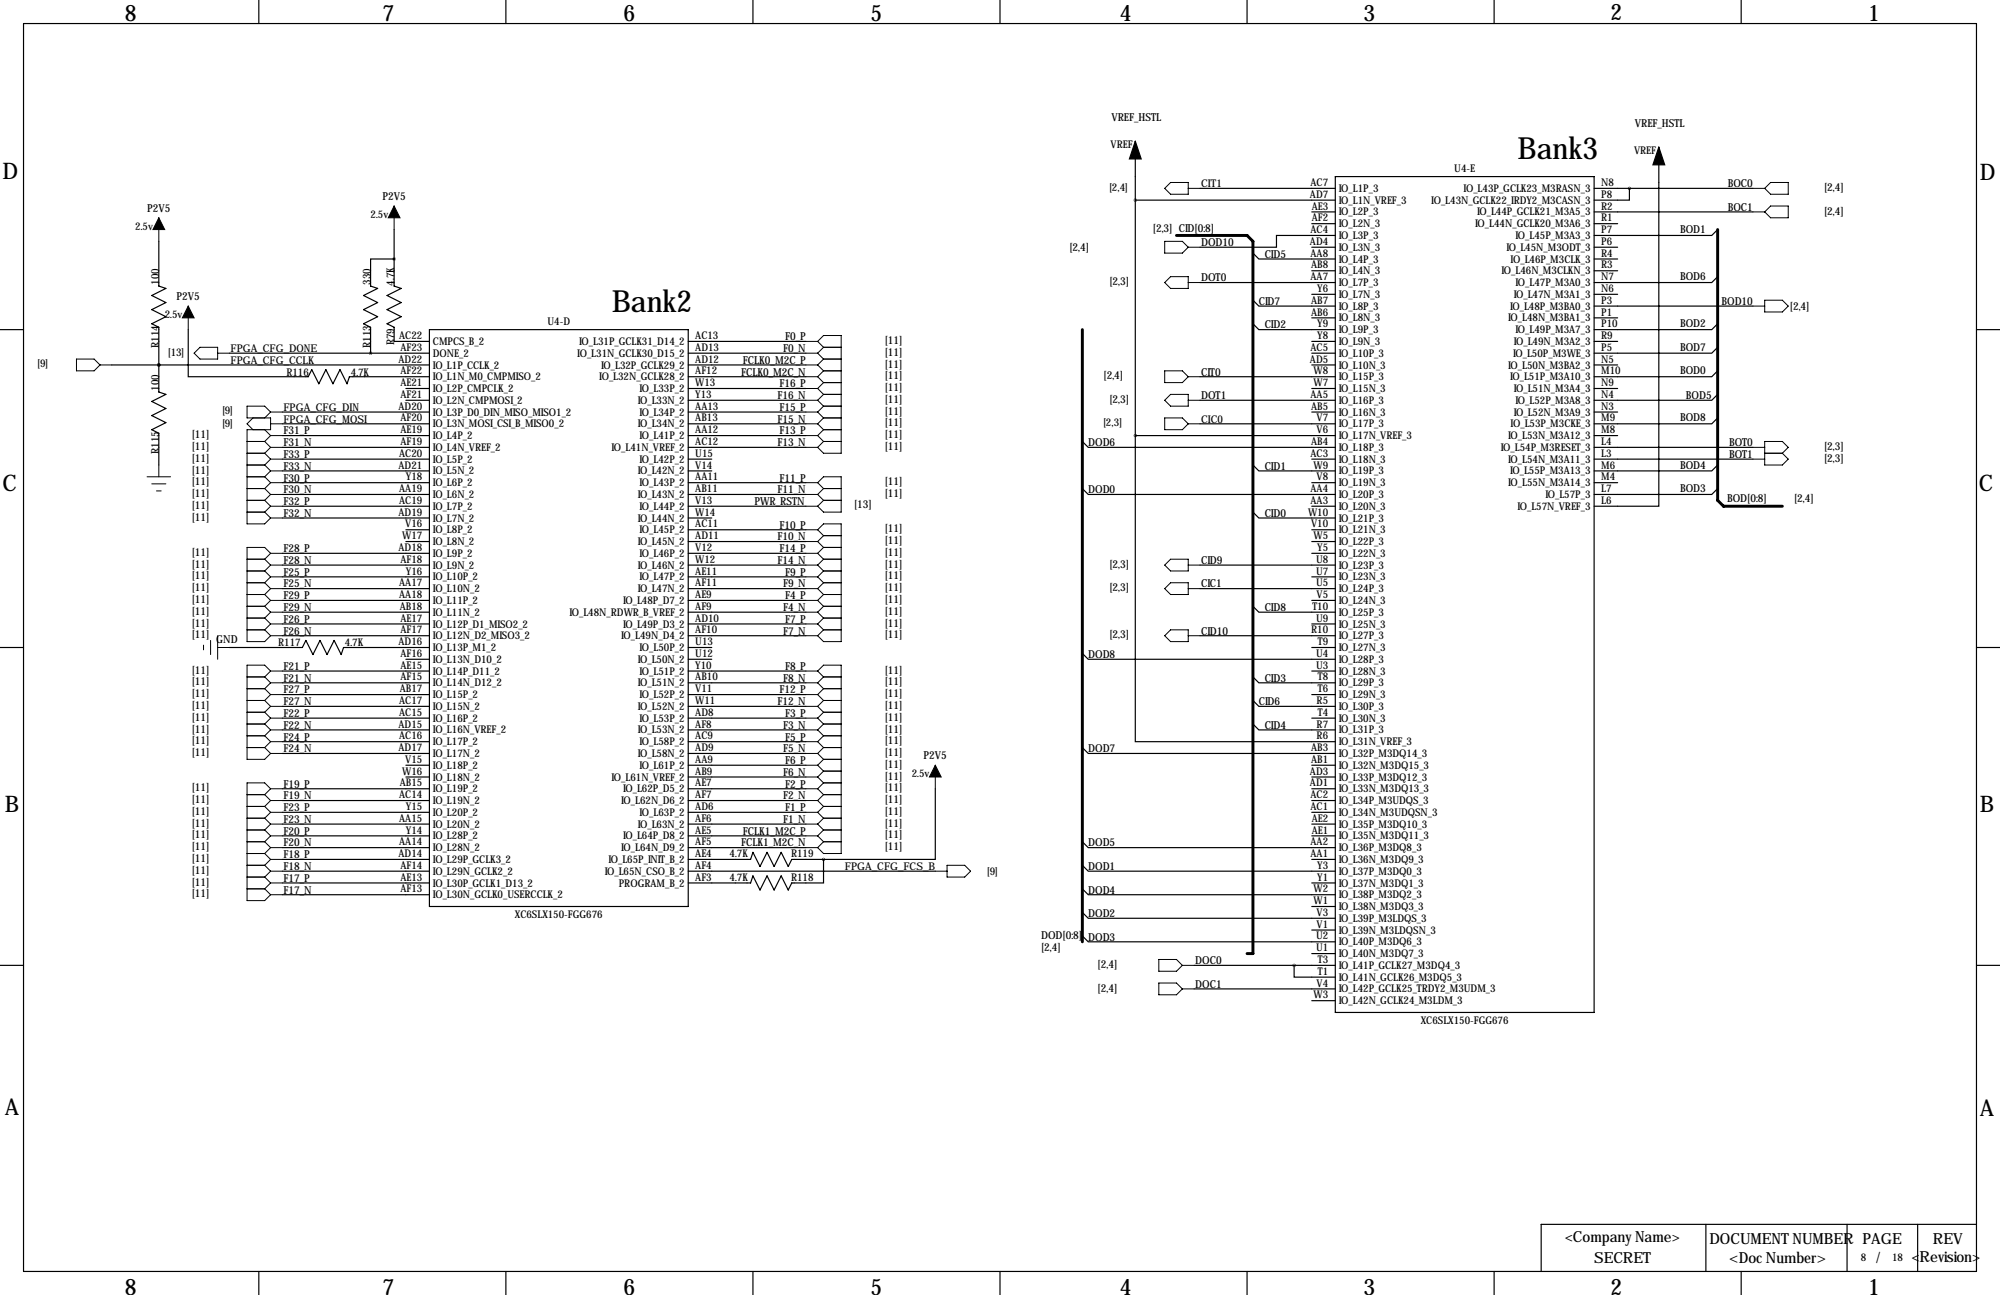
[picture p63: page 8]

# DCBA

# ABCD

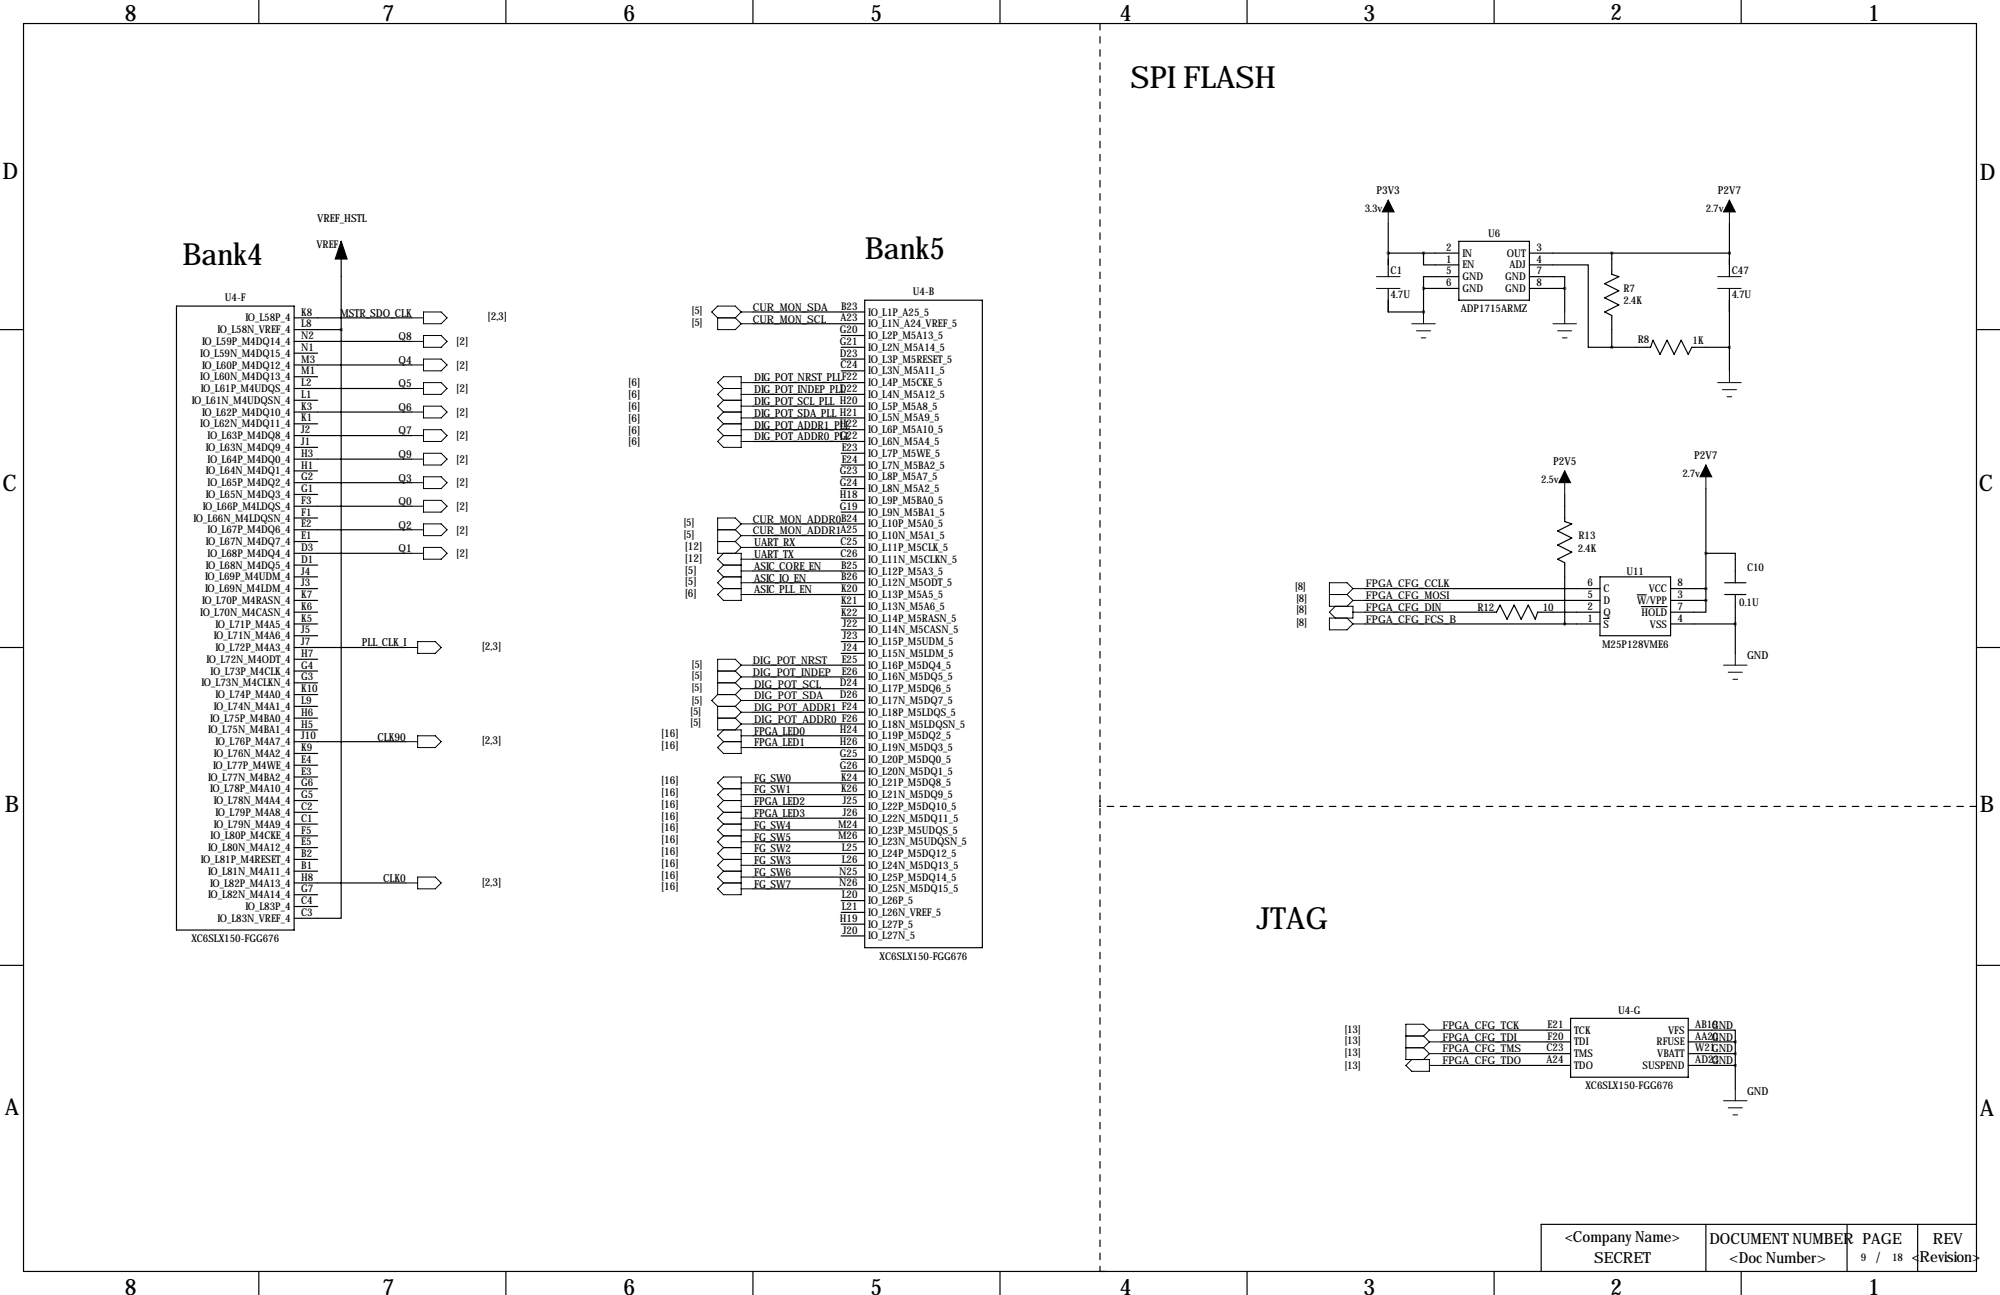
[picture p64: page 9]

# DCBA

# ABCD

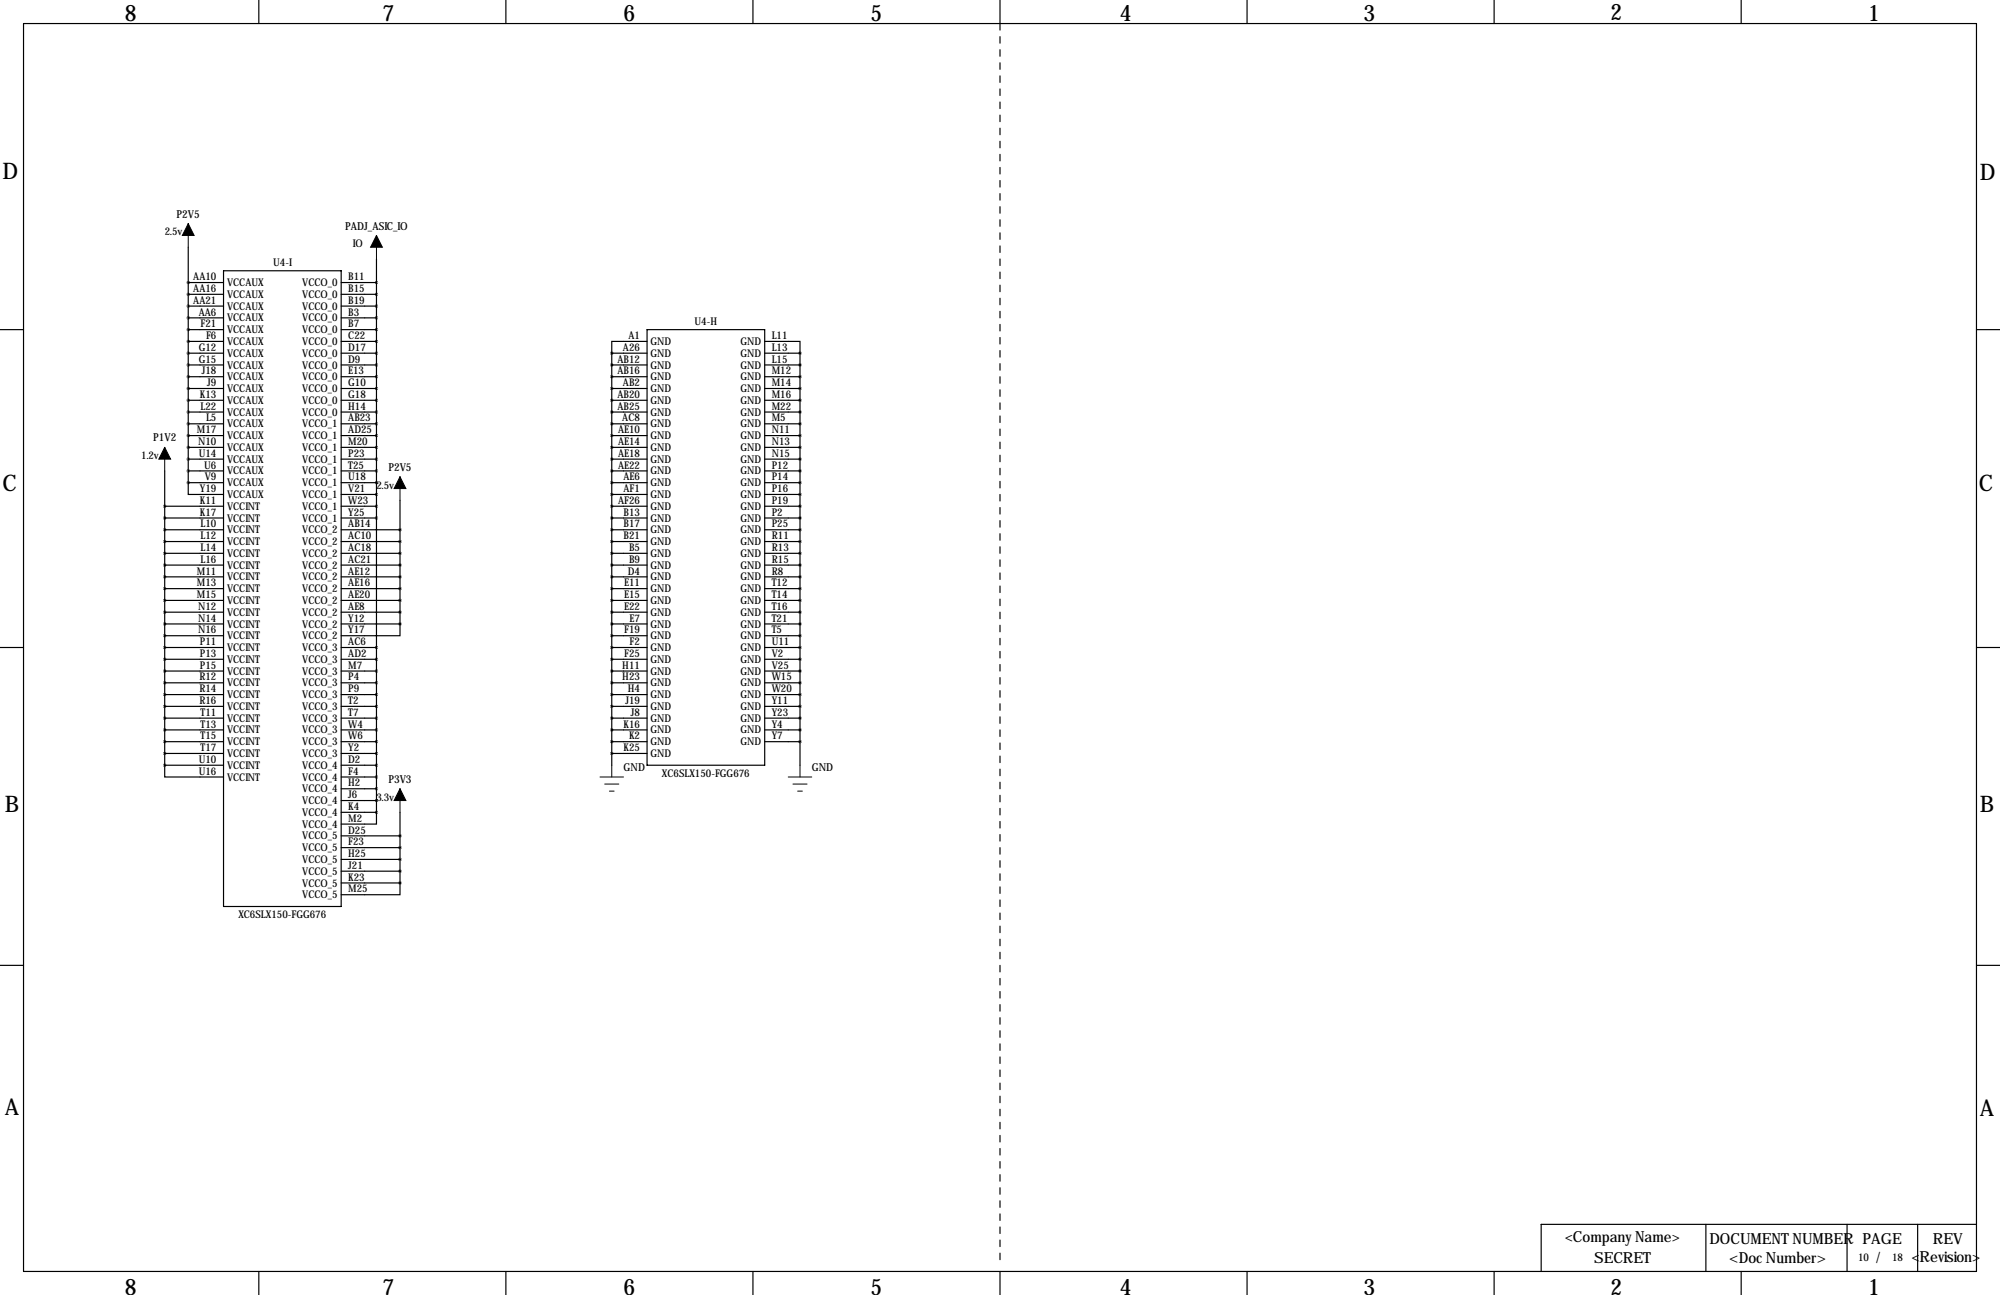
[picture p65: page 10]

# DCBA

# ABCD

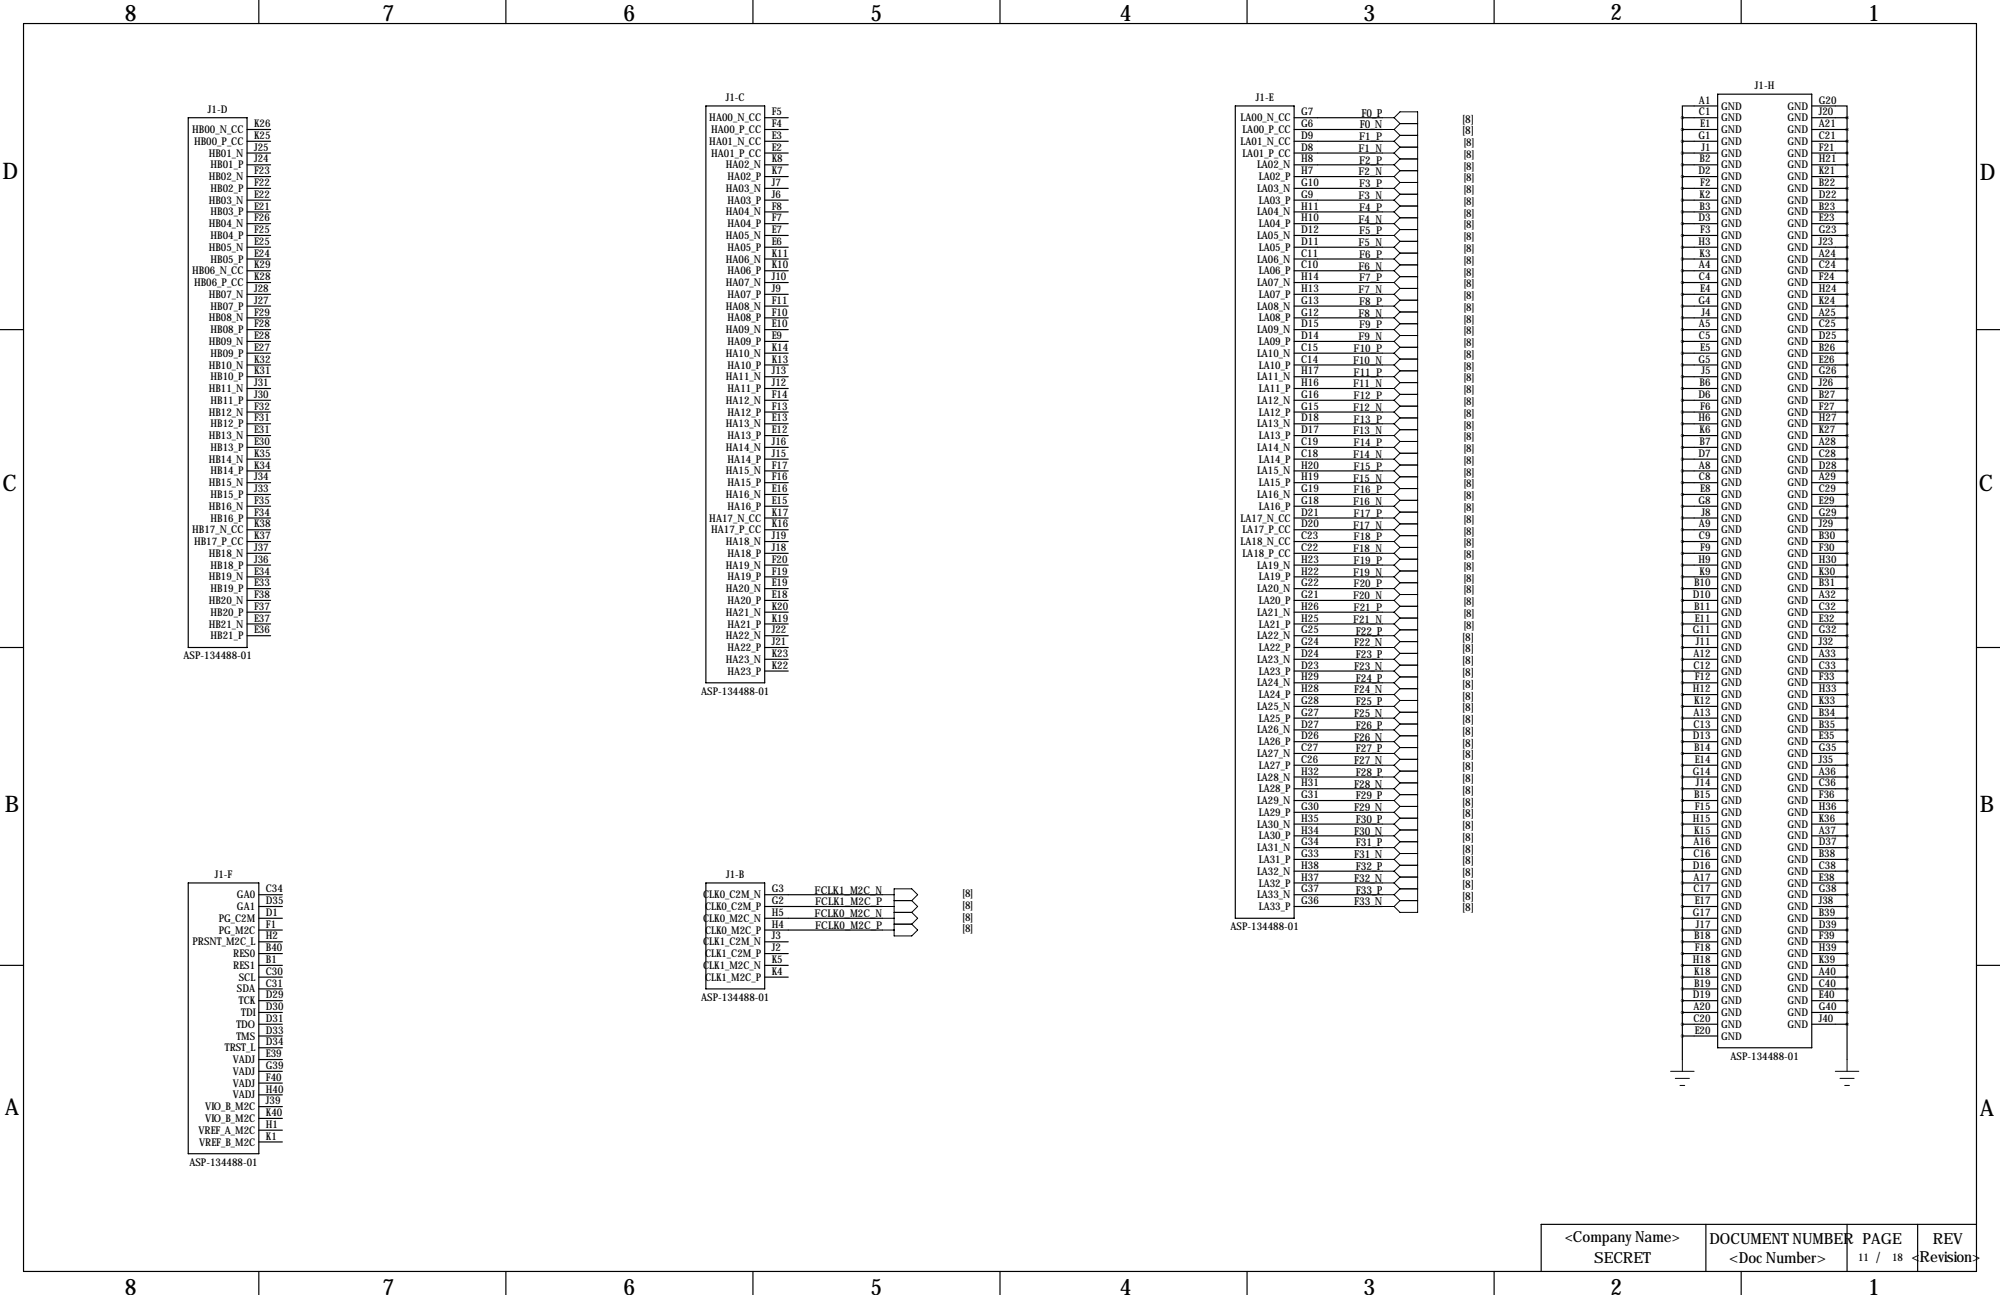
[picture p66: page 11]

D
D

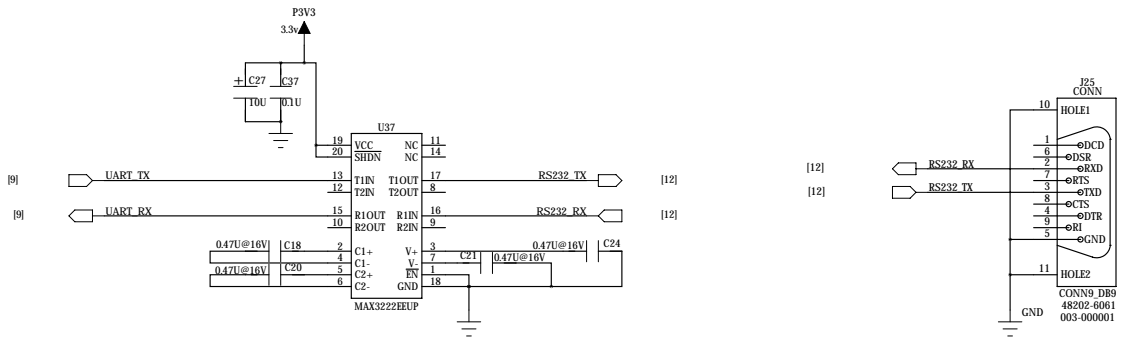
[picture p67: page 12]

D
D

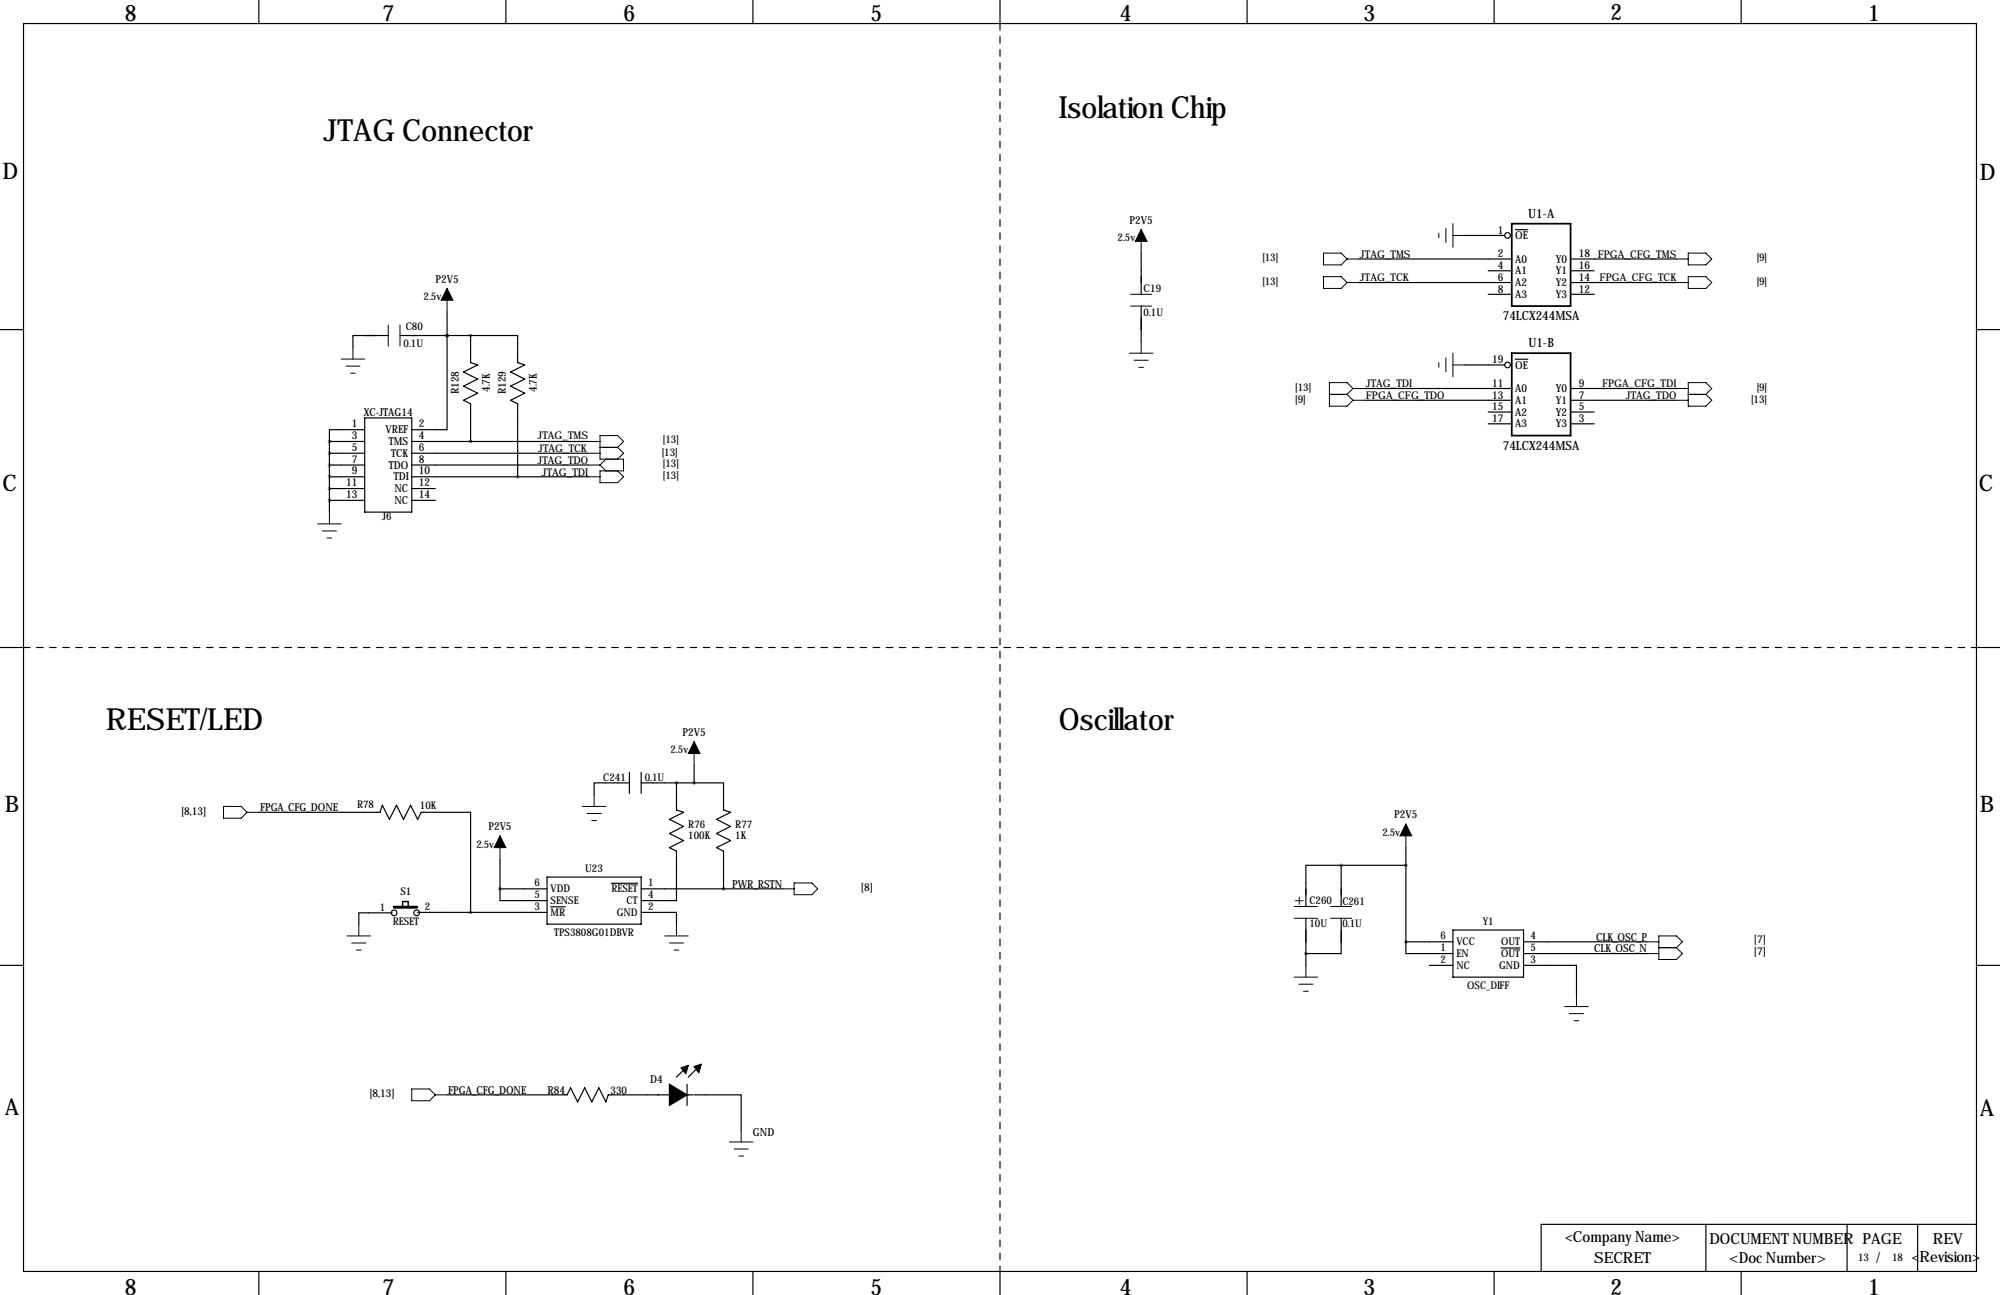
[picture p68: page 13]

D
D

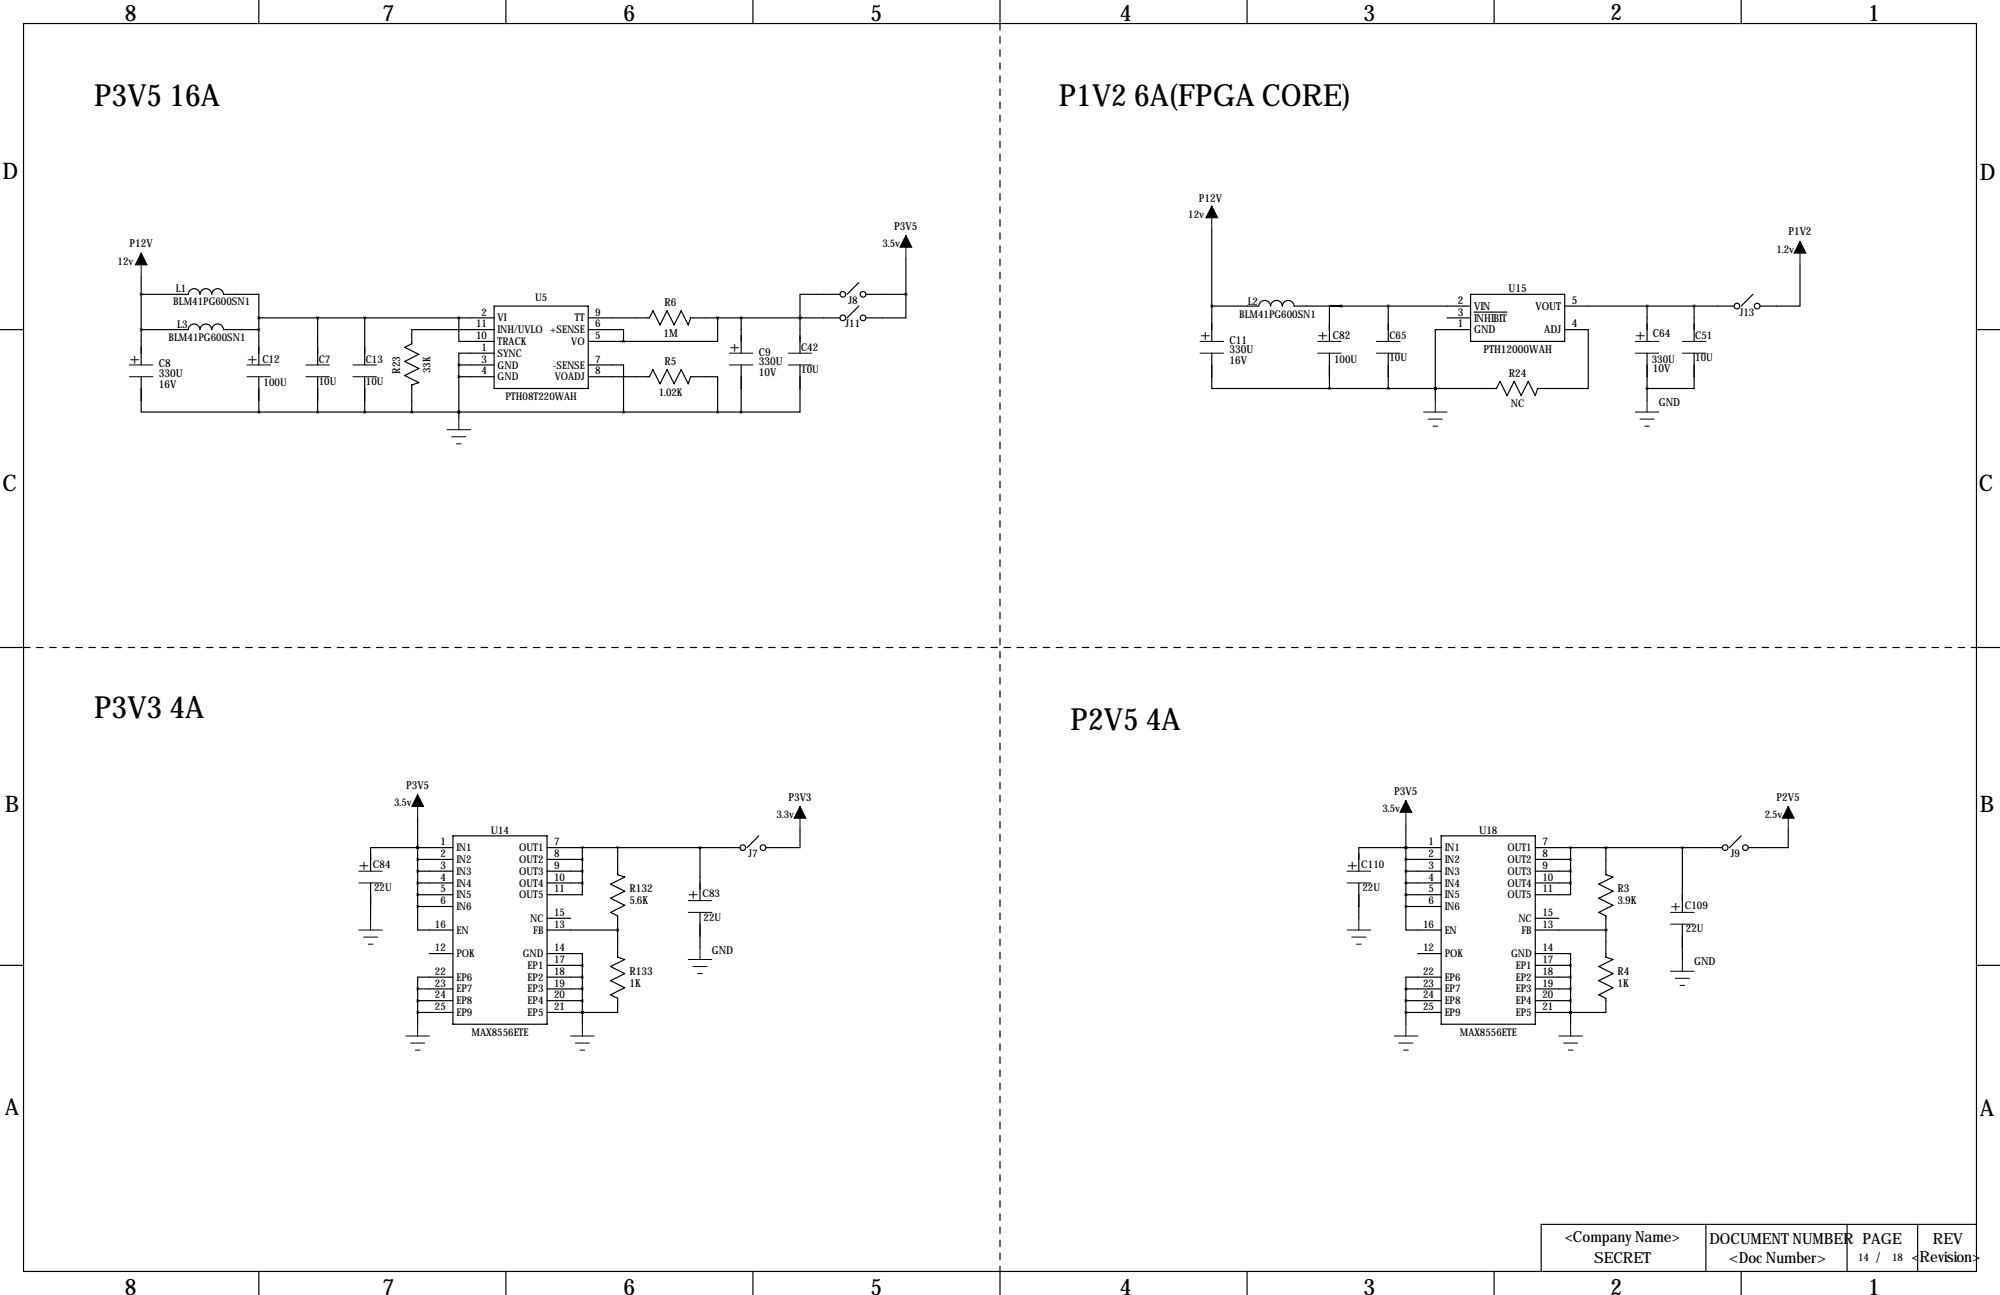
[picture p69: page 14]

D
D

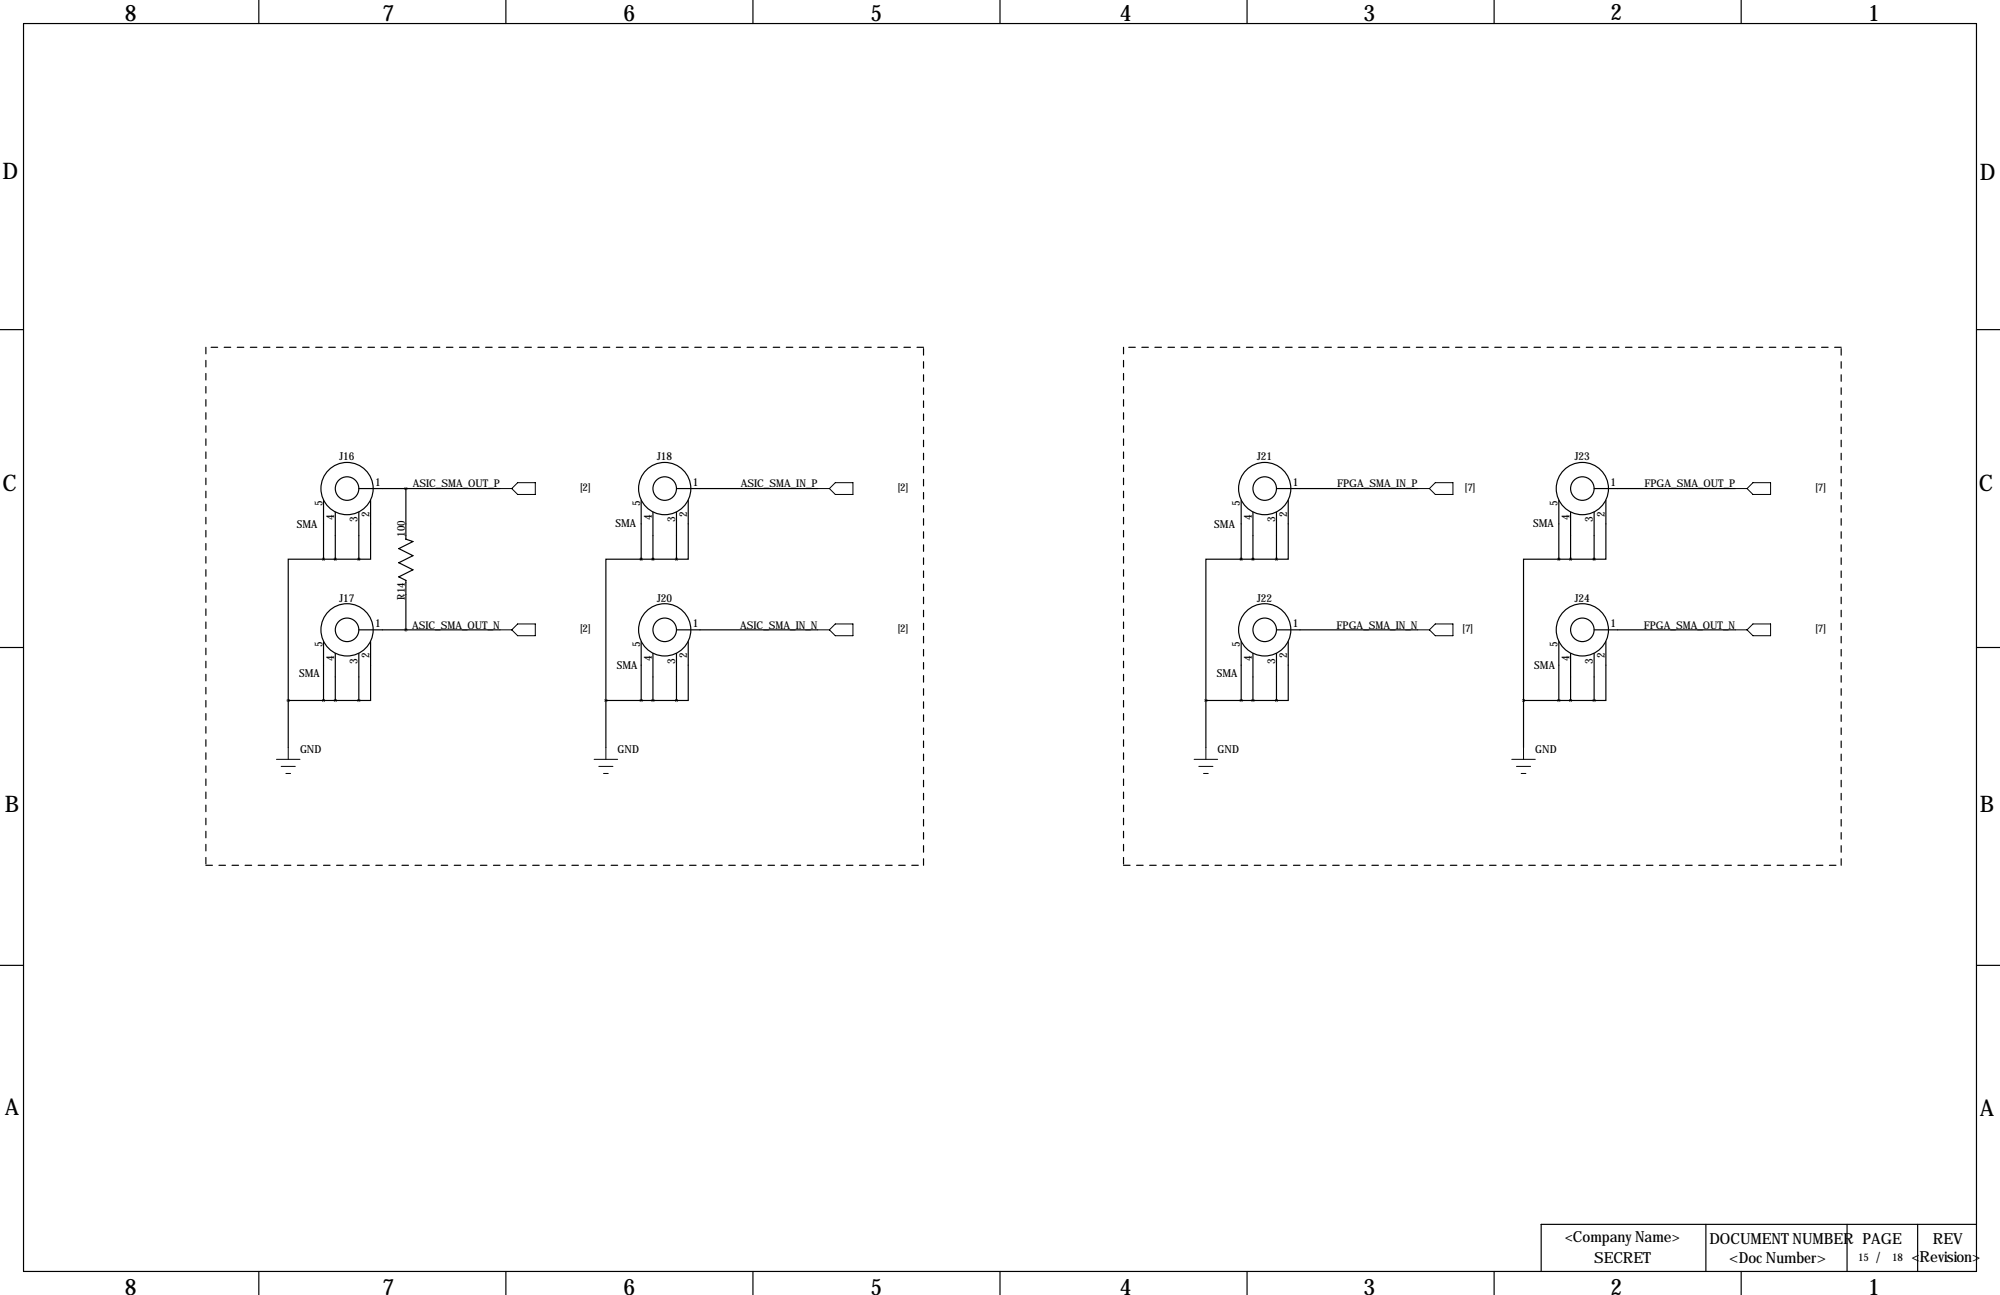
[picture p70: page 15]

D
D

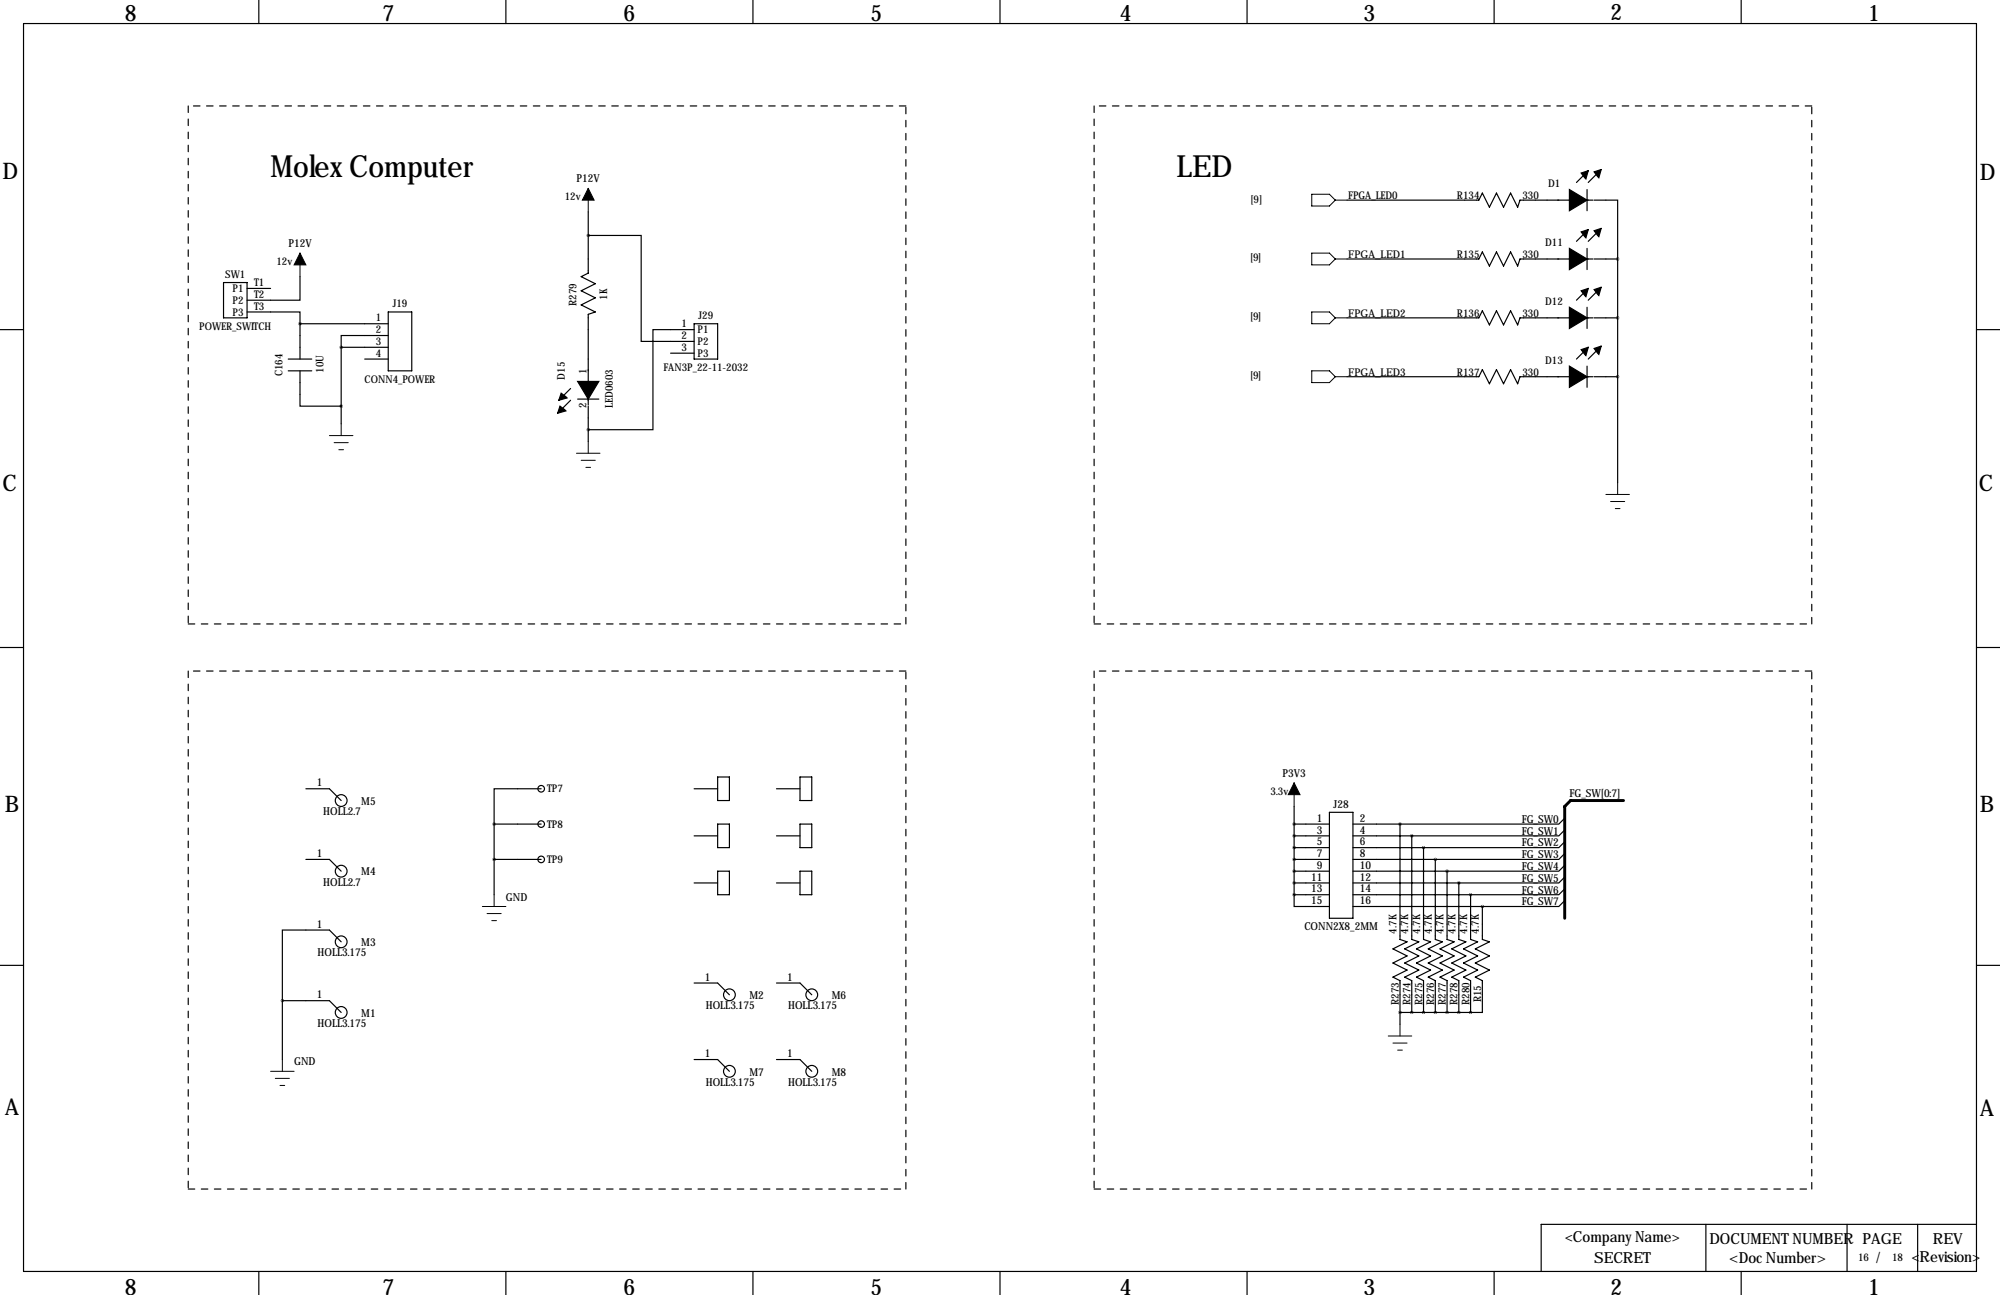
[picture p71: page 16]

D

D

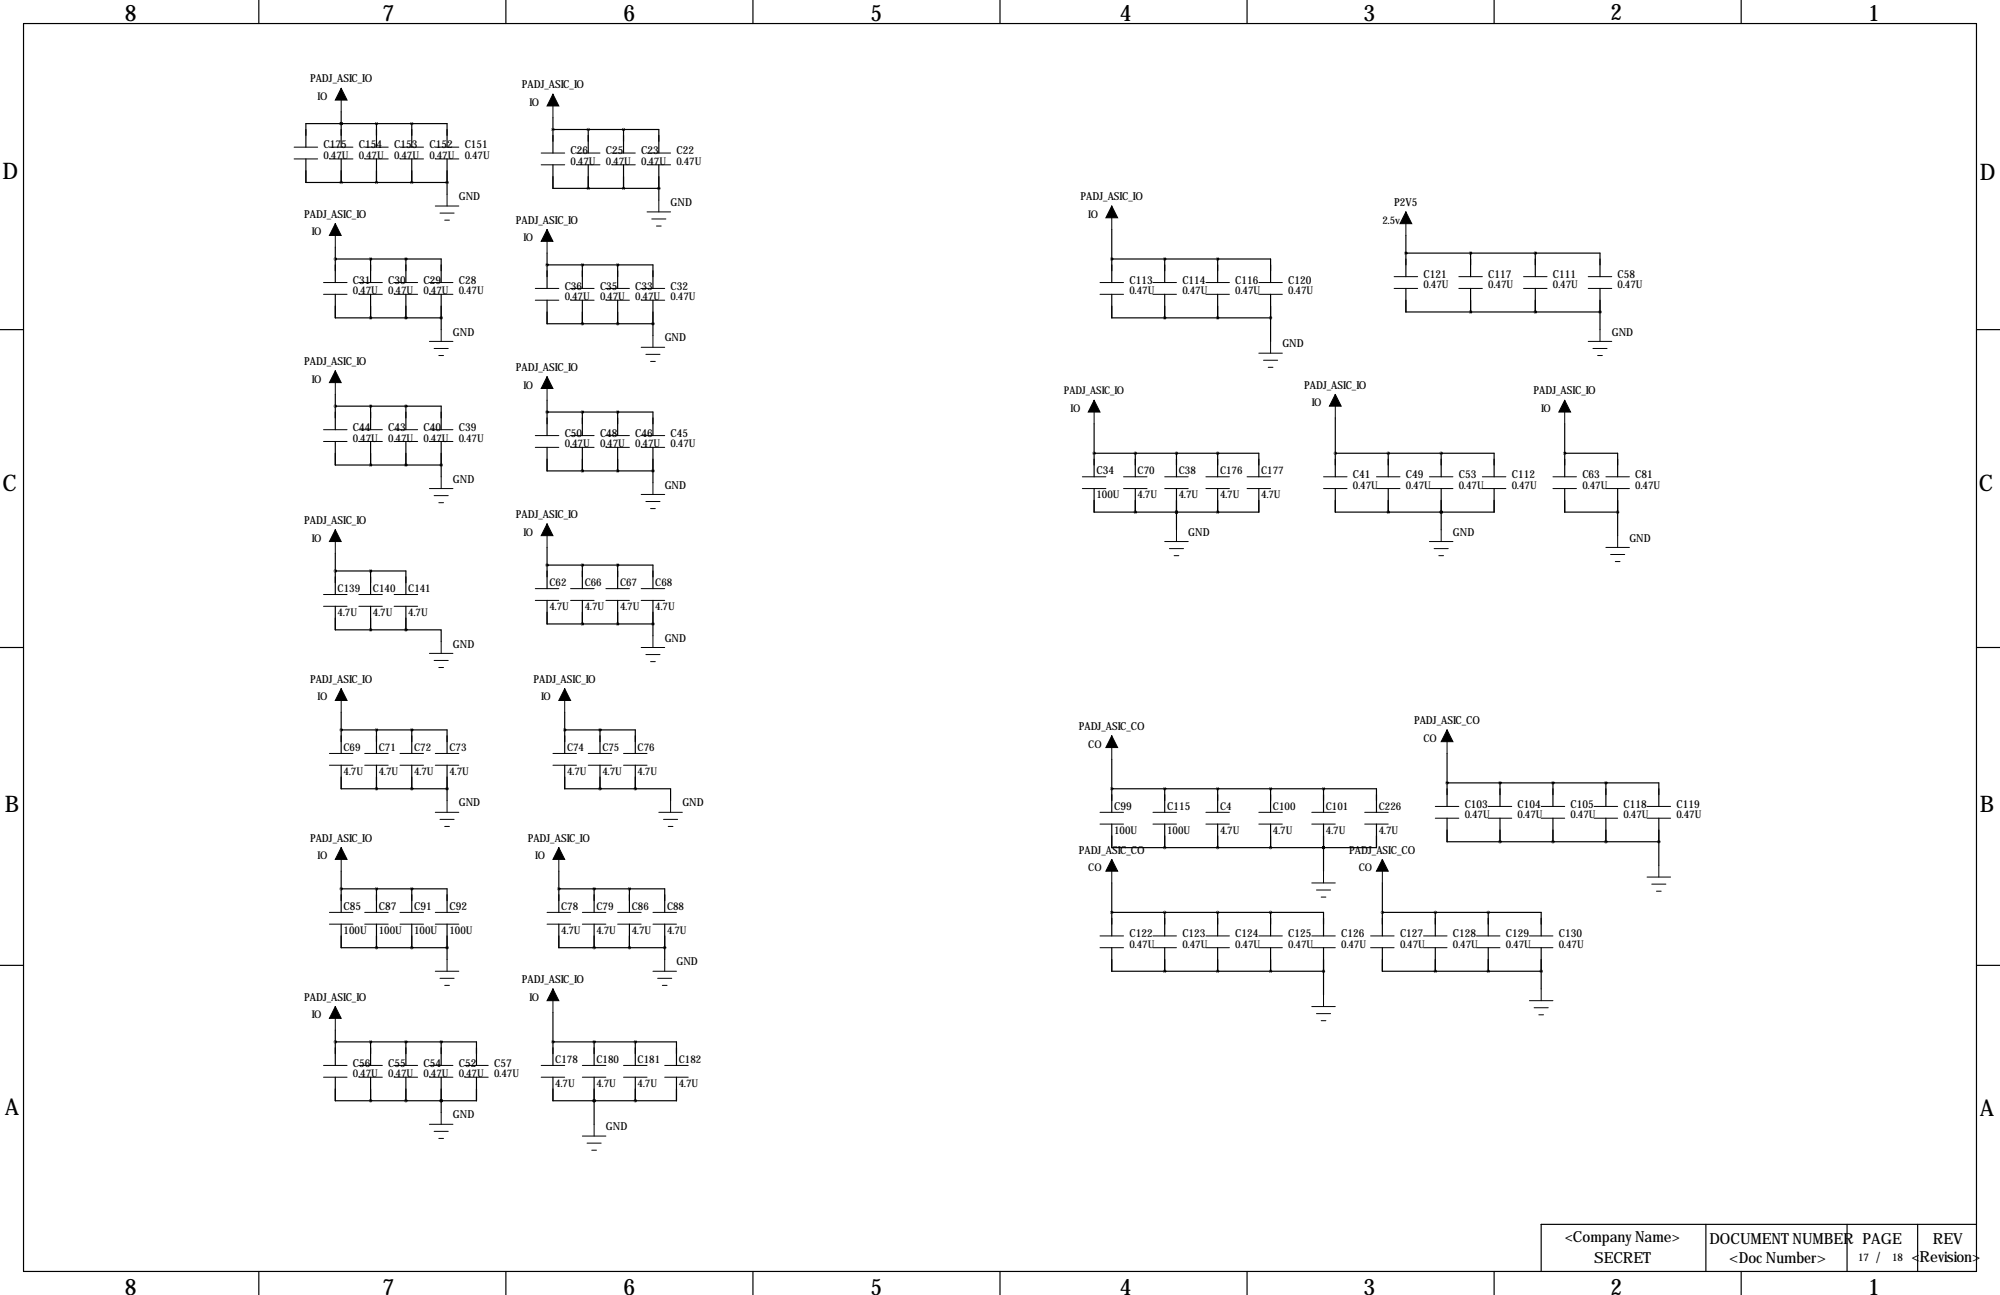
[picture p72: page 17]

D
D

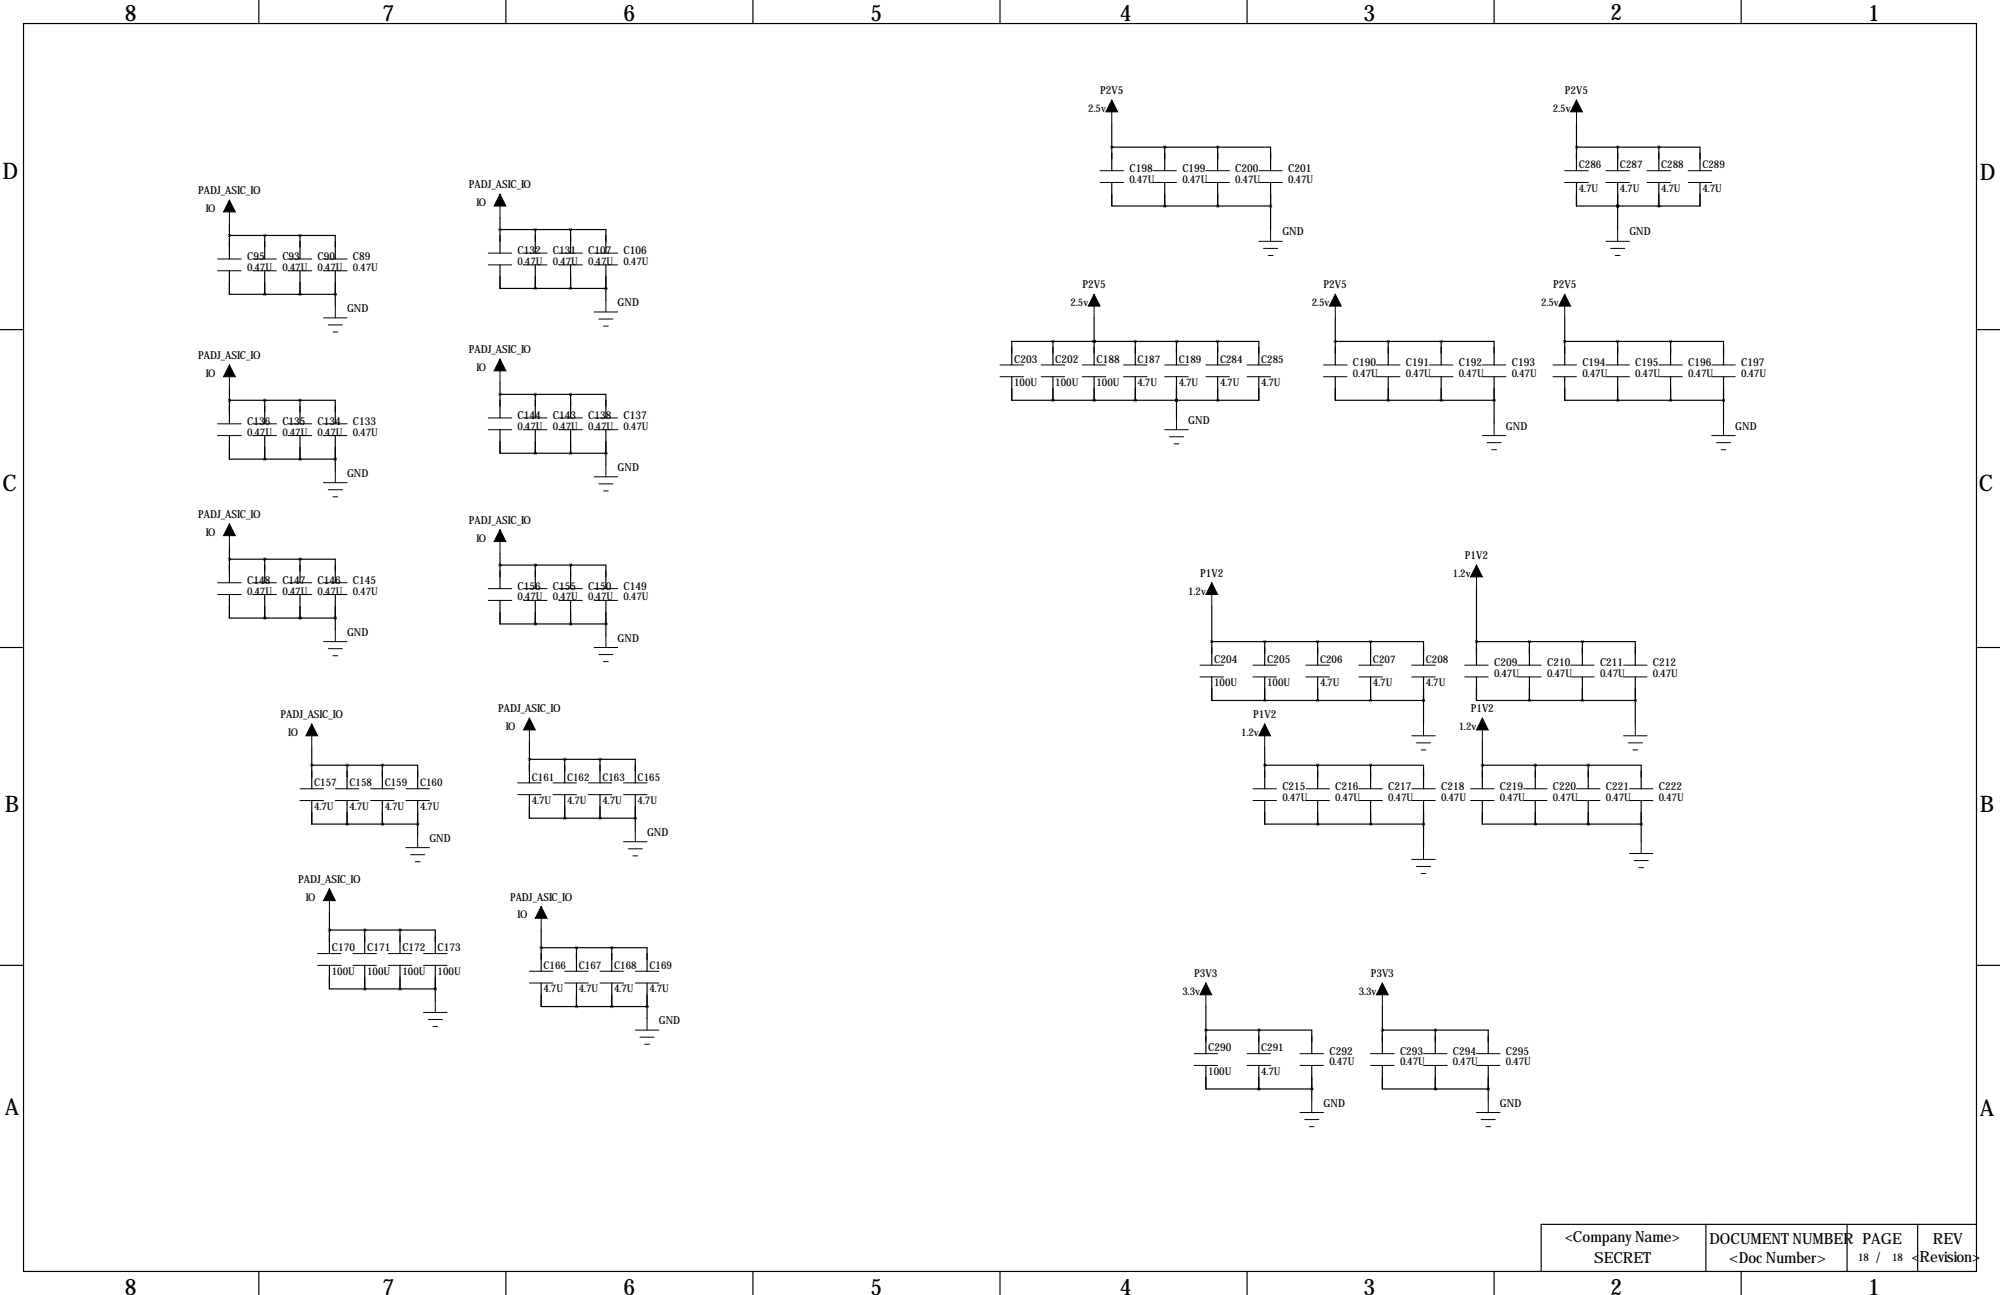
[picture p73: page 18]
