bespoke-silicon-group/bsg_motherboards/bsg_trouble/real_trouble/pcb_development/pcb_design/top.pdf

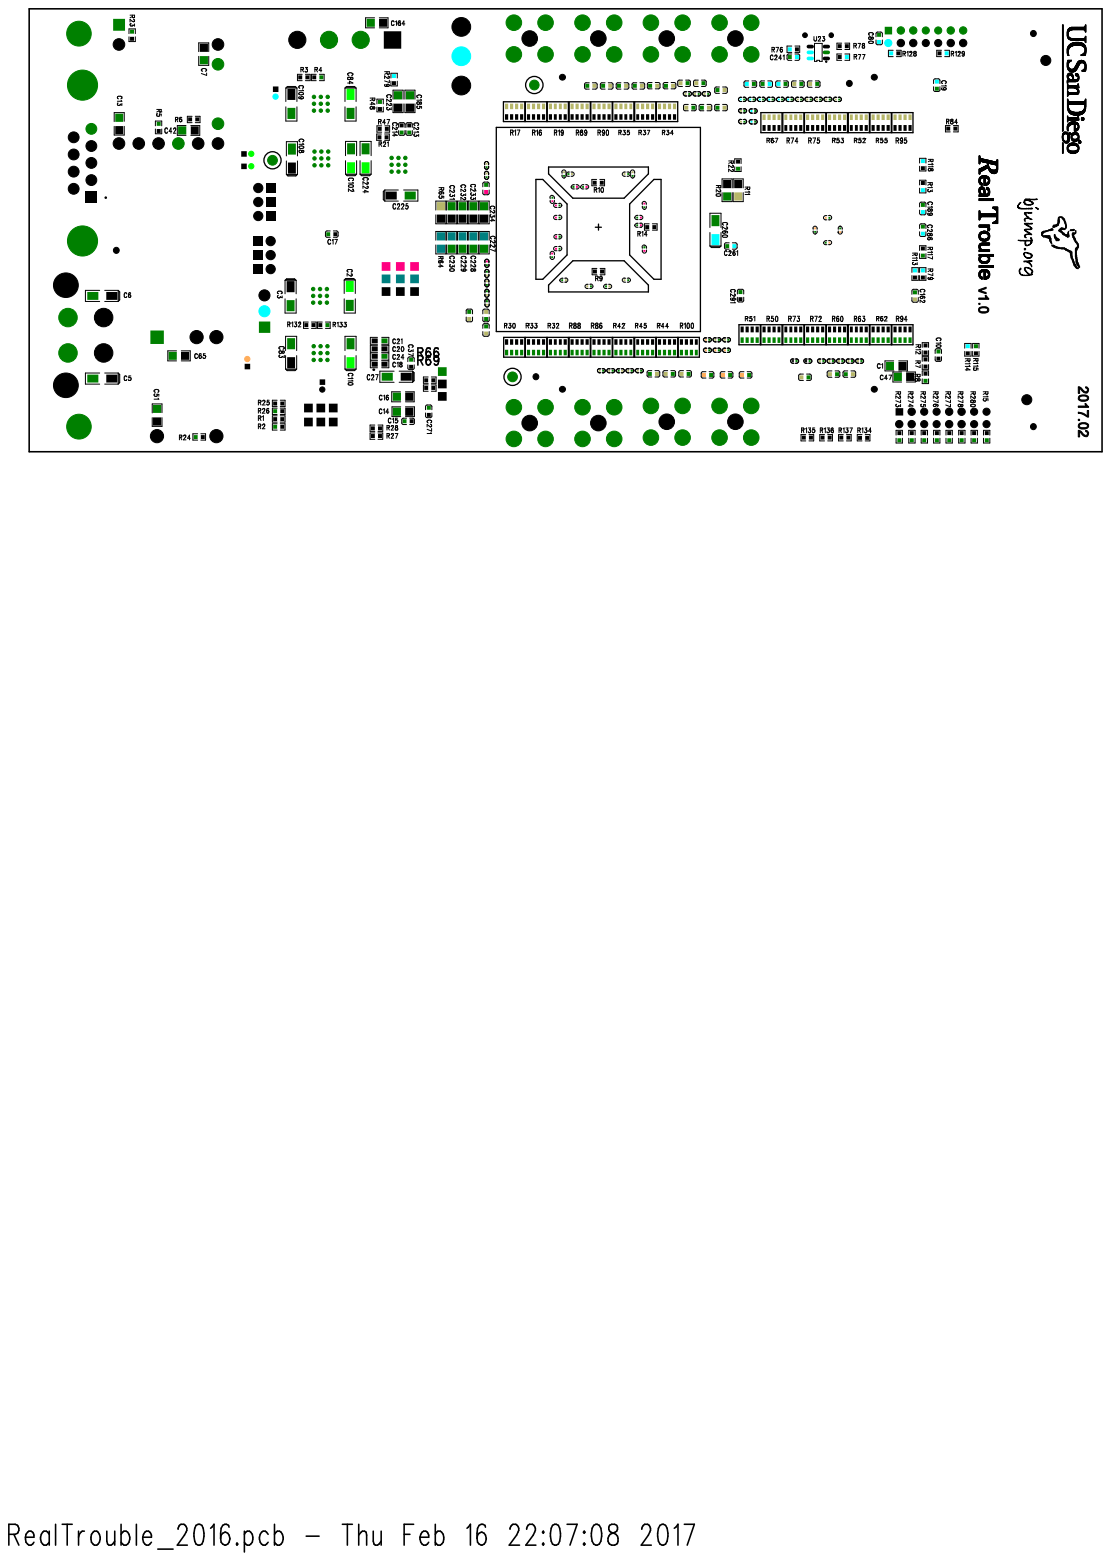
[picture p74: page 1]
