bespoke-silicon-group/bsg_motherboards/bsg_trouble/super_trouble_v2/pcb_development/pcb_design/v2.0_bot.pdf

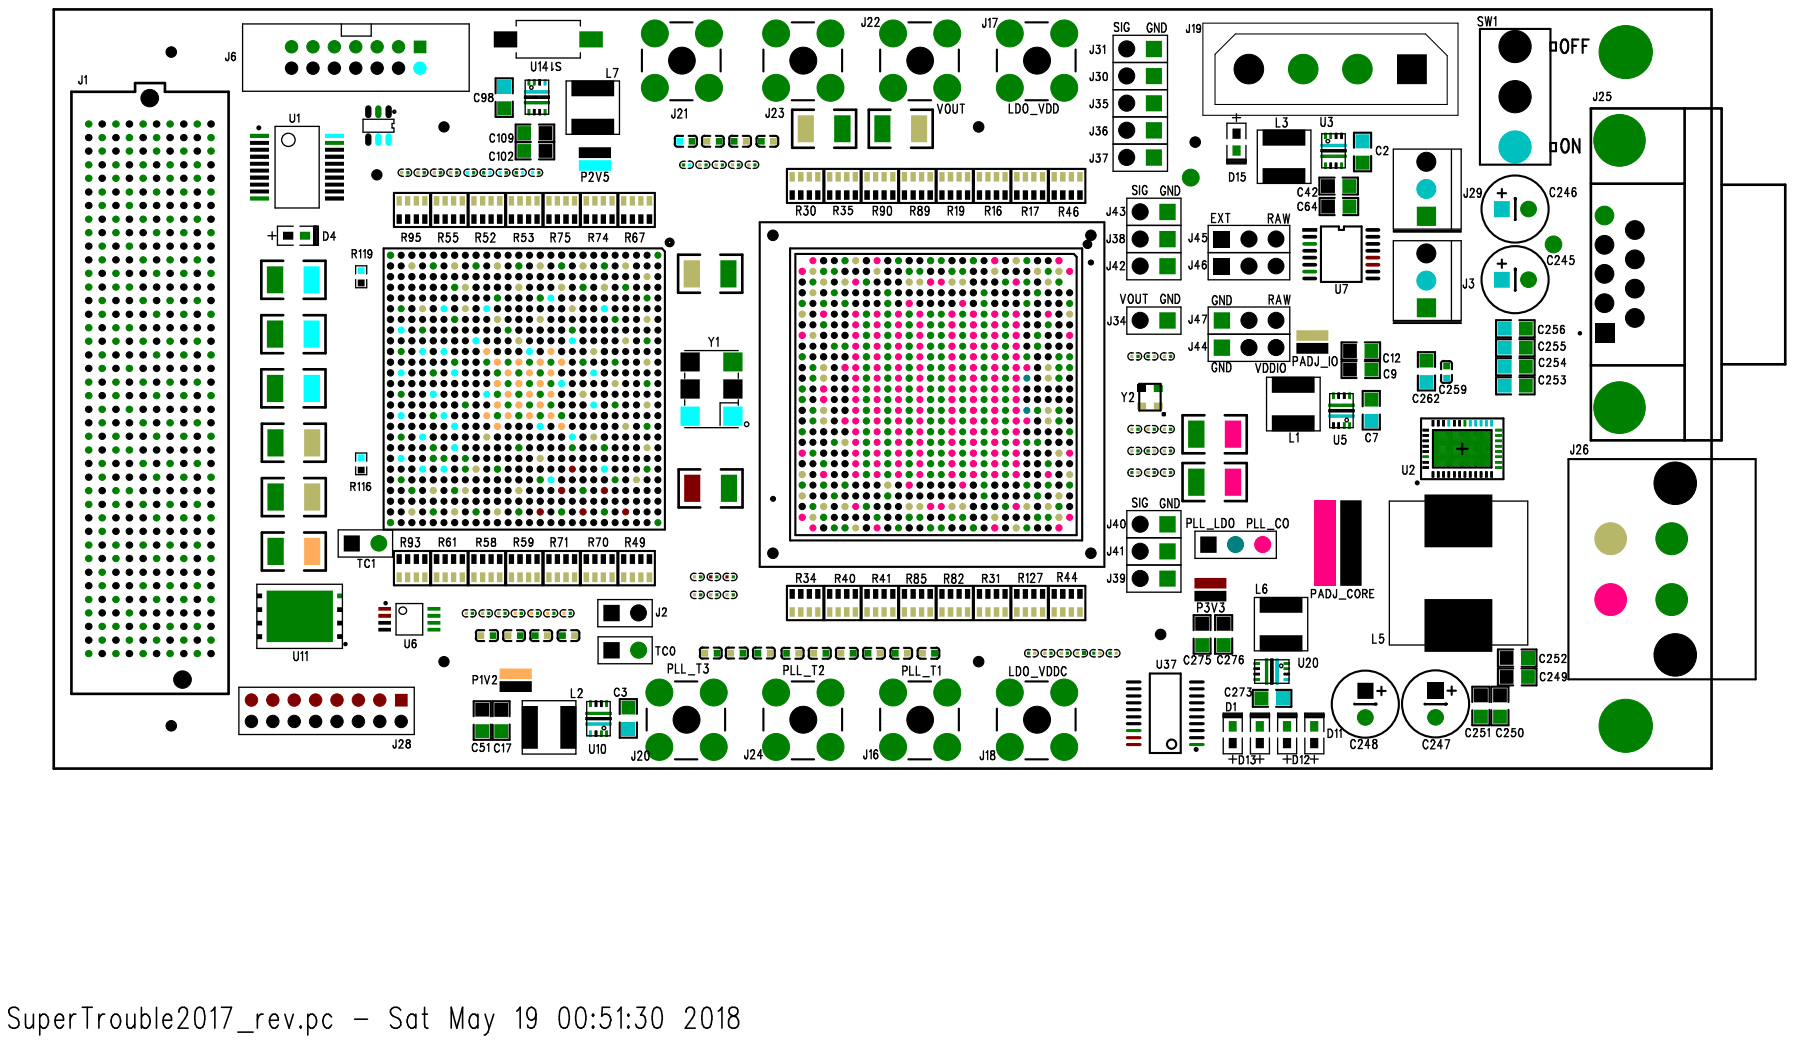
[picture p75: page 1]
