bespoke-silicon-group/bsg_motherboards/bsg_trouble/super_trouble_v2/pcb_development/pcb_design/v2.0_top.pdf

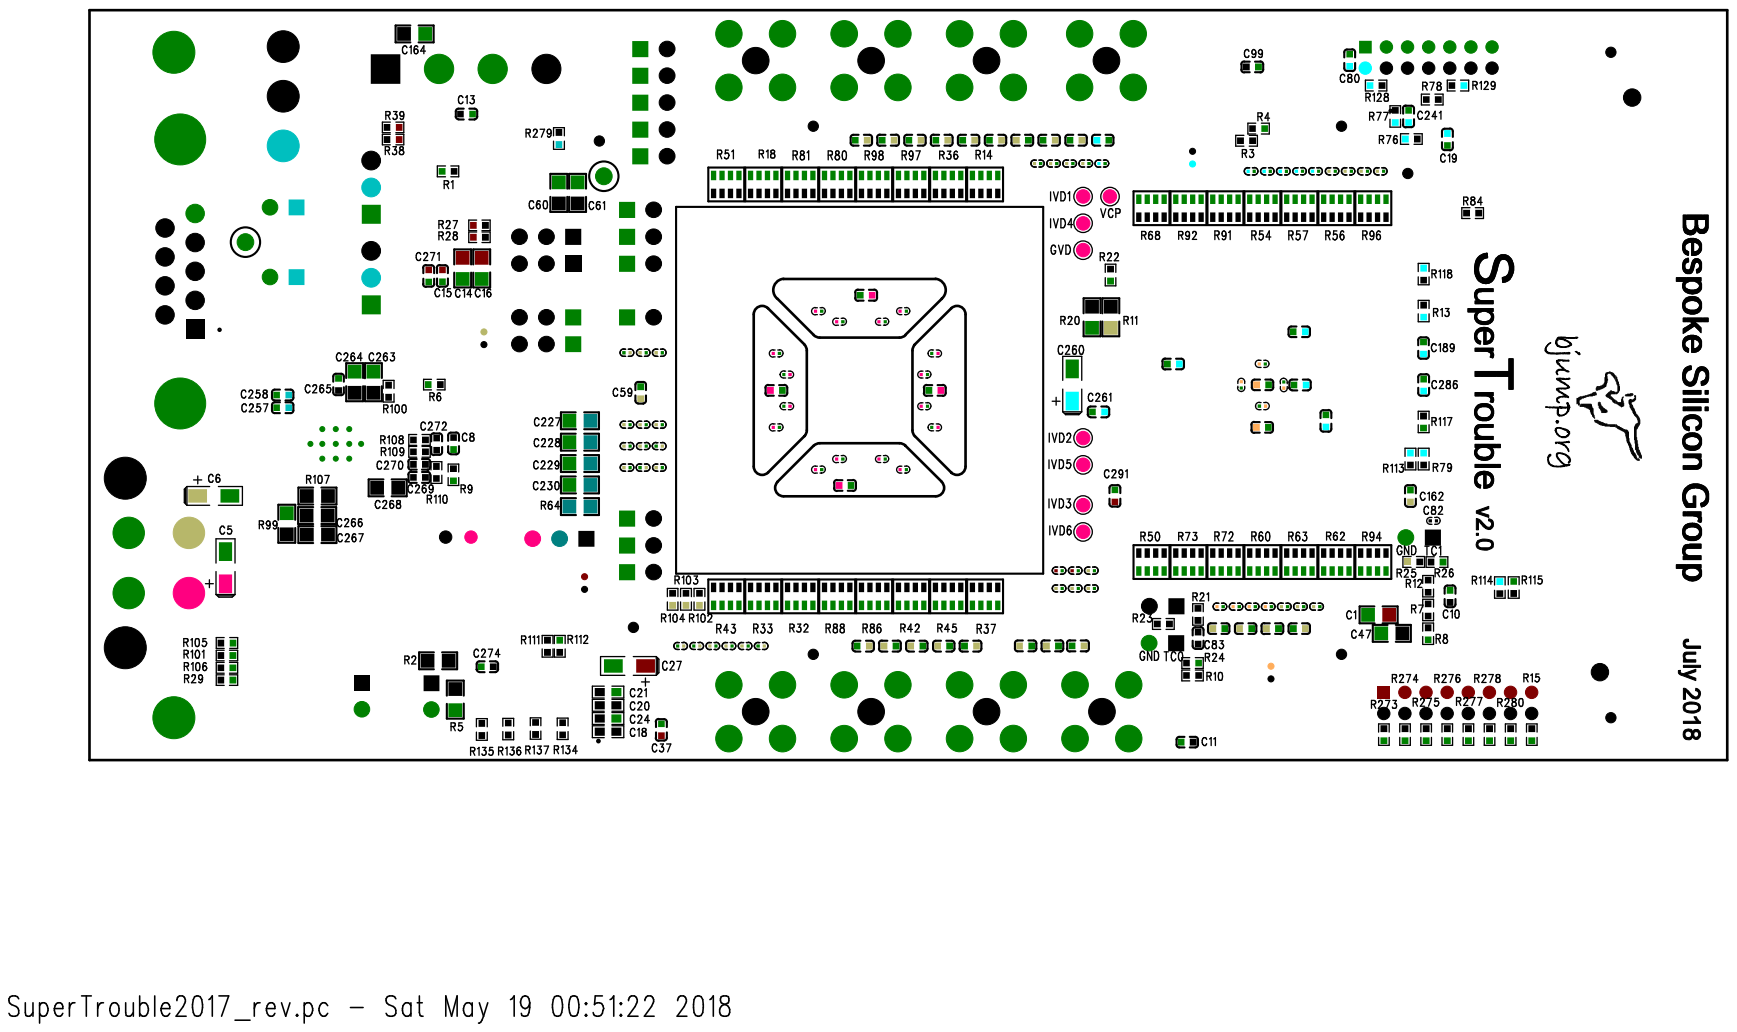
[picture p76: page 1]
