bespoke-silicon-group/bsg_motherboards/(list of files, drawings)

Other design files:
bsg_trouble/double_trouble/pcb_development/pcb_design/DaughterBoards_2016.pcb
bsg_trouble/real_trouble/pcb_development/pcb_design/RealTrouble_2016.pcb
bsg_trouble/super_trouble_v2/pcb_development/pcb_design/SuperTrouble2017_rev.pcb
