bespoke-silicon-group/bsg_motherboards/bsg_trouble/common/ip/bsg_zedboard/bsg_zedboard_fmc/xdc/bsg_zedboard_fmc.xdc

# fmc reset out
set_property PACKAGE_PIN G20 [get_ports FMC_LA20_P]
set_property PACKAGE_PIN G21 [get_ports FMC_LA20_N]
set_property IOSTANDARD LVDS_25 [get_ports FMC_LA20_P]
set_property IOSTANDARD LVDS_25 [get_ports FMC_LA20_N]

# fmc core calib reset in
set_property PACKAGE_PIN E15 [get_ports FMC_LA23_P]
set_property PACKAGE_PIN D15 [get_ports FMC_LA23_N]
set_property IOSTANDARD LVDS_25 [get_ports FMC_LA23_P]
set_property IOSTANDARD LVDS_25 [get_ports FMC_LA23_N]

# fmc tx clk out
set_property PACKAGE_PIN B19 [get_ports FMC_LA17_CC_P]
set_property PACKAGE_PIN B20 [get_ports FMC_LA17_CC_N]
set_property IOSTANDARD LVDS_25 [get_ports FMC_LA17_CC_P]
set_property IOSTANDARD LVDS_25 [get_ports FMC_LA17_CC_N]

# fmc tx data out
set_property PACKAGE_PIN B17 [get_ports FMC_LA31_N]
set_property PACKAGE_PIN B16 [get_ports FMC_LA31_P]
set_property PACKAGE_PIN B22 [get_ports FMC_LA33_N]
set_property PACKAGE_PIN B21 [get_ports FMC_LA33_P]
set_property PACKAGE_PIN B15 [get_ports FMC_LA30_N]
set_property PACKAGE_PIN C15 [get_ports FMC_LA30_P]
set_property PACKAGE_PIN A22 [get_ports FMC_LA32_N]
set_property PACKAGE_PIN A21 [get_ports FMC_LA32_P]
set_property PACKAGE_PIN A17 [get_ports FMC_LA28_N]
set_property PACKAGE_PIN A16 [get_ports FMC_LA28_P]
set_property PACKAGE_PIN C22 [get_ports FMC_LA25_N]
set_property PACKAGE_PIN D22 [get_ports FMC_LA25_P]
set_property PACKAGE_PIN C18 [get_ports FMC_LA29_N]
set_property PACKAGE_PIN C17 [get_ports FMC_LA29_P]
set_property PACKAGE_PIN E18 [get_ports FMC_LA26_N]
set_property PACKAGE_PIN F18 [get_ports FMC_LA26_P]
set_property PACKAGE_PIN E20 [get_ports FMC_LA21_N]
set_property PACKAGE_PIN E19 [get_ports FMC_LA21_P]
set_property PACKAGE_PIN E21 [get_ports FMC_LA27_P]
set_property PACKAGE_PIN D21 [get_ports FMC_LA27_N]
set_property PACKAGE_PIN G19 [get_ports FMC_LA22_P]
set_property PACKAGE_PIN F19 [get_ports FMC_LA22_N]
set_property IOSTANDARD LVDS_25 [get_ports FMC_LA31_P]
set_property IOSTANDARD LVDS_25 [get_ports FMC_LA31_N]
set_property IOSTANDARD LVDS_25 [get_ports FMC_LA33_P]
set_property IOSTANDARD LVDS_25 [get_ports FMC_LA33_N]
set_property IOSTANDARD LVDS_25 [get_ports FMC_LA30_P]
set_property IOSTANDARD LVDS_25 [get_ports FMC_LA30_N]
set_property IOSTANDARD LVDS_25 [get_ports FMC_LA32_P]
set_property IOSTANDARD LVDS_25 [get_ports FMC_LA32_N]
set_property IOSTANDARD LVDS_25 [get_ports FMC_LA28_P]
set_property IOSTANDARD LVDS_25 [get_ports FMC_LA28_N]
set_property IOSTANDARD LVDS_25 [get_ports FMC_LA25_P]
set_property IOSTANDARD LVDS_25 [get_ports FMC_LA25_N]
set_property IOSTANDARD LVDS_25 [get_ports FMC_LA29_P]
set_property IOSTANDARD LVDS_25 [get_ports FMC_LA29_N]
set_property IOSTANDARD LVDS_25 [get_ports FMC_LA26_P]
set_property IOSTANDARD LVDS_25 [get_ports FMC_LA26_N]
set_property IOSTANDARD LVDS_25 [get_ports FMC_LA21_P]
set_property IOSTANDARD LVDS_25 [get_ports FMC_LA21_N]
set_property IOSTANDARD LVDS_25 [get_ports FMC_LA27_P]
set_property IOSTANDARD LVDS_25 [get_ports FMC_LA27_N]
set_property IOSTANDARD LVDS_25 [get_ports FMC_LA22_P]
set_property IOSTANDARD LVDS_25 [get_ports FMC_LA22_N]

# fmc rx clk out
set_property PACKAGE_PIN L18 [get_ports FMC_CLK0_P]
set_property PACKAGE_PIN L19 [get_ports FMC_CLK0_N]
set_property IOSTANDARD LVDS_25 [get_ports FMC_CLK0_P]
set_property IOSTANDARD LVDS_25 [get_ports FMC_CLK0_N]

# fmc rx clk in
set_property PACKAGE_PIN M19 [get_ports FMC_LA00_CC_P]
set_property PACKAGE_PIN M20 [get_ports FMC_LA00_CC_N]
set_property IOSTANDARD LVDS_25 [get_ports FMC_LA00_CC_P]
set_property IOSTANDARD LVDS_25 [get_ports FMC_LA00_CC_N]

# fmc rx data in
set_property PACKAGE_PIN N19 [get_ports FMC_LA01_CC_P]
set_property PACKAGE_PIN N20 [get_ports FMC_LA01_CC_N]
set_property PACKAGE_PIN J20 [get_ports FMC_LA16_P]
set_property PACKAGE_PIN K21 [get_ports FMC_LA16_N]
set_property PACKAGE_PIN J16 [get_ports FMC_LA15_P]
set_property PACKAGE_PIN J17 [get_ports FMC_LA15_N]
set_property PACKAGE_PIN L17 [get_ports FMC_LA13_P]
set_property PACKAGE_PIN M17 [get_ports FMC_LA13_N]
set_property PACKAGE_PIN N17 [get_ports FMC_LA11_P]
set_property PACKAGE_PIN N18 [get_ports FMC_LA11_N]
set_property PACKAGE_PIN R19 [get_ports FMC_LA10_P]
set_property PACKAGE_PIN T19 [get_ports FMC_LA10_N]
set_property PACKAGE_PIN K19 [get_ports FMC_LA14_P]
set_property PACKAGE_PIN K20 [get_ports FMC_LA14_N]
set_property PACKAGE_PIN R20 [get_ports FMC_LA09_P]
set_property PACKAGE_PIN R21 [get_ports FMC_LA09_N]
set_property PACKAGE_PIN M21 [get_ports FMC_LA04_P]
set_property PACKAGE_PIN M22 [get_ports FMC_LA04_N]
set_property PACKAGE_PIN T16 [get_ports FMC_LA07_P]
set_property PACKAGE_PIN T17 [get_ports FMC_LA07_N]
set_property PACKAGE_PIN J21 [get_ports FMC_LA08_P]
set_property PACKAGE_PIN J22 [get_ports FMC_LA08_N]
set_property IOSTANDARD LVDS_25 [get_ports FMC_LA01_CC_P]
set_property IOSTANDARD LVDS_25 [get_ports FMC_LA01_CC_N]
set_property IOSTANDARD LVDS_25 [get_ports FMC_LA16_P]
set_property IOSTANDARD LVDS_25 [get_ports FMC_LA16_N]
set_property IOSTANDARD LVDS_25 [get_ports FMC_LA15_P]
set_property IOSTANDARD LVDS_25 [get_ports FMC_LA15_N]
set_property IOSTANDARD LVDS_25 [get_ports FMC_LA13_P]
set_property IOSTANDARD LVDS_25 [get_ports FMC_LA13_N]
set_property IOSTANDARD LVDS_25 [get_ports FMC_LA11_P]
set_property IOSTANDARD LVDS_25 [get_ports FMC_LA11_N]
set_property IOSTANDARD LVDS_25 [get_ports FMC_LA10_P]
set_property IOSTANDARD LVDS_25 [get_ports FMC_LA10_N]
set_property IOSTANDARD LVDS_25 [get_ports FMC_LA14_P]
set_property IOSTANDARD LVDS_25 [get_ports FMC_LA14_N]
set_property IOSTANDARD LVDS_25 [get_ports FMC_LA09_P]
set_property IOSTANDARD LVDS_25 [get_ports FMC_LA09_N]
set_property IOSTANDARD LVDS_25 [get_ports FMC_LA04_P]
set_property IOSTANDARD LVDS_25 [get_ports FMC_LA04_N]
set_property IOSTANDARD LVDS_25 [get_ports FMC_LA07_P]
set_property IOSTANDARD LVDS_25 [get_ports FMC_LA07_N]
set_property IOSTANDARD LVDS_25 [get_ports FMC_LA08_P]
set_property IOSTANDARD LVDS_25 [get_ports FMC_LA08_N]
