bespoke-silicon-group/bsg_motherboards/bsg_trouble/common/ip/bsg_ml605/bsg_ml605_dram/v/phy_rdlvl.v

//*****************************************************************************
// (c) Copyright 2009 - 2010 Xilinx, Inc. All rights reserved.
//
// This file contains confidential and proprietary information
// of Xilinx, Inc. and is protected under U.S. and
// international copyright and other intellectual property
// laws.
//
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
// CRITICAL APPLICATIONS
// Xilinx products are not designed or intended to be fail-
// safe, or for use in any application requiring fail-safe
// performance, such as life-support or safety devices or
// systems, Class III medical devices, nuclear facilities,
// applications related to the deployment of airbags, or any
// other applications that could lead to death, personal
// injury, or severe property or environmental damage
// (individually and collectively, "Critical
// Applications"). Customer assumes the sole risk and
// liability of any use of Xilinx products in Critical
// Applications, subject only to applicable laws and
// regulations governing limitations on product liability.
//
// THIS COPYRIGHT NOTICE AND DISCLAIMER MUST BE RETAINED AS
// PART OF THIS FILE AT ALL TIMES.
//
//*****************************************************************************
//   ____  ____
//  /   /\/   /
// /___/  \  /    Vendor: Xilinx
// \   \   \/     Version:
//  \   \         Application: MIG
//  /   /         Filename: phy_rdlvl.v
// /___/   /\     Date Last Modified: $Date: 2012/02/14 05:15:50 $
// \   \  /  \    Date Created:
//  \___\/\___\
//
//Device: Virtex-6
//Design Name: DDR3 SDRAM
//Purpose:
//  Read leveling calibration logic
//  NOTES:
//    1. DQ per-bit deskew is not yet supported
//Reference:
//Revision History:
//*****************************************************************************

/******************************************************************************
**$Id: phy_rdlvl.v,v 1.1 2012/02/14 05:15:50 q5zheng Exp $
**$Date: 2012/02/14 05:15:50 $
**$Author: q5zheng $
**$Revision: 1.1 $
**$Source: /grw/cvsroot/rawboards/recore/modules/mem_master/ddr3/phy/phy_rdlvl.v,v $
******************************************************************************/

`timescale 1ps/1ps

module phy_rdlvl #
  (
   parameter TCQ             = 100,    // clk->out delay (sim only)
   parameter nCK_PER_CLK     = 2,      // # of memory clocks per CLK
   parameter CLK_PERIOD      = 3333,   // Internal clock period (in ps)
   parameter REFCLK_FREQ     = 300,    // IODELAY Reference Clock freq (MHz)
   parameter DQ_WIDTH        = 64,     // # of DQ (data)
   parameter DQS_CNT_WIDTH   = 3,      // = ceil(log2(DQS_WIDTH))
   parameter DQS_WIDTH       = 8,      // # of DQS (strobe)
   parameter DRAM_WIDTH      = 8,      // # of DQ per DQS
   parameter DRAM_TYPE       = "DDR3",  // Memory I/F type: "DDR3", "DDR2"
   parameter PD_TAP_REQ      = 10,     // # of IODELAY taps reserved for PD
   parameter nCL             = 5,      // Read CAS latency (in clk cyc)
   parameter SIM_CAL_OPTION  = "NONE", // Skip various calibration steps
   parameter DEBUG_PORT      = "OFF"   // Enable debug port
   )
  (
   input                        clk,
   input                        rst,
   // Calibration status, control signals
   input [1:0]                  rdlvl_start,
   input                        rdlvl_clkdiv_start,
   input                        rdlvl_rd_active,
   output reg [1:0]             rdlvl_done,
   output reg                   rdlvl_clkdiv_done,
   output reg [1:0]             rdlvl_err,
   output reg                   rdlvl_prech_req,
   input                        prech_done,
   // Captured data in resync clock domain
   input [DQ_WIDTH-1:0]         rd_data_rise0,
   input [DQ_WIDTH-1:0]         rd_data_fall0,
   input [DQ_WIDTH-1:0]         rd_data_rise1,
   input [DQ_WIDTH-1:0]         rd_data_fall1,
   // Stage 1 calibration outputs
   output reg [DQS_WIDTH-1:0]      dlyce_cpt,
   output reg                      dlyinc_cpt,
   output reg [3:0]                dlyce_rsync,
   output reg                      dlyinc_rsync,
   output reg [5*DQS_WIDTH-1:0]    dlyval_dq,
   output reg [5*DQS_WIDTH-1:0]    dlyval_dqs,
   // Stage 2 calibration inputs/outputs
   output reg [2*DQS_WIDTH-1:0] rd_bitslip_cnt,
   output reg [2*DQS_WIDTH-1:0] rd_clkdly_cnt,
   output reg [4:0]             rd_active_dly,
   input                        rdlvl_pat_resume,   // resume pattern calib
   output reg                   rdlvl_pat_err,      // error during pattern cal
   output [DQS_CNT_WIDTH-1:0]   rdlvl_pat_err_cnt,  // erroring DQS group
   // Resynchronization clock (clkinv_inv) calibration outputs
   output [DQS_WIDTH-1:0]       rd_clkdiv_inv,
   // Debug Port
   output [5*DQS_WIDTH-1:0]     dbg_cpt_first_edge_cnt,
   output [5*DQS_WIDTH-1:0]     dbg_cpt_second_edge_cnt,
   output reg [3*DQS_WIDTH-1:0] dbg_rd_bitslip_cnt,
   output [DQS_WIDTH-1:0]       dbg_rd_clkdiv_inv,
   output reg [2*DQS_WIDTH-1:0] dbg_rd_clkdly_cnt,
   output reg [4:0]             dbg_rd_active_dly,
   input                        dbg_idel_up_all,
   input                        dbg_idel_down_all,
   input                        dbg_idel_up_cpt,
   input                        dbg_idel_down_cpt,
   input                        dbg_idel_up_rsync,
   input                        dbg_idel_down_rsync,
   input [DQS_CNT_WIDTH-1:0]    dbg_sel_idel_cpt,
   input                        dbg_sel_all_idel_cpt,
   input [DQS_CNT_WIDTH-1:0]    dbg_sel_idel_rsync,
   input                        dbg_sel_all_idel_rsync,
   output [255:0]               dbg_phy_rdlvl
   );

  // minimum time (in IDELAY taps) for which capture data must be stable for
  // algorithm to consider a valid data eye to be found. The read leveling
  // logic will ignore any window found smaller than this value. Limitations
  // on how small this number can be is determined by: (1) the algorithmic
  // limitation of how many taps wide the data eye can be (3 taps), and (2)
  // how wide regions of "instability" that occur around the edges of the
  // read valid window can be (i.e. need to be able to filter out "false"
  // windows that occur for a short # of taps around the edges of the true
  // data window, although with multi-sampling during read leveling, this is
  // not as much a concern) - the larger the value, the more protection
  // against "false" windows
  localparam MIN_EYE_SIZE = (DRAM_TYPE == "DDR3") ? 3 : 6;
  // # of clock cycles to wait after changing IDELAY value or read data MUX
  // to allow both IDELAY chain to settle, and for delayed input to
  // propagate thru ISERDES
  localparam PIPE_WAIT_CNT = 16;
  // Length of calibration sequence (in # of words)
  localparam CAL_PAT_LEN = 8;
  // Read data shift register length
  localparam RD_SHIFT_LEN = CAL_PAT_LEN/(2*nCK_PER_CLK);
  // Amount to shift by if one edge found (= 0.5*(bit_period)). Limit to 31
  localparam integer IODELAY_TAP_RES = 1000000/(REFCLK_FREQ * 64);
  localparam TBY4_TAPS
             = (((CLK_PERIOD/nCK_PER_CLK/4)/IODELAY_TAP_RES) > 31) ? 31 :
                    ((CLK_PERIOD/nCK_PER_CLK/4)/IODELAY_TAP_RES);
  // Maximum amount to wait after read issued until read data returned
  localparam MAX_RD_DLY_CNT = 32;
  // # of cycles to wait after changing RDEN count value
  localparam RDEN_WAIT_CNT = 8;
  // used during read enable calibration - difference between what the
  // calibration logic measured read enable delay to be, and what it needs
  // to set the value of the read active delay control to be
  localparam RDEN_DELAY_OFFSET = 5;
  // # of read data samples to examine when detecting whether an edge has
  // occured during stage 1 calibration. Width of local param must be
  // changed as appropriate. Note that there are two counters used, each
  // counter can be changed independently of the other - they are used in
  // cascade to create a larger counter
  localparam [11:0] DETECT_EDGE_SAMPLE_CNT0 = 12'hFFF;
  localparam [11:0] DETECT_EDGE_SAMPLE_CNT1 = 12'h001;
  // # of taps in IDELAY chain. When the phase detector taps are reserved
  // before the start of calibration, reduce half that amount from the
  // total available taps.
  localparam IODELAY_TAP_LEN = 32 - (PD_TAP_REQ/2);
  // Half the PD taps
  localparam PD_HALF_TAP = (PD_TAP_REQ/2);

  localparam [4:0] CAL1_IDLE                = 5'h00;
  localparam [4:0] CAL1_NEW_DQS_WAIT        = 5'h01;
  localparam [4:0] CAL1_IDEL_STORE_FIRST    = 5'h02;
  localparam [4:0] CAL1_DETECT_EDGE         = 5'h03;
  localparam [4:0] CAL1_IDEL_STORE_OLD      = 5'h04;
  localparam [4:0] CAL1_IDEL_INC_CPT        = 5'h05;
  localparam [4:0] CAL1_IDEL_INC_CPT_WAIT   = 5'h06;
  localparam [4:0] CAL1_CALC_IDEL           = 5'h07;
  localparam [4:0] CAL1_IDEL_DEC_CPT        = 5'h08;
  localparam [4:0] CAL1_NEXT_DQS            = 5'h09;
  localparam [4:0] CAL1_DONE                = 5'h0A;
  localparam [4:0] CAL1_RST_CPT             = 5'h0B;
  localparam [4:0] CAL1_DETECT_EDGE_DQ      = 5'h0C;
  localparam [4:0] CAL1_IDEL_INC_DQ         = 5'h0D;
  localparam [4:0] CAL1_IDEL_INC_DQ_WAIT    = 5'h0E;
  localparam [4:0] CAL1_CALC_IDEL_DQ        = 5'h0F;
  localparam [4:0] CAL1_IDEL_INC_DQ_CPT     = 5'h10;
  localparam [4:0] CAL1_IDEL_INC_PD_CPT     = 5'h11;
  localparam [4:0] CAL1_IDEL_PD_ADJ         = 5'h12;
  localparam [4:0] CAL1_SKIP_RDLVL_INC_IDEL = 5'h1F; // Only for simulation

  localparam CAL2_IDLE         = 3'h0;
  localparam CAL2_READ_WAIT    = 3'h1;
  localparam CAL2_DETECT_MATCH = 3'h2;
  localparam CAL2_BITSLIP_WAIT = 3'h3;
  localparam CAL2_NEXT_DQS     = 3'h4;
  localparam CAL2_DONE         = 3'h5;
  localparam CAL2_ERROR_TO     = 3'h6;

  localparam [3:0] CAL_CLKDIV_IDLE                   = 4'h0;
  localparam [3:0] CAL_CLKDIV_NEW_DQS_WAIT           = 4'h1;
  localparam [3:0] CAL_CLKDIV_IDEL_STORE_REF         = 4'h2;
  localparam [3:0] CAL_CLKDIV_DETECT_EDGE            = 4'h3;
  localparam [3:0] CAL_CLKDIV_IDEL_INCDEC_RSYNC      = 4'h4;
  localparam [3:0] CAL_CLKDIV_IDEL_INCDEC_RSYNC_WAIT = 4'h5;
  localparam [3:0] CAL_CLKDIV_IDEL_SET_MIDPT_RSYNC   = 4'h6;
  localparam [3:0] CAL_CLKDIV_NEXT_CHECK             = 4'h7;
  localparam [3:0] CAL_CLKDIV_NEXT_DQS               = 4'h8;
  localparam [3:0] CAL_CLKDIV_DONE                   = 4'h9;

  integer    i;
  integer    j;
  integer    x;
  genvar     z;

  reg                     cal_clkdiv_clkdiv_inv_r;
  reg [DQS_CNT_WIDTH-1:0] cal_clkdiv_cnt_clkdiv_r;
  reg                     cal_clkdiv_dlyce_rsync_r;
  reg                     cal_clkdiv_dlyinc_rsync_r;
  reg                     cal_clkdiv_idel_rsync_inc_r;
  reg                     cal_clkdiv_prech_req_r;
  reg                     cal_clkdiv_store_sr_req_r;
  reg [3:0]               cal_clkdiv_state_r;
  reg [DQS_CNT_WIDTH-1:0] cal1_cnt_cpt_r;
  reg                     cal1_dlyce_cpt_r;
  reg                     cal1_dlyinc_cpt_r;
  reg [4:0]               cal1_dq_tap_cnt_r;
  reg                     cal1_dq_taps_inc_r;
  wire                    cal1_found_edge;
  reg                     cal1_prech_req_r;
  reg [4:0]               cal1_state_r;
  reg                     cal1_store_sr_req_r;
  reg [2*DQS_WIDTH-1:0]   cal2_clkdly_cnt_r;
  reg [1:0]               cal2_cnt_bitslip_r;
  reg [4:0]               cal2_cnt_rd_dly_r;
  reg [DQS_CNT_WIDTH-1:0] cal2_cnt_rden_r;
  reg [DQS_WIDTH-1:0]     cal2_deskew_err_r;
  reg [4:0]               cal2_dly_cnt_delta_r[DQS_WIDTH-1:0];
  reg                     cal2_done_r;
  reg                     cal2_done_r1;
  reg                     cal2_done_r2;
  reg                     cal2_done_r3;
  reg [5*DQS_WIDTH-1:0]   cal2_dly_cnt_r;
  reg                     cal2_en_dqs_skew_r;
  reg [4:0]               cal2_max_cnt_rd_dly_r;
  reg                     cal2_prech_req_r;
  reg [4:0]               cal2_rd_active_dly_r;
  reg [2*DQS_WIDTH-1:0]   cal2_rd_bitslip_cnt_r;
  reg [2:0]               cal2_state_r;
  reg [DQS_WIDTH-1:0]     clkdiv_inv_r;
  reg [2:0]               cnt_eye_size_r;
  reg [5:0]               cnt_idel_dec_cpt_r;
  reg [4:0]               cnt_idel_inc_cpt_r;
  reg [4:0]               cnt_idel_skip_idel_r;
  reg [3:0]               cnt_pipe_wait_r;
  reg [2:0]               cnt_rden_wait_r;
  reg [3:0]               cnt_shift_r;
  reg [11:0]              detect_edge_cnt0_r;
  reg                     detect_edge_cnt1_en_r;
  reg [11:0]              detect_edge_cnt1_r;
  reg                     detect_edge_done_r;
  reg                     detect_edge_start_r;
  wire                    dlyce_or;
  reg [5*DQS_WIDTH-1:0]   dlyval_dq_reg_r;
  reg [4:0]               first_edge_taps_r;
  reg                     found_edge_r;
  reg                     found_edge_latched_r;
  reg                     found_edge_valid_r;
  reg                     found_dq_edge_r;
  reg                     found_first_edge_r;
  reg                     found_jitter_latched_r;
  reg                     found_second_edge_r;
  reg                     found_stable_eye_r;
  reg                     found_two_edge_r;
  reg [4:0]               idel_tap_cnt_cpt_r;
  reg [4:0]               idel_tap_delta_rsync_r;
  reg                     idel_tap_limit_cpt_r;
  reg                     idel_tap_limit_dq_r;
  reg                     last_tap_jitter_r;
  reg [4:0]               min_rsync_marg_r;
  reg [DRAM_WIDTH-1:0]    mux_rd_fall0_r;
  reg [DRAM_WIDTH-1:0]    mux_rd_fall1_r;
  reg [DRAM_WIDTH-1:0]    mux_rd_rise0_r;
  reg [DRAM_WIDTH-1:0]    mux_rd_rise1_r;
  reg                     new_cnt_clkdiv_r;
  reg                     new_cnt_cpt_r;
  reg [RD_SHIFT_LEN-1:0]  old_sr_fall0_r [DRAM_WIDTH-1:0];
  reg [RD_SHIFT_LEN-1:0]  old_sr_fall1_r [DRAM_WIDTH-1:0];
  reg [RD_SHIFT_LEN-1:0]  old_sr_rise0_r [DRAM_WIDTH-1:0];
  reg [RD_SHIFT_LEN-1:0]  old_sr_rise1_r [DRAM_WIDTH-1:0];
  reg                     old_sr_valid_r;
  reg                     pat_data_match_r;
  wire [RD_SHIFT_LEN-1:0] pat_fall0 [3:0];
  wire [RD_SHIFT_LEN-1:0] pat_fall1 [3:0];
  reg [DRAM_WIDTH-1:0]    pat_match_fall0_r;
  reg                     pat_match_fall0_and_r;
  reg [DRAM_WIDTH-1:0]    pat_match_fall1_r;
  reg                     pat_match_fall1_and_r;
  reg [DRAM_WIDTH-1:0]    pat_match_rise0_r;
  reg                     pat_match_rise0_and_r;
  reg [DRAM_WIDTH-1:0]    pat_match_rise1_r;
  reg                     pat_match_rise1_and_r;
  wire [RD_SHIFT_LEN-1:0] pat_rise0 [3:0];
  wire [RD_SHIFT_LEN-1:0] pat_rise1 [3:0];
  wire                    pipe_wait;
  reg                     pol_min_rsync_marg_r;
  reg                     prev_found_edge_r;
  reg                     prev_found_edge_valid_r;
  reg                     prev_match_fall0_and_r;
  reg [DRAM_WIDTH-1:0]    prev_match_fall0_r;
  reg                     prev_match_fall1_and_r;
  reg [DRAM_WIDTH-1:0]    prev_match_fall1_r;
  reg                     prev_match_rise0_and_r;
  reg [DRAM_WIDTH-1:0]    prev_match_rise0_r;
  reg                     prev_match_rise1_and_r;
  reg [DRAM_WIDTH-1:0]    prev_match_rise1_r;
  reg                     prev_match_valid_r;
  reg                     prev_match_valid_r1;
  reg [RD_SHIFT_LEN-1:0]  prev_sr_fall0_r [DRAM_WIDTH-1:0];
  reg [RD_SHIFT_LEN-1:0]  prev_sr_fall1_r [DRAM_WIDTH-1:0];
  reg [RD_SHIFT_LEN-1:0]  prev_sr_rise0_r [DRAM_WIDTH-1:0];
  reg [RD_SHIFT_LEN-1:0]  prev_sr_rise1_r [DRAM_WIDTH-1:0];
  reg [DQS_CNT_WIDTH-1:0] rd_mux_sel_r;
  reg                     rd_active_posedge_r;
  reg                     rd_active_r;
  reg                     rden_wait_r;
  reg [4:0]               right_edge_taps_r;
  reg [4:0]               second_edge_taps_r;
  reg [4:0]               second_edge_dq_taps_r;
  reg [RD_SHIFT_LEN-1:0]  sr_fall0_r [DRAM_WIDTH-1:0];
  reg [RD_SHIFT_LEN-1:0]  sr_fall1_r [DRAM_WIDTH-1:0];
  reg [RD_SHIFT_LEN-1:0]  sr_rise0_r [DRAM_WIDTH-1:0];
  reg [RD_SHIFT_LEN-1:0]  sr_rise1_r [DRAM_WIDTH-1:0];
  reg                     sr_match_fall0_and_r;
  reg [DRAM_WIDTH-1:0]    sr_match_fall0_r;
  reg                     sr_match_fall1_and_r;
  reg [DRAM_WIDTH-1:0]    sr_match_fall1_r;
  reg                     sr_match_valid_r;
  reg                     sr_match_valid_r1;
  reg                     sr_match_rise0_and_r;
  reg [DRAM_WIDTH-1:0]    sr_match_rise0_r;
  reg                     sr_match_rise1_and_r;
  reg [DRAM_WIDTH-1:0]    sr_match_rise1_r;
  reg                     store_sr_done_r;
  reg                     store_sr_r;
  reg                     sr_valid_r;
  reg [5:0]               tby4_r;

  // Debug
  reg [4:0]               dbg_cpt_first_edge_taps [0:DQS_WIDTH-1];
  reg [4:0]               dbg_cpt_second_edge_taps [0:DQS_WIDTH-1];

  //***************************************************************************
  // Debug
  //***************************************************************************

  assign dbg_phy_rdlvl[1:0]    = rdlvl_start[1:0];
  assign dbg_phy_rdlvl[2]      = found_edge_r;
  assign dbg_phy_rdlvl[3]      = pat_data_match_r;
  assign dbg_phy_rdlvl[6:4]    = cal2_state_r[2:0];
  assign dbg_phy_rdlvl[8:7]    = cal2_cnt_bitslip_r[1:0];
  assign dbg_phy_rdlvl[13:9]   = cal1_state_r[4:0];
  assign dbg_phy_rdlvl[20:14]  = {1'b0, cnt_idel_dec_cpt_r};
  assign dbg_phy_rdlvl[21]     = found_first_edge_r;
  assign dbg_phy_rdlvl[22]     = found_second_edge_r;
  assign dbg_phy_rdlvl[23]     = old_sr_valid_r;
  assign dbg_phy_rdlvl[24]     = store_sr_r;
  assign dbg_phy_rdlvl[32:25]  = {sr_fall1_r[0][1:0], sr_rise1_r[0][1:0],
                                  sr_fall0_r[0][1:0], sr_rise0_r[0][1:0]};
  assign dbg_phy_rdlvl[40:33]  = {old_sr_fall1_r[0][1:0],
                                  old_sr_rise1_r[0][1:0],
                                  old_sr_fall0_r[0][1:0],
                                  old_sr_rise0_r[0][1:0]};
  assign dbg_phy_rdlvl[41]     = sr_valid_r;
  assign dbg_phy_rdlvl[42]     = found_stable_eye_r;
  assign dbg_phy_rdlvl[47:43]  = idel_tap_cnt_cpt_r;
  assign dbg_phy_rdlvl[48]     = idel_tap_limit_cpt_r;
  assign dbg_phy_rdlvl[53:49]  = first_edge_taps_r;
  assign dbg_phy_rdlvl[58:54]  = second_edge_taps_r;
  assign dbg_phy_rdlvl[64:59]  = tby4_r;
  assign dbg_phy_rdlvl[67:65]  = cnt_eye_size_r;
  assign dbg_phy_rdlvl[72:68]  = cal1_dq_tap_cnt_r;
  assign dbg_phy_rdlvl[73]     = found_dq_edge_r;
  assign dbg_phy_rdlvl[74]     = found_edge_valid_r;
  assign dbg_phy_rdlvl[78:75]  = cal1_cnt_cpt_r;
  assign dbg_phy_rdlvl[82:79]  = cal2_cnt_rden_r;
  assign dbg_phy_rdlvl[83]     = cal1_dlyce_cpt_r;
  assign dbg_phy_rdlvl[84]     = cal1_dlyinc_cpt_r;
  assign dbg_phy_rdlvl[85]     = found_edge_r;
  assign dbg_phy_rdlvl[86]     = found_first_edge_r;
  assign dbg_phy_rdlvl[91:87]   = right_edge_taps_r;
  assign dbg_phy_rdlvl[96:92]   = second_edge_dq_taps_r;
  assign dbg_phy_rdlvl[102:97]  = tby4_r;
  assign dbg_phy_rdlvl[103]     = cal_clkdiv_clkdiv_inv_r;
  assign dbg_phy_rdlvl[104]     = cal_clkdiv_dlyce_rsync_r;
  assign dbg_phy_rdlvl[105]     = cal_clkdiv_dlyinc_rsync_r;
  assign dbg_phy_rdlvl[106]     = cal_clkdiv_idel_rsync_inc_r;
  assign dbg_phy_rdlvl[107]     = pol_min_rsync_marg_r;
  assign dbg_phy_rdlvl[111:108] = cal_clkdiv_state_r;
  assign dbg_phy_rdlvl[115:112] = cal_clkdiv_cnt_clkdiv_r;
  assign dbg_phy_rdlvl[120:116] = idel_tap_delta_rsync_r;
  assign dbg_phy_rdlvl[125:121] = min_rsync_marg_r;
  assign dbg_phy_rdlvl[134:126] = clkdiv_inv_r;
  assign dbg_phy_rdlvl[135]     = rdlvl_clkdiv_start;
  assign dbg_phy_rdlvl[136]     = rdlvl_clkdiv_done;
  assign dbg_phy_rdlvl[255:137] = 'b0;

  //***************************************************************************
  // Debug output
  //***************************************************************************

  // Record first and second edges found during CPT calibration
  generate
    genvar ce_i;
    for (ce_i = 0; ce_i < DQS_WIDTH; ce_i = ce_i + 1) begin: gen_dbg_cpt_edge
      assign dbg_cpt_first_edge_cnt[(5*ce_i)+4:(5*ce_i)]
               = dbg_cpt_first_edge_taps[ce_i];
      assign dbg_cpt_second_edge_cnt[(5*ce_i)+4:(5*ce_i)]
               = dbg_cpt_second_edge_taps[ce_i];
      always @(posedge clk)
        if (rst) begin
          dbg_cpt_first_edge_taps[ce_i]  <= #TCQ 'b0;
          dbg_cpt_second_edge_taps[ce_i] <= #TCQ 'b0;
        end else begin
          // Record tap counts of first and second edge edges during
          // CPT calibration for each DQS group. If neither edge has
          // been found, then those taps will remain 0
          if ((cal1_state_r == CAL1_CALC_IDEL) ||
              (cal1_state_r == CAL1_RST_CPT)) begin
            if (found_first_edge_r && (cal1_cnt_cpt_r == ce_i))
              dbg_cpt_first_edge_taps[ce_i]
                <= #TCQ first_edge_taps_r;
            if (found_second_edge_r && (cal1_cnt_cpt_r == ce_i))
              dbg_cpt_second_edge_taps[ce_i]
                <= #TCQ second_edge_taps_r;
          end
        end
    end
  endgenerate

 always @(posedge clk) begin
    dbg_rd_active_dly <= #TCQ cal2_rd_active_dly_r;
    dbg_rd_clkdly_cnt <= #TCQ cal2_clkdly_cnt_r;
  end

  // cal2_rd_bitslip_cnt_r is only 2*DQS_WIDTH (2 bits per DQS group), but
  // is expanded to 3 bits per DQS group to maintain width compatibility with
  // previous definition of dbg_rd_bitslip_cnt (not a huge issue, should
  // align these eventually - minimize impact on debug designs)
  generate
    genvar d_i;
    for (d_i = 0; d_i < DQS_WIDTH; d_i = d_i + 1) begin: gen_dbg_rd_bitslip
      always @(posedge clk) begin
        dbg_rd_bitslip_cnt[3*d_i+:2] <= #TCQ cal2_rd_bitslip_cnt_r[2*d_i+:2];
        dbg_rd_bitslip_cnt[3*d_i+2]  <= #TCQ 1'b0;
      end
    end
  endgenerate

  //***************************************************************************
  // Data mux to route appropriate bit to calibration logic - i.e. calibration
  // is done sequentially, one bit (or DQS group) at a time
  //***************************************************************************

  always @(posedge clk) begin
    (* full_case, parallel_case *) case ({rdlvl_clkdiv_done, rdlvl_done[0]})
      2'b00: rd_mux_sel_r <= #TCQ cal1_cnt_cpt_r;
      2'b01: rd_mux_sel_r <= #TCQ cal_clkdiv_cnt_clkdiv_r;
      2'b10: rd_mux_sel_r <= #TCQ cal2_cnt_rden_r;   // don't care
      2'b11: rd_mux_sel_r <= #TCQ cal2_cnt_rden_r;
    endcase
  end

  // Register outputs for improved timing.
  // NOTE: Will need to change when per-bit DQ deskew is supported.
  //       Currenly all bits in DQS group are checked in aggregate
  generate
    genvar mux_i;
    for (mux_i = 0; mux_i < DRAM_WIDTH; mux_i = mux_i + 1) begin: gen_mux_rd
      always @(posedge clk) begin
        mux_rd_rise0_r[mux_i] <= #TCQ rd_data_rise0[DRAM_WIDTH*rd_mux_sel_r +
                                                    mux_i];
        mux_rd_fall0_r[mux_i] <= #TCQ rd_data_fall0[DRAM_WIDTH*rd_mux_sel_r +
                                                    mux_i];
        mux_rd_rise1_r[mux_i] <= #TCQ rd_data_rise1[DRAM_WIDTH*rd_mux_sel_r +
                                                    mux_i];
        mux_rd_fall1_r[mux_i] <= #TCQ rd_data_fall1[DRAM_WIDTH*rd_mux_sel_r +
                                                    mux_i];
      end
    end
  endgenerate

  //***************************************************************************
  // Demultiplexor to control IODELAY tap values
  //***************************************************************************

  // Capture clock
  always @(posedge clk) begin
    dlyce_cpt  <= #TCQ 'b0;
    dlyinc_cpt <= #TCQ 'b0;
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
