bespoke-silicon-group/bsg_motherboards/(commit log)

2018-03-11 added pcb related docs for super trouble
    [BOM.csv, SuperTrouble2017.pcb, SuperTrouble2017.sch, comp_map.csv]
2018-03-12 added firmware files for celerity, not tested
    [BOM.csv, comp_map.csv]
2018-03-26 add all real trouble related files
    [BOM.csv, Number of Parts.csv, RealTrouble_2016.pcb]
2018-03-26 docs for double trouble added
    [BOM.csv, DaughterBoards_2016.pcb, DaughterBoards_2016.sch, comp_map.csv]
2018-03-27 modify frequency, solve bug
    [bsg_gateway_clk.v]
2018-03-27 solve the swizzle problem
    [bsg_gateway.v]
2018-05-05 real trouble BOM updated based on current Digikey stock
    [BOM Real Trouble.csv, BOM.csv, Number of Parts.csv]
2018-05-05 added REAMDE for real trouble PCB
2018-08-30 fix bugs and update 1.8v cells
2018-09-21 added super trouble v2 firmare
    [BOM.csv, SuperTrouble2017.pcb, SuperTrouble2017.sch, comp_map.csv]
2018-09-21 super trouble v2 and outerspace docs added
    [BOM.csv, SuperTrouble2017.pcb, SuperTrouble2017.sch, SuperTrouble2017_rev.pcb, SuperTrouble2017_rev.sch, comp_map.csv]
2019-01-22 added PCB ascii export files
2019-01-22 added super trouble v1 PCB ascii file
2019-04-09 add baseline wormhole test program, running correctly
    [bsg_asic.v, bsg_asic_clk.v, bsg_gateway.v, bsg_gateway_clk.v, bsg_iddr_phy.v, bsg_link_ddr.v]
2020-04-22 fix bug in xdc constraint
    [design_1.xdc]
2020-05-15 fixing output delay constraints
    [bsg_link_oddr_phy.v, design_1.xdc]
2020-05-24 fix bug inside manycore_link_to_axil
    [design_1_wrapper.v]
2020-06-19 add t_rex v1 docs
    [BOM_20200303.csv, IMPEDANCE.xlsx, comp_map.csv, t_rex_v1.2.sch]
2020-08-04 Move common pcb development scripts to util directory
2021-07-13 pcb design export txt
2023-02-20 add bsg tag trace to py script
2023-02-20 update bp reset procedures
    [bp_tapeout_rc0_util.py]
2023-02-20 update bp tag trace properties
2023-02-20 set bp to 0.8v during boot up
2023-02-21 bp software bug fix
    [bp_tapeout_rc0_util.py]
